glgauthier/MQP/report/figures/oScope/i2c_0x07/externalTrigger/readme.txt

Note that CH1 is the trigger and CH2 is FV
PCLK IS ALWAYS ACTIVE regardless of whether or not the camera is putting out data. this means we can use it for a fifo clock!
