glgauthier/MQP/report/MQP_Paper.tex

\documentclass[12pt]{article}
\usepackage[utf8]{inputenc}
\usepackage[paper=letterpaper,margin=1.25in]{geometry}
\usepackage{graphicx} 
\graphicspath{ {figures/} } % all figures are in the 'figures' folder
\usepackage{float}
\usepackage{subcaption}
\usepackage{indentfirst}
\usepackage{setspace}
\usepackage{amsmath}
\usepackage{url}
\usepackage{array}
\usepackage{listings}

\lstloadaspects{keywordcomments}

\newcolumntype{L}[1]{>{\raggedright\let\newline\\\arraybackslash\hspace{0pt}}m{#1}}
% Fix backwards double quotes
\usepackage [autostyle, english = american]{csquotes}
\MakeOuterQuote{"}
% set up clickable links in ToC
\usepackage[hidelinks]{hyperref} % to turn off hilights
\hypersetup{linktocpage, colorlinks=false, linktoc=all}

% add in dots for sections in ToC
\usepackage[titles]{tocloft}
\renewcommand\cftsecleader{\cftdotfill{\cftdotsep}}

% include subsections, etc.. in table of contents
\setcounter{tocdepth}{4}
\setcounter{secnumdepth}{4}
\usepackage[usenames,dvipsnames,svgnames,table]{xcolor}

%% CODE SNIPPET CONFIGURATION %%
\usepackage{listings}

% verilog code snippet configuration
\lstdefinestyle{Verilog}{
	language=Verilog,
	frame=single,
	breaklines=true,
	basicstyle=\ttfamily\scriptsize, %font and size
	numbers=left,
	numberstyle=\tiny\color{black},
	keywordstyle=\color{Blue}\ttfamily,
    commentstyle=\color{Green}\ttfamily,
    emph = [1]{`timescale},
    emphstyle = [1]{\color{Magenta}},
    emph = [2]{BUFG,ODDR2},
    emphstyle = [2]{\color{Maroon}},
	} 

% vhdl config	
\lstdefinestyle{VHDL}{
	language=VHDL,
	frame=single,
	breaklines=true,
	basicstyle=\ttfamily\scriptsize, %font and size
	numbers=left,
	numberstyle=\tiny\color{black},
	keywordstyle=\color{Blue}\ttfamily,
    	commentstyle=\color{Green}\ttfamily,
	} 
		
% Matlab code snippet configuration
\definecolor{mygreen}{rgb}{0.11,0.67,0} % color values Red, Green, Blue
\definecolor{mylilas}{rgb}{0.67,0.22,0.95}
\lstdefinestyle{Matlab}{
   language=Matlab,
   frame=single,
   breaklines=true,
   keywords={break,case,catch,continue,else,elseif,end,for,function,
      global,if,otherwise,persistent,return,switch,try,while},
   basicstyle=\ttfamily\scriptsize, %font and size
   keywordstyle=\color{blue},
   commentstyle=\color{mygreen},
   stringstyle=\color{mylilas},
   emph = [1]{all},
   emphstyle = [1]{\color{mylilas}},
   numbers=left,
   numberstyle=\tiny\color{black},
   stepnumber=1,
   numbersep=10pt,
   backgroundcolor=\color{white},
   tabsize=4,
   showspaces=false,
   showstringspaces=false
}  
% C code 
\definecolor{Cpurp}{rgb}{0.5,0,0.38}
\definecolor{Cgreen}{rgb}{0.47,0.70,0.53}
\lstdefinestyle{C}{
   language=C,
   frame=single,
   breaklines=true,
   basicstyle=\ttfamily\scriptsize, %font and size
   keywordstyle=\color{Cpurp},
   emph = [1]{u8, u16, u32, XIOModule},
   emphstyle = [1]{\color{Cgreen}},
   commentstyle=\color{Green},
   stringstyle=\color{blue},
   numbers=left,
   numberstyle=\tiny\color{black},
   stepnumber=1,
   numbersep=10pt,
   backgroundcolor=\color{white},
   tabsize=4,
   showspaces=false,
   showstringspaces=false
} 

% COE code
\lstdefinestyle{coe}{
	language=C,
	frame=single,
	breaklines=true,
	basicstyle=\ttfamily\footnotesize, %font and size
	numbers=left,
	numberstyle=\tiny\color{black}\ttfamily,
	comment=[s]{;}{.},
	commentstyle=\color{Green}\ttfamily,
	emph = [1]{memory_initialization_radix, memory_initialization_vector},
	emphstyle = [1]{\color{Maroon}}
	} 

\begin{document}

\pagenumbering{gobble} % turn off page numbering for the first few pages

\input{titlepage.tex} %%%% Title page %%%%
\newpage

\newgeometry{top=1in,bottom=1in,right=1in,left=1in} % change margins, set to double space
\doublespacing

\tableofcontents % create a table of contents
\newpage

\begin{small} % make the font smaller to accommodate for long figure names
\listoffigures % create a list of figures
\end{small}
\newpage 

\pagenumbering{roman} % change page numbering to i,ii, ...

%\input{ack.tex} %%%% Acknowledgements %%%%
%\newpage

\input{abstract.tex} %%%% Abstract %%%%
\newpage
\input{execSummary.tex} %%%% Executive summary %%%%
\newpage
\pagenumbering{arabic} % change page numbering to 1,2, ...

\input{introduction.tex} %%%% Introduction %%%%

\newpage
\input{background.tex} %%%% Background %%%%

\newpage
\section{System Design}
\input{systemDesign.tex}

\newpage
\section{System Implementation}
After deciding that the proof of concept sensor suite required a scanning laser rangefinder, IMU, and stereo camera interface, research was then performed in order to determine what specific sensors to use, as well as the operating modes of each chosen sensor. This chapter describes the specific research performed for each sensor, as well as the theoretical implementation of the overall system.

\input{rangefinder_operation.tex}
\input{rangefinder_implementation.tex}
\input{rangefinder_data_processing.tex}

\input{pspl_communication.tex}

\input{imu_operation.tex}
\input{imu_implementation.tex}
\input{imu_data_processing.tex}

\input{camera_operation.tex}
\input{disparity_implementation.tex}
\input{combined_imp.tex}

\par
In this chapter, the behavior of each sensor was explored in depth, and an overall system designed was created. Once this design was completed, each sensor's behavior was thoroughly tested before integration.

\newpage 
\section{Testing and Results}
After learning how to interface with the chosen sensors, initial test implementations were then created for each individual sensor. Many of these implementations were designed for ease of integration into the finalized design, as detailed in the following sections.

\input{rangefinder_testing.tex}
\input{imu_testing.tex}
\input{camera_implementation.tex}
\input{disparity_testing.tex}
%rangefinder and IMU stuff 
% then combined imp after?
\input{final_results.tex}

\par
In this chapter, the functionality of each sensor was tested so that the design accurately reflected their behavior. Once each sensor's behavior was properly accounted for, their implementations were combined to create a functional SLAM sensor suite incorporating multiple operating modes.

\newpage 
\section{Conclusions}
\input{conclusion.tex}

\newpage
\singlespacing
\input{bib_ordered.tex} %%%% Bibliography %%%%
\doublespacing
\newpage

\section*{Appendix} %%%% Appendix %%%% 
\addcontentsline{toc}{section}{Appendix}
\setcounter{subsection}{0}
\renewcommand\thesubsection{\Alph{subsection}}
\renewcommand\thesubsubsection{\thesubsection.\roman{subsubsection}}
%\input{appendix/resources.tex} % useful resources
\input{appendix/componentSelection.tex} % component selection
%\input{appendix/camDecisionMatrix.tex} % camera module decision matrix
\input{appendix/camControlReg.tex}
\newpage
\input{appendix/stereoCameraSchematic.tex}
\newpage
% maybe redo this so we have a section called "code" and
% subsections for individual projects?
\input{appendix/code.tex}
%\input{appendix/matlabCode.tex}
%\newpage
%\input{appendix/verilogCode.tex}
%\newpage
%\input{appendix/cCode.tex}
%\newpage
%\input{appendix/coeCode.tex}

%\newpage
%\input{appendix/examples.tex} % example latex code for setting things up

\end{document}
