glgauthier/MQP/report/titlepage.tex

\begin{titlepage}
	\centering
	%{\huge\bfseries Real-Time Remote Mapping\par}
	{\huge\bfseries FPGA-Based Real-Time SLAM\par}
	\vfill
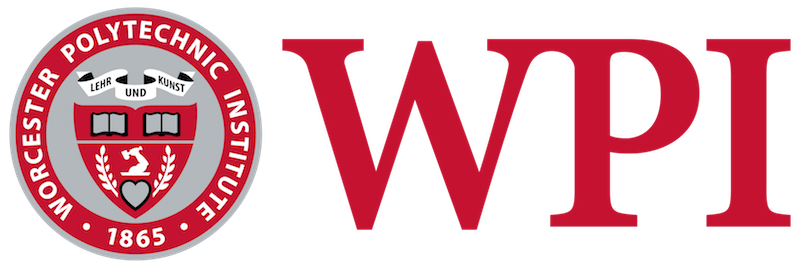
[picture p20: report/figures/WPI_Inst_Prim_FulClr.png]
	 % also works with logo.pdf
	\vfill
	{\par\large A Major Qualifying Project Report Submitted to the Faculty of \par}
	\vspace{0.25cm}
	{\large Worcester Polytechnic Institute\par}
	\vfill
	{\large In partial fulfillment of the requirements for the \par}
	\vspace{0.25cm}
	{\large Degree of Bachelor of Science in Electrical \& Computer Engineering\par}
	\vfill
	{\large By: \par}
	\vspace{0.25cm}
	{\Large Georges Gauthier \\ John DeCusati \par} 
	\vfill
	{\large \today \par}
	\vfill
	{\begin{flushright} 
	\large Advisor: \\ \Large Professor R. James Duckworth
	\end{flushright}}
\end{titlepage}
