glgauthier/MQP/report/appendix/matlabCode.tex

\subsection{\textsc{Matlab} Code}
\subsubsection{Camera Image Parsing} \label{camTestMatlab}
\singlespacing
\lstinputlisting[style=Matlab]{appendix/matlab/ParseData.m}
\doublespacing
\subsubsection{Disparity Algorithm Implementation} \label{disparityTestMatlab}
\singlespacing
\lstinputlisting[style=Matlab]{appendix/matlab/stereoDisparity.m}
\doublespacing
