glgauthier/MQP/report/appendix/stereoCameraSchematic.tex

\subsection{Stereo Camera Schematic}\label{stereoCameraSchematic}
\begin{figure}[H]
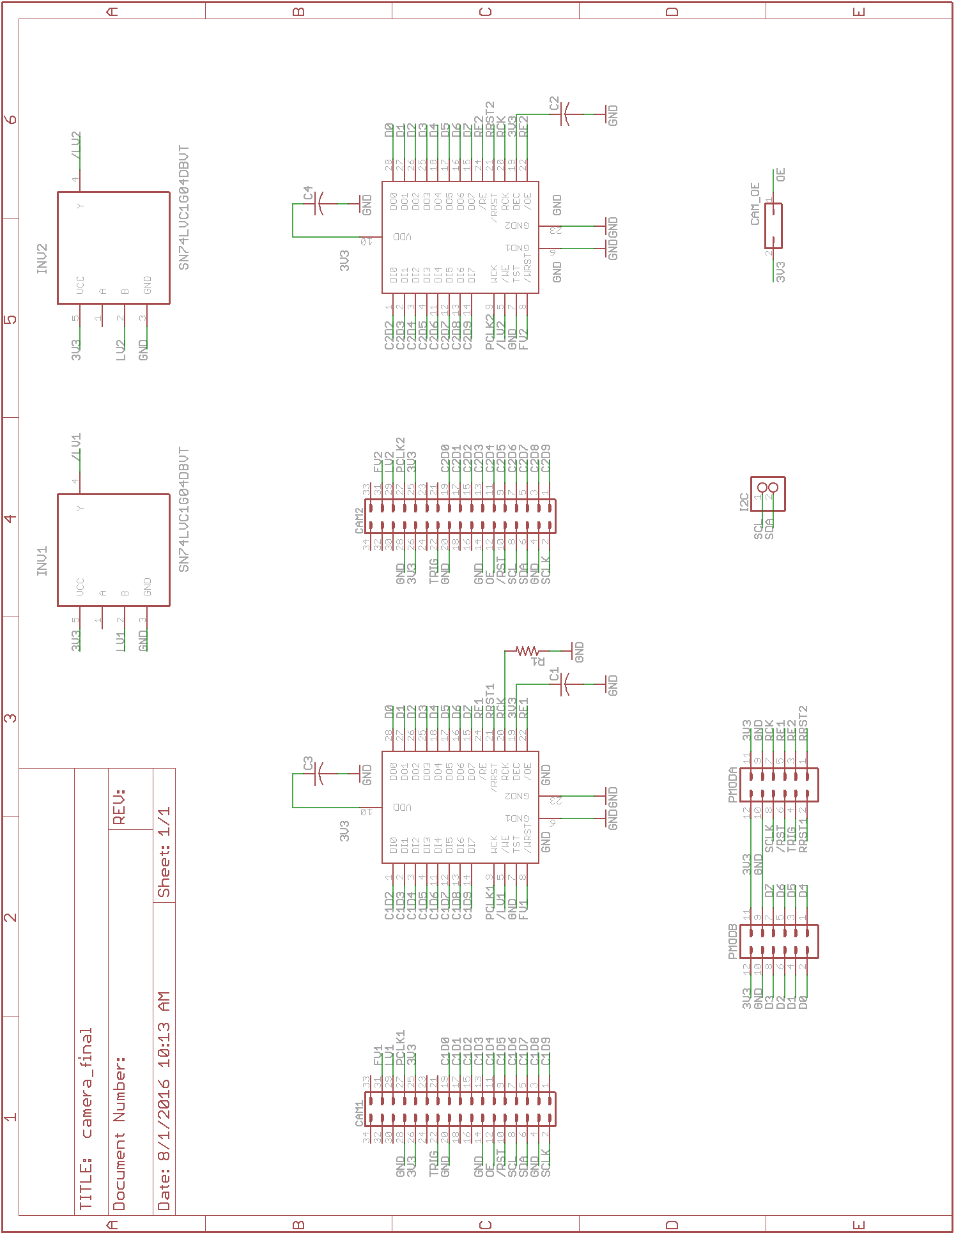
[picture p35: report/figures/stereo_schematic.png]
	\centerline{}
\end{figure}
