glgauthier/MQP/report/appendix/camControlReg.tex

\subsection{Camera Module Control Register} \label{camctlreg}
\begin{figure}[H]
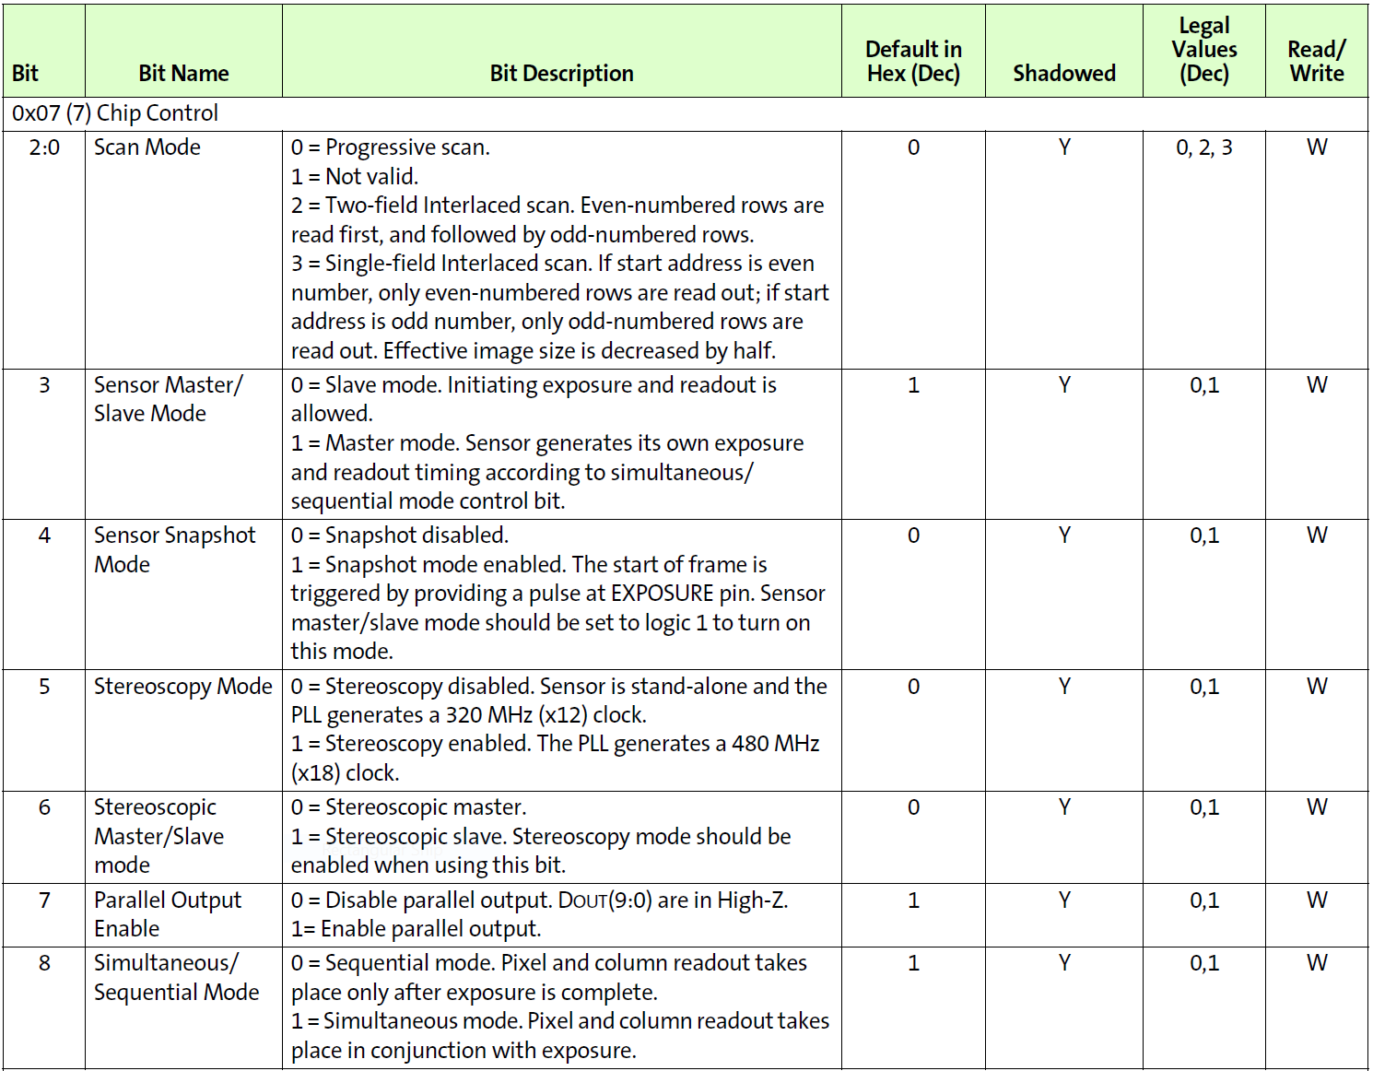
[picture p36: report/figures/CamControlReg.PNG]
	\centerline{}
	Table obtained from MT9V032 Datasheet \cite{mt9v032}
\end{figure}
