glgauthier/MQP/report/appendix/cCode.tex

\subsection{C Code}
\subsubsection{Camera Image Parsing} \label{camTestC}
\singlespacing
\lstinputlisting[style=C]{appendix/c/imageUART.c}
\doublespacing
