glgauthier/MQP/report/appendix/camDecisionMatrix.tex

\subsection{Camera Module Decision Matrix}
\singlespacing
\begin{small}
\centerline{
\begin{tabular}{ |L{2cm}|L{1.5cm}|L{2.5cm}|L{1cm}|L{1.7cm}|L{2cm}|L{1.7cm}|L{1.2cm}|L{1cm}| } 
 \hline
 \textbf{Camera Module} & \textbf{Max Frame Rate (FPS)}  & \textbf{Resolution at Max Frame Rate (px.)} & \textbf{Cost} & \textbf{Requires External Adapter} & \textbf{Data Transfer Interface} & \textbf{Shutter} & \textbf{Field of View (deg.)} & \textbf{Rank 0-10}  \\ \hline
 OV7670 & \cellcolor{red!25} 30 & \cellcolor{green!25} 640x480 & \cellcolor{green!50} \$10 & \cellcolor{green!25} No & \cellcolor{green!25} Parallel & \cellcolor{red!25} Rolling & \cellcolor{red!25}  25 & 5  \\ \hline
 Raspberry Pi Camera &\cellcolor{green!25}  90 & \cellcolor{green!25} 640x480 & \cellcolor{green!25}  \$30 & \cellcolor{red!25} Yes, \$53 & \cellcolor{red!25} MIPI (CSI2) & \cellcolor{red!25}  Rolling & \cellcolor{green!25} 49 & 6  \\  \hline
 PC1089K & \cellcolor{green!25} 60 & \cellcolor{green!25} 720x480 & \cellcolor{green!25} \$32 & \cellcolor{green!25} No & \cellcolor{red!50} NSTC/ PAL & \cellcolor{red!25} Rolling & Not Given & 5 \\ \hline 
 OV4682 & \cellcolor{green!50} 330 & \cellcolor{green!25} 640x480 & \cellcolor{red!25} \$89 & \cellcolor{red!25} Yes, \$50 & \cellcolor{red!25} MIPI & \cellcolor{red!25} Rolling & Not Given & 6 \\ \hline
 \textbf{MT9V034} & \cellcolor{green!25} \textbf{60} & \cellcolor{green!25} \textbf{750x480} & \cellcolor{red!25} \textbf{\$73} & \cellcolor{green!25} \textbf{No} & \cellcolor{green!25} \textbf{Parallel} & \cellcolor{green!50} \textbf{Global} & \cellcolor{green!25} \textbf{55} & \textbf{9} \\ \hline   
\end{tabular} }
\par
For purposes of comparison, the thermal camera module we were evaluating is also shown below.
\centerline{
\begin{tabular}{ |L{2cm}|L{1.5cm}|L{2.5cm}|L{1cm}|L{1.7cm}|L{2cm}|L{1.7cm}|L{1.2cm}|L{1cm}| } 
\hline
Flir Lepton &  \cellcolor{red!50} 9 & \cellcolor{red!50} 80x60 & \cellcolor{red!25} \$175 & \cellcolor{red!25} Yes, \$40 & \cellcolor{green!25} SPI/ MIPI & N/A & \cellcolor{green!25} 50 & 3 \\ \hline 
\end{tabular} 
}
\end{small}
\par
Shown above is our decision matrix for choosing a camera module. Fields marked in green indicate a positive ranking, while red indicates a negative ranking. Based on the individual rankings of each item's field, we gave our camera modules an overall ranking of 0-10 in the right hand column, with 10 being an extremely high ranking and 0 being an extremely low ranking.
\doublespacing
\par
Based on our decision matrix, we believe that it would be worth both our time and money to use the MT9V034 camera modules for our stereo camera interface. These camera modules are the only low-cost global shutter option we've come across, and would be ideal for taking images in a sensor suite that is susceptible to motion. The MT9V034 also uses a parallel data interface and relies on an external clock and shutter trigger, making the module ideal for interfacing with an FPGA-based stereo imaging setup.
