glgauthier/MQP/final_implemention/final_implemention.runs/design_1_synth_1/.vivado.begin.rst

<?xml version="1.0"?>
<ProcessHandle Version="1" Minor="0">
    <Process Command="vivado.bat" Owner="georges" Host="GEORGES-T460P" Pid="3864">
    </Process>
</ProcessHandle>
