glgauthier/MQP/final_implemention/final_implemention.runs/impl_1/.init_design.begin.rst

<?xml version="1.0"?>
<ProcessHandle Version="1" Minor="0">
    <Process Command=".planAhead." Owner="georges" Host="GEORGES-T460P" Pid="1500">
    </Process>
</ProcessHandle>
