glgauthier/MQP/IMU_PS/IMU_PS.runs/impl_1/.init_design.begin.rst

<?xml version="1.0"?>
<ProcessHandle Version="1" Minor="0">
    <Process Command=".planAhead." Owner="John" Host="JOHN-HP" Pid="3108">
    </Process>
</ProcessHandle>
