glgauthier/MQP/rangefinder_blocks/rangefinder_blocks.runs/design_1_synth_1/.vivado.begin.rst

<?xml version="1.0"?>
<ProcessHandle Version="1" Minor="0">
    <Process Command="vivado.bat" Owner="John" Host="JOHN-HP" Pid="4356">
    </Process>
</ProcessHandle>
