glgauthier/MQP/IMU_PS/IMU_PS.ip_user_files/sim_scripts/IMU_bd/activehdl/file_info.txt

IMU_bd.v,verilog,xil_defaultlib,../../../bd/IMU_bd/hdl/IMU_bd.v,incdir="../../../bd/IMU_bd/ipshared/xilinx.com/inout_v1_0/src"incdir="../../../ipstatic/processing_system7_bfm_v2_0/hdl"incdir="../../../../IMU_PS.srcs/sources_1/bd/IMU_bd/ipshared/xilinx.com/inout_v1_0/src"incdir="../../../ipstatic/processing_system7_bfm_v2_0/hdl"
processing_system7_bfm_v2_0_arb_wr.v,verilog,processing_system7_bfm_v2_0_5,../../../ipstatic/processing_system7_bfm_v2_0/hdl/processing_system7_bfm_v2_0_arb_wr.v,incdir="../../../bd/IMU_bd/ipshared/xilinx.com/inout_v1_0/src"incdir="../../../ipstatic/processing_system7_bfm_v2_0/hdl"incdir="../../../../IMU_PS.srcs/sources_1/bd/IMU_bd/ipshared/xilinx.com/inout_v1_0/src"incdir="../../../ipstatic/processing_system7_bfm_v2_0/hdl"
processing_system7_bfm_v2_0_arb_rd.v,verilog,processing_system7_bfm_v2_0_5,../../../ipstatic/processing_system7_bfm_v2_0/hdl/processing_system7_bfm_v2_0_arb_rd.v,incdir="../../../bd/IMU_bd/ipshared/xilinx.com/inout_v1_0/src"incdir="../../../ipstatic/processing_system7_bfm_v2_0/hdl"incdir="../../../../IMU_PS.srcs/sources_1/bd/IMU_bd/ipshared/xilinx.com/inout_v1_0/src"incdir="../../../ipstatic/processing_system7_bfm_v2_0/hdl"
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
glbl.v,Verilog,xil_defaultlib,glbl.v
