glgauthier/MQP/IMU_PS/IMU_PS.ip_user_files/sim_scripts/IMU_bd/ies/file_info.txt

IMU_bd.v,verilog,xil_defaultlib,../../../bd/IMU_bd/hdl/IMU_bd.v,incdir="$ref_dir/../../../bd/IMU_bd/ipshared/xilinx.com/inout_v1_0/src"incdir="$ref_dir/../../../ipstatic/processing_system7_bfm_v2_0/hdl"incdir="../../../../IMU_PS.srcs/sources_1/bd/IMU_bd/ipshared/xilinx.com/inout_v1_0/src"incdir="../../../ipstatic/processing_system7_bfm_v2_0/hdl"
processing_system7_bfm_v2_0_arb_wr.v,verilog,processing_system7_bfm_v2_0_5,../../../ipstatic/processing_system7_bfm_v2_0/hdl/processing_system7_bfm_v2_0_arb_wr.v,incdir="$ref_dir/../../../bd/IMU_bd/ipshared/xilinx.com/inout_v1_0/src"incdir="$ref_dir/../../../ipstatic/processing_system7_bfm_v2_0/hdl"incdir="../../../../IMU_PS.srcs/sources_1/bd/IMU_bd/ipshared/xilinx.com/inout_v1_0/src"incdir="../../../ipstatic/processing_system7_bfm_v2_0/hdl"
processing_system7_bfm_v2_0_arb_rd.v,verilog,processing_system7_bfm_v2_0_5,../../../ipstatic/processing_system7_bfm_v2_0/hdl/processing_system7_bfm_v2_0_arb_rd.v,incdir="$ref_dir/../../../bd/IMU_bd/ipshared/xilinx.com/inout_v1_0/src"incdir="$ref_dir/../../../ipstatic/processing_system7_bfm_v2_0/hdl"incdir="../../../../IMU_PS.srcs/sources_1/bd/IMU_bd/ipshared/xilinx.com/inout_v1_0/src"incdir="../../../ipstatic/processing_system7_bfm_v2_0/hdl"
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
IMU_bd_processing_system7_0_0.v,verilog,xil_defaultlib,../../../bd/IMU_bd/ip/IMU_bd_processing_system7_0_0/sim/IMU_bd_processing_system7_0_0.v,incdir="$ref_dir/../../../bd/IMU_bd/ipshared/xilinx.com/inout_v1_0/src"incdir="$ref_dir/../../../ipstatic/processing_system7_bfm_v2_0/hdl"incdir="../../../../IMU_PS.srcs/sources_1/bd/IMU_bd/ipshared/xilinx.com/inout_v1_0/src"incdir="../../../ipstatic/processing_system7_bfm_v2_0/hdl"
IMU_bd_InOut_0_0.v,verilog,xil_defaultlib,../../../bd/IMU_bd/ip/IMU_bd_InOut_0_0/sim/IMU_bd_InOut_0_0.v,incdir="$ref_dir/../../../bd/IMU_bd/ipshared/xilinx.com/inout_v1_0/src"incdir="$ref_dir/../../../ipstatic/processing_system7_bfm_v2_0/hdl"incdir="../../../../IMU_PS.srcs/sources_1/bd/IMU_bd/ipshared/xilinx.com/inout_v1_0/src"incdir="../../../ipstatic/processing_system7_bfm_v2_0/hdl"
glbl.v,Verilog,xil_defaultlib,glbl.v
