glgauthier/MQP/MATLAB/shift/shift.png

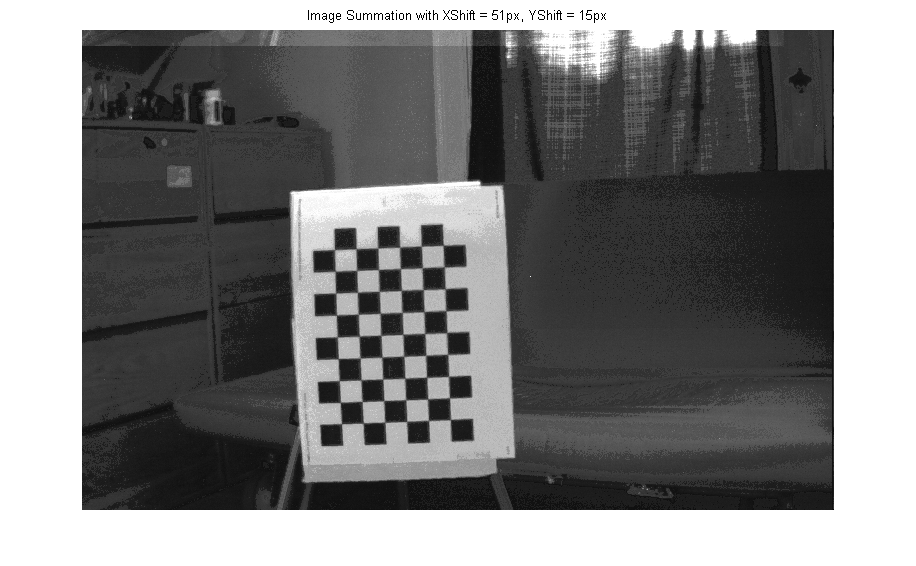
MATLAB/shift/shift.png
