glgauthier/MQP/report/figures/block_diagram.png

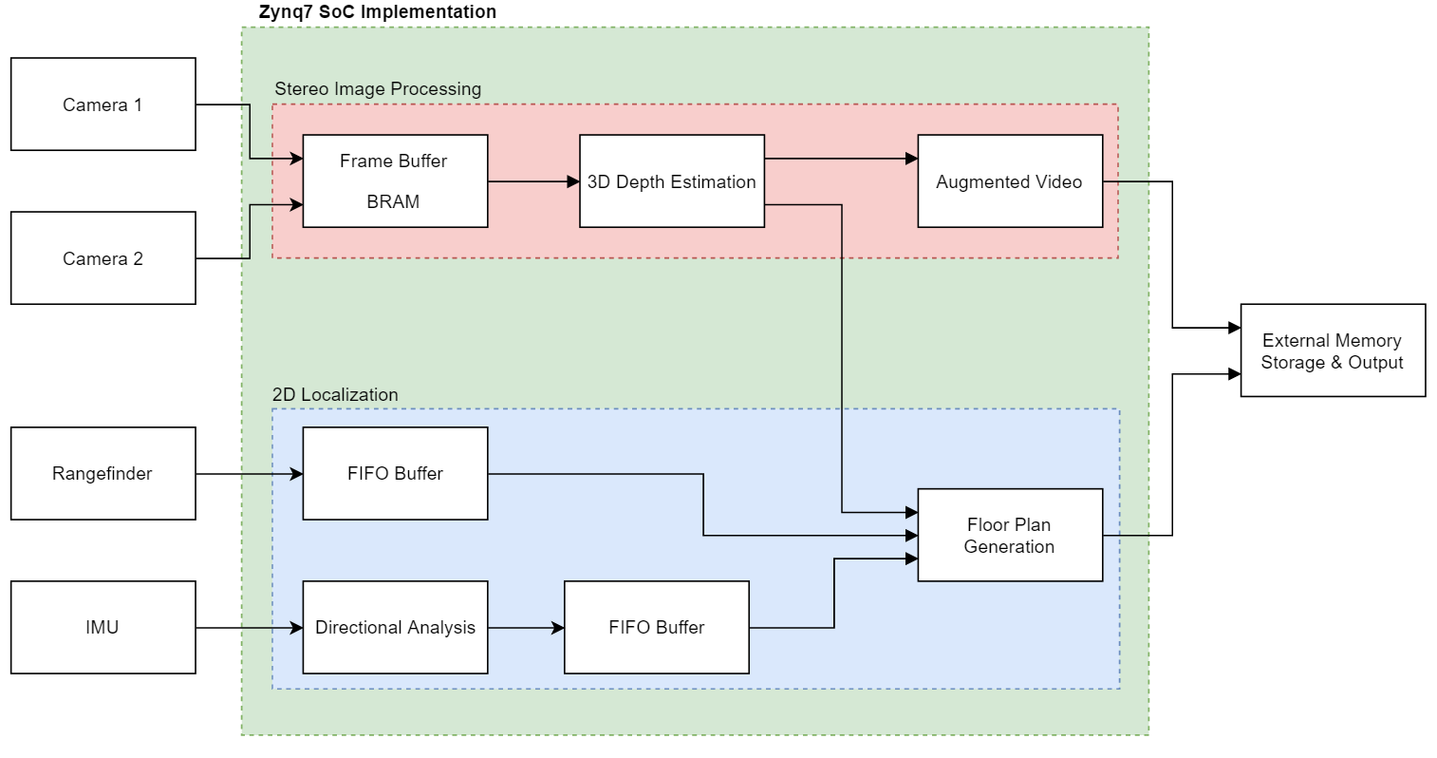
report/figures/block_diagram.png
