glgauthier/MQP/report/figures/brokenFifo/fifo1_din1.png

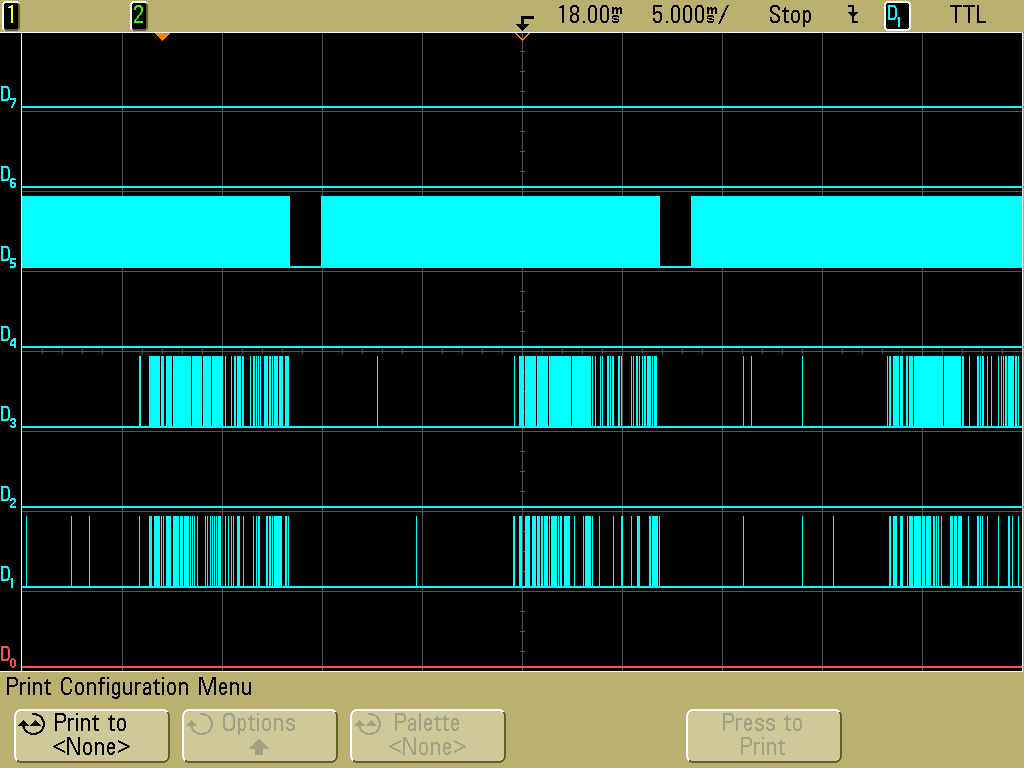
report/figures/brokenFifo/fifo1_din1.png
