glgauthier/MQP/report/figures/brokenFifo/fifo1_din.png

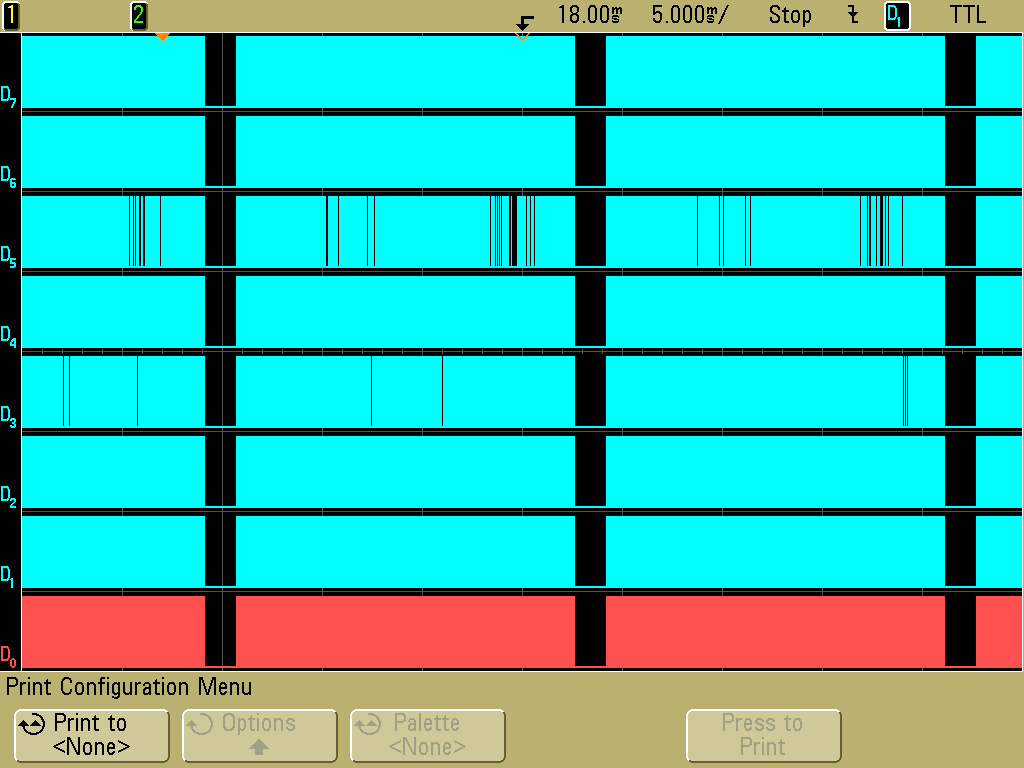
report/figures/brokenFifo/fifo1_din.png
