glgauthier/MQP/report/figures/brokenFifo/FIFO1_Dout.png

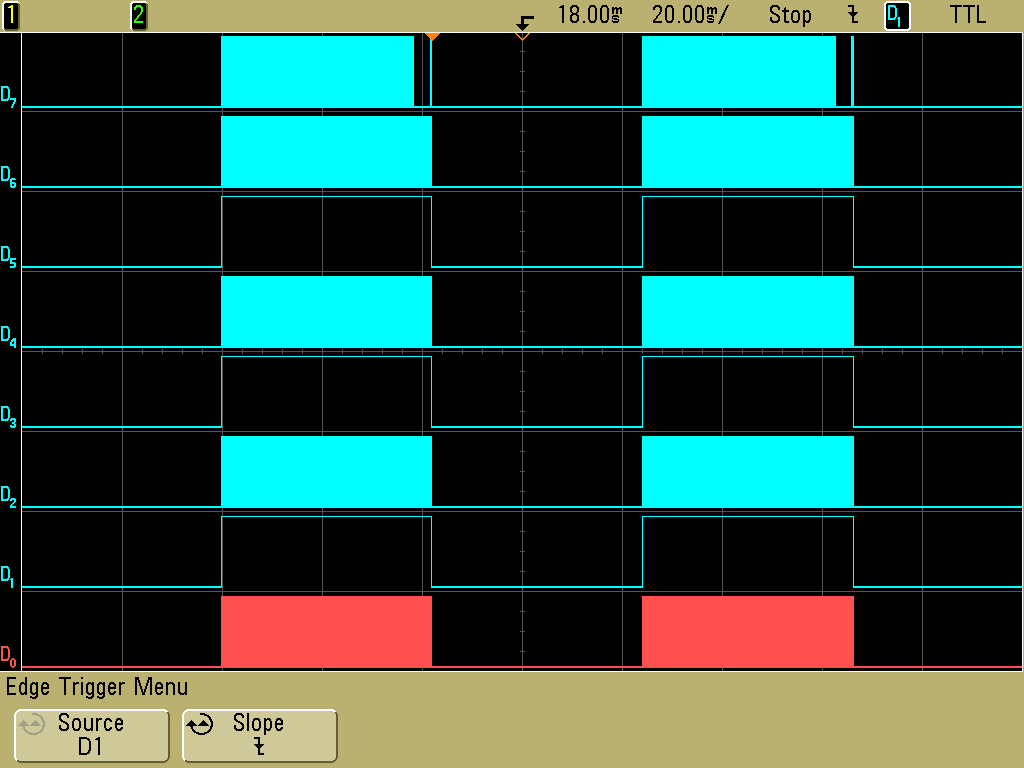
report/figures/brokenFifo/FIFO1_Dout.png
