glgauthier/MQP/report/figures/brokenFifo/FIFO2_Dout.png

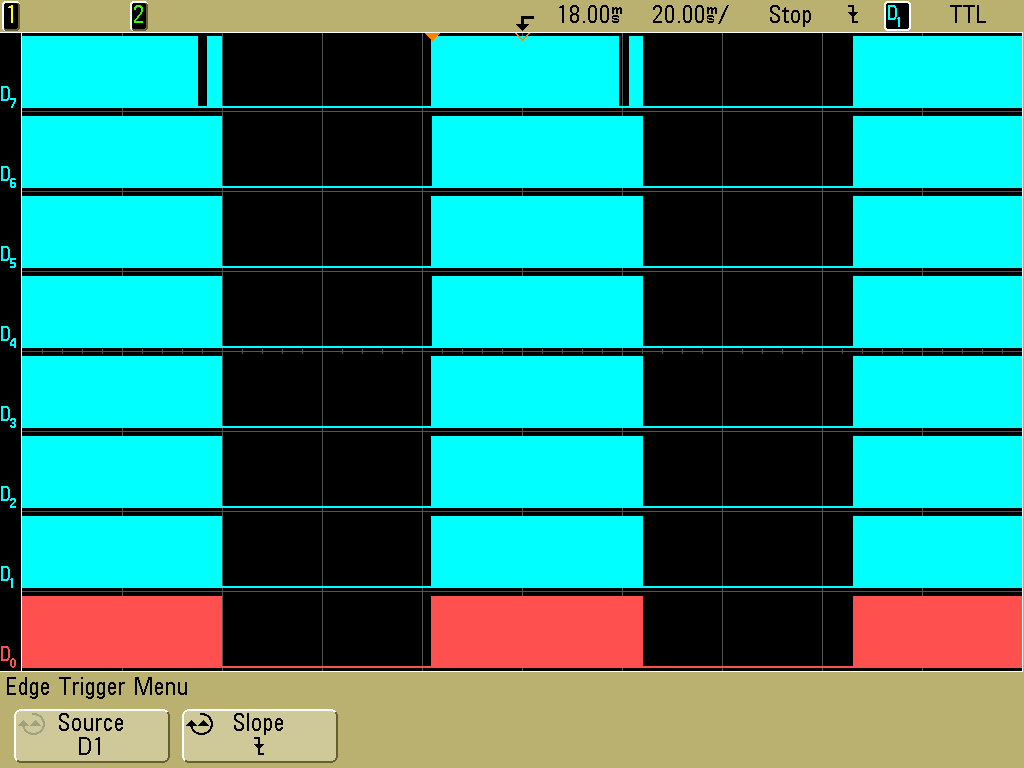
report/figures/brokenFifo/FIFO2_Dout.png
