glgauthier/MQP/report/figures/camera_data1.JPG

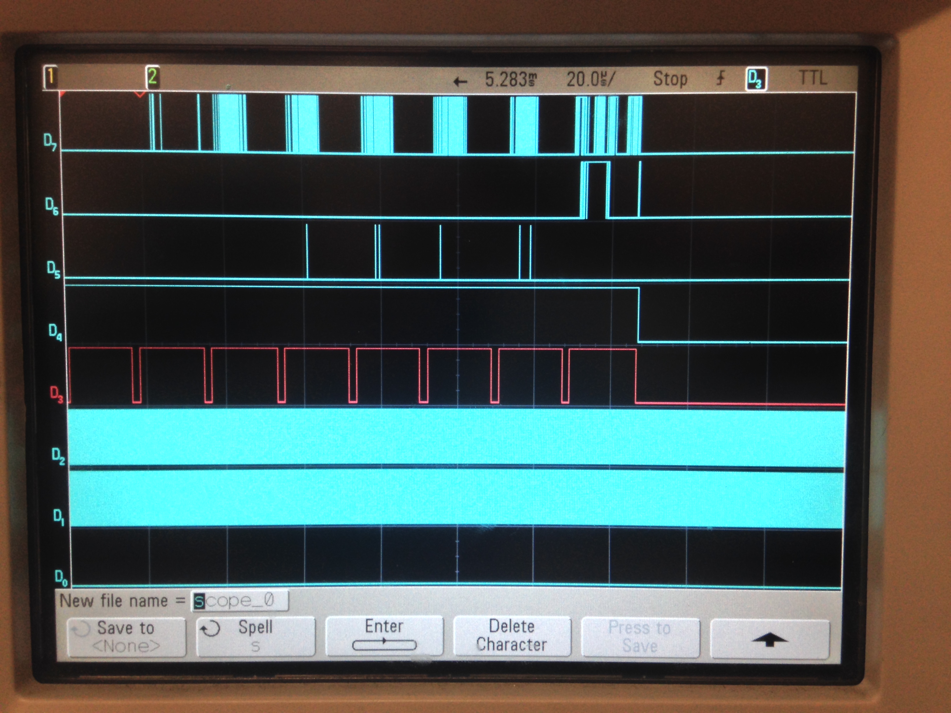
report/figures/camera_data1.JPG
