glgauthier/MQP/report/figures/camera_data.JPG

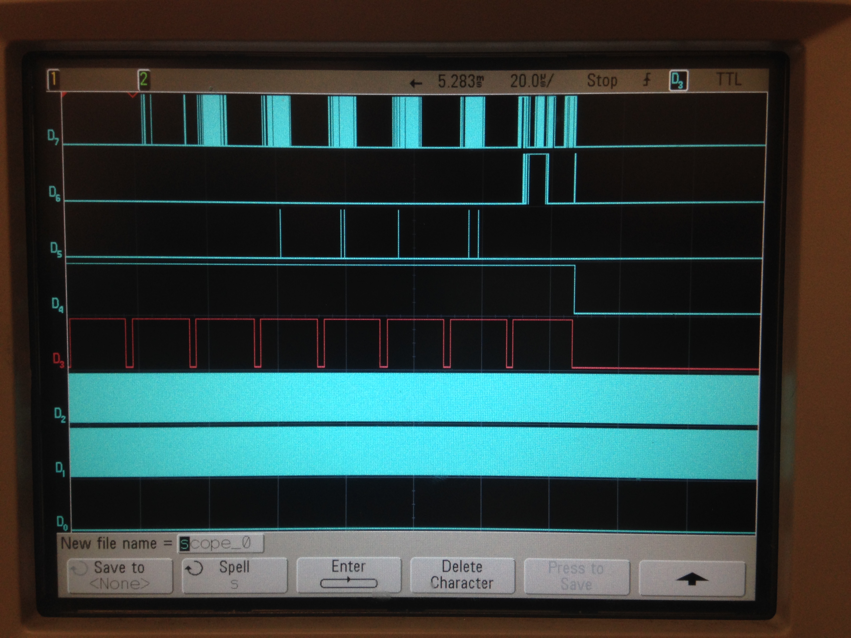
report/figures/camera_data.JPG
