glgauthier/MQP/report/figures/combined_mode.JPG

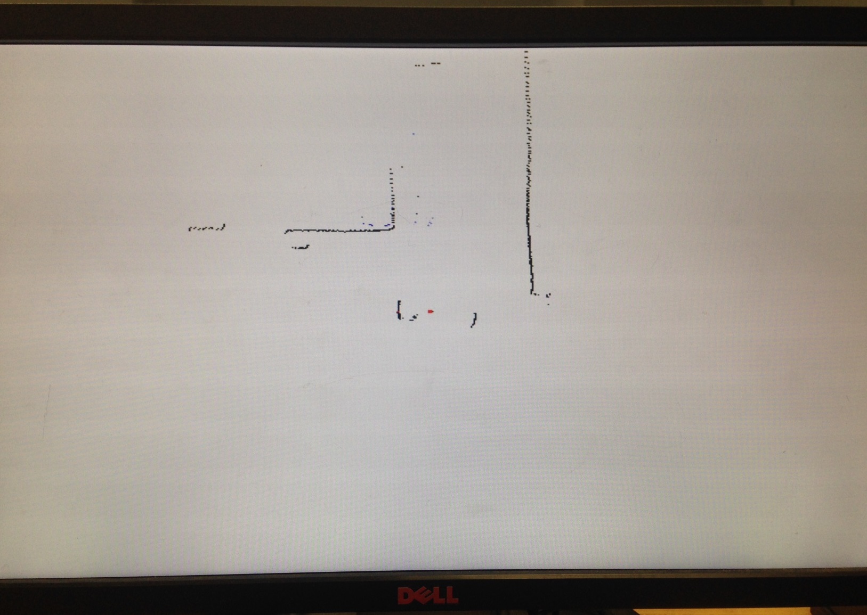
report/figures/combined_mode.JPG
