glgauthier/MQP/report/figures/disp_loading.png

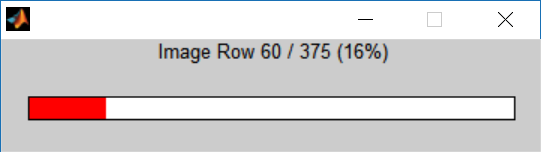
report/figures/disp_loading.png
