glgauthier/MQP/report/figures/disp_tb/croppedCones.png

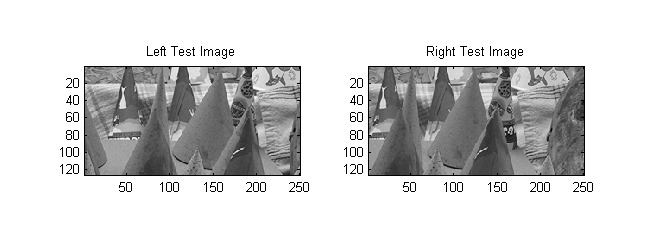
report/figures/disp_tb/croppedCones.png
