glgauthier/MQP/report/figures/disp_tb/CroppedOut.png

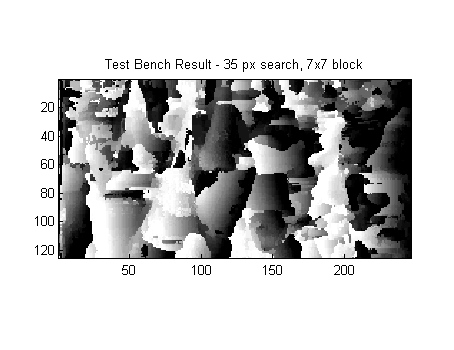
report/figures/disp_tb/CroppedOut.png
