glgauthier/MQP/report/figures/disp_tb/indexing.png

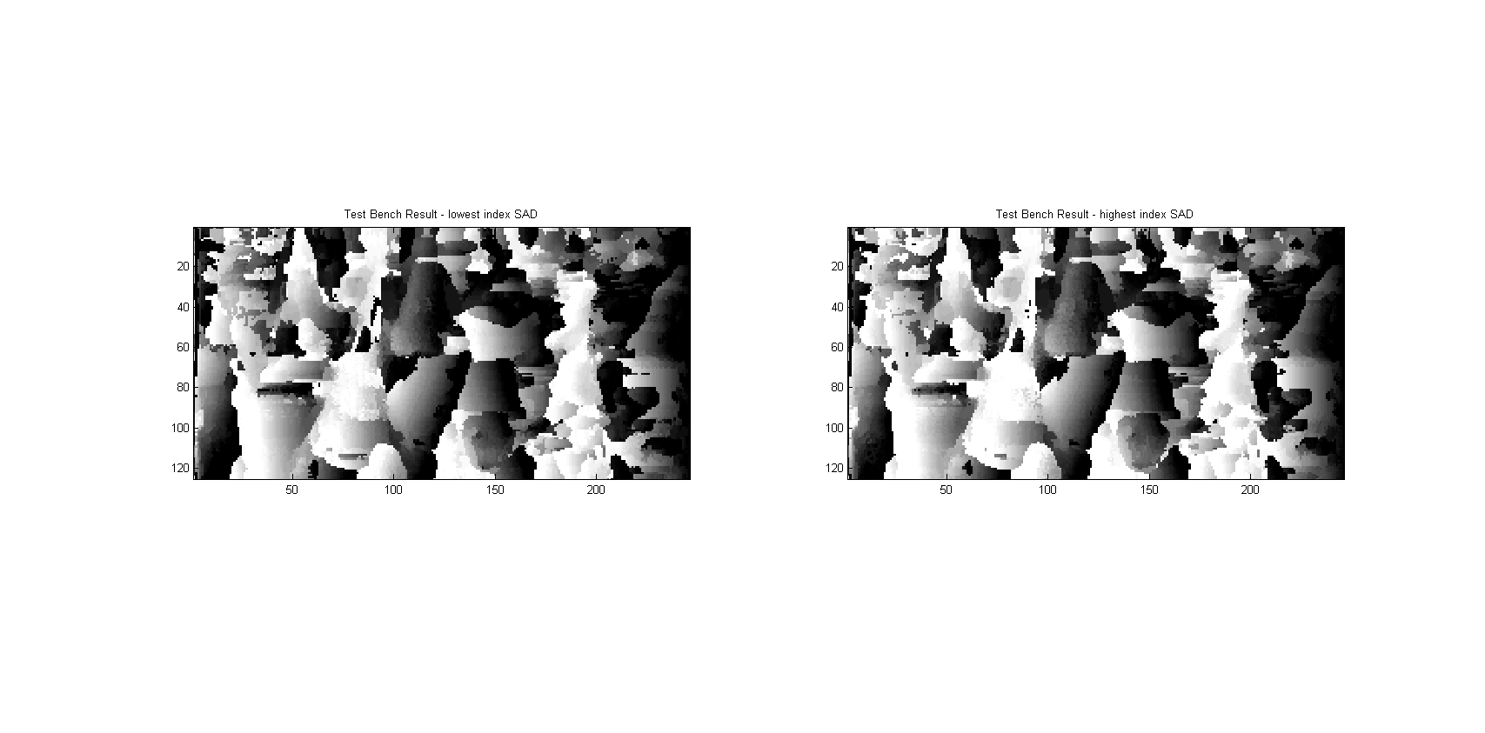
report/figures/disp_tb/indexing.png
