glgauthier/MQP/report/figures/disp_tb/MATLAB_cones2.png

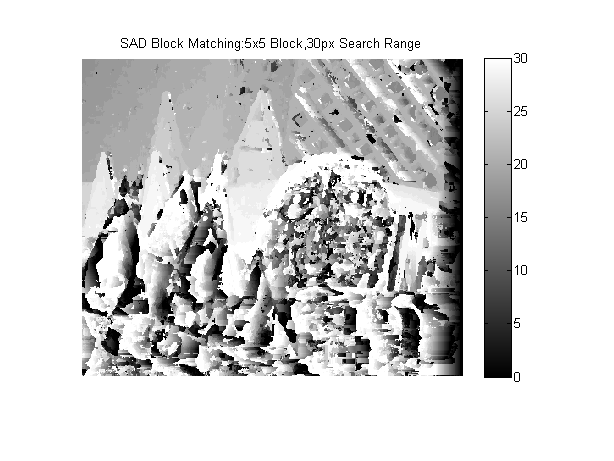
report/figures/disp_tb/MATLAB_cones2.png
