glgauthier/MQP/report/figures/disp_tb/MATLAB_cones3.png

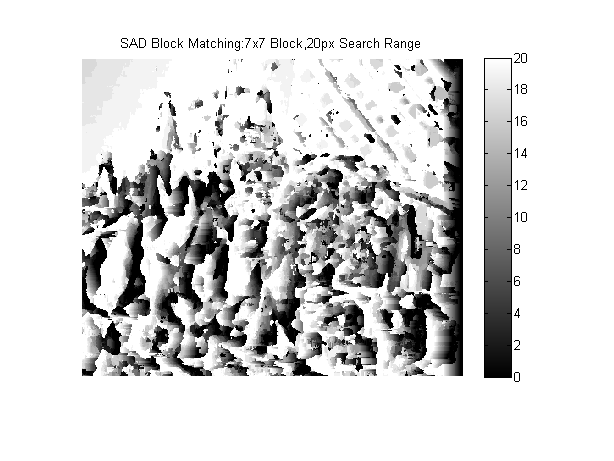
report/figures/disp_tb/MATLAB_cones3.png
