glgauthier/MQP/report/figures/disp_tb/MATLAB_cones.png

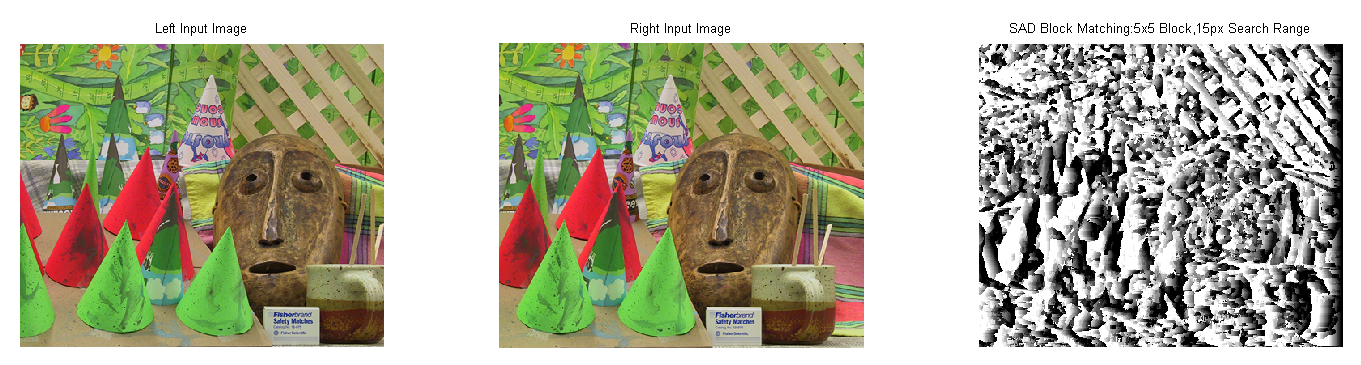
report/figures/disp_tb/MATLAB_cones.png
