glgauthier/MQP/report/figures/disp_tb/read_oneImage.PNG

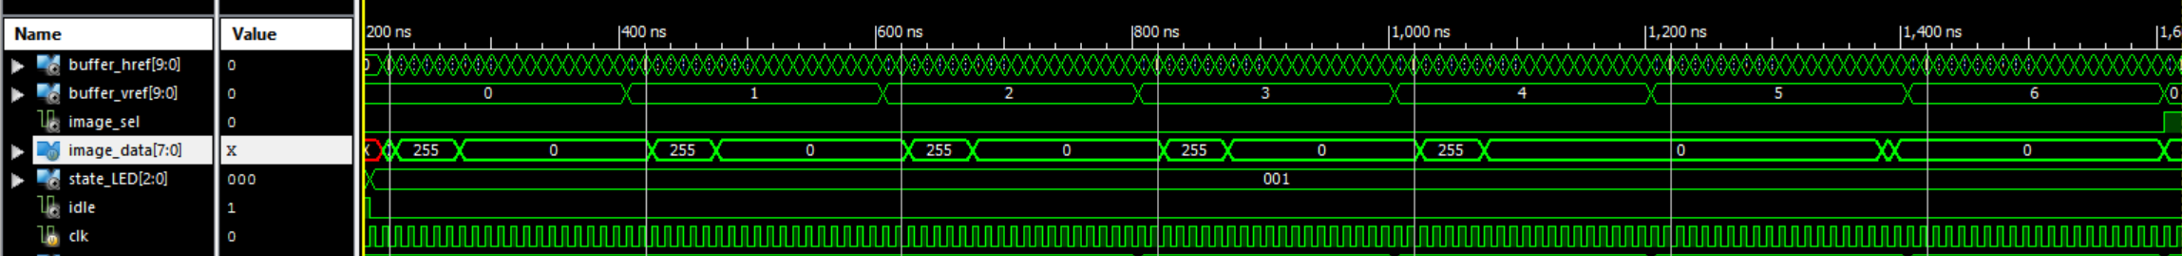
report/figures/disp_tb/read_oneImage.PNG
