glgauthier/MQP/report/figures/disp_tb/TB_cones2.png

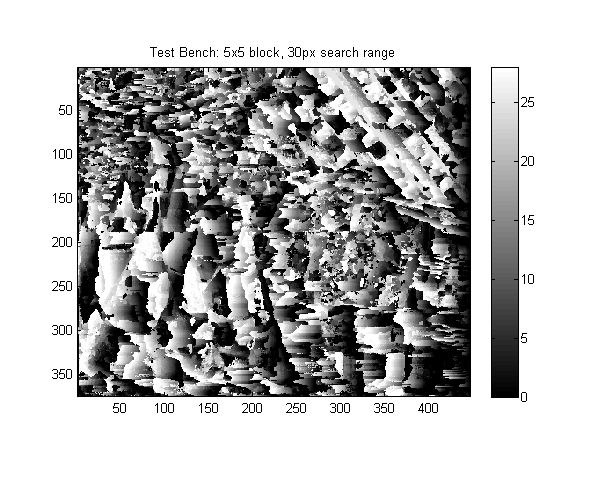
report/figures/disp_tb/TB_cones2.png
