glgauthier/MQP/report/figures/disparity_mode.JPG

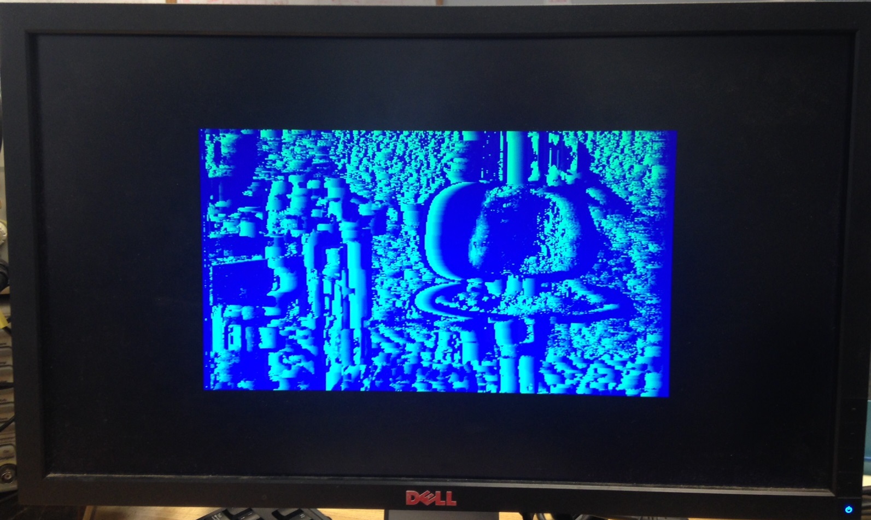
report/figures/disparity_mode.JPG
