glgauthier/MQP/report/figures/final_bd.png

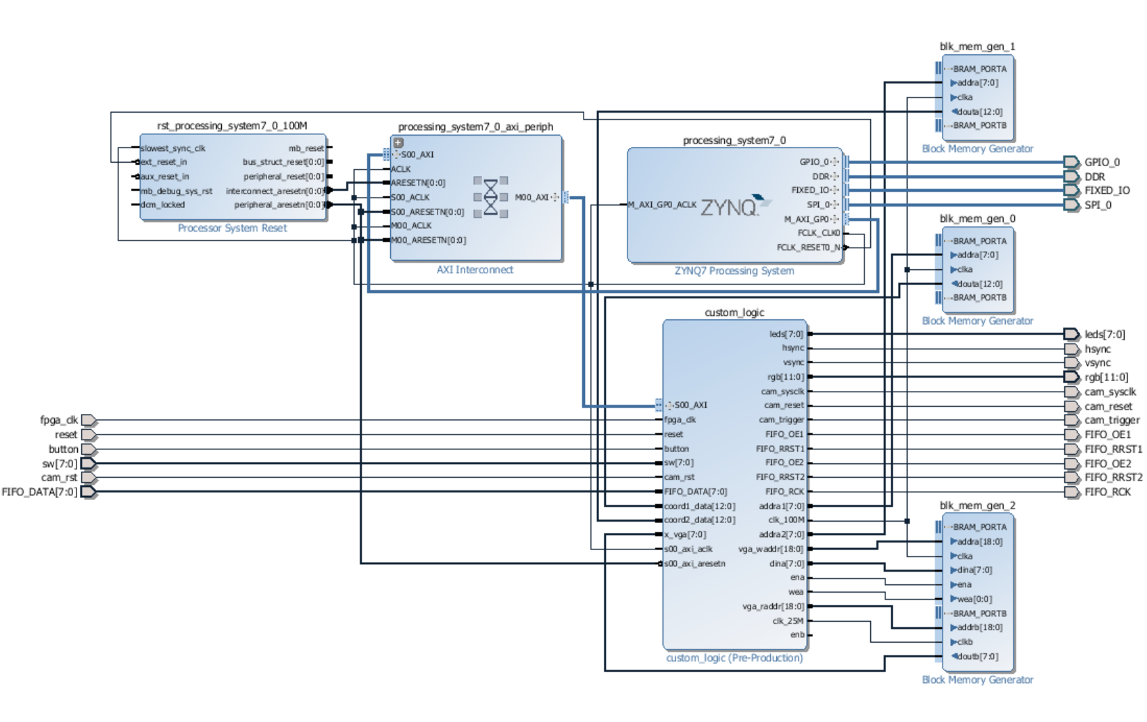
report/figures/final_bd.png
