glgauthier/MQP/report/figures/human_tracking.png

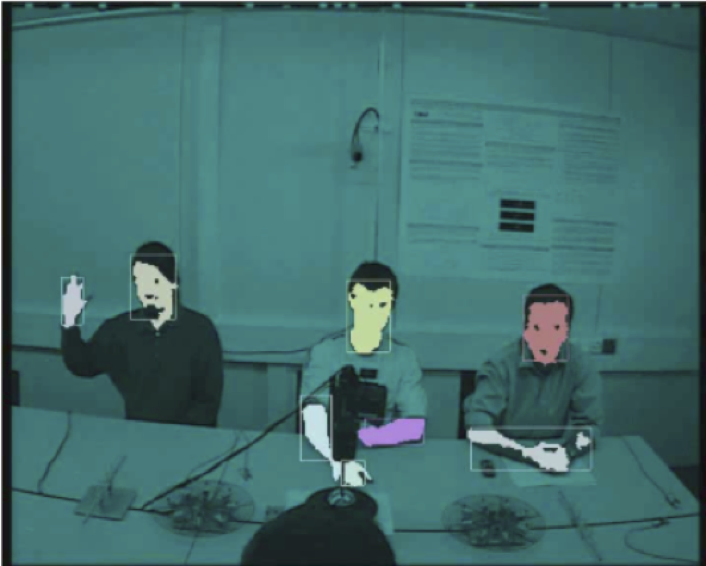
report/figures/human_tracking.png
