glgauthier/MQP/report/figures/IMU_read.png

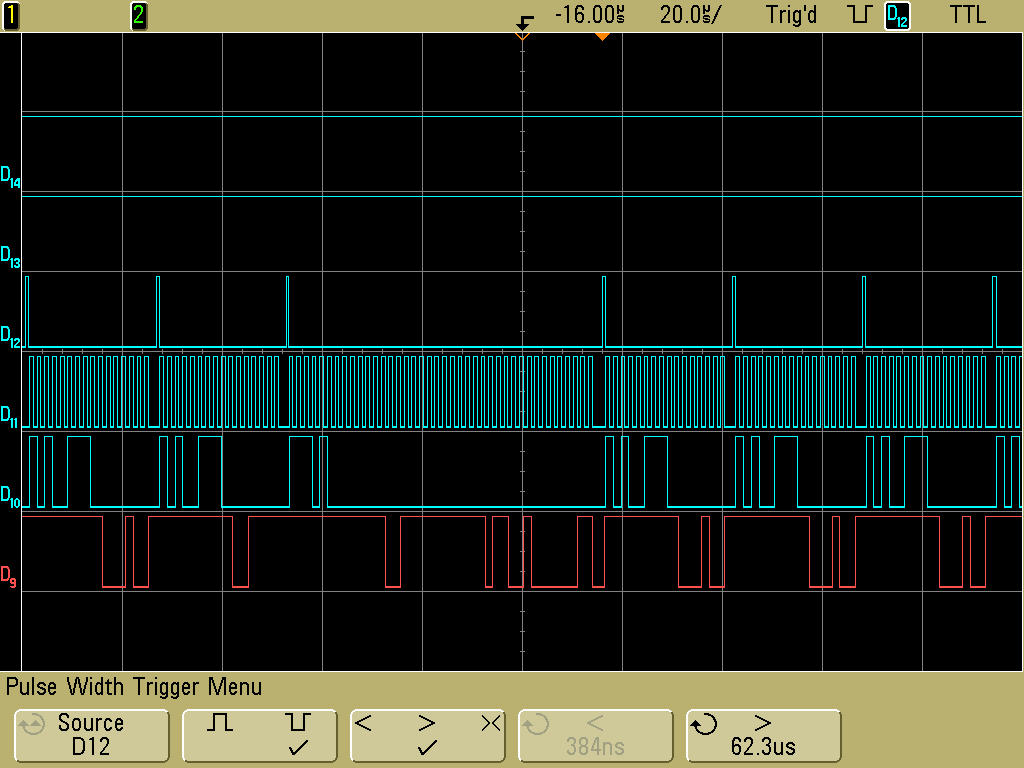
report/figures/IMU_read.png
