glgauthier/MQP/report/figures/lab_front.JPG

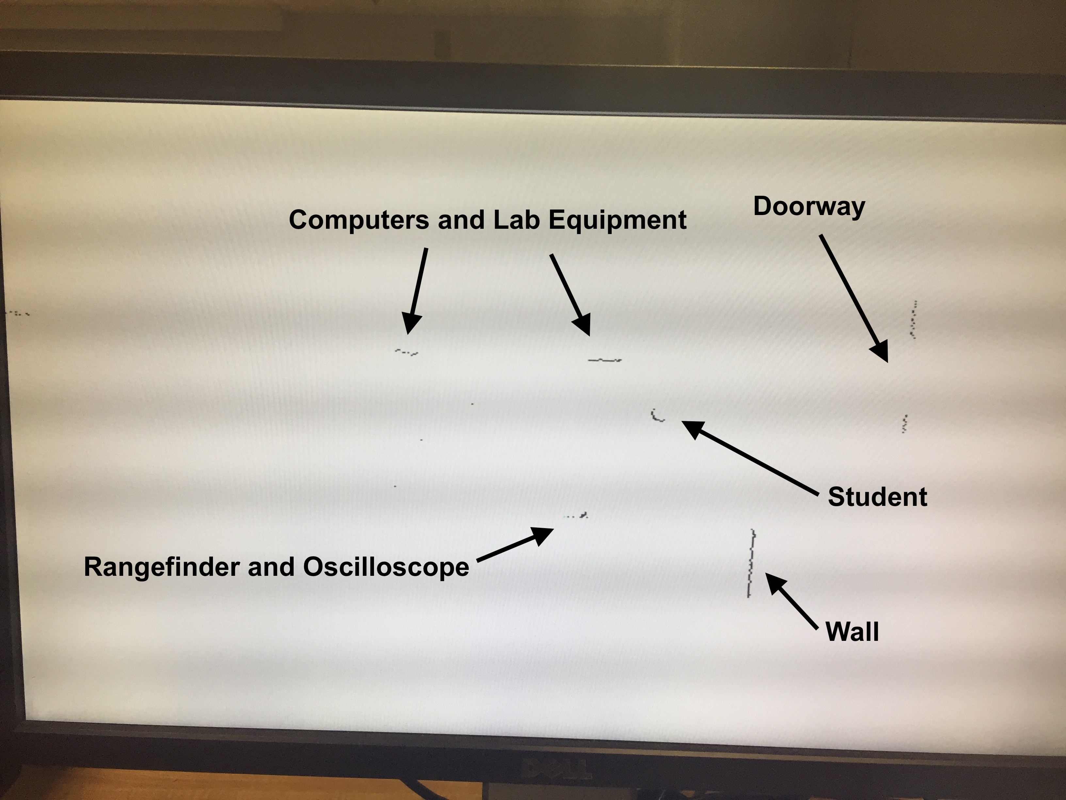
report/figures/lab_front.JPG
