glgauthier/MQP/report/figures/labtest1_2.png

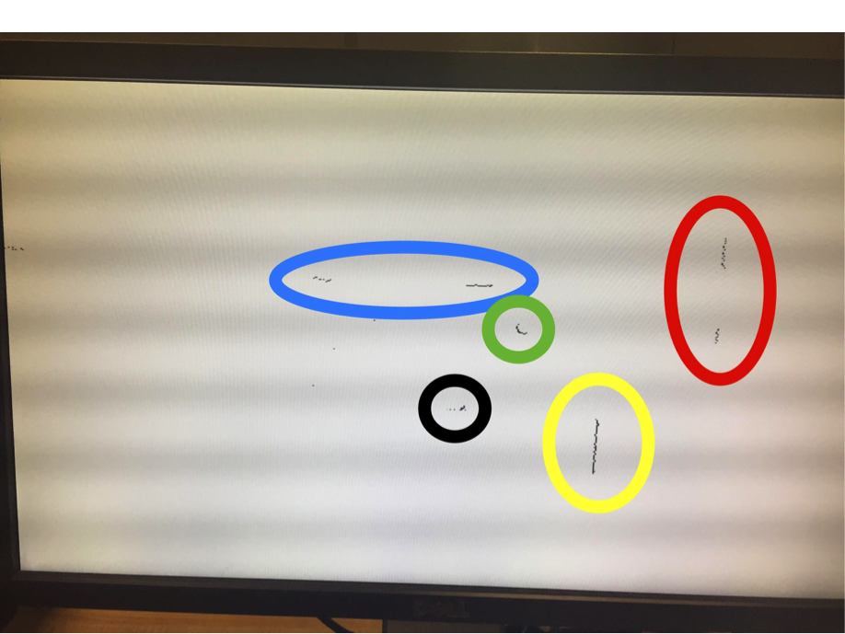
report/figures/labtest1_2.png
