glgauthier/MQP/report/figures/labtest2_2.png

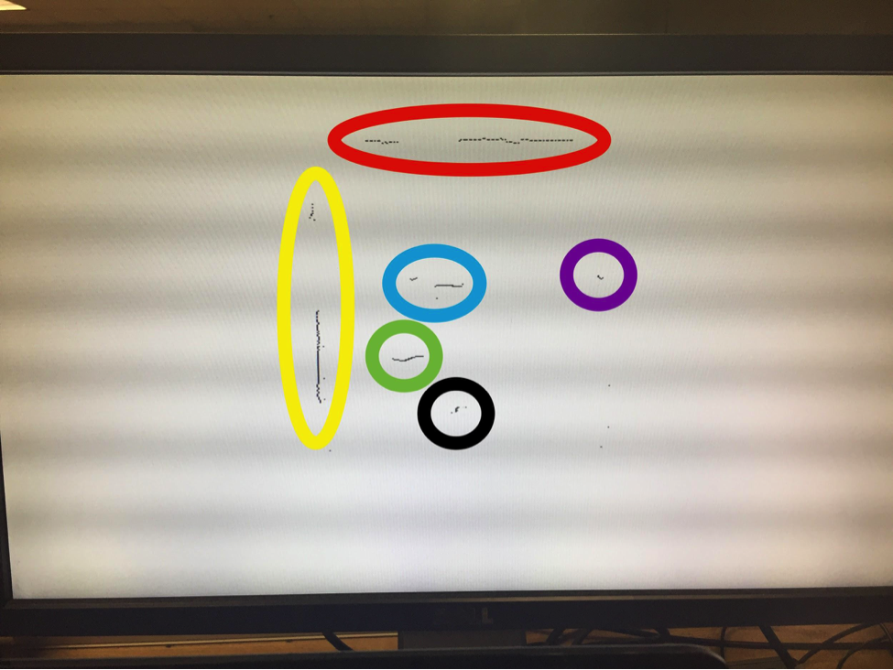
report/figures/labtest2_2.png
