glgauthier/MQP/report/figures/leftright.png

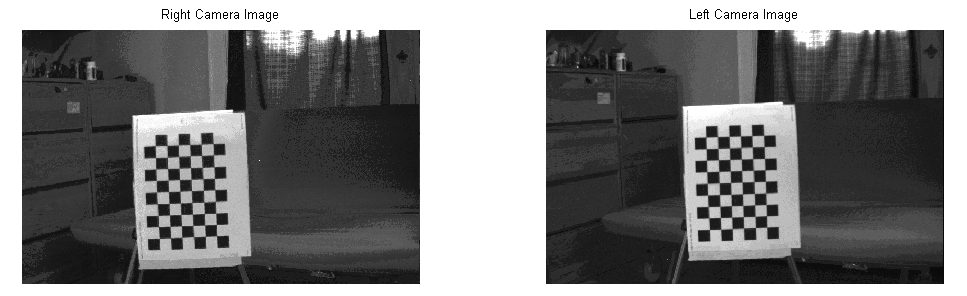
report/figures/leftright.png
