glgauthier/MQP/report/figures/magMultRead.png

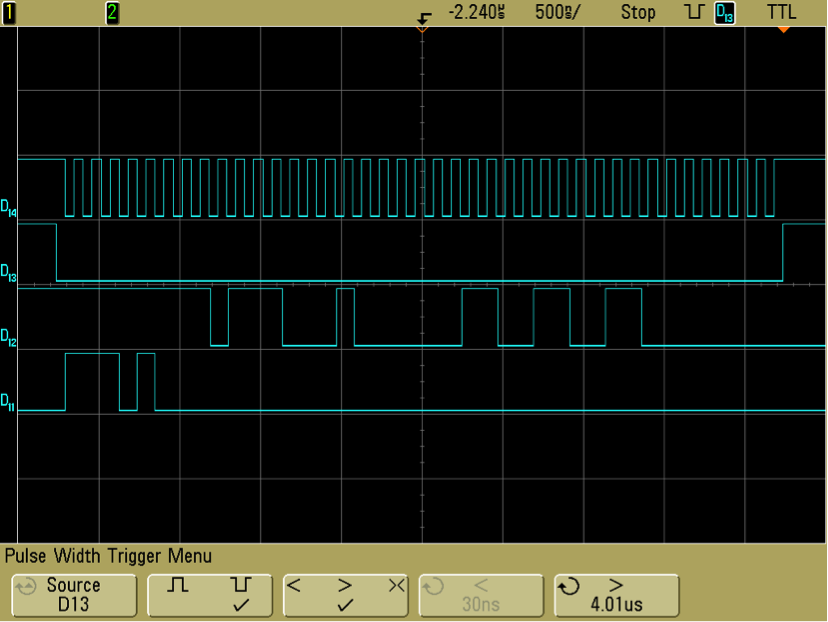
report/figures/magMultRead.png
