glgauthier/MQP/report/figures/magSingleRead.png

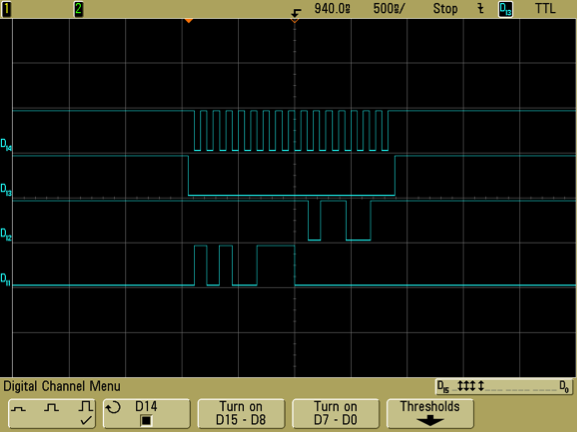
report/figures/magSingleRead.png
