glgauthier/MQP/report/figures/oScope/camera_fifo/dan.png

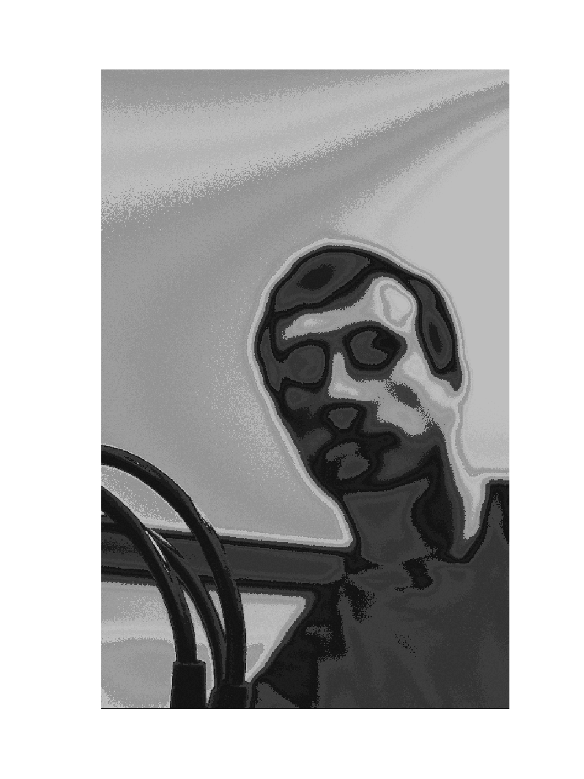
report/figures/oScope/camera_fifo/dan.png
