glgauthier/MQP/report/figures/oScope/camera_fifo/fifoDataOut.png

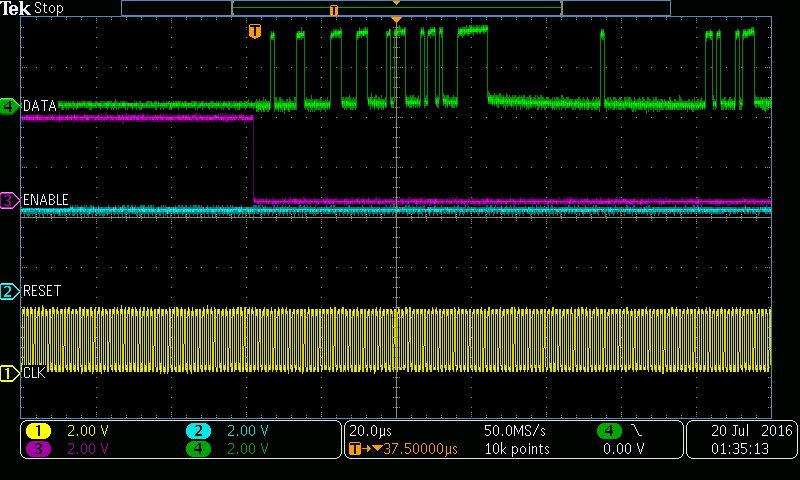
report/figures/oScope/camera_fifo/fifoDataOut.png
