glgauthier/MQP/report/figures/oScope/camera_fifo/ReadToFPGA.png

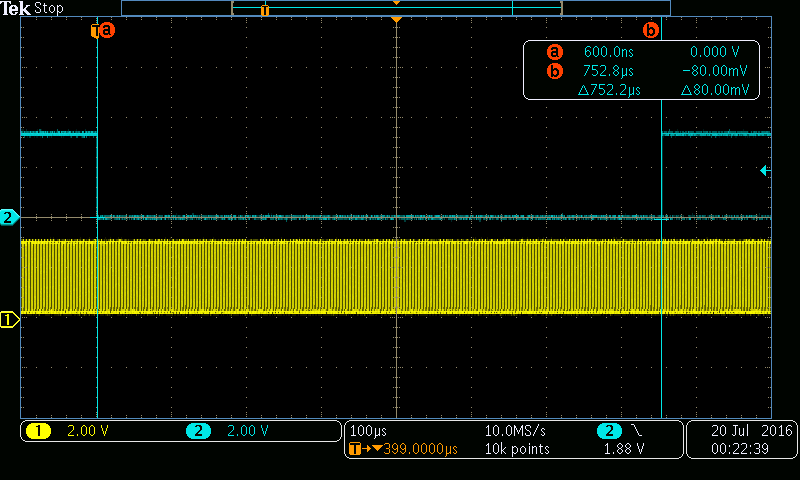
report/figures/oScope/camera_fifo/ReadToFPGA.png
