glgauthier/MQP/report/figures/oScope/camera_fifo/StartReadSequence.png

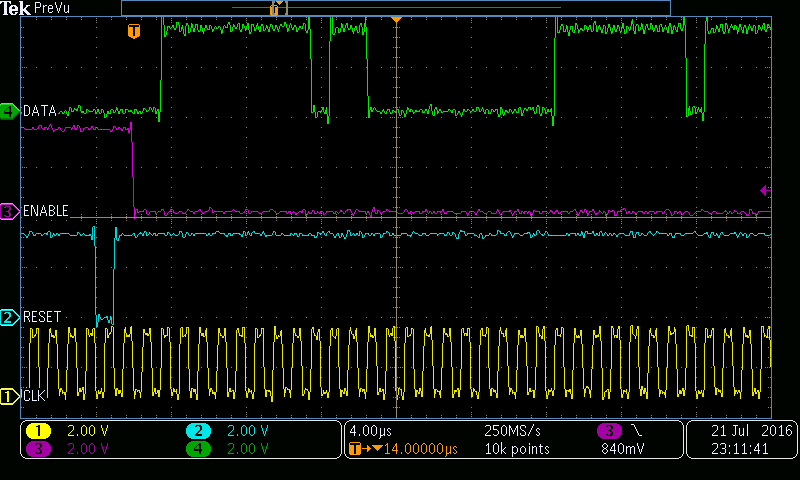
report/figures/oScope/camera_fifo/StartReadSequence.png
