glgauthier/MQP/report/figures/oScope/continuous_output.png

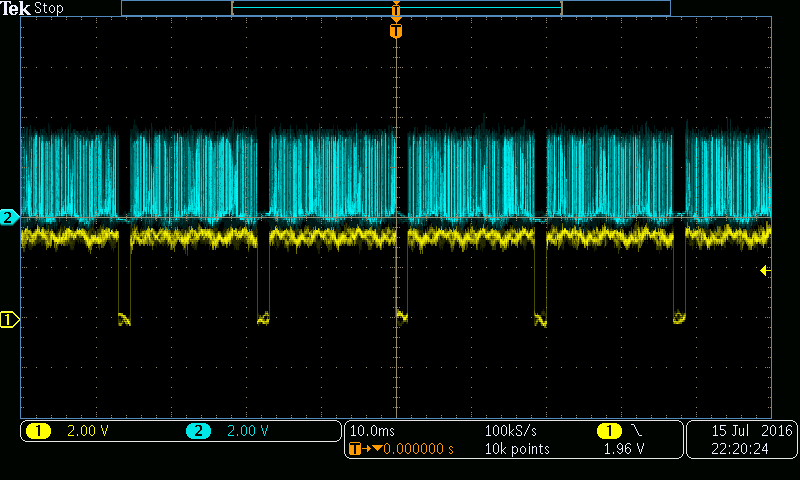
report/figures/oScope/continuous_output.png
