glgauthier/MQP/report/figures/oScope/continuous_timed.png

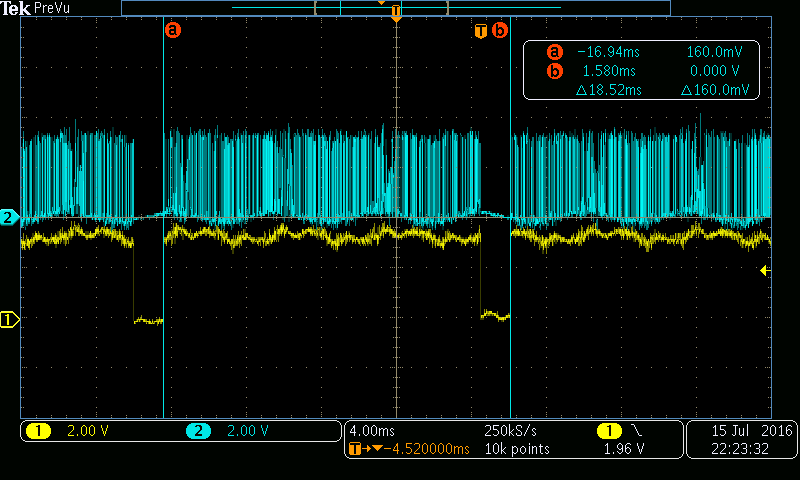
report/figures/oScope/continuous_timed.png
