glgauthier/MQP/report/figures/oScope/i2c_0x00/arduinoSerialOut.PNG

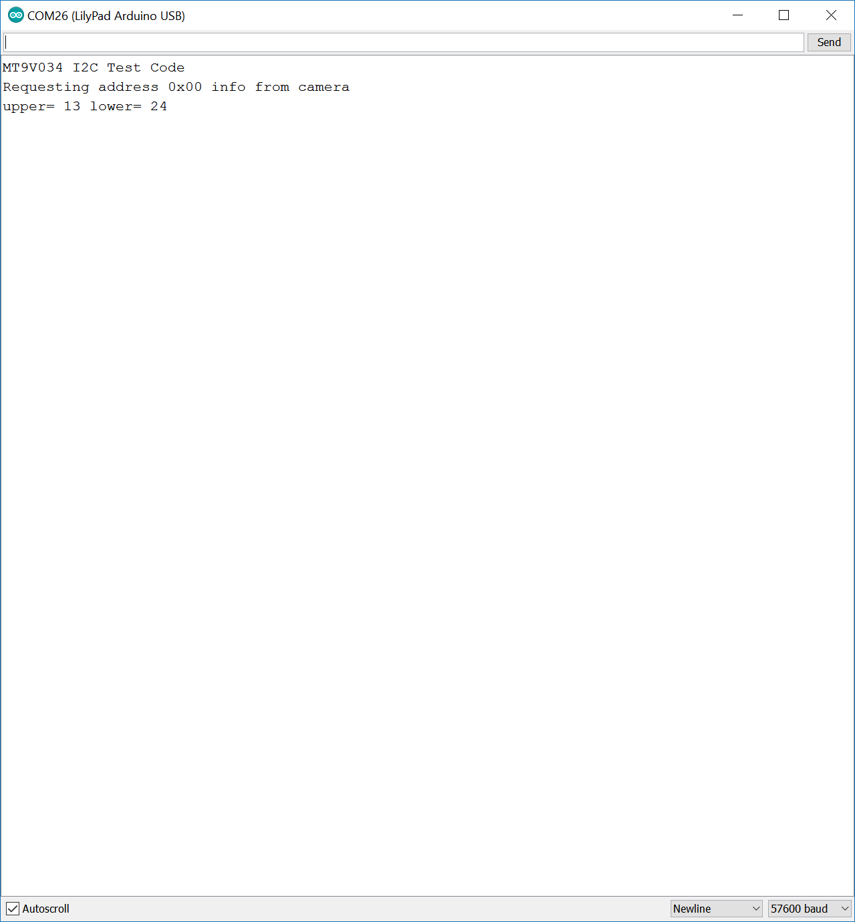
report/figures/oScope/i2c_0x00/arduinoSerialOut.PNG
