glgauthier/MQP/report/figures/oScope/i2c_0x07/cam_ctl_pointerBack_read.png

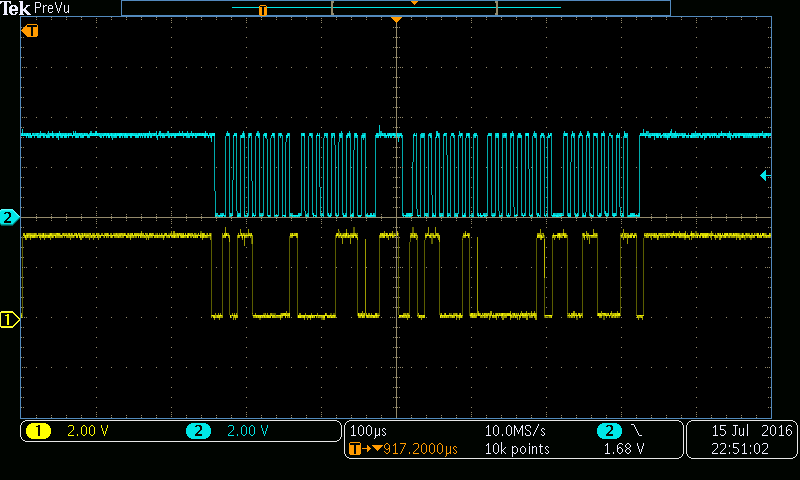
report/figures/oScope/i2c_0x07/cam_ctl_pointerBack_read.png
