glgauthier/MQP/report/figures/oScope/i2c_0x07/cam_ctl_write.png

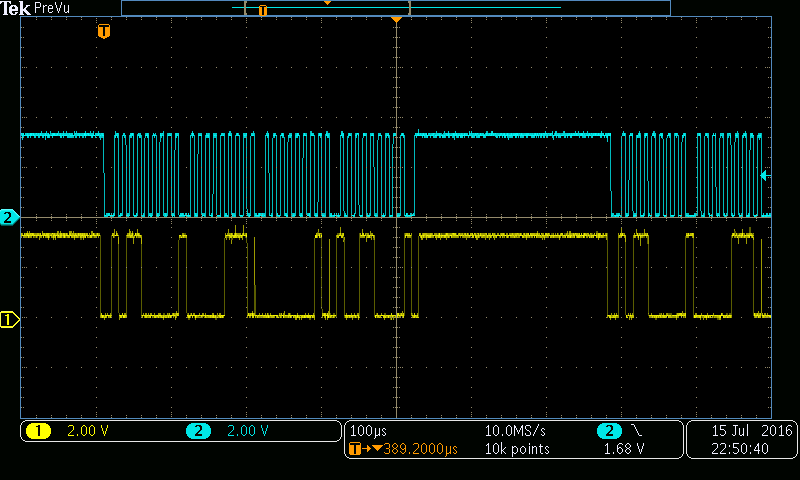
report/figures/oScope/i2c_0x07/cam_ctl_write.png
