glgauthier/MQP/report/figures/oScope/i2c_0x07/cam_ctl_write_full.png

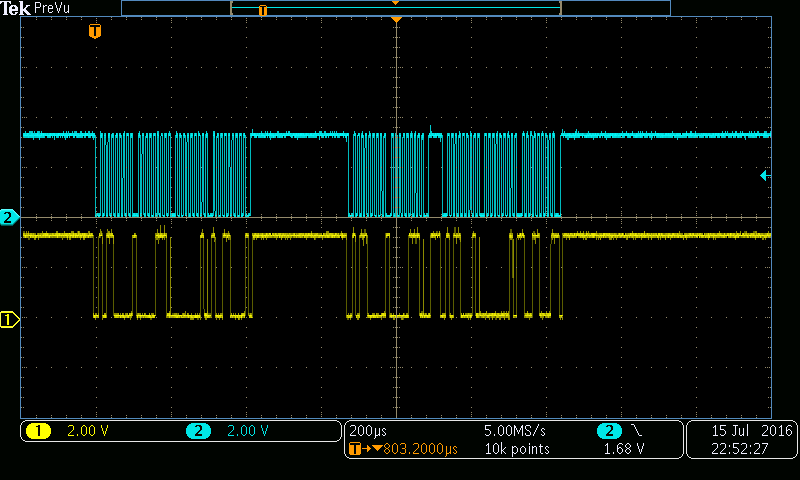
report/figures/oScope/i2c_0x07/cam_ctl_write_full.png
