glgauthier/MQP/report/figures/oScope/pclk_fv_lv/tek00003.png

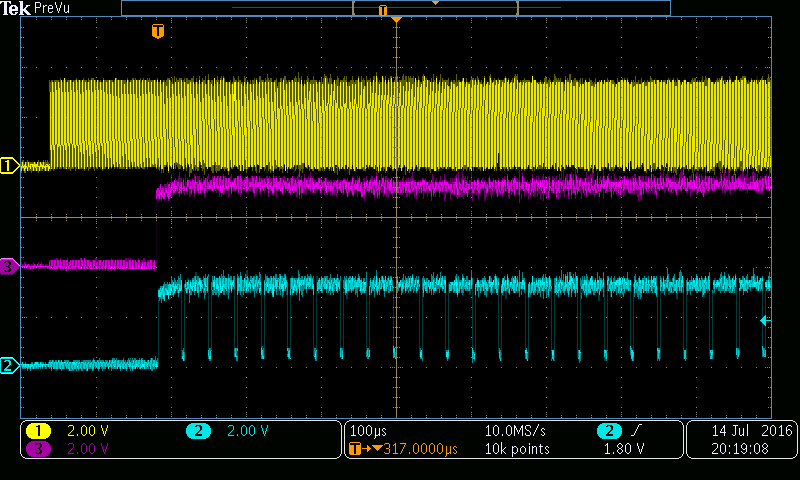
report/figures/oScope/pclk_fv_lv/tek00003.png
