glgauthier/MQP/report/figures/oScope/sw_bounce.png

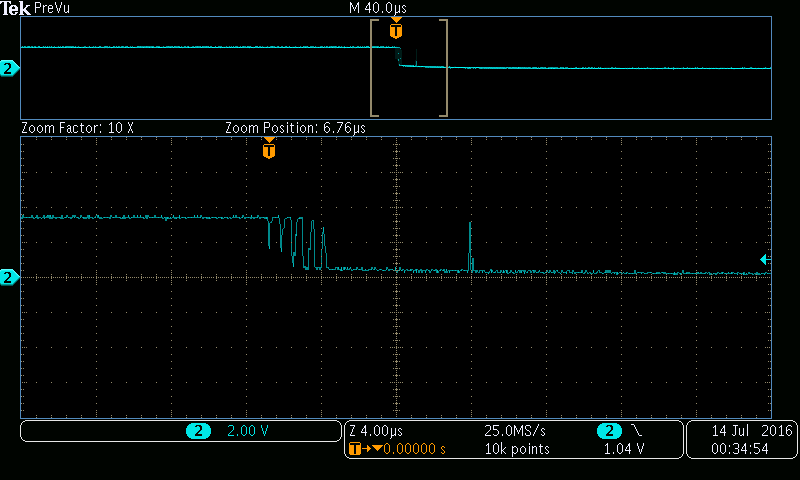
report/figures/oScope/sw_bounce.png
