glgauthier/MQP/report/figures/pc_noOutliers.png

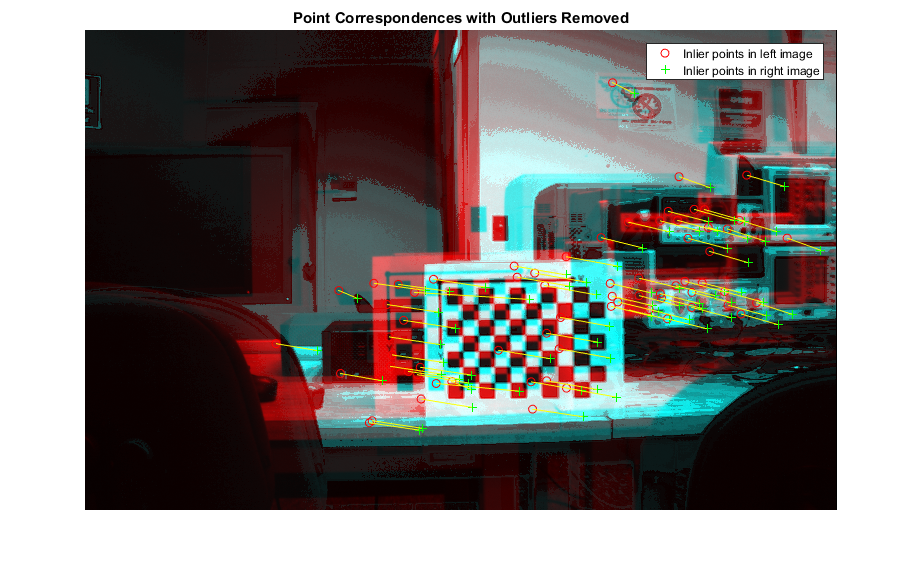
report/figures/pc_noOutliers.png
