glgauthier/MQP/report/figures/rangefinder_mode.JPG

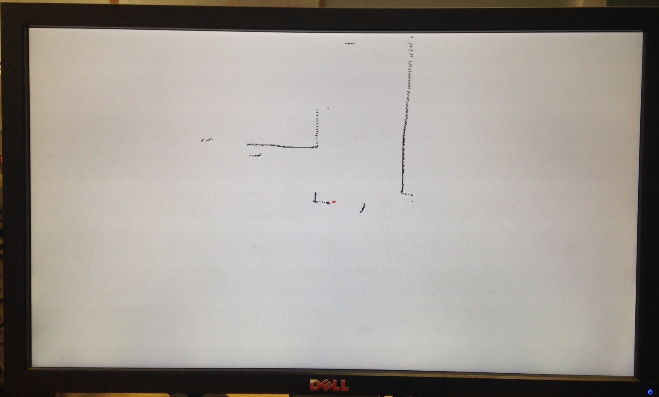
report/figures/rangefinder_mode.JPG
