glgauthier/MQP/report/figures/rangefinder_mode_rotated.JPG

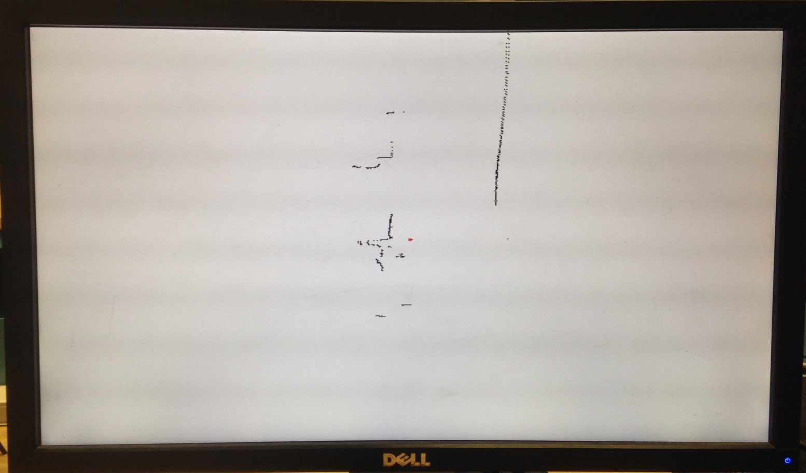
report/figures/rangefinder_mode_rotated.JPG
