glgauthier/MQP/report/figures/rangefinder_rs232.png

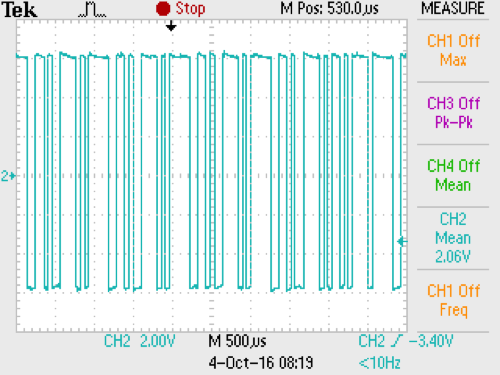
report/figures/rangefinder_rs232.png
