glgauthier/MQP/report/figures/shift.png

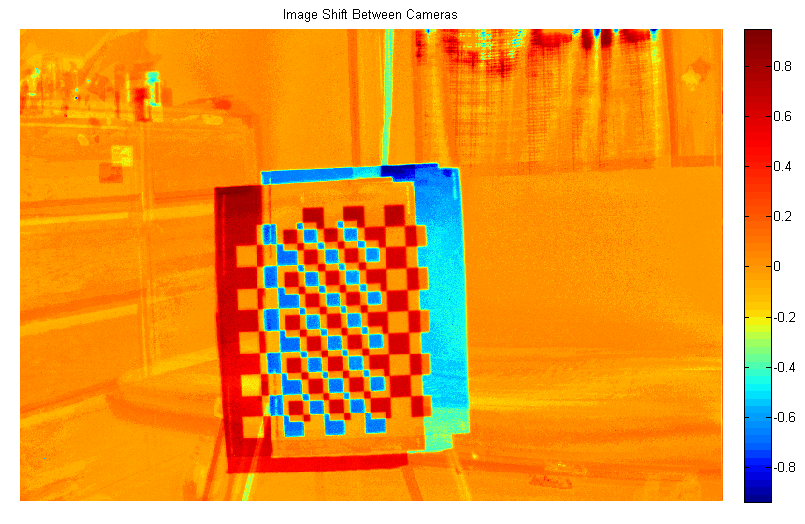
report/figures/shift.png
