glgauthier/MQP/report/figures/stereo_board.png

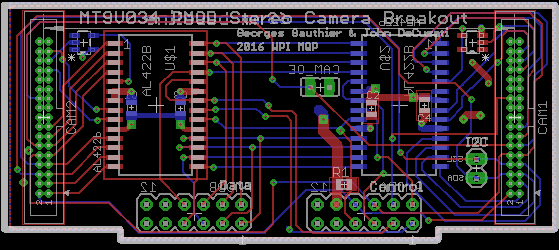
report/figures/stereo_board.png
