glgauthier/MQP/report/figures/stereo_bottom.png

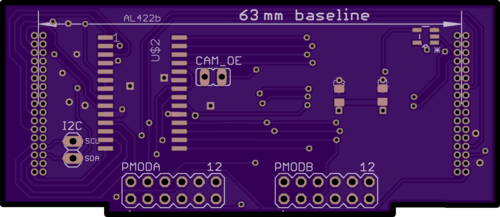
report/figures/stereo_bottom.png
