glgauthier/MQP/report/figures/strongest_correlation.png

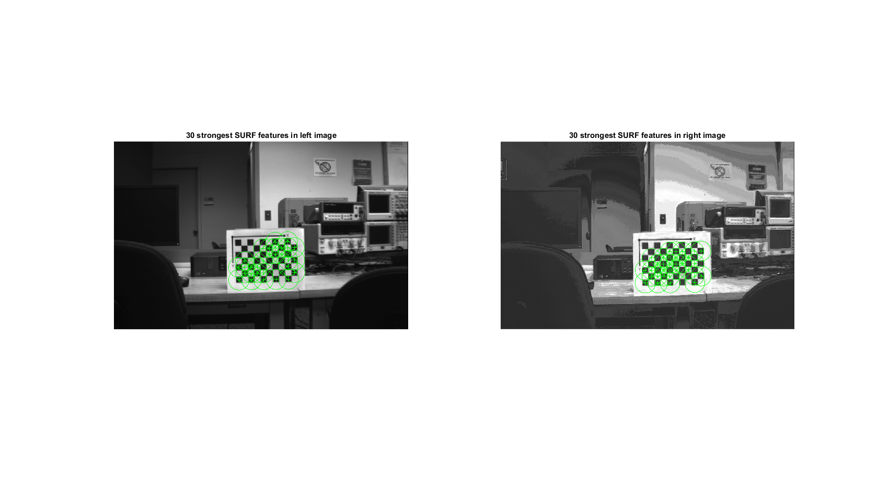
report/figures/strongest_correlation.png
