glgauthier/MQP/report/appendix/componentSelection.tex

\subsection{Component Selection} \label{componentSelection}

\begin{center}
\begin{tabular}{ |c|c|c|c| } 
 \hline
 \textbf{Component} & \textbf{Part Number}  & \textbf{Supplier} & \textbf{Cost}  \\ \hline
 FPGA & ZedBoard & Borrowed & N/A  \\ \hline
 IMU & PmodNAV & Digilent & \$45  \\ \hline
 Rangefinder & URG-04LX & Borrowed & N/A  \\ \hline
 RS232 to TTL Converter & MAX232CSE & uxcell & \$7  \\ \hline
 RS232 Breakout Board & Swellder DB9 & VIKINS Tech & \$7  \\ \hline
 Stereo Cameras$^\dagger$ & MT9V034 & Mouser & \$146  \\ 
 \hline
\end{tabular}
\end{center}
$^\dagger$ Note that we originally planned to purchase a Flir Lepton thermal camera module and accompanying breakout board to support two stereo OV7670 camera modules. After experimenting with the OV7670 camera module on our FPGA board, we realized that these camera modules are highly limited due to their low frame rate and poor documentation, and decided to search for a different camera module. In addition, at a price of \$223 for a thermal camera with an 80x60 degree resolution, 25 degree field of view, and 7-9Hz image sample rate, we believed that we were much better off spending our money on better camera modules that were more usable for our task. For more information see Section \ref{camdecision}.
