glgauthier/MQP/(list of files, cad)

Other CAD files:
Nexys3_Disparity/isim/disparity_isim_beh.exe.sim/work/disparity_isim_beh.exe_main.nt64.obj
Nexys3_Disparity/isim/disparity_tb_isim_beh.exe.sim/work/disparity_tb_isim_beh.exe_main.nt64.obj
Nexys3_Disparity/isim/disparity_isim_beh.exe.sim/work/m_00000000001872066865_4106398011.nt64.obj
Nexys3_Disparity/isim/disparity_tb_isim_beh.exe.sim/work/m_00000000001838647606_0893193378.nt64.obj
Nexys3_Disparity/isim/disparity_isim_beh.exe.sim/work/m_00000000004134447467_2073120511.nt64.obj
Nexys3_Disparity/isim/disparity_tb_isim_beh.exe.sim/work/m_00000000001872066865_3900012700.nt64.obj
Nexys3_Disparity/isim/disparity_tb_isim_beh.exe.sim/work/m_00000000004134447467_2073120511.nt64.obj
