glgauthier/MQP/final_implemention/final_implemention.runs/impl_1/usage_statistics_webtalk.html

### Device Usage Page (usage_statistics_webtalk.html)

This HTML page displays the device usage statistics that will be sent to Xilinx.
To see the actual file transmitted to Xilinx, please click here.

software_version_and_target_device
beta | FALSE | build_version | 1577090
date_generated | Sun Jan 15 13:01:09 2017 | os_platform | WIN64
product_version | Vivado v2016.2 (64-bit) | project_id | d79a3c7025ea42f3ae64233aa2773838
project_iteration | 37 | random_id | 42a33766ecc3594d8d300fc75934d3ae
registration_id | 211146563_0_0_943 | route_design | TRUE
target_device | xc7z020 | target_family | zynq
target_package | clg484 | target_speed | -1
tool_flow | Vivado

user_environment
cpu_name | Intel(R) Core(TM) i7-6820HQ CPU @ 2.70GHz | cpu_speed | 2712 MHz
os_name | Microsoft Windows 8 or later , 64-bit | os_release | major release (build 9200)
system_ram | 34.000 GB | total_processors | 1

vivado_usage

other_data

guimode=76

project_data
board=ZedBoard Zynq Evaluation and Development Kit | constraintsetcount=1 | core_container=false | currentimplrun=impl_1
currentsynthesisrun=synth_1 | default_library=xil_defaultlib | designmode=RTL | export_simulation_activehdl=111
export_simulation_ies=111 | export_simulation_modelsim=111 | export_simulation_questa=111 | export_simulation_riviera=111
export_simulation_vcs=111 | export_simulation_xsim=111 | implstrategy=Vivado Implementation Defaults | launch_simulation_activehdl=0
launch_simulation_ies=0 | launch_simulation_modelsim=0 | launch_simulation_questa=0 | launch_simulation_riviera=0
launch_simulation_vcs=0 | launch_simulation_xsim=0 | simulator_language=Mixed | srcsetcount=4
synthesisstrategy=Vivado Synthesis Defaults | target_language=Verilog | target_simulator=XSim | totalimplruns=2

totalsynthesisruns=2

unisim_transformation

post_unisim_transformation
bibuf=130 | bufg=6 | carry4=230 | dsp48e1=9
fdre=1868 | fdse=55 | gnd=244 | ibuf=26
ldce=48 | ldpe=3 | lut1=97 | lut2=579
lut3=563 | lut4=518 | lut5=382 | lut6=1153
mmcme2_adv=1 | muxf7=165 | muxf8=38 | obuf=32
obuft=6 | ps7=1 | ramb18e1=3 | ramb36e1=129
ramd32=84 | rams32=140 | srl16e=27 | srlc32e=47

vcc=183

pre_unisim_transformation
bibuf=130 | bufg=6 | carry4=230 | dsp48e1=9
fdre=1868 | fdse=55 | gnd=244 | ibuf=20
iobuf=6 | ldce=48 | ldpe=3 | lut1=97
lut2=579 | lut3=563 | lut4=518 | lut5=382
lut6=1153 | mmcme2_adv=1 | muxf7=165 | muxf8=38
obuf=32 | ps7=1 | ram32m=14 | ram32x1s=112
ramb18e1=3 | ramb36e1=129 | srl16e=27 | srlc32e=47

vcc=183

power_opt_design

command_line_options_spo
-cell_types=default::all | -clocks=default::[not_specified] | -exclude_cells=default::[not_specified] | -include_cells=default::[not_specified]

usage
bram_ports_augmented=0 | bram_ports_newly_gated=133 | bram_ports_total=264 | flow_state=default
slice_registers_augmented=0 | slice_registers_newly_gated=0 | slice_registers_total=1690 | srls_augmented=0
srls_newly_gated=0 | srls_total=70

ip_statistics

IP_Integrator/1
bdsource=USER | core_container=NA | da_axi4_cnt=1 | da_ps7_cnt=1
iptotal=1 | maxhierdepth=0 | numblks=9 | numhdlrefblks=0
numhierblks=2 | numhlsblks=0 | numnonxlnxblks=0 | numpkgbdblks=0
numreposblks=7 | numsysgenblks=0 | synth_mode=OOC_per_BD | x_iplanguage=VERILOG
x_iplibrary=BlockDiagram | x_ipname=design_1 | x_ipvendor=xilinx.com | x_ipversion=1.00.a

axi_protocol_converter_v2_1_9_axi_protocol_converter/1
c_axi_addr_width=32 | c_axi_aruser_width=1 | c_axi_awuser_width=1 | c_axi_buser_width=1
c_axi_data_width=32 | c_axi_id_width=12 | c_axi_ruser_width=1 | c_axi_supports_read=1
c_axi_supports_user_signals=0 | c_axi_supports_write=1 | c_axi_wuser_width=1 | c_family=zynq
c_ignore_id=0 | c_m_axi_protocol=2 | c_s_axi_protocol=1 | c_translation_mode=2
core_container=NA | iptotal=1 | x_ipcorerevision=9 | x_iplanguage=VERILOG
x_iplibrary=ip | x_ipname=axi_protocol_converter | x_ipproduct=Vivado 2016.2 | x_ipsimlanguage=MIXED
x_ipvendor=xilinx.com | x_ipversion=2.1

blk_mem_gen_v8_3_3/1
c_addra_width=17 | c_addrb_width=17 | c_algorithm=1 | c_axi_id_width=4
c_axi_slave_type=0 | c_axi_type=1 | c_byte_size=9 | c_common_clk=0
c_count_18k_bram=0 | c_count_36k_bram=27 | c_ctrl_ecc_algo=NONE | c_default_data=0
c_disable_warn_bhv_coll=1 | c_disable_warn_bhv_range=1 | c_elaboration_dir=./ | c_en_deepsleep_pin=0
c_en_ecc_pipe=0 | c_en_rdaddra_chg=0 | c_en_rdaddrb_chg=0 | c_en_safety_ckt=0
c_en_shutdown_pin=0 | c_en_sleep_pin=0 | c_enable_32bit_address=0 | c_est_power_summary=Estimated Power for IP _ 4.5347499999999998 mW
c_family=zynq | c_has_axi_id=0 | c_has_ena=0 | c_has_enb=1
c_has_injecterr=0 | c_has_mem_output_regs_a=0 | c_has_mem_output_regs_b=1 | c_has_mux_output_regs_a=0
c_has_mux_output_regs_b=0 | c_has_regcea=0 | c_has_regceb=0 | c_has_rsta=0
c_has_rstb=0 | c_has_softecc_input_regs_a=0 | c_has_softecc_output_regs_b=0 | c_init_file=blk_mem_384_288.mem
c_init_file_name=no_coe_file_loaded | c_inita_val=0 | c_initb_val=0 | c_interface_type=0
c_load_init_file=0 | c_mem_type=1 | c_mux_pipeline_stages=0 | c_prim_type=1
c_read_depth_a=110592 | c_read_depth_b=110592 | c_read_width_a=8 | c_read_width_b=8
c_rst_priority_a=CE | c_rst_priority_b=CE | c_rstram_a=0 | c_rstram_b=0
c_sim_collision_check=ALL | c_use_bram_block=0 | c_use_byte_wea=0 | c_use_byte_web=0
c_use_default_data=0 | c_use_ecc=0 | c_use_softecc=0 | c_use_uram=0
c_wea_width=1 | c_web_width=1 | c_write_depth_a=110592 | c_write_depth_b=110592
c_write_mode_a=NO_CHANGE | c_write_mode_b=WRITE_FIRST | c_write_width_a=8 | c_write_width_b=8
c_xdevicefamily=zynq | core_container=false | iptotal=2 | x_ipcorerevision=3
x_iplanguage=VERILOG | x_iplibrary=ip | x_ipname=blk_mem_gen | x_ipproduct=Vivado 2016.2
x_ipsimlanguage=MIXED | x_ipvendor=xilinx.com | x_ipversion=8.3

blk_mem_gen_v8_3_3/2
c_addra_width=8 | c_addrb_width=8 | c_algorithm=1 | c_axi_id_width=4
c_axi_slave_type=0 | c_axi_type=1 | c_byte_size=9 | c_common_clk=0
c_count_18k_bram=1 | c_count_36k_bram=0 | c_ctrl_ecc_algo=NONE | c_default_data=0
c_disable_warn_bhv_coll=0 | c_disable_warn_bhv_range=0 | c_elaboration_dir=./ | c_en_deepsleep_pin=0
c_en_ecc_pipe=0 | c_en_rdaddra_chg=0 | c_en_rdaddrb_chg=0 | c_en_safety_ckt=0
c_en_shutdown_pin=0 | c_en_sleep_pin=0 | c_enable_32bit_address=0 | c_est_power_summary=Estimated Power for IP _ 2.5848 mW
c_family=zynq | c_has_axi_id=0 | c_has_ena=0 | c_has_enb=0
c_has_injecterr=0 | c_has_mem_output_regs_a=1 | c_has_mem_output_regs_b=0 | c_has_mux_output_regs_a=0
c_has_mux_output_regs_b=0 | c_has_regcea=0 | c_has_regceb=0 | c_has_rsta=0
c_has_rstb=0 | c_has_softecc_input_regs_a=0 | c_has_softecc_output_regs_b=0 | c_init_file=NONE
c_init_file_name=[user-defined] | c_inita_val=0 | c_initb_val=0 | c_interface_type=0
c_load_init_file=1 | c_mem_type=3 | c_mux_pipeline_stages=0 | c_prim_type=1
c_read_depth_a=129 | c_read_depth_b=129 | c_read_width_a=13 | c_read_width_b=13
c_rst_priority_a=CE | c_rst_priority_b=CE | c_rstram_a=0 | c_rstram_b=0
c_sim_collision_check=ALL | c_use_bram_block=0 | c_use_byte_wea=0 | c_use_byte_web=0
c_use_default_data=0 | c_use_ecc=0 | c_use_softecc=0 | c_use_uram=0
c_wea_width=1 | c_web_width=1 | c_write_depth_a=129 | c_write_depth_b=129
c_write_mode_a=WRITE_FIRST | c_write_mode_b=WRITE_FIRST | c_write_width_a=13 | c_write_width_b=13
c_xdevicefamily=zynq | core_container=false | iptotal=1 | x_ipcorerevision=3
x_iplanguage=VERILOG | x_iplibrary=ip | x_ipname=blk_mem_gen | x_ipproduct=Vivado 2016.2
x_ipsimlanguage=MIXED | x_ipvendor=xilinx.com | x_ipversion=8.3

blk_mem_gen_v8_3_3/3
c_addra_width=8 | c_addrb_width=8 | c_algorithm=1 | c_axi_id_width=4
c_axi_slave_type=0 | c_axi_type=1 | c_byte_size=9 | c_common_clk=0
c_count_18k_bram=1 | c_count_36k_bram=0 | c_ctrl_ecc_algo=NONE | c_default_data=0
c_disable_warn_bhv_coll=0 | c_disable_warn_bhv_range=0 | c_elaboration_dir=./ | c_en_deepsleep_pin=0
c_en_ecc_pipe=0 | c_en_rdaddra_chg=0 | c_en_rdaddrb_chg=0 | c_en_safety_ckt=0
c_en_shutdown_pin=0 | c_en_sleep_pin=0 | c_enable_32bit_address=0 | c_est_power_summary=Estimated Power for IP _ 2.5848 mW
c_family=zynq | c_has_axi_id=0 | c_has_ena=0 | c_has_enb=0
c_has_injecterr=0 | c_has_mem_output_regs_a=1 | c_has_mem_output_regs_b=0 | c_has_mux_output_regs_a=0
c_has_mux_output_regs_b=0 | c_has_regcea=0 | c_has_regceb=0 | c_has_rsta=0
c_has_rstb=0 | c_has_softecc_input_regs_a=0 | c_has_softecc_output_regs_b=0 | c_init_file=NONE
c_init_file_name=[user-defined] | c_inita_val=0 | c_initb_val=0 | c_interface_type=0
c_load_init_file=1 | c_mem_type=3 | c_mux_pipeline_stages=0 | c_prim_type=1
c_read_depth_a=129 | c_read_depth_b=129 | c_read_width_a=13 | c_read_width_b=13
c_rst_priority_a=CE | c_rst_priority_b=CE | c_rstram_a=0 | c_rstram_b=0
c_sim_collision_check=ALL | c_use_bram_block=0 | c_use_byte_wea=0 | c_use_byte_web=0
c_use_default_data=0 | c_use_ecc=0 | c_use_softecc=0 | c_use_uram=0
c_wea_width=1 | c_web_width=1 | c_write_depth_a=129 | c_write_depth_b=129
c_write_mode_a=WRITE_FIRST | c_write_mode_b=WRITE_FIRST | c_write_width_a=13 | c_write_width_b=13
c_xdevicefamily=zynq | core_container=false | iptotal=1 | x_ipcorerevision=3
x_iplanguage=VERILOG | x_iplibrary=ip | x_ipname=blk_mem_gen | x_ipproduct=Vivado 2016.2
x_ipsimlanguage=MIXED | x_ipvendor=xilinx.com | x_ipversion=8.3

blk_mem_gen_v8_3_3/4
c_addra_width=19 | c_addrb_width=19 | c_algorithm=1 | c_axi_id_width=4
c_axi_slave_type=0 | c_axi_type=1 | c_byte_size=9 | c_common_clk=0
c_count_18k_bram=0 | c_count_36k_bram=75 | c_ctrl_ecc_algo=NONE | c_default_data=0
c_disable_warn_bhv_coll=1 | c_disable_warn_bhv_range=1 | c_elaboration_dir=./ | c_en_deepsleep_pin=0
c_en_ecc_pipe=0 | c_en_rdaddra_chg=0 | c_en_rdaddrb_chg=0 | c_en_safety_ckt=0
c_en_shutdown_pin=0 | c_en_sleep_pin=0 | c_enable_32bit_address=0 | c_est_power_summary=Estimated Power for IP _ 4.862098 mW
c_family=zynq | c_has_axi_id=0 | c_has_ena=1 | c_has_enb=0
c_has_injecterr=0 | c_has_mem_output_regs_a=0 | c_has_mem_output_regs_b=1 | c_has_mux_output_regs_a=0
c_has_mux_output_regs_b=0 | c_has_regcea=0 | c_has_regceb=0 | c_has_rsta=0
c_has_rstb=0 | c_has_softecc_input_regs_a=0 | c_has_softecc_output_regs_b=0 | c_init_file=NONE
c_init_file_name=no_coe_file_loaded | c_inita_val=0 | c_initb_val=0 | c_interface_type=0
c_load_init_file=0 | c_mem_type=1 | c_mux_pipeline_stages=0 | c_prim_type=1
c_read_depth_a=307200 | c_read_depth_b=307200 | c_read_width_a=8 | c_read_width_b=8
c_rst_priority_a=CE | c_rst_priority_b=CE | c_rstram_a=0 | c_rstram_b=0
c_sim_collision_check=NONE | c_use_bram_block=0 | c_use_byte_wea=0 | c_use_byte_web=0
c_use_default_data=1 | c_use_ecc=0 | c_use_softecc=0 | c_use_uram=0
c_wea_width=1 | c_web_width=1 | c_write_depth_a=307200 | c_write_depth_b=307200
c_write_mode_a=WRITE_FIRST | c_write_mode_b=WRITE_FIRST | c_write_width_a=8 | c_write_width_b=8
c_xdevicefamily=zynq | core_container=false | iptotal=1 | x_ipcorerevision=3
x_iplanguage=VERILOG | x_iplibrary=ip | x_ipname=blk_mem_gen | x_ipproduct=Vivado 2016.2
x_ipsimlanguage=MIXED | x_ipvendor=xilinx.com | x_ipversion=8.3

blk_mem_gen_v8_3_3/5
c_addra_width=7 | c_addrb_width=7 | c_algorithm=1 | c_axi_id_width=4
c_axi_slave_type=0 | c_axi_type=1 | c_byte_size=9 | c_common_clk=1
c_count_18k_bram=1 | c_count_36k_bram=0 | c_ctrl_ecc_algo=NONE | c_default_data=0
c_disable_warn_bhv_coll=0 | c_disable_warn_bhv_range=0 | c_elaboration_dir=./ | c_en_deepsleep_pin=0
c_en_ecc_pipe=0 | c_en_rdaddra_chg=0 | c_en_rdaddrb_chg=0 | c_en_safety_ckt=0
c_en_shutdown_pin=0 | c_en_sleep_pin=0 | c_enable_32bit_address=0 | c_est_power_summary=Estimated Power for IP _ 2.6845500000000002 mW
c_family=zynq | c_has_axi_id=0 | c_has_ena=0 | c_has_enb=0
c_has_injecterr=0 | c_has_mem_output_regs_a=0 | c_has_mem_output_regs_b=1 | c_has_mux_output_regs_a=0
c_has_mux_output_regs_b=0 | c_has_regcea=0 | c_has_regceb=0 | c_has_rsta=0
c_has_rstb=0 | c_has_softecc_input_regs_a=0 | c_has_softecc_output_regs_b=0 | c_init_file=line_bram.mem
c_init_file_name=no_coe_file_loaded | c_inita_val=0 | c_initb_val=0 | c_interface_type=0
c_load_init_file=0 | c_mem_type=1 | c_mux_pipeline_stages=0 | c_prim_type=1
c_read_depth_a=96 | c_read_depth_b=96 | c_read_width_a=8 | c_read_width_b=8
c_rst_priority_a=CE | c_rst_priority_b=CE | c_rstram_a=0 | c_rstram_b=0
c_sim_collision_check=ALL | c_use_bram_block=0 | c_use_byte_wea=0 | c_use_byte_web=0
c_use_default_data=0 | c_use_ecc=0 | c_use_softecc=0 | c_use_uram=0
c_wea_width=1 | c_web_width=1 | c_write_depth_a=96 | c_write_depth_b=96
c_write_mode_a=WRITE_FIRST | c_write_mode_b=READ_FIRST | c_write_width_a=8 | c_write_width_b=8
c_xdevicefamily=zynq | core_container=false | iptotal=1 | x_ipcorerevision=3
x_iplanguage=VERILOG | x_iplibrary=ip | x_ipname=blk_mem_gen | x_ipproduct=Vivado 2016.2
x_ipsimlanguage=MIXED | x_ipvendor=xilinx.com | x_ipversion=8.3

clk_wiz_v5_3_1/1
clkin1_period=10.0 | clkin2_period=10.0 | clock_mgr_type=NA | component_name=clk_wiz_0
core_container=false | enable_axi=0 | feedback_source=FDBK_AUTO | feedback_type=SINGLE
iptotal=1 | manual_override=false | num_out_clk=4 | primitive=MMCM
use_dyn_phase_shift=false | use_dyn_reconfig=false | use_inclk_stopped=false | use_inclk_switchover=false
use_locked=false | use_max_i_jitter=false | use_min_o_jitter=false | use_phase_alignment=true
use_power_down=false | use_reset=true

custom_logic_v1_0/1
c_s00_axi_addr_width=4 | c_s00_axi_data_width=32 | core_container=NA | iptotal=1
x_ipcorerevision=41 | x_iplanguage=VERILOG | x_iplibrary=user | x_ipname=custom_logic
x_ipproduct=Vivado 2016.2 | x_ipsimlanguage=MIXED | x_ipvendor=xilinx.com | x_ipversion=1.0

mult_gen_v12_0_11/1
c_a_type=1 | c_a_width=12 | c_b_type=1 | c_b_value=10000001
c_b_width=13 | c_ccm_imp=0 | c_ce_overrides_sclr=0 | c_has_ce=0
c_has_sclr=0 | c_has_zero_detect=0 | c_latency=4 | c_model_type=0
c_mult_type=0 | c_optimize_goal=1 | c_out_high=24 | c_out_low=0
c_round_output=0 | c_round_pt=0 | c_verbosity=0 | c_xdevicefamily=zynq
core_container=false | iptotal=2 | x_ipcorerevision=11 | x_iplanguage=VERILOG
x_iplibrary=ip | x_ipname=mult_gen | x_ipproduct=Vivado 2016.2 | x_ipsimlanguage=MIXED
x_ipvendor=xilinx.com | x_ipversion=12.0

mult_gen_v12_0_11/2
c_a_type=1 | c_a_width=9 | c_b_type=1 | c_b_value=1010000000
c_b_width=10 | c_ccm_imp=2 | c_ce_overrides_sclr=0 | c_has_ce=0
c_has_sclr=0 | c_has_zero_detect=0 | c_latency=3 | c_model_type=0
c_mult_type=2 | c_optimize_goal=1 | c_out_high=18 | c_out_low=0
c_round_output=0 | c_round_pt=0 | c_verbosity=0 | c_xdevicefamily=zynq
core_container=false | iptotal=1 | x_ipcorerevision=11 | x_iplanguage=VERILOG
x_iplibrary=ip | x_ipname=mult_gen | x_ipproduct=Vivado 2016.2 | x_ipsimlanguage=MIXED
x_ipvendor=xilinx.com | x_ipversion=12.0

proc_sys_reset/1
c_aux_reset_high=0 | c_aux_rst_width=4 | c_ext_reset_high=0 | c_ext_rst_width=4
c_family=zynq | c_num_bus_rst=1 | c_num_interconnect_aresetn=1 | c_num_perp_aresetn=1
c_num_perp_rst=1 | core_container=NA | iptotal=1 | x_ipcorerevision=9
x_iplanguage=VERILOG | x_iplibrary=ip | x_ipname=proc_sys_reset | x_ipproduct=Vivado 2016.2
x_ipsimlanguage=MIXED | x_ipvendor=xilinx.com | x_ipversion=5.0

processing_system7_v5.5_user_configuration/1
core_container=NA | iptotal=1 | pcw_apu_clk_ratio_enable=6:2:1 | pcw_apu_peripheral_freqmhz=666.666667
pcw_armpll_ctrl_fbdiv=40 | pcw_can0_grp_clk_enable=0 | pcw_can0_peripheral_clksrc=External | pcw_can0_peripheral_enable=0
pcw_can0_peripheral_freqmhz=-1 | pcw_can1_grp_clk_enable=0 | pcw_can1_peripheral_clksrc=External | pcw_can1_peripheral_enable=0
pcw_can1_peripheral_freqmhz=-1 | pcw_can_peripheral_clksrc=IO PLL | pcw_can_peripheral_freqmhz=100 | pcw_cpu_cpu_pll_freqmhz=1333.333
pcw_cpu_peripheral_clksrc=ARM PLL | pcw_crystal_peripheral_freqmhz=33.333333 | pcw_dci_peripheral_clksrc=DDR PLL | pcw_dci_peripheral_freqmhz=10.159
pcw_ddr_ddr_pll_freqmhz=1066.667 | pcw_ddr_hpr_to_critical_priority_level=15 | pcw_ddr_hprlpr_queue_partition=HPR(0)/LPR(32) | pcw_ddr_lpr_to_critical_priority_level=2
pcw_ddr_peripheral_clksrc=DDR PLL | pcw_ddr_port0_hpr_enable=0 | pcw_ddr_port1_hpr_enable=0 | pcw_ddr_port2_hpr_enable=0
pcw_ddr_port3_hpr_enable=0 | pcw_ddr_write_to_critical_priority_level=2 | pcw_ddrpll_ctrl_fbdiv=32 | pcw_enet0_grp_mdio_enable=0
pcw_enet0_peripheral_clksrc=IO PLL | pcw_enet0_peripheral_enable=0 | pcw_enet0_peripheral_freqmhz=1000 Mbps | pcw_enet0_reset_enable=0
pcw_enet1_grp_mdio_enable=0 | pcw_enet1_peripheral_clksrc=IO PLL | pcw_enet1_peripheral_enable=0 | pcw_enet1_peripheral_freqmhz=1000 Mbps
pcw_enet1_reset_enable=0 | pcw_enet_reset_polarity=Active Low | pcw_fclk0_peripheral_clksrc=IO PLL | pcw_fclk1_peripheral_clksrc=IO PLL
pcw_fclk2_peripheral_clksrc=IO PLL | pcw_fclk3_peripheral_clksrc=IO PLL | pcw_fpga0_peripheral_freqmhz=100.000000 | pcw_fpga1_peripheral_freqmhz=150.000000
pcw_fpga2_peripheral_freqmhz=50 | pcw_fpga3_peripheral_freqmhz=50 | pcw_fpga_fclk0_enable=1 | pcw_fpga_fclk1_enable=0
pcw_fpga_fclk2_enable=0 | pcw_fpga_fclk3_enable=0 | pcw_ftm_cti_in0=DISABLED | pcw_ftm_cti_in1=DISABLED
pcw_ftm_cti_in2=DISABLED | pcw_ftm_cti_in3=DISABLED | pcw_ftm_cti_out0=DISABLED | pcw_ftm_cti_out1=DISABLED
pcw_ftm_cti_out2=DISABLED | pcw_ftm_cti_out3=DISABLED | pcw_gpio_emio_gpio_enable=1 | pcw_gpio_emio_gpio_io=2
pcw_gpio_mio_gpio_enable=1 | pcw_gpio_mio_gpio_io=MIO | pcw_gpio_peripheral_enable=0 | pcw_i2c0_grp_int_enable=0
pcw_i2c0_i2c0_io=MIO 14 .. 15 | pcw_i2c0_peripheral_enable=1 | pcw_i2c0_reset_enable=0 | pcw_i2c1_grp_int_enable=0
pcw_i2c1_peripheral_enable=0 | pcw_i2c1_reset_enable=0 | pcw_i2c_reset_polarity=Active Low | pcw_io_io_pll_freqmhz=1000.000
pcw_iopll_ctrl_fbdiv=30 | pcw_irq_f2p_mode=DIRECT | pcw_m_axi_gp0_freqmhz=100 | pcw_m_axi_gp1_freqmhz=10
pcw_nand_cycles_t_ar=1 | pcw_nand_cycles_t_clr=1 | pcw_nand_cycles_t_rc=11 | pcw_nand_cycles_t_rea=1
pcw_nand_cycles_t_rr=1 | pcw_nand_cycles_t_wc=11 | pcw_nand_cycles_t_wp=1 | pcw_nand_grp_d8_enable=0
pcw_nand_peripheral_enable=0 | pcw_nor_cs0_t_ceoe=1 | pcw_nor_cs0_t_pc=1 | pcw_nor_cs0_t_rc=11
pcw_nor_cs0_t_tr=1 | pcw_nor_cs0_t_wc=11 | pcw_nor_cs0_t_wp=1 | pcw_nor_cs0_we_time=0
pcw_nor_cs1_t_ceoe=1 | pcw_nor_cs1_t_pc=1 | pcw_nor_cs1_t_rc=11 | pcw_nor_cs1_t_tr=1
pcw_nor_cs1_t_wc=11 | pcw_nor_cs1_t_wp=1 | pcw_nor_cs1_we_time=0 | pcw_nor_grp_a25_enable=0
pcw_nor_grp_cs0_enable=0 | pcw_nor_grp_cs1_enable=0 | pcw_nor_grp_sram_cs0_enable=0 | pcw_nor_grp_sram_cs1_enable=0
pcw_nor_grp_sram_int_enable=0 | pcw_nor_peripheral_enable=0 | pcw_nor_sram_cs0_t_ceoe=1 | pcw_nor_sram_cs0_t_pc=1
pcw_nor_sram_cs0_t_rc=11 | pcw_nor_sram_cs0_t_tr=1 | pcw_nor_sram_cs0_t_wc=11 | pcw_nor_sram_cs0_t_wp=1
pcw_nor_sram_cs0_we_time=0 | pcw_nor_sram_cs1_t_ceoe=1 | pcw_nor_sram_cs1_t_pc=1 | pcw_nor_sram_cs1_t_rc=11
pcw_nor_sram_cs1_t_tr=1 | pcw_nor_sram_cs1_t_wc=11 | pcw_nor_sram_cs1_t_wp=1 | pcw_nor_sram_cs1_we_time=0
pcw_override_basic_clock=0 | pcw_pcap_peripheral_clksrc=IO PLL | pcw_pcap_peripheral_freqmhz=200 | pcw_pjtag_peripheral_enable=0
pcw_preset_bank0_voltage=LVCMOS 3.3V | pcw_preset_bank1_voltage=LVCMOS 1.8V | pcw_qspi_grp_fbclk_enable=0 | pcw_qspi_grp_io1_enable=0
pcw_qspi_grp_single_ss_enable=1 | pcw_qspi_grp_single_ss_io=MIO 1 .. 6 | pcw_qspi_grp_ss1_enable=0 | pcw_qspi_internal_highaddress=0xFCFFFFFF
pcw_qspi_peripheral_clksrc=IO PLL | pcw_qspi_peripheral_enable=1 | pcw_qspi_peripheral_freqmhz=200 | pcw_qspi_qspi_io=MIO 1 .. 6
pcw_s_axi_acp_freqmhz=10 | pcw_s_axi_gp0_freqmhz=10 | pcw_s_axi_gp1_freqmhz=10 | pcw_s_axi_hp0_data_width=64
pcw_s_axi_hp0_freqmhz=10 | pcw_s_axi_hp1_data_width=64 | pcw_s_axi_hp1_freqmhz=10 | pcw_s_axi_hp2_data_width=64
pcw_s_axi_hp2_freqmhz=10 | pcw_s_axi_hp3_data_width=64 | pcw_s_axi_hp3_freqmhz=10 | pcw_sd0_grp_cd_enable=0
pcw_sd0_grp_pow_enable=0 | pcw_sd0_grp_wp_enable=0 | pcw_sd0_peripheral_enable=0 | pcw_sd1_grp_cd_enable=0
pcw_sd1_grp_pow_enable=0 | pcw_sd1_grp_wp_enable=0 | pcw_sd1_peripheral_enable=0 | pcw_sdio_peripheral_clksrc=IO PLL
pcw_sdio_peripheral_freqmhz=50 | pcw_smc_peripheral_clksrc=IO PLL | pcw_smc_peripheral_freqmhz=100 | pcw_spi0_grp_ss0_enable=1
pcw_spi0_grp_ss0_io=EMIO | pcw_spi0_grp_ss1_enable=1 | pcw_spi0_grp_ss1_io=EMIO | pcw_spi0_grp_ss2_enable=1
pcw_spi0_grp_ss2_io=EMIO | pcw_spi0_peripheral_enable=1 | pcw_spi0_spi0_io=EMIO | pcw_spi1_grp_ss0_enable=0
pcw_spi1_grp_ss1_enable=0 | pcw_spi1_grp_ss2_enable=0 | pcw_spi1_peripheral_enable=0 | pcw_spi_peripheral_clksrc=IO PLL
pcw_spi_peripheral_freqmhz=166.666666 | pcw_tpiu_peripheral_clksrc=External | pcw_tpiu_peripheral_freqmhz=200 | pcw_trace_grp_16bit_enable=0
pcw_trace_grp_2bit_enable=0 | pcw_trace_grp_32bit_enable=0 | pcw_trace_grp_4bit_enable=0 | pcw_trace_grp_8bit_enable=0
pcw_trace_peripheral_enable=0 | pcw_ttc0_clk0_peripheral_clksrc=CPU_1X | pcw_ttc0_clk0_peripheral_freqmhz=133.333333 | pcw_ttc0_clk1_peripheral_clksrc=CPU_1X
pcw_ttc0_clk1_peripheral_freqmhz=133.333333 | pcw_ttc0_clk2_peripheral_clksrc=CPU_1X | pcw_ttc0_clk2_peripheral_freqmhz=133.333333 | pcw_ttc0_peripheral_enable=0
pcw_ttc1_clk0_peripheral_clksrc=CPU_1X | pcw_ttc1_clk0_peripheral_freqmhz=133.333333 | pcw_ttc1_clk1_peripheral_clksrc=CPU_1X | pcw_ttc1_clk1_peripheral_freqmhz=133.333333
pcw_ttc1_clk2_peripheral_clksrc=CPU_1X | pcw_ttc1_clk2_peripheral_freqmhz=133.333333 | pcw_ttc1_peripheral_enable=0 | pcw_ttc_peripheral_freqmhz=50
pcw_uart0_baud_rate=19200 | pcw_uart0_grp_full_enable=0 | pcw_uart0_peripheral_enable=1 | pcw_uart0_uart0_io=MIO 10 .. 11
pcw_uart1_baud_rate=19200 | pcw_uart1_grp_full_enable=0 | pcw_uart1_peripheral_enable=0 | pcw_uart_peripheral_clksrc=IO PLL
pcw_uart_peripheral_freqmhz=50 | pcw_uiparam_ddr_adv_enable=0 | pcw_uiparam_ddr_al=0 | pcw_uiparam_ddr_bank_addr_count=3
pcw_uiparam_ddr_bl=8 | pcw_uiparam_ddr_board_delay0=0.41 | pcw_uiparam_ddr_board_delay1=0.411 | pcw_uiparam_ddr_board_delay2=0.341
pcw_uiparam_ddr_board_delay3=0.358 | pcw_uiparam_ddr_bus_width=32 Bit | pcw_uiparam_ddr_cl=7 | pcw_uiparam_ddr_clock_0_length_mm=0
pcw_uiparam_ddr_clock_0_package_length=61.0905 | pcw_uiparam_ddr_clock_0_propogation_delay=160 | pcw_uiparam_ddr_clock_1_length_mm=0 | pcw_uiparam_ddr_clock_1_package_length=61.0905
pcw_uiparam_ddr_clock_1_propogation_delay=160 | pcw_uiparam_ddr_clock_2_length_mm=0 | pcw_uiparam_ddr_clock_2_package_length=61.0905 | pcw_uiparam_ddr_clock_2_propogation_delay=160
pcw_uiparam_ddr_clock_3_length_mm=0 | pcw_uiparam_ddr_clock_3_package_length=61.0905 | pcw_uiparam_ddr_clock_3_propogation_delay=160 | pcw_uiparam_ddr_clock_stop_en=0
pcw_uiparam_ddr_col_addr_count=10 | pcw_uiparam_ddr_cwl=6 | pcw_uiparam_ddr_device_capacity=2048 MBits | pcw_uiparam_ddr_dq_0_length_mm=0
pcw_uiparam_ddr_dq_0_package_length=64.1705 | pcw_uiparam_ddr_dq_0_propogation_delay=160 | pcw_uiparam_ddr_dq_1_length_mm=0 | pcw_uiparam_ddr_dq_1_package_length=63.686
pcw_uiparam_ddr_dq_1_propogation_delay=160 | pcw_uiparam_ddr_dq_2_length_mm=0 | pcw_uiparam_ddr_dq_2_package_length=68.46 | pcw_uiparam_ddr_dq_2_propogation_delay=160
pcw_uiparam_ddr_dq_3_length_mm=0 | pcw_uiparam_ddr_dq_3_package_length=105.4895 | pcw_uiparam_ddr_dq_3_propogation_delay=160 | pcw_uiparam_ddr_dqs_0_length_mm=0
pcw_uiparam_ddr_dqs_0_package_length=68.4725 | pcw_uiparam_ddr_dqs_0_propogation_delay=160 | pcw_uiparam_ddr_dqs_1_length_mm=0 | pcw_uiparam_ddr_dqs_1_package_length=71.086
pcw_uiparam_ddr_dqs_1_propogation_delay=160 | pcw_uiparam_ddr_dqs_2_length_mm=0 | pcw_uiparam_ddr_dqs_2_package_length=66.794 | pcw_uiparam_ddr_dqs_2_propogation_delay=160
pcw_uiparam_ddr_dqs_3_length_mm=0 | pcw_uiparam_ddr_dqs_3_package_length=108.7385 | pcw_uiparam_ddr_dqs_3_propogation_delay=160 | pcw_uiparam_ddr_dqs_to_clk_delay_0=0.025
pcw_uiparam_ddr_dqs_to_clk_delay_1=0.028 | pcw_uiparam_ddr_dqs_to_clk_delay_2=-0.009 | pcw_uiparam_ddr_dqs_to_clk_delay_3=-0.061 | pcw_uiparam_ddr_dram_width=16 Bits
pcw_uiparam_ddr_ecc=Disabled | pcw_uiparam_ddr_enable=1 | pcw_uiparam_ddr_freq_mhz=533.333313 | pcw_uiparam_ddr_high_temp=Normal (0-85)
pcw_uiparam_ddr_memory_type=DDR 3 | pcw_uiparam_ddr_partno=MT41J128M16 HA-15E | pcw_uiparam_ddr_row_addr_count=14 | pcw_uiparam_ddr_speed_bin=DDR3_1066F
pcw_uiparam_ddr_t_faw=45.0 | pcw_uiparam_ddr_t_ras_min=36.0 | pcw_uiparam_ddr_t_rc=49.5 | pcw_uiparam_ddr_t_rcd=7
pcw_uiparam_ddr_t_rp=7 | pcw_uiparam_ddr_train_data_eye=1 | pcw_uiparam_ddr_train_read_gate=1 | pcw_uiparam_ddr_train_write_level=1
pcw_uiparam_ddr_use_internal_vref=1 | pcw_usb0_peripheral_enable=0 | pcw_usb0_peripheral_freqmhz=60 | pcw_usb0_reset_enable=0
pcw_usb1_peripheral_enable=0 | pcw_usb1_peripheral_freqmhz=60 | pcw_usb1_reset_enable=0 | pcw_usb_reset_polarity=Active Low
pcw_use_cross_trigger=0 | pcw_use_m_axi_gp0=1 | pcw_use_m_axi_gp1=0 | pcw_use_s_axi_acp=0
pcw_use_s_axi_gp0=0 | pcw_use_s_axi_gp1=0 | pcw_use_s_axi_hp0=0 | pcw_use_s_axi_hp1=0
pcw_use_s_axi_hp2=0 | pcw_use_s_axi_hp3=0 | pcw_wdt_peripheral_clksrc=CPU_1X | pcw_wdt_peripheral_enable=0

pcw_wdt_peripheral_freqmhz=133.333333

processing_system7_v5_5_processing_system7/1
c_dm_width=4 | c_dq_width=32 | c_dqs_width=4 | c_emio_gpio_width=2
c_en_emio_enet0=0 | c_en_emio_enet1=0 | c_en_emio_pjtag=0 | c_en_emio_trace=0
c_fclk_clk0_buf=true | c_fclk_clk1_buf=false | c_fclk_clk2_buf=false | c_fclk_clk3_buf=false
c_include_acp_trans_check=0 | c_include_trace_buffer=0 | c_irq_f2p_mode=DIRECT | c_m_axi_gp0_enable_static_remap=0
c_m_axi_gp0_id_width=12 | c_m_axi_gp0_thread_id_width=12 | c_m_axi_gp1_enable_static_remap=0 | c_m_axi_gp1_id_width=12
c_m_axi_gp1_thread_id_width=12 | c_mio_primitive=54 | c_num_f2p_intr_inputs=1 | c_package_name=clg484
c_ps7_si_rev=PRODUCTION | c_s_axi_acp_aruser_val=31 | c_s_axi_acp_awuser_val=31 | c_s_axi_acp_id_width=3
c_s_axi_gp0_id_width=6 | c_s_axi_gp1_id_width=6 | c_s_axi_hp0_data_width=64 | c_s_axi_hp0_id_width=6
c_s_axi_hp1_data_width=64 | c_s_axi_hp1_id_width=6 | c_s_axi_hp2_data_width=64 | c_s_axi_hp2_id_width=6
c_s_axi_hp3_data_width=64 | c_s_axi_hp3_id_width=6 | c_trace_buffer_clock_delay=12 | c_trace_buffer_fifo_size=128
c_trace_internal_width=2 | c_trace_pipeline_width=8 | c_use_axi_nonsecure=0 | c_use_default_acp_user_val=0
c_use_m_axi_gp0=1 | c_use_m_axi_gp1=0 | c_use_s_axi_acp=0 | c_use_s_axi_gp0=0
c_use_s_axi_hp0=0 | c_use_s_axi_hp1=0 | c_use_s_axi_hp2=0 | c_use_s_axi_hp3=0
core_container=NA | iptotal=1 | use_trace_data_edge_detector=0 | x_ipcorerevision=3
x_iplanguage=VERILOG | x_iplibrary=ip | x_ipname=processing_system7 | x_ipproduct=Vivado 2016.2
x_ipsimlanguage=MIXED | x_ipvendor=xilinx.com | x_ipversion=5.5

report_drc

command_line_options
-append=default::[not_specified] | -checks=default::[not_specified] | -fail_on=default::[not_specified] | -force=default::[not_specified]
-format=default::[not_specified] | -messages=default::[not_specified] | -name=default::[not_specified] | -return_string=default::[not_specified]

-ruledecks=default::[not_specified]

results
dpip-1=5 | dpop-1=5 | dpop-2=2 | pdrc-153=4

plio-7=1

report_power

command_line_options
-advisory=default::[not_specified] | -append=default::[not_specified] | -file=[specified] | -format=default::text
-hier=default::power | -l=default::[not_specified] | -name=default::[not_specified] | -no_propagation=default::[not_specified]
-return_string=default::[not_specified] | -rpx=[specified] | -verbose=default::[not_specified] | -vid=default::[not_specified]

-xpe=default::[not_specified]

usage
airflow=250 (LFM) | ambient_temp=25.0 (C) | bi-dir_toggle=12.500000 | bidir_output_enable=1.000000
board_layers=8to11 (8 to 11 Layers) | board_selection=medium (10"x10") | bram=0.006577 | clocks=0.025822
confidence_level_clock_activity=High | confidence_level_design_state=High | confidence_level_device_models=High | confidence_level_internal_activity=Medium
confidence_level_io_activity=Low | confidence_level_overall=Low | customer=TBD | customer_class=TBD
devstatic=0.174640 | die=xc7z020clg484-1 | dsp=0.001818 | dsp_output_toggle=12.500000
dynamic=1.681975 | effective_thetaja=11.5 | enable_probability=0.990000 | family=zynq
ff_toggle=12.500000 | flow_state=routed | heatsink=none | i/o=0.016043
input_toggle=12.500000 | junction_temp=46.4 (C) | logic=0.010853 | mgtavcc_dynamic_current=0.000000
mgtavcc_static_current=0.000000 | mgtavcc_total_current=0.000000 | mgtavcc_voltage=1.000000 | mgtavtt_dynamic_current=0.000000
mgtavtt_static_current=0.000000 | mgtavtt_total_current=0.000000 | mgtavtt_voltage=1.200000 | mgtvccaux_dynamic_current=0.000000
mgtvccaux_static_current=0.000000 | mgtvccaux_total_current=0.000000 | mgtvccaux_voltage=1.800000 | mmcm=0.084995
netlist_net_matched=NA | off-chip_power=0.000000 | on-chip_power=1.856615 | output_enable=1.000000
output_load=5.000000 | output_toggle=12.500000 | package=clg484 | pct_clock_constrained=3.000000
pct_inputs_defined=3 | platform=nt64 | process=typical | ps7=1.523685
ram_enable=50.000000 | ram_write=50.000000 | read_saif=False | set/reset_probability=0.000000
signal_rate=False | signals=0.023186 | simulation_file=None | speedgrade=-1
static_prob=False | temp_grade=commercial | thetajb=7.4 (C/W) | thetasa=0.0 (C/W)
toggle_rate=False | user_board_temp=25.0 (C) | user_effective_thetaja=11.5 | user_junc_temp=46.4 (C)
user_thetajb=7.4 (C/W) | user_thetasa=0.0 (C/W) | vccadc_dynamic_current=0.000000 | vccadc_static_current=0.020000
vccadc_total_current=0.020000 | vccadc_voltage=1.800000 | vccaux_dynamic_current=0.047508 | vccaux_io_dynamic_current=0.000000
vccaux_io_static_current=0.000000 | vccaux_io_total_current=0.000000 | vccaux_io_voltage=1.800000 | vccaux_static_current=0.020821
vccaux_total_current=0.068329 | vccaux_voltage=1.800000 | vccbram_dynamic_current=0.000483 | vccbram_static_current=0.009793
vccbram_total_current=0.010276 | vccbram_voltage=1.000000 | vccint_dynamic_current=0.057425 | vccint_static_current=0.020676
vccint_total_current=0.078101 | vccint_voltage=1.000000 | vcco12_dynamic_current=0.000000 | vcco12_static_current=0.000000
vcco12_total_current=0.000000 | vcco12_voltage=1.200000 | vcco135_dynamic_current=0.000000 | vcco135_static_current=0.000000
vcco135_total_current=0.000000 | vcco135_voltage=1.350000 | vcco15_dynamic_current=0.000000 | vcco15_static_current=0.001000
vcco15_total_current=0.001000 | vcco15_voltage=1.500000 | vcco18_dynamic_current=0.000000 | vcco18_static_current=0.001000
vcco18_total_current=0.001000 | vcco18_voltage=1.800000 | vcco25_dynamic_current=0.000000 | vcco25_static_current=0.000000
vcco25_total_current=0.000000 | vcco25_voltage=2.500000 | vcco33_dynamic_current=0.004505 | vcco33_static_current=0.001000
vcco33_total_current=0.005505 | vcco33_voltage=3.300000 | vcco_ddr_dynamic_current=0.456904 | vcco_ddr_static_current=0.002000
vcco_ddr_total_current=0.458904 | vcco_ddr_voltage=1.500000 | vcco_mio0_dynamic_current=0.001500 | vcco_mio0_static_current=0.001000
vcco_mio0_total_current=0.002500 | vcco_mio0_voltage=3.300000 | vcco_mio1_dynamic_current=0.000047 | vcco_mio1_static_current=0.001000
vcco_mio1_total_current=0.001048 | vcco_mio1_voltage=1.800000 | vccpaux_dynamic_current=0.050455 | vccpaux_static_current=0.010330
vccpaux_total_current=0.060785 | vccpaux_voltage=1.800000 | vccpint_dynamic_current=0.717496 | vccpint_static_current=0.031999
vccpint_total_current=0.749495 | vccpint_voltage=1.000000 | vccpll_dynamic_current=0.013878 | vccpll_static_current=0.003000
vccpll_total_current=0.016878 | vccpll_voltage=1.800000 | version=2016.2

report_utilization

clocking
bufgctrl_available=32 | bufgctrl_fixed=0 | bufgctrl_used=6 | bufgctrl_util_percentage=18.75
bufhce_available=72 | bufhce_fixed=0 | bufhce_used=0 | bufhce_util_percentage=0.00
bufio_available=16 | bufio_fixed=0 | bufio_used=0 | bufio_util_percentage=0.00
bufmrce_available=8 | bufmrce_fixed=0 | bufmrce_used=0 | bufmrce_util_percentage=0.00
bufr_available=16 | bufr_fixed=0 | bufr_used=0 | bufr_util_percentage=0.00
mmcme2_adv_available=4 | mmcme2_adv_fixed=0 | mmcme2_adv_used=1 | mmcme2_adv_util_percentage=25.00
plle2_adv_available=4 | plle2_adv_fixed=0 | plle2_adv_used=0 | plle2_adv_util_percentage=0.00

dsp
dsp48e1_only_used=9 | dsps_available=220 | dsps_fixed=0 | dsps_used=9

dsps_util_percentage=4.09

io_standard
blvds_25=0 | diff_hstl_i=0 | diff_hstl_i_18=0 | diff_hstl_ii=0
diff_hstl_ii_18=0 | diff_hsul_12=0 | diff_mobile_ddr=0 | diff_sstl135=0
diff_sstl135_r=0 | diff_sstl15=1 | diff_sstl15_r=0 | diff_sstl18_i=0
diff_sstl18_ii=0 | hstl_i=0 | hstl_i_18=0 | hstl_ii=0
hstl_ii_18=0 | hsul_12=0 | lvcmos12=0 | lvcmos15=0
lvcmos18=1 | lvcmos25=0 | lvcmos33=1 | lvds_25=0
lvttl=0 | mini_lvds_25=0 | mobile_ddr=0 | pci33_3=0
ppds_25=0 | rsds_25=0 | sstl135=0 | sstl135_r=0
sstl15=1 | sstl15_r=0 | sstl18_i=0 | sstl18_ii=0

tmds_33=0

memory
block_ram_tile_available=140 | block_ram_tile_fixed=0 | block_ram_tile_used=130.5 | block_ram_tile_util_percentage=93.21
ramb18_available=280 | ramb18_fixed=0 | ramb18_used=3 | ramb18_util_percentage=1.07
ramb18e1_only_used=3 | ramb36_fifo_available=140 | ramb36_fifo_fixed=0 | ramb36_fifo_used=129
ramb36_fifo_util_percentage=92.14 | ramb36e1_only_used=129

primitives
bibuf_functional_category=IO | bibuf_used=130 | bufg_functional_category=Clock | bufg_used=6
carry4_functional_category=CarryLogic | carry4_used=216 | dsp48e1_functional_category=Block Arithmetic | dsp48e1_used=9
fdce_functional_category=Flop & Latch | fdce_used=1 | fdre_functional_category=Flop & Latch | fdre_used=1636
fdse_functional_category=Flop & Latch | fdse_used=54 | ibuf_functional_category=IO | ibuf_used=26
ldce_functional_category=Flop & Latch | ldce_used=48 | ldpe_functional_category=Flop & Latch | ldpe_used=3
lut1_functional_category=LUT | lut1_used=48 | lut2_functional_category=LUT | lut2_used=579
lut3_functional_category=LUT | lut3_used=491 | lut4_functional_category=LUT | lut4_used=560
lut5_functional_category=LUT | lut5_used=410 | lut6_functional_category=LUT | lut6_used=1076
mmcme2_adv_functional_category=Clock | mmcme2_adv_used=1 | muxf7_functional_category=MuxFx | muxf7_used=165
muxf8_functional_category=MuxFx | muxf8_used=38 | obuf_functional_category=IO | obuf_used=32
obuft_functional_category=IO | obuft_used=6 | ps7_functional_category=Specialized Resource | ps7_used=1
ramb18e1_functional_category=Block Memory | ramb18e1_used=3 | ramb36e1_functional_category=Block Memory | ramb36e1_used=129
ramd32_functional_category=Distributed Memory | ramd32_used=84 | rams32_functional_category=Distributed Memory | rams32_used=140
srl16e_functional_category=Distributed Memory | srl16e_used=23 | srlc32e_functional_category=Distributed Memory | srlc32e_used=47

slice_logic
f7_muxes_available=26600 | f7_muxes_fixed=0 | f7_muxes_used=165 | f7_muxes_util_percentage=0.62
f8_muxes_available=13300 | f8_muxes_fixed=0 | f8_muxes_used=38 | f8_muxes_util_percentage=0.29
lut_as_distributed_ram_fixed=0 | lut_as_distributed_ram_used=168 | lut_as_logic_available=53200 | lut_as_logic_fixed=0
lut_as_logic_used=2568 | lut_as_logic_util_percentage=4.83 | lut_as_memory_available=17400 | lut_as_memory_fixed=0
lut_as_memory_used=236 | lut_as_memory_util_percentage=1.36 | lut_as_shift_register_fixed=0 | lut_as_shift_register_used=68
register_as_flip_flop_available=106400 | register_as_flip_flop_fixed=0 | register_as_flip_flop_used=1691 | register_as_flip_flop_util_percentage=1.59
register_as_latch_available=106400 | register_as_latch_fixed=0 | register_as_latch_used=51 | register_as_latch_util_percentage=0.05
slice_luts_available=53200 | slice_luts_fixed=0 | slice_luts_used=2804 | slice_luts_util_percentage=5.27
slice_registers_available=106400 | slice_registers_fixed=0 | slice_registers_used=1742 | slice_registers_util_percentage=1.64
fully_used_lut_ff_pairs_fixed=1.64 | fully_used_lut_ff_pairs_used=99 | lut_as_distributed_ram_fixed=0 | lut_as_distributed_ram_used=168
lut_as_logic_available=53200 | lut_as_logic_fixed=0 | lut_as_logic_used=2568 | lut_as_logic_util_percentage=4.83
lut_as_memory_available=17400 | lut_as_memory_fixed=0 | lut_as_memory_used=236 | lut_as_memory_util_percentage=1.36
lut_as_shift_register_fixed=0 | lut_as_shift_register_used=68 | lut_ff_pairs_with_one_unused_flip_flop_fixed=68 | lut_ff_pairs_with_one_unused_flip_flop_used=608
lut_ff_pairs_with_one_unused_lut_fixed=608 | lut_ff_pairs_with_one_unused_lut_used=446 | lut_flip_flop_pairs_available=53200 | lut_flip_flop_pairs_fixed=0
lut_flip_flop_pairs_used=747 | lut_flip_flop_pairs_util_percentage=1.40 | slice_available=13300 | slice_fixed=0
slice_used=1214 | slice_util_percentage=9.13 | slicel_fixed=0 | slicel_used=704
slicem_fixed=0 | slicem_used=510 | unique_control_sets_used=106 | using_o5_and_o6_fixed=106
using_o5_and_o6_used=2 | using_o5_output_only_fixed=2 | using_o5_output_only_used=0 | using_o6_output_only_fixed=0

using_o6_output_only_used=66

specific_feature
bscane2_available=4 | bscane2_fixed=0 | bscane2_used=0 | bscane2_util_percentage=0.00
capturee2_available=1 | capturee2_fixed=0 | capturee2_used=0 | capturee2_util_percentage=0.00
dna_port_available=1 | dna_port_fixed=0 | dna_port_used=0 | dna_port_util_percentage=0.00
efuse_usr_available=1 | efuse_usr_fixed=0 | efuse_usr_used=0 | efuse_usr_util_percentage=0.00
frame_ecce2_available=1 | frame_ecce2_fixed=0 | frame_ecce2_used=0 | frame_ecce2_util_percentage=0.00
icape2_available=2 | icape2_fixed=0 | icape2_used=0 | icape2_util_percentage=0.00
startupe2_available=1 | startupe2_fixed=0 | startupe2_used=0 | startupe2_util_percentage=0.00
xadc_available=1 | xadc_fixed=0 | xadc_used=0 | xadc_util_percentage=0.00

router

usage
actual_expansions=8589816 | bogomips=0 | bram18=3 | bram36=129
bufg=0 | bufr=0 | congestion_level=0 | ctrls=106
dsp=9 | effort=2 | estimated_expansions=9554544 | ff=1742
global_clocks=6 | high_fanout_nets=5 | iob=58 | lut=2923
movable_instances=6362 | nets=9753 | pins=70137 | pll=0
router_runtime=58.256000 | router_timing_driven=1 | threads=2 | timing_constraints_exist=1

synthesis

command_line_options
-assert=default::[not_specified] | -bufg=default::12 | -cascade_dsp=default::auto | -constrset=default::[not_specified]
-control_set_opt_threshold=default::auto | -directive=default::default | -fanout_limit=default::10000 | -flatten_hierarchy=default::rebuilt
-fsm_extraction=default::auto | -gated_clock_conversion=default::off | -generic=default::[not_specified] | -include_dirs=default::[not_specified]
-keep_equivalent_registers=default::[not_specified] | -max_bram=default::-1 | -max_bram_cascade_height=default::-1 | -max_dsp=default::-1
-max_uram=default::-1 | -max_uram_cascade_height=default::-1 | -mode=default::default | -name=default::[not_specified]
-no_lc=default::[not_specified] | -no_srlextract=default::[not_specified] | -no_timing_driven=default::[not_specified] | -part=xc7z020clg484-1
-resource_sharing=default::auto | -retiming=default::[not_specified] | -rtl=default::[not_specified] | -rtl_skip_constraints=default::[not_specified]
-rtl_skip_ip=default::[not_specified] | -seu_protect=default::none | -shreg_min_size=default::3 | -top=design_1_wrapper

-verilog_define=default::[not_specified]

usage
elapsed=00:00:27s | hls_ip=0 | memory_gain=382.375MB | memory_peak=588.730MB
