glgauthier/MQP/IMU/IMU.runs/impl_1/usage_statistics_webtalk.html

### Device Usage Page (usage_statistics_webtalk.html)

This HTML page displays the device usage statistics that will be sent to Xilinx.
To see the actual file transmitted to Xilinx, please click here.

software_version_and_target_device
beta | FALSE | build_version | 1577090
date_generated | Thu Dec 15 01:50:38 2016 | os_platform | WIN64
product_version | Vivado v2016.2 (64-bit) | project_id | c0de2ecc72104cb88476ff55b44edbe8
project_iteration | 42 | random_id | 42a33766ecc3594d8d300fc75934d3ae
registration_id | 211146563_0_0_943 | route_design | TRUE
target_device | xc7z020 | target_family | zynq
target_package | clg484 | target_speed | -1
tool_flow | Vivado

user_environment
cpu_name | Intel(R) Core(TM) i7-6820HQ CPU @ 2.70GHz | cpu_speed | 2712 MHz
os_name | Microsoft Windows 8 or later , 64-bit | os_release | major release (build 9200)
system_ram | 34.000 GB | total_processors | 1

vivado_usage

other_data

guimode=35

project_data
board=ZedBoard Zynq Evaluation and Development Kit | constraintsetcount=1 | core_container=false | currentimplrun=impl_1
currentsynthesisrun=synth_1 | default_library=xil_defaultlib | designmode=RTL | export_simulation_activehdl=49
export_simulation_ies=49 | export_simulation_modelsim=49 | export_simulation_questa=49 | export_simulation_riviera=49
export_simulation_vcs=49 | export_simulation_xsim=49 | implstrategy=Vivado Implementation Defaults | launch_simulation_activehdl=0
launch_simulation_ies=0 | launch_simulation_modelsim=0 | launch_simulation_questa=0 | launch_simulation_riviera=0
launch_simulation_vcs=0 | launch_simulation_xsim=0 | simulator_language=Mixed | srcsetcount=1
synthesisstrategy=Vivado Synthesis Defaults | target_language=Verilog | target_simulator=XSim | totalimplruns=7

totalsynthesisruns=7

unisim_transformation

post_unisim_transformation
bufg=3 | carry4=524 | dsp48e1=3 | fdce=10
fdre=4681 | fdse=4 | gnd=1026 | ibuf=4
ldce=1 | lut1=200 | lut2=293 | lut3=1649
lut4=70 | lut5=22 | lut6=38 | mmcme2_adv=1
obuf=13 | srl16e=10 | srlc32e=6 | vcc=472

pre_unisim_transformation
bufg=3 | carry4=524 | dsp48e1=3 | fdce=10
fdre=4681 | fdse=4 | gnd=1026 | ibuf=4
ldce=1 | lut1=200 | lut2=293 | lut3=1649
lut4=70 | lut5=22 | lut6=38 | mmcme2_adv=1
obuf=13 | srl16e=10 | srlc32e=6 | vcc=472

ip_statistics

c_addsub_v12_0_9/1
c_a_type=0 | c_a_width=16 | c_add_mode=1 | c_ainit_val=0
c_b_constant=0 | c_b_type=0 | c_b_value=0000000000000000 | c_b_width=16
c_borrow_low=1 | c_bypass_low=0 | c_ce_overrides_bypass=1 | c_ce_overrides_sclr=0
c_has_bypass=0 | c_has_c_in=0 | c_has_c_out=0 | c_has_ce=0
c_has_sclr=0 | c_has_sinit=0 | c_has_sset=0 | c_implementation=1
c_latency=2 | c_out_width=16 | c_sclr_overrides_sset=1 | c_sinit_val=0
c_verbosity=0 | c_xdevicefamily=zynq | core_container=false | iptotal=2
x_ipcorerevision=9 | x_iplanguage=VERILOG | x_iplibrary=ip | x_ipname=c_addsub
x_ipproduct=Vivado 2016.2 | x_ipsimlanguage=MIXED | x_ipvendor=xilinx.com | x_ipversion=12.0

clk_wiz_v5_3_1/1
clkin1_period=10.0 | clkin2_period=10.0 | clock_mgr_type=NA | component_name=clk_wiz_0
core_container=false | enable_axi=0 | feedback_source=FDBK_AUTO | feedback_type=SINGLE
iptotal=1 | manual_override=false | num_out_clk=2 | primitive=MMCM
use_dyn_phase_shift=false | use_dyn_reconfig=false | use_inclk_stopped=false | use_inclk_switchover=false
use_locked=true | use_max_i_jitter=false | use_min_o_jitter=false | use_phase_alignment=true
use_power_down=false | use_reset=true

cordic_v6_0_10/1
c_architecture=2 | c_coarse_rotate=1 | c_cordic_function=3 | c_data_format=0
c_has_aclk=1 | c_has_aclken=0 | c_has_aresetn=0 | c_has_s_axis_cartesian=1
c_has_s_axis_cartesian_tlast=0 | c_has_s_axis_cartesian_tuser=0 | c_has_s_axis_phase=0 | c_has_s_axis_phase_tlast=0
c_has_s_axis_phase_tuser=0 | c_input_width=18 | c_iterations=0 | c_m_axis_dout_tdata_width=16
c_m_axis_dout_tuser_width=1 | c_output_width=11 | c_phase_format=1 | c_pipeline_mode=-2
c_precision=0 | c_round_mode=2 | c_s_axis_cartesian_tdata_width=48 | c_s_axis_cartesian_tuser_width=1
c_s_axis_phase_tdata_width=24 | c_s_axis_phase_tuser_width=1 | c_scale_comp=0 | c_throttle_scheme=3
c_tlast_resolution=0 | c_xdevicefamily=zynq | core_container=false | iptotal=1
x_ipcorerevision=10 | x_iplanguage=VERILOG | x_iplibrary=ip | x_ipname=cordic
x_ipproduct=Vivado 2016.2 | x_ipsimlanguage=MIXED | x_ipvendor=xilinx.com | x_ipversion=6.0

div_gen_v5_1_10/1
algorithm_type=1 | c_has_aclken=0 | c_has_aresetn=0 | c_has_div_by_zero=0
c_has_s_axis_dividend_tlast=0 | c_has_s_axis_dividend_tuser=0 | c_has_s_axis_divisor_tlast=0 | c_has_s_axis_divisor_tuser=0
c_latency=36 | c_m_axis_dout_tdata_width=32 | c_m_axis_dout_tuser_width=1 | c_s_axis_dividend_tdata_width=16
c_s_axis_dividend_tuser_width=1 | c_s_axis_divisor_tdata_width=24 | c_s_axis_divisor_tuser_width=1 | c_throttle_scheme=3
c_tlast_resolution=0 | c_xdevicefamily=zynq | core_container=false | divclk_sel=1
dividend_width=16 | divisor_width=17 | fractional_b=1 | fractional_width=16
iptotal=2 | signed_b=1 | x_ipcorerevision=10 | x_iplanguage=VERILOG
x_iplibrary=ip | x_ipname=div_gen | x_ipproduct=Vivado 2016.2 | x_ipsimlanguage=MIXED
x_ipvendor=xilinx.com | x_ipversion=5.1

mult_gen_v12_0_11/1
c_a_type=1 | c_a_width=9 | c_b_type=1 | c_b_value=10110100
c_b_width=8 | c_ccm_imp=2 | c_ce_overrides_sclr=0 | c_has_ce=0
c_has_sclr=0 | c_has_zero_detect=0 | c_latency=3 | c_model_type=0
c_mult_type=2 | c_optimize_goal=1 | c_out_high=16 | c_out_low=0
c_round_output=0 | c_round_pt=0 | c_verbosity=0 | c_xdevicefamily=zynq
core_container=false | iptotal=1 | x_ipcorerevision=11 | x_iplanguage=VERILOG
x_iplibrary=ip | x_ipname=mult_gen | x_ipproduct=Vivado 2016.2 | x_ipsimlanguage=MIXED
x_ipvendor=xilinx.com | x_ipversion=12.0

report_drc

command_line_options
-append=default::[not_specified] | -checks=default::[not_specified] | -fail_on=default::[not_specified] | -force=default::[not_specified]
-format=default::[not_specified] | -messages=default::[not_specified] | -name=default::[not_specified] | -return_string=default::[not_specified]

-ruledecks=default::[not_specified]

results
aval-4=2 | aval-5=2 | pdrc-153=1 | zps7-1=1

report_power

command_line_options
-advisory=default::[not_specified] | -append=default::[not_specified] | -file=[specified] | -format=default::text
-hier=default::power | -l=default::[not_specified] | -name=default::[not_specified] | -no_propagation=default::[not_specified]
-return_string=default::[not_specified] | -rpx=[specified] | -verbose=default::[not_specified] | -vid=default::[not_specified]

-xpe=default::[not_specified]

usage
airflow=250 (LFM) | ambient_temp=25.0 (C) | bi-dir_toggle=12.500000 | bidir_output_enable=1.000000
board_layers=8to11 (8 to 11 Layers) | board_selection=medium (10"x10") | clocks=0.026801 | confidence_level_clock_activity=High
confidence_level_design_state=High | confidence_level_device_models=High | confidence_level_internal_activity=Medium | confidence_level_io_activity=Medium
confidence_level_overall=Medium | customer=TBD | customer_class=TBD | devstatic=0.123273
die=xc7z020clg484-1 | dsp=0.000842 | dsp_output_toggle=12.500000 | dynamic=0.161185
effective_thetaja=11.5 | enable_probability=0.990000 | family=zynq | ff_toggle=12.500000
flow_state=routed | heatsink=none | i/o=0.005492 | input_toggle=12.500000
junction_temp=28.3 (C) | logic=0.021234 | mgtavcc_dynamic_current=0.000000 | mgtavcc_static_current=0.000000
mgtavcc_total_current=0.000000 | mgtavcc_voltage=1.000000 | mgtavtt_dynamic_current=0.000000 | mgtavtt_static_current=0.000000
mgtavtt_total_current=0.000000 | mgtavtt_voltage=1.200000 | mgtvccaux_dynamic_current=0.000000 | mgtvccaux_static_current=0.000000
mgtvccaux_total_current=0.000000 | mgtvccaux_voltage=1.800000 | mmcm=0.100629 | netlist_net_matched=NA
off-chip_power=0.000000 | on-chip_power=0.284458 | output_enable=1.000000 | output_load=5.000000
output_toggle=12.500000 | package=clg484 | pct_clock_constrained=2.000000 | pct_inputs_defined=25
platform=nt64 | process=typical | ram_enable=50.000000 | ram_write=50.000000
read_saif=False | set/reset_probability=0.000000 | signal_rate=False | signals=0.019588
simulation_file=None | speedgrade=-1 | static_prob=False | temp_grade=commercial
thetajb=7.4 (C/W) | thetasa=0.0 (C/W) | toggle_rate=False | user_board_temp=25.0 (C)
user_effective_thetaja=11.5 | user_junc_temp=28.3 (C) | user_thetajb=7.4 (C/W) | user_thetasa=0.0 (C/W)
vccadc_dynamic_current=0.000000 | vccadc_static_current=0.020000 | vccadc_total_current=0.020000 | vccadc_voltage=1.800000
vccaux_dynamic_current=0.055861 | vccaux_io_dynamic_current=0.000000 | vccaux_io_static_current=0.000000 | vccaux_io_total_current=0.000000
vccaux_io_voltage=1.800000 | vccaux_static_current=0.018912 | vccaux_total_current=0.074773 | vccaux_voltage=1.800000
vccbram_dynamic_current=0.000000 | vccbram_static_current=0.000475 | vccbram_total_current=0.000475 | vccbram_voltage=1.000000
vccint_dynamic_current=0.055570 | vccint_static_current=0.007999 | vccint_total_current=0.063569 | vccint_voltage=1.000000
vcco12_dynamic_current=0.000000 | vcco12_static_current=0.000000 | vcco12_total_current=0.000000 | vcco12_voltage=1.200000
vcco135_dynamic_current=0.000000 | vcco135_static_current=0.000000 | vcco135_total_current=0.000000 | vcco135_voltage=1.350000
vcco15_dynamic_current=0.000000 | vcco15_static_current=0.000000 | vcco15_total_current=0.000000 | vcco15_voltage=1.500000
vcco18_dynamic_current=0.000000 | vcco18_static_current=0.000000 | vcco18_total_current=0.000000 | vcco18_voltage=1.800000
vcco25_dynamic_current=0.000000 | vcco25_static_current=0.000000 | vcco25_total_current=0.000000 | vcco25_voltage=2.500000
vcco33_dynamic_current=0.001535 | vcco33_static_current=0.001000 | vcco33_total_current=0.002535 | vcco33_voltage=3.300000
vcco_ddr_dynamic_current=0.000000 | vcco_ddr_static_current=0.000000 | vcco_ddr_total_current=0.000000 | vcco_ddr_voltage=1.500000
vcco_mio0_dynamic_current=0.000000 | vcco_mio0_static_current=0.000000 | vcco_mio0_total_current=0.000000 | vcco_mio0_voltage=1.800000
vcco_mio1_dynamic_current=0.000000 | vcco_mio1_static_current=0.000000 | vcco_mio1_total_current=0.000000 | vcco_mio1_voltage=1.800000
vccpaux_dynamic_current=0.000000 | vccpaux_static_current=0.010330 | vccpaux_total_current=0.010330 | vccpaux_voltage=1.800000
vccpint_dynamic_current=0.000000 | vccpint_static_current=0.017463 | vccpint_total_current=0.017463 | vccpint_voltage=1.000000
vccpll_dynamic_current=0.000000 | vccpll_static_current=0.003000 | vccpll_total_current=0.003000 | vccpll_voltage=1.800000

version=2016.2

report_utilization

clocking
bufgctrl_available=32 | bufgctrl_fixed=0 | bufgctrl_used=3 | bufgctrl_util_percentage=9.38
bufhce_available=72 | bufhce_fixed=0 | bufhce_used=0 | bufhce_util_percentage=0.00
bufio_available=16 | bufio_fixed=0 | bufio_used=0 | bufio_util_percentage=0.00
bufmrce_available=8 | bufmrce_fixed=0 | bufmrce_used=0 | bufmrce_util_percentage=0.00
bufr_available=16 | bufr_fixed=0 | bufr_used=0 | bufr_util_percentage=0.00
mmcme2_adv_available=4 | mmcme2_adv_fixed=0 | mmcme2_adv_used=1 | mmcme2_adv_util_percentage=25.00
plle2_adv_available=4 | plle2_adv_fixed=0 | plle2_adv_used=0 | plle2_adv_util_percentage=0.00

dsp
dsp48e1_only_used=3 | dsps_available=220 | dsps_fixed=0 | dsps_used=3

dsps_util_percentage=1.36

io_standard
blvds_25=0 | diff_hstl_i=0 | diff_hstl_i_18=0 | diff_hstl_ii=0
diff_hstl_ii_18=0 | diff_hsul_12=0 | diff_mobile_ddr=0 | diff_sstl135=0
diff_sstl135_r=0 | diff_sstl15=0 | diff_sstl15_r=0 | diff_sstl18_i=0
diff_sstl18_ii=0 | hstl_i=0 | hstl_i_18=0 | hstl_ii=0
hstl_ii_18=0 | hsul_12=0 | lvcmos12=0 | lvcmos15=0
lvcmos18=0 | lvcmos25=0 | lvcmos33=1 | lvds_25=0
lvttl=0 | mini_lvds_25=0 | mobile_ddr=0 | pci33_3=0
ppds_25=0 | rsds_25=0 | sstl135=0 | sstl135_r=0
sstl15=0 | sstl15_r=0 | sstl18_i=0 | sstl18_ii=0

tmds_33=0

memory
block_ram_tile_available=140 | block_ram_tile_fixed=0 | block_ram_tile_used=0 | block_ram_tile_util_percentage=0.00
ramb18_available=280 | ramb18_fixed=0 | ramb18_used=0 | ramb18_util_percentage=0.00
ramb36_fifo_available=140 | ramb36_fifo_fixed=0 | ramb36_fifo_used=0 | ramb36_fifo_util_percentage=0.00

primitives
bufg_functional_category=Clock | bufg_used=3 | carry4_functional_category=CarryLogic | carry4_used=487
dsp48e1_functional_category=Block Arithmetic | dsp48e1_used=3 | fdce_functional_category=Flop & Latch | fdce_used=10
fdre_functional_category=Flop & Latch | fdre_used=3272 | fdse_functional_category=Flop & Latch | fdse_used=4
ibuf_functional_category=IO | ibuf_used=4 | ldce_functional_category=Flop & Latch | ldce_used=1
lut1_functional_category=LUT | lut1_used=147 | lut2_functional_category=LUT | lut2_used=1255
lut3_functional_category=LUT | lut3_used=460 | lut4_functional_category=LUT | lut4_used=70
lut5_functional_category=LUT | lut5_used=22 | lut6_functional_category=LUT | lut6_used=38
mmcme2_adv_functional_category=Clock | mmcme2_adv_used=1 | obuf_functional_category=IO | obuf_used=13
srl16e_functional_category=Distributed Memory | srl16e_used=7 | srlc32e_functional_category=Distributed Memory | srlc32e_used=4

slice_logic
f7_muxes_available=26600 | f7_muxes_fixed=0 | f7_muxes_used=0 | f7_muxes_util_percentage=0.00
f8_muxes_available=13300 | f8_muxes_fixed=0 | f8_muxes_used=0 | f8_muxes_util_percentage=0.00
lut_as_distributed_ram_fixed=0 | lut_as_distributed_ram_used=0 | lut_as_logic_available=53200 | lut_as_logic_fixed=0
lut_as_logic_used=1937 | lut_as_logic_util_percentage=3.64 | lut_as_memory_available=17400 | lut_as_memory_fixed=0
lut_as_memory_used=11 | lut_as_memory_util_percentage=0.06 | lut_as_shift_register_fixed=0 | lut_as_shift_register_used=11
register_as_flip_flop_available=106400 | register_as_flip_flop_fixed=0 | register_as_flip_flop_used=3286 | register_as_flip_flop_util_percentage=3.09
register_as_latch_available=106400 | register_as_latch_fixed=0 | register_as_latch_used=1 | register_as_latch_util_percentage=<0.01
slice_luts_available=53200 | slice_luts_fixed=0 | slice_luts_used=1948 | slice_luts_util_percentage=3.66
slice_registers_available=106400 | slice_registers_fixed=0 | slice_registers_used=3287 | slice_registers_util_percentage=3.09
fully_used_lut_ff_pairs_fixed=3.09 | fully_used_lut_ff_pairs_used=22 | lut_as_distributed_ram_fixed=0 | lut_as_distributed_ram_used=0
lut_as_logic_available=53200 | lut_as_logic_fixed=0 | lut_as_logic_used=1937 | lut_as_logic_util_percentage=3.64
lut_as_memory_available=17400 | lut_as_memory_fixed=0 | lut_as_memory_used=11 | lut_as_memory_util_percentage=0.06
lut_as_shift_register_fixed=0 | lut_as_shift_register_used=11 | lut_ff_pairs_with_one_unused_flip_flop_fixed=11 | lut_ff_pairs_with_one_unused_flip_flop_used=1035
lut_ff_pairs_with_one_unused_lut_fixed=1035 | lut_ff_pairs_with_one_unused_lut_used=1629 | lut_flip_flop_pairs_available=53200 | lut_flip_flop_pairs_fixed=0
lut_flip_flop_pairs_used=1655 | lut_flip_flop_pairs_util_percentage=3.11 | slice_available=13300 | slice_fixed=0
slice_used=757 | slice_util_percentage=5.69 | slicel_fixed=0 | slicel_used=414
slicem_fixed=0 | slicem_used=343 | unique_control_sets_used=21 | using_o5_and_o6_fixed=21
using_o5_and_o6_used=0 | using_o5_output_only_fixed=0 | using_o5_output_only_used=4 | using_o6_output_only_fixed=4

using_o6_output_only_used=7

specific_feature
bscane2_available=4 | bscane2_fixed=0 | bscane2_used=0 | bscane2_util_percentage=0.00
capturee2_available=1 | capturee2_fixed=0 | capturee2_used=0 | capturee2_util_percentage=0.00
dna_port_available=1 | dna_port_fixed=0 | dna_port_used=0 | dna_port_util_percentage=0.00
efuse_usr_available=1 | efuse_usr_fixed=0 | efuse_usr_used=0 | efuse_usr_util_percentage=0.00
frame_ecce2_available=1 | frame_ecce2_fixed=0 | frame_ecce2_used=0 | frame_ecce2_util_percentage=0.00
icape2_available=2 | icape2_fixed=0 | icape2_used=0 | icape2_util_percentage=0.00
startupe2_available=1 | startupe2_fixed=0 | startupe2_used=0 | startupe2_util_percentage=0.00
xadc_available=1 | xadc_fixed=0 | xadc_used=0 | xadc_util_percentage=0.00

router

usage
actual_expansions=2824132 | bogomips=0 | bram18=0 | bram36=0
bufg=0 | bufr=0 | congestion_level=0 | ctrls=21
dsp=3 | effort=2 | estimated_expansions=2081310 | ff=3287
global_clocks=3 | high_fanout_nets=1 | iob=17 | lut=1981
movable_instances=6869 | nets=15424 | pins=34372 | pll=0
router_runtime=95.040000 | router_timing_driven=1 | threads=2 | timing_constraints_exist=1

synthesis

command_line_options
-assert=default::[not_specified] | -bufg=default::12 | -cascade_dsp=default::auto | -constrset=default::[not_specified]
-control_set_opt_threshold=default::auto | -directive=default::default | -fanout_limit=default::10000 | -flatten_hierarchy=default::rebuilt
-fsm_extraction=default::auto | -gated_clock_conversion=default::off | -generic=default::[not_specified] | -include_dirs=default::[not_specified]
-keep_equivalent_registers=default::[not_specified] | -max_bram=default::-1 | -max_bram_cascade_height=default::-1 | -max_dsp=default::-1
-max_uram=default::-1 | -max_uram_cascade_height=default::-1 | -mode=default::default | -name=default::[not_specified]
-no_lc=default::[not_specified] | -no_srlextract=default::[not_specified] | -no_timing_driven=default::[not_specified] | -part=xc7z020clg484-1
-resource_sharing=default::auto | -retiming=default::[not_specified] | -rtl=default::[not_specified] | -rtl_skip_constraints=default::[not_specified]
-rtl_skip_ip=default::[not_specified] | -seu_protect=default::none | -shreg_min_size=default::3 | -top=IMU_top

-verilog_define=default::[not_specified]

usage
elapsed=00:00:23s | hls_ip=0 | memory_gain=426.266MB | memory_peak=633.031MB
