glgauthier/MQP/ZedFinalCams/ZedFinalCams.runs/impl_1/usage_statistics_webtalk.html

### Device Usage Page (usage_statistics_webtalk.html)

This HTML page displays the device usage statistics that will be sent to Xilinx.
To see the actual file transmitted to Xilinx, please click here.

software_version_and_target_device
beta | FALSE | build_version | 1577090
date_generated | Tue Dec 13 21:06:41 2016 | os_platform | WIN64
product_version | Vivado v2016.2 (64-bit) | project_id | eeca8e73bcf04b1bb62e4eff5f08fb6c
project_iteration | 149 | random_id | 42a33766ecc3594d8d300fc75934d3ae
registration_id | 211146563_0_0_943 | route_design | TRUE
target_device | xc7z020 | target_family | zynq
target_package | clg484 | target_speed | -1
tool_flow | Vivado

user_environment
cpu_name | Intel(R) Core(TM) i7-6820HQ CPU @ 2.70GHz | cpu_speed | 2712 MHz
os_name | Microsoft Windows 8 or later , 64-bit | os_release | major release (build 9200)
system_ram | 34.000 GB | total_processors | 1

vivado_usage

other_data

guimode=57

project_data
board=ZedBoard Zynq Evaluation and Development Kit | constraintsetcount=1 | core_container=false | currentimplrun=impl_1
currentsynthesisrun=synth_1 | default_library=xil_defaultlib | designmode=RTL | export_simulation_activehdl=39
export_simulation_ies=39 | export_simulation_modelsim=39 | export_simulation_questa=39 | export_simulation_riviera=39
export_simulation_vcs=39 | export_simulation_xsim=39 | implstrategy=Vivado Implementation Defaults | launch_simulation_activehdl=0
launch_simulation_ies=0 | launch_simulation_modelsim=0 | launch_simulation_questa=0 | launch_simulation_riviera=0
launch_simulation_vcs=0 | launch_simulation_xsim=0 | simulator_language=Mixed | srcsetcount=7
synthesisstrategy=Vivado Synthesis Defaults | target_language=Verilog | target_simulator=XSim | totalimplruns=5

totalsynthesisruns=5

unisim_transformation

post_unisim_transformation
bufg=5 | carry4=114 | dsp48e1=5 | fdre=603
gnd=149 | ibuf=12 | ldce=2 | ldpe=3
lut1=31 | lut2=211 | lut3=258 | lut4=254
lut5=241 | lut6=939 | mmcme2_adv=1 | muxf7=168
muxf8=38 | obuf=22 | ramb18e1=1 | ramb36e1=129
ramd32=84 | rams32=140 | vcc=139

pre_unisim_transformation
bufg=5 | carry4=114 | dsp48e1=5 | fdre=603
gnd=149 | ibuf=12 | ldce=2 | ldpe=3
lut1=31 | lut2=211 | lut3=258 | lut4=254
lut5=241 | lut6=939 | mmcme2_adv=1 | muxf7=168
muxf8=38 | obuf=22 | ram32m=14 | ram32x1s=112
ramb18e1=1 | ramb36e1=129 | vcc=139

power_opt_design

command_line_options_spo
-cell_types=default::all | -clocks=default::[not_specified] | -exclude_cells=default::[not_specified] | -include_cells=default::[not_specified]

usage
bram_ports_augmented=0 | bram_ports_newly_gated=129 | bram_ports_total=260 | flow_state=default
slice_registers_augmented=0 | slice_registers_newly_gated=0 | slice_registers_total=603 | srls_augmented=0
srls_newly_gated=0 | srls_total=0

ip_statistics

blk_mem_gen_v8_3_3/1
c_addra_width=17 | c_addrb_width=17 | c_algorithm=1 | c_axi_id_width=4
c_axi_slave_type=0 | c_axi_type=1 | c_byte_size=9 | c_common_clk=0
c_count_18k_bram=0 | c_count_36k_bram=27 | c_ctrl_ecc_algo=NONE | c_default_data=0
c_disable_warn_bhv_coll=1 | c_disable_warn_bhv_range=1 | c_elaboration_dir=./ | c_en_deepsleep_pin=0
c_en_ecc_pipe=0 | c_en_rdaddra_chg=0 | c_en_rdaddrb_chg=0 | c_en_safety_ckt=0
c_en_shutdown_pin=0 | c_en_sleep_pin=0 | c_enable_32bit_address=0 | c_est_power_summary=Estimated Power for IP _ 4.53475 mW
c_family=zynq | c_has_axi_id=0 | c_has_ena=0 | c_has_enb=1
c_has_injecterr=0 | c_has_mem_output_regs_a=0 | c_has_mem_output_regs_b=1 | c_has_mux_output_regs_a=0
c_has_mux_output_regs_b=0 | c_has_regcea=0 | c_has_regceb=0 | c_has_rsta=0
c_has_rstb=0 | c_has_softecc_input_regs_a=0 | c_has_softecc_output_regs_b=0 | c_init_file=blk_mem_640_480.mem
c_init_file_name=no_coe_file_loaded | c_inita_val=0 | c_initb_val=0 | c_interface_type=0
c_load_init_file=0 | c_mem_type=1 | c_mux_pipeline_stages=0 | c_prim_type=1
c_read_depth_a=110592 | c_read_depth_b=110592 | c_read_width_a=8 | c_read_width_b=8
c_rst_priority_a=CE | c_rst_priority_b=CE | c_rstram_a=0 | c_rstram_b=0
c_sim_collision_check=ALL | c_use_bram_block=0 | c_use_byte_wea=0 | c_use_byte_web=0
c_use_default_data=0 | c_use_ecc=0 | c_use_softecc=0 | c_use_uram=0
c_wea_width=1 | c_web_width=1 | c_write_depth_a=110592 | c_write_depth_b=110592
c_write_mode_a=NO_CHANGE | c_write_mode_b=WRITE_FIRST | c_write_width_a=8 | c_write_width_b=8
c_xdevicefamily=zynq | core_container=false | iptotal=2 | x_ipcorerevision=3
x_iplanguage=VERILOG | x_iplibrary=ip | x_ipname=blk_mem_gen | x_ipproduct=Vivado 2016.2
x_ipsimlanguage=MIXED | x_ipvendor=xilinx.com | x_ipversion=8.3

blk_mem_gen_v8_3_3/2
c_addra_width=19 | c_addrb_width=19 | c_algorithm=1 | c_axi_id_width=4
c_axi_slave_type=0 | c_axi_type=1 | c_byte_size=9 | c_common_clk=0
c_count_18k_bram=0 | c_count_36k_bram=75 | c_ctrl_ecc_algo=NONE | c_default_data=0
c_disable_warn_bhv_coll=0 | c_disable_warn_bhv_range=0 | c_elaboration_dir=./ | c_en_deepsleep_pin=0
c_en_ecc_pipe=0 | c_en_rdaddra_chg=0 | c_en_rdaddrb_chg=0 | c_en_safety_ckt=0
c_en_shutdown_pin=0 | c_en_sleep_pin=0 | c_enable_32bit_address=0 | c_est_power_summary=Estimated Power for IP _ 4.862098 mW
c_family=zynq | c_has_axi_id=0 | c_has_ena=1 | c_has_enb=0
c_has_injecterr=0 | c_has_mem_output_regs_a=0 | c_has_mem_output_regs_b=1 | c_has_mux_output_regs_a=0
c_has_mux_output_regs_b=0 | c_has_regcea=0 | c_has_regceb=0 | c_has_rsta=0
c_has_rstb=0 | c_has_softecc_input_regs_a=0 | c_has_softecc_output_regs_b=0 | c_init_file=blk_mem_resultant.mem
c_init_file_name=no_coe_file_loaded | c_inita_val=0 | c_initb_val=0 | c_interface_type=0
c_load_init_file=0 | c_mem_type=1 | c_mux_pipeline_stages=0 | c_prim_type=1
c_read_depth_a=307200 | c_read_depth_b=307200 | c_read_width_a=8 | c_read_width_b=8
c_rst_priority_a=CE | c_rst_priority_b=CE | c_rstram_a=0 | c_rstram_b=0
c_sim_collision_check=ALL | c_use_bram_block=0 | c_use_byte_wea=0 | c_use_byte_web=0
c_use_default_data=0 | c_use_ecc=0 | c_use_softecc=0 | c_use_uram=0
c_wea_width=1 | c_web_width=1 | c_write_depth_a=307200 | c_write_depth_b=307200
c_write_mode_a=WRITE_FIRST | c_write_mode_b=WRITE_FIRST | c_write_width_a=8 | c_write_width_b=8
c_xdevicefamily=zynq | core_container=false | iptotal=1 | x_ipcorerevision=3
x_iplanguage=VERILOG | x_iplibrary=ip | x_ipname=blk_mem_gen | x_ipproduct=Vivado 2016.2
x_ipsimlanguage=MIXED | x_ipvendor=xilinx.com | x_ipversion=8.3

blk_mem_gen_v8_3_3/3
c_addra_width=7 | c_addrb_width=7 | c_algorithm=1 | c_axi_id_width=4
c_axi_slave_type=0 | c_axi_type=1 | c_byte_size=9 | c_common_clk=1
c_count_18k_bram=1 | c_count_36k_bram=0 | c_ctrl_ecc_algo=NONE | c_default_data=0
c_disable_warn_bhv_coll=0 | c_disable_warn_bhv_range=0 | c_elaboration_dir=./ | c_en_deepsleep_pin=0
c_en_ecc_pipe=0 | c_en_rdaddra_chg=0 | c_en_rdaddrb_chg=0 | c_en_safety_ckt=0
c_en_shutdown_pin=0 | c_en_sleep_pin=0 | c_enable_32bit_address=0 | c_est_power_summary=Estimated Power for IP _ 2.68455 mW
c_family=zynq | c_has_axi_id=0 | c_has_ena=0 | c_has_enb=0
c_has_injecterr=0 | c_has_mem_output_regs_a=0 | c_has_mem_output_regs_b=1 | c_has_mux_output_regs_a=0
c_has_mux_output_regs_b=0 | c_has_regcea=0 | c_has_regceb=0 | c_has_rsta=0
c_has_rstb=0 | c_has_softecc_input_regs_a=0 | c_has_softecc_output_regs_b=0 | c_init_file=line_bram.mem
c_init_file_name=no_coe_file_loaded | c_inita_val=0 | c_initb_val=0 | c_interface_type=0
c_load_init_file=0 | c_mem_type=1 | c_mux_pipeline_stages=0 | c_prim_type=1
c_read_depth_a=96 | c_read_depth_b=96 | c_read_width_a=8 | c_read_width_b=8
c_rst_priority_a=CE | c_rst_priority_b=CE | c_rstram_a=0 | c_rstram_b=0
c_sim_collision_check=ALL | c_use_bram_block=0 | c_use_byte_wea=0 | c_use_byte_web=0
c_use_default_data=0 | c_use_ecc=0 | c_use_softecc=0 | c_use_uram=0
c_wea_width=1 | c_web_width=1 | c_write_depth_a=96 | c_write_depth_b=96
c_write_mode_a=WRITE_FIRST | c_write_mode_b=READ_FIRST | c_write_width_a=8 | c_write_width_b=8
c_xdevicefamily=zynq | core_container=false | iptotal=1 | x_ipcorerevision=3
x_iplanguage=VERILOG | x_iplibrary=ip | x_ipname=blk_mem_gen | x_ipproduct=Vivado 2016.2
x_ipsimlanguage=MIXED | x_ipvendor=xilinx.com | x_ipversion=8.3

clk_wiz_v5_3_1/1
clkin1_period=10.0 | clkin2_period=10.0 | clock_mgr_type=NA | component_name=clk_wiz_0
core_container=false | enable_axi=0 | feedback_source=FDBK_AUTO | feedback_type=SINGLE
iptotal=1 | manual_override=false | num_out_clk=4 | primitive=MMCM
use_dyn_phase_shift=false | use_dyn_reconfig=false | use_inclk_stopped=false | use_inclk_switchover=false
use_locked=false | use_max_i_jitter=false | use_min_o_jitter=false | use_phase_alignment=true
use_power_down=false | use_reset=true

report_drc

command_line_options
-append=default::[not_specified] | -checks=default::[not_specified] | -fail_on=default::[not_specified] | -force=default::[not_specified]
-format=default::[not_specified] | -messages=default::[not_specified] | -name=default::[not_specified] | -return_string=default::[not_specified]

-ruledecks=default::[not_specified]

results
dpip-1=2 | dpop-1=3 | dpop-2=1 | pdrc-153=1

zps7-1=1

report_power

command_line_options
-advisory=default::[not_specified] | -append=default::[not_specified] | -file=[specified] | -format=default::text
-hier=default::power | -l=default::[not_specified] | -name=default::[not_specified] | -no_propagation=default::[not_specified]
-return_string=default::[not_specified] | -rpx=[specified] | -verbose=default::[not_specified] | -vid=default::[not_specified]

-xpe=default::[not_specified]

usage
airflow=250 (LFM) | ambient_temp=25.0 (C) | bi-dir_toggle=12.500000 | bidir_output_enable=1.000000
board_layers=8to11 (8 to 11 Layers) | board_selection=medium (10"x10") | bram=0.004916 | clocks=0.016764
confidence_level_clock_activity=High | confidence_level_design_state=High | confidence_level_device_models=High | confidence_level_internal_activity=Medium
confidence_level_io_activity=Low | confidence_level_overall=Low | customer=TBD | customer_class=TBD
devstatic=0.129959 | die=xc7z020clg484-1 | dsp=0.000710 | dsp_output_toggle=12.500000
dynamic=0.124968 | effective_thetaja=11.5 | enable_probability=0.990000 | family=zynq
ff_toggle=12.500000 | flow_state=routed | heatsink=none | i/o=0.006529
input_toggle=12.500000 | junction_temp=27.9 (C) | logic=0.006377 | mgtavcc_dynamic_current=0.000000
mgtavcc_static_current=0.000000 | mgtavcc_total_current=0.000000 | mgtavcc_voltage=1.000000 | mgtavtt_dynamic_current=0.000000
mgtavtt_static_current=0.000000 | mgtavtt_total_current=0.000000 | mgtavtt_voltage=1.200000 | mgtvccaux_dynamic_current=0.000000
mgtvccaux_static_current=0.000000 | mgtvccaux_total_current=0.000000 | mgtvccaux_voltage=1.800000 | mmcm=0.084995
netlist_net_matched=NA | off-chip_power=0.000000 | on-chip_power=0.254926 | output_enable=1.000000
output_load=5.000000 | output_toggle=12.500000 | package=clg484 | pct_clock_constrained=2.000000
pct_inputs_defined=8 | platform=nt64 | process=typical | ram_enable=50.000000
ram_write=50.000000 | read_saif=False | set/reset_probability=0.000000 | signal_rate=False
signals=0.013058 | simulation_file=None | speedgrade=-1 | static_prob=False
temp_grade=commercial | thetajb=7.4 (C/W) | thetasa=0.0 (C/W) | toggle_rate=False
user_board_temp=25.0 (C) | user_effective_thetaja=11.5 | user_junc_temp=27.9 (C) | user_thetajb=7.4 (C/W)
user_thetasa=0.0 (C/W) | vccadc_dynamic_current=0.000000 | vccadc_static_current=0.020000 | vccadc_total_current=0.020000
vccadc_voltage=1.800000 | vccaux_dynamic_current=0.047161 | vccaux_io_dynamic_current=0.000000 | vccaux_io_static_current=0.000000
vccaux_io_total_current=0.000000 | vccaux_io_voltage=1.800000 | vccaux_static_current=0.018890 | vccaux_total_current=0.066051
vccaux_voltage=1.800000 | vccbram_dynamic_current=0.000334 | vccbram_static_current=0.005093 | vccbram_total_current=0.005427
vccbram_voltage=1.000000 | vccint_dynamic_current=0.033710 | vccint_static_current=0.010338 | vccint_total_current=0.044047
vccint_voltage=1.000000 | vcco12_dynamic_current=0.000000 | vcco12_static_current=0.000000 | vcco12_total_current=0.000000
vcco12_voltage=1.200000 | vcco135_dynamic_current=0.000000 | vcco135_static_current=0.000000 | vcco135_total_current=0.000000
vcco135_voltage=1.350000 | vcco15_dynamic_current=0.000000 | vcco15_static_current=0.000000 | vcco15_total_current=0.000000
vcco15_voltage=1.500000 | vcco18_dynamic_current=0.000000 | vcco18_static_current=0.000000 | vcco18_total_current=0.000000
vcco18_voltage=1.800000 | vcco25_dynamic_current=0.000000 | vcco25_static_current=0.000000 | vcco25_total_current=0.000000
vcco25_voltage=2.500000 | vcco33_dynamic_current=0.001828 | vcco33_static_current=0.001000 | vcco33_total_current=0.002828
vcco33_voltage=3.300000 | vcco_ddr_dynamic_current=0.000000 | vcco_ddr_static_current=0.000000 | vcco_ddr_total_current=0.000000
vcco_ddr_voltage=1.500000 | vcco_mio0_dynamic_current=0.000000 | vcco_mio0_static_current=0.000000 | vcco_mio0_total_current=0.000000
vcco_mio0_voltage=1.800000 | vcco_mio1_dynamic_current=0.000000 | vcco_mio1_static_current=0.000000 | vcco_mio1_total_current=0.000000
vcco_mio1_voltage=1.800000 | vccpaux_dynamic_current=0.000000 | vccpaux_static_current=0.010330 | vccpaux_total_current=0.010330
vccpaux_voltage=1.800000 | vccpint_dynamic_current=0.000000 | vccpint_static_current=0.017232 | vccpint_total_current=0.017232
vccpint_voltage=1.000000 | vccpll_dynamic_current=0.000000 | vccpll_static_current=0.003000 | vccpll_total_current=0.003000
vccpll_voltage=1.800000 | version=2016.2

report_utilization

clocking
bufgctrl_available=32 | bufgctrl_fixed=0 | bufgctrl_used=5 | bufgctrl_util_percentage=15.63
bufhce_available=72 | bufhce_fixed=0 | bufhce_used=0 | bufhce_util_percentage=0.00
bufio_available=16 | bufio_fixed=0 | bufio_used=0 | bufio_util_percentage=0.00
bufmrce_available=8 | bufmrce_fixed=0 | bufmrce_used=0 | bufmrce_util_percentage=0.00
bufr_available=16 | bufr_fixed=0 | bufr_used=0 | bufr_util_percentage=0.00
mmcme2_adv_available=4 | mmcme2_adv_fixed=0 | mmcme2_adv_used=1 | mmcme2_adv_util_percentage=25.00
plle2_adv_available=4 | plle2_adv_fixed=0 | plle2_adv_used=0 | plle2_adv_util_percentage=0.00

dsp
dsp48e1_only_used=5 | dsps_available=220 | dsps_fixed=0 | dsps_used=5

dsps_util_percentage=2.27

io_standard
blvds_25=0 | diff_hstl_i=0 | diff_hstl_i_18=0 | diff_hstl_ii=0
diff_hstl_ii_18=0 | diff_hsul_12=0 | diff_mobile_ddr=0 | diff_sstl135=0
diff_sstl135_r=0 | diff_sstl15=0 | diff_sstl15_r=0 | diff_sstl18_i=0
diff_sstl18_ii=0 | hstl_i=0 | hstl_i_18=0 | hstl_ii=0
hstl_ii_18=0 | hsul_12=0 | lvcmos12=0 | lvcmos15=0
lvcmos18=0 | lvcmos25=0 | lvcmos33=1 | lvds_25=0
lvttl=0 | mini_lvds_25=0 | mobile_ddr=0 | pci33_3=0
ppds_25=0 | rsds_25=0 | sstl135=0 | sstl135_r=0
sstl15=0 | sstl15_r=0 | sstl18_i=0 | sstl18_ii=0

tmds_33=0

memory
block_ram_tile_available=140 | block_ram_tile_fixed=0 | block_ram_tile_used=129.5 | block_ram_tile_util_percentage=92.50
ramb18_available=280 | ramb18_fixed=0 | ramb18_used=1 | ramb18_util_percentage=0.36
ramb18e1_only_used=1 | ramb36_fifo_available=140 | ramb36_fifo_fixed=0 | ramb36_fifo_used=129
ramb36_fifo_util_percentage=92.14 | ramb36e1_only_used=129

primitives
bufg_functional_category=Clock | bufg_used=5 | carry4_functional_category=CarryLogic | carry4_used=114
dsp48e1_functional_category=Block Arithmetic | dsp48e1_used=5 | fdre_functional_category=Flop & Latch | fdre_used=603
ibuf_functional_category=IO | ibuf_used=12 | ldce_functional_category=Flop & Latch | ldce_used=2
ldpe_functional_category=Flop & Latch | ldpe_used=3 | lut1_functional_category=LUT | lut1_used=28
lut2_functional_category=LUT | lut2_used=211 | lut3_functional_category=LUT | lut3_used=258
lut4_functional_category=LUT | lut4_used=290 | lut5_functional_category=LUT | lut5_used=295
lut6_functional_category=LUT | lut6_used=885 | mmcme2_adv_functional_category=Clock | mmcme2_adv_used=1
muxf7_functional_category=MuxFx | muxf7_used=168 | muxf8_functional_category=MuxFx | muxf8_used=38
obuf_functional_category=IO | obuf_used=22 | ramb18e1_functional_category=Block Memory | ramb18e1_used=1
ramb36e1_functional_category=Block Memory | ramb36e1_used=129 | ramd32_functional_category=Distributed Memory | ramd32_used=84
rams32_functional_category=Distributed Memory | rams32_used=140

slice_logic
f7_muxes_available=26600 | f7_muxes_fixed=0 | f7_muxes_used=168 | f7_muxes_util_percentage=0.63
f8_muxes_available=13300 | f8_muxes_fixed=0 | f8_muxes_used=38 | f8_muxes_util_percentage=0.29
lut_as_distributed_ram_fixed=0 | lut_as_distributed_ram_used=168 | lut_as_logic_available=53200 | lut_as_logic_fixed=0
lut_as_logic_used=1661 | lut_as_logic_util_percentage=3.12 | lut_as_memory_available=17400 | lut_as_memory_fixed=0
lut_as_memory_used=168 | lut_as_memory_util_percentage=0.97 | lut_as_shift_register_fixed=0 | lut_as_shift_register_used=0
register_as_flip_flop_available=106400 | register_as_flip_flop_fixed=0 | register_as_flip_flop_used=603 | register_as_flip_flop_util_percentage=0.57
register_as_latch_available=106400 | register_as_latch_fixed=0 | register_as_latch_used=5 | register_as_latch_util_percentage=<0.01
slice_luts_available=53200 | slice_luts_fixed=0 | slice_luts_used=1829 | slice_luts_util_percentage=3.44
slice_registers_available=106400 | slice_registers_fixed=0 | slice_registers_used=608 | slice_registers_util_percentage=0.57
fully_used_lut_ff_pairs_fixed=0.57 | fully_used_lut_ff_pairs_used=14 | lut_as_distributed_ram_fixed=0 | lut_as_distributed_ram_used=168
lut_as_logic_available=53200 | lut_as_logic_fixed=0 | lut_as_logic_used=1661 | lut_as_logic_util_percentage=3.12
lut_as_memory_available=17400 | lut_as_memory_fixed=0 | lut_as_memory_used=168 | lut_as_memory_util_percentage=0.97
lut_as_shift_register_fixed=0 | lut_as_shift_register_used=0 | lut_ff_pairs_with_one_unused_flip_flop_fixed=0 | lut_ff_pairs_with_one_unused_flip_flop_used=159
lut_ff_pairs_with_one_unused_lut_fixed=159 | lut_ff_pairs_with_one_unused_lut_used=140 | lut_flip_flop_pairs_available=53200 | lut_flip_flop_pairs_fixed=0
lut_flip_flop_pairs_used=180 | lut_flip_flop_pairs_util_percentage=0.34 | slice_available=13300 | slice_fixed=0
slice_used=724 | slice_util_percentage=5.44 | slicel_fixed=0 | slicel_used=415
slicem_fixed=0 | slicem_used=309 | unique_control_sets_used=58 | using_o5_and_o6_fixed=58
using_o5_and_o6_used=56 | using_o5_output_only_fixed=56 | using_o5_output_only_used=0 | using_o6_output_only_fixed=0

using_o6_output_only_used=112

specific_feature
bscane2_available=4 | bscane2_fixed=0 | bscane2_used=0 | bscane2_util_percentage=0.00
capturee2_available=1 | capturee2_fixed=0 | capturee2_used=0 | capturee2_util_percentage=0.00
dna_port_available=1 | dna_port_fixed=0 | dna_port_used=0 | dna_port_util_percentage=0.00
efuse_usr_available=1 | efuse_usr_fixed=0 | efuse_usr_used=0 | efuse_usr_util_percentage=0.00
frame_ecce2_available=1 | frame_ecce2_fixed=0 | frame_ecce2_used=0 | frame_ecce2_util_percentage=0.00
icape2_available=2 | icape2_fixed=0 | icape2_used=0 | icape2_util_percentage=0.00
startupe2_available=1 | startupe2_fixed=0 | startupe2_used=0 | startupe2_util_percentage=0.00
xadc_available=1 | xadc_fixed=0 | xadc_used=0 | xadc_util_percentage=0.00

router

usage
actual_expansions=7629703 | bogomips=0 | bram18=1 | bram36=129
bufg=0 | bufr=0 | congestion_level=0 | ctrls=58
dsp=5 | effort=2 | estimated_expansions=8094924 | ff=608
global_clocks=5 | high_fanout_nets=2 | iob=34 | lut=1918
movable_instances=3574 | nets=4927 | pins=50883 | pll=0
router_runtime=42.620000 | router_timing_driven=1 | threads=2 | timing_constraints_exist=1

synthesis

command_line_options
-assert=default::[not_specified] | -bufg=default::12 | -cascade_dsp=default::auto | -constrset=default::[not_specified]
-control_set_opt_threshold=default::auto | -directive=default::default | -fanout_limit=default::10000 | -flatten_hierarchy=default::rebuilt
-fsm_extraction=default::auto | -gated_clock_conversion=default::off | -generic=default::[not_specified] | -include_dirs=default::[not_specified]
-keep_equivalent_registers=default::[not_specified] | -max_bram=default::-1 | -max_bram_cascade_height=default::-1 | -max_dsp=default::-1
-max_uram=default::-1 | -max_uram_cascade_height=default::-1 | -mode=default::default | -name=default::[not_specified]
-no_lc=default::[not_specified] | -no_srlextract=default::[not_specified] | -no_timing_driven=default::[not_specified] | -part=xc7z020clg484-1
-resource_sharing=default::auto | -retiming=default::[not_specified] | -rtl=default::[not_specified] | -rtl_skip_constraints=default::[not_specified]
-rtl_skip_ip=default::[not_specified] | -seu_protect=default::none | -shreg_min_size=default::3 | -top=noip_top

-verilog_define=default::[not_specified]

usage
elapsed=00:00:52s | hls_ip=0 | memory_gain=590.613MB | memory_peak=797.234MB
