glgauthier/MQP/report/figures/setup.JPG

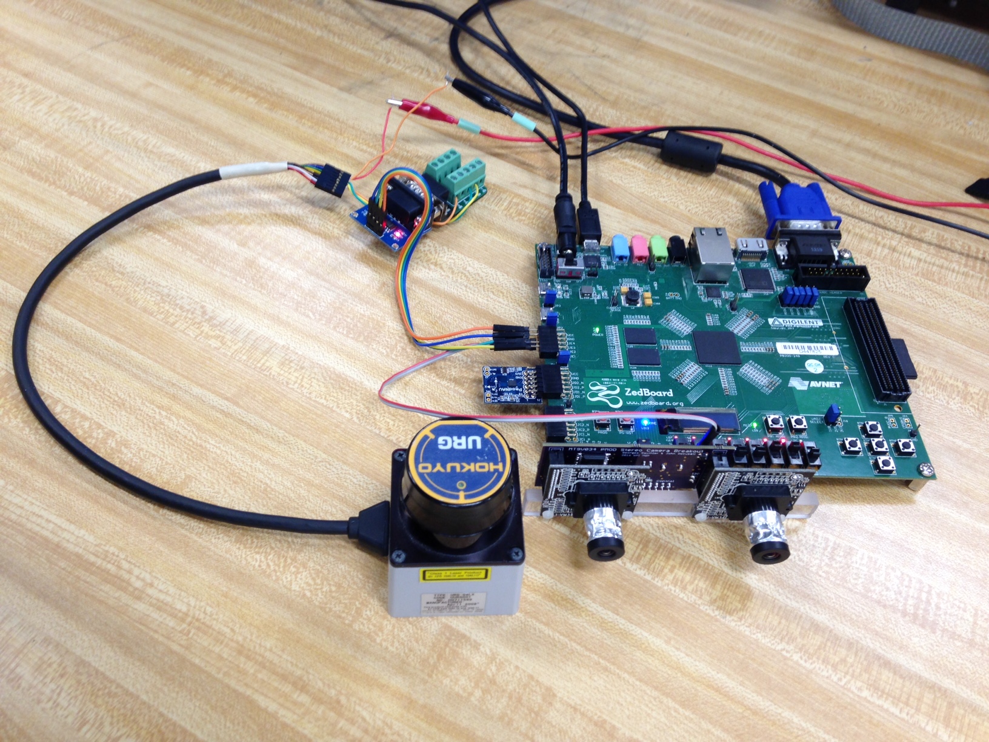
report/figures/setup.JPG
