glgauthier/MQP/MT9V034_test/ipcore_dir/microblaze_mcs_flist.txt

# Output products list for <microblaze_mcs>
mb_bootloop_le.elf
microblaze_mcs.asy
microblaze_mcs.bmm
microblaze_mcs.gise
microblaze_mcs.ngc
microblaze_mcs.sym
microblaze_mcs.v
microblaze_mcs.veo
microblaze_mcs.xco
microblaze_mcs.xise
microblaze_mcs\mb_bootloop_le.elf
microblaze_mcs\microblaze_mcs_setup.tcl
microblaze_mcs\system_template.tcl
microblaze_mcs_flist.txt
microblaze_mcs_readme.txt
microblaze_mcs_sdk.xml
microblaze_mcs_setup.tcl
