glgauthier/MQP/MT9V034_test/ipcore_dir/dcm_flist.txt

# Output products list for <dcm>
_xmsgs\pn_parser.xmsgs
dcm.asy
dcm.gise
dcm.sym
dcm.ucf
dcm.v
dcm.veo
dcm.xco
dcm.xdc
dcm.xise
dcm\clk_wiz_v3_5_readme.txt
dcm\doc\clk_wiz_gsg521.pdf
dcm\doc\clk_wiz_v3_5_readme.txt
dcm\doc\clk_wiz_v3_5_vinfo.html
dcm\example_design\dcm_exdes.ucf
dcm\example_design\dcm_exdes.v
dcm\example_design\dcm_exdes.xdc
dcm\implement\implement.bat
dcm\implement\implement.sh
dcm\implement\planAhead_ise.bat
dcm\implement\planAhead_ise.sh
dcm\implement\planAhead_ise.tcl
dcm\implement\planAhead_rdn.bat
dcm\implement\planAhead_rdn.sh
dcm\implement\planAhead_rdn.tcl
dcm\implement\xst.prj
dcm\implement\xst.scr
dcm\simulation\dcm_tb.v
dcm\simulation\functional\simcmds.tcl
dcm\simulation\functional\simulate_isim.bat
dcm\simulation\functional\simulate_isim.sh
dcm\simulation\functional\simulate_mti.bat
dcm\simulation\functional\simulate_mti.do
dcm\simulation\functional\simulate_mti.sh
dcm\simulation\functional\simulate_ncsim.sh
dcm\simulation\functional\simulate_vcs.sh
dcm\simulation\functional\ucli_commands.key
dcm\simulation\functional\vcs_session.tcl
dcm\simulation\functional\wave.do
dcm\simulation\functional\wave.sv
dcm\simulation\timing\dcm_tb.v
dcm\simulation\timing\sdf_cmd_file
dcm\simulation\timing\simcmds.tcl
dcm\simulation\timing\simulate_isim.sh
dcm\simulation\timing\simulate_mti.bat
dcm\simulation\timing\simulate_mti.do
dcm\simulation\timing\simulate_mti.sh
dcm\simulation\timing\simulate_ncsim.sh
dcm\simulation\timing\simulate_vcs.sh
dcm\simulation\timing\ucli_commands.key
dcm\simulation\timing\vcs_session.tcl
dcm\simulation\timing\wave.do
dcm_flist.txt
dcm_xmdf.tcl
