glgauthier/MQP/ZedFinalCams/ZedFinalCams.ip_user_files/sim_scripts/blk_mem_resultant/activehdl/file_info.txt

xpm_cdc.sv,systemverilog,xil_defaultlib,../../../../../../../../../../Xilinx/Vivado/2016.2/data/ip/xpm/xpm_cdc/hdl/xpm_cdc.sv,
xpm_memory_base.sv,systemverilog,xil_defaultlib,../../../../../../../../../../Xilinx/Vivado/2016.2/data/ip/xpm/xpm_memory/hdl/xpm_memory_base.sv,
xpm_memory_dpdistram.sv,systemverilog,xil_defaultlib,../../../../../../../../../../Xilinx/Vivado/2016.2/data/ip/xpm/xpm_memory/hdl/xpm_memory_dpdistram.sv,
xpm_memory_dprom.sv,systemverilog,xil_defaultlib,../../../../../../../../../../Xilinx/Vivado/2016.2/data/ip/xpm/xpm_memory/hdl/xpm_memory_dprom.sv,
xpm_memory_sdpram.sv,systemverilog,xil_defaultlib,../../../../../../../../../../Xilinx/Vivado/2016.2/data/ip/xpm/xpm_memory/hdl/xpm_memory_sdpram.sv,
xpm_memory_spram.sv,systemverilog,xil_defaultlib,../../../../../../../../../../Xilinx/Vivado/2016.2/data/ip/xpm/xpm_memory/hdl/xpm_memory_spram.sv,
xpm_memory_sprom.sv,systemverilog,xil_defaultlib,../../../../../../../../../../Xilinx/Vivado/2016.2/data/ip/xpm/xpm_memory/hdl/xpm_memory_sprom.sv,
xpm_memory_tdpram.sv,systemverilog,xil_defaultlib,../../../../../../../../../../Xilinx/Vivado/2016.2/data/ip/xpm/xpm_memory/hdl/xpm_memory_tdpram.sv,
xpm_VCOMP.vhd,vhdl,xpm,../../../../../../../../../../Xilinx/Vivado/2016.2/data/ip/xpm/xpm_VCOMP.vhd,
blk_mem_gen_v8_3.v,verilog,blk_mem_gen_v8_3_3,../../../ipstatic/blk_mem_gen_v8_3_3/simulation/blk_mem_gen_v8_3.v,
blk_mem_resultant.v,verilog,xil_defaultlib,../../../../ZedFinalCams.srcs/sources_1/ip/blk_mem_resultant/sim/blk_mem_resultant.v,
glbl.v,Verilog,xil_defaultlib,glbl.v
