glgauthier/MQP/ZedCamTest/ZedCamTest.ip_user_files/sim_scripts/bd/activehdl/file_info.txt

xpm_cdc.sv,systemverilog,xil_defaultlib,../../../../../../../Xilinx/Vivado/2016.2/data/ip/xpm/xpm_cdc/hdl/xpm_cdc.sv,incdir="../../../../ZedCamTest.srcs/sources_1/bd/bd/ip/bd_ZedCamAXI_0_0/src/clk_wiz_0/clk_wiz_v5_3_1"incdir="../../../ipstatic/axi_infrastructure_v1_1/hdl/verilog"incdir="../../../ipstatic/processing_system7_bfm_v2_0/hdl"incdir="../../../../ZedCamTest.srcs/sources_1/bd/bd/ip/bd_ZedCamAXI_0_0/src/clk_wiz_0/clk_wiz_v5_3_1"incdir="../../../ipstatic/axi_infrastructure_v1_1/hdl/verilog"incdir="../../../ipstatic/processing_system7_bfm_v2_0/hdl"
xpm_memory_base.sv,systemverilog,xil_defaultlib,../../../../../../../Xilinx/Vivado/2016.2/data/ip/xpm/xpm_memory/hdl/xpm_memory_base.sv,incdir="../../../../ZedCamTest.srcs/sources_1/bd/bd/ip/bd_ZedCamAXI_0_0/src/clk_wiz_0/clk_wiz_v5_3_1"incdir="../../../ipstatic/axi_infrastructure_v1_1/hdl/verilog"incdir="../../../ipstatic/processing_system7_bfm_v2_0/hdl"incdir="../../../../ZedCamTest.srcs/sources_1/bd/bd/ip/bd_ZedCamAXI_0_0/src/clk_wiz_0/clk_wiz_v5_3_1"incdir="../../../ipstatic/axi_infrastructure_v1_1/hdl/verilog"incdir="../../../ipstatic/processing_system7_bfm_v2_0/hdl"
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
processing_system7_bfm_v2_0_afi_slave.v,verilog,processing_system7_bfm_v2_0_5,../../../ipstatic/processing_system7_bfm_v2_0/hdl/processing_system7_bfm_v2_0_afi_slave.v,incdir="../../../../ZedCamTest.srcs/sources_1/bd/bd/ip/bd_ZedCamAXI_0_0/src/clk_wiz_0/clk_wiz_v5_3_1"incdir="../../../ipstatic/axi_infrastructure_v1_1/hdl/verilog"incdir="../../../ipstatic/processing_system7_bfm_v2_0/hdl"incdir="../../../../ZedCamTest.srcs/sources_1/bd/bd/ip/bd_ZedCamAXI_0_0/src/clk_wiz_0/clk_wiz_v5_3_1"incdir="../../../ipstatic/axi_infrastructure_v1_1/hdl/verilog"incdir="../../../ipstatic/processing_system7_bfm_v2_0/hdl"
processing_system7_bfm_v2_0_processing_system7_bfm.v,verilog,processing_system7_bfm_v2_0_5,../../../ipstatic/processing_system7_bfm_v2_0/hdl/processing_system7_bfm_v2_0_processing_system7_bfm.v,incdir="../../../../ZedCamTest.srcs/sources_1/bd/bd/ip/bd_ZedCamAXI_0_0/src/clk_wiz_0/clk_wiz_v5_3_1"incdir="../../../ipstatic/axi_infrastructure_v1_1/hdl/verilog"incdir="../../../ipstatic/processing_system7_bfm_v2_0/hdl"incdir="../../../../ZedCamTest.srcs/sources_1/bd/bd/ip/bd_ZedCamAXI_0_0/src/clk_wiz_0/clk_wiz_v5_3_1"incdir="../../../ipstatic/axi_infrastructure_v1_1/hdl/verilog"incdir="../../../ipstatic/processing_system7_bfm_v2_0/hdl"
bd_processing_system7_0_0.v,verilog,xil_defaultlib,../../../../ZedCamTest.srcs/sources_1/bd/bd/ip/bd_processing_system7_0_0_1/sim/bd_processing_system7_0_0.v,incdir="../../../../ZedCamTest.srcs/sources_1/bd/bd/ip/bd_ZedCamAXI_0_0/src/clk_wiz_0/clk_wiz_v5_3_1"incdir="../../../ipstatic/axi_infrastructure_v1_1/hdl/verilog"incdir="../../../ipstatic/processing_system7_bfm_v2_0/hdl"incdir="../../../../ZedCamTest.srcs/sources_1/bd/bd/ip/bd_ZedCamAXI_0_0/src/clk_wiz_0/clk_wiz_v5_3_1"incdir="../../../ipstatic/axi_infrastructure_v1_1/hdl/verilog"incdir="../../../ipstatic/processing_system7_bfm_v2_0/hdl"
cdc_sync.vhd,vhdl,lib_cdc_v1_0_2,../../../ipstatic/lib_cdc_v1_0/hdl/src/vhdl/cdc_sync.vhd,incdir="../../../../ZedCamTest.srcs/sources_1/bd/bd/ip/bd_ZedCamAXI_0_0/src/clk_wiz_0/clk_wiz_v5_3_1"incdir="../../../ipstatic/axi_infrastructure_v1_1/hdl/verilog"incdir="../../../ipstatic/processing_system7_bfm_v2_0/hdl"incdir="../../../../ZedCamTest.srcs/sources_1/bd/bd/ip/bd_ZedCamAXI_0_0/src/clk_wiz_0/clk_wiz_v5_3_1"incdir="../../../ipstatic/axi_infrastructure_v1_1/hdl/verilog"incdir="../../../ipstatic/processing_system7_bfm_v2_0/hdl"
upcnt_n.vhd,vhdl,proc_sys_reset_v5_0_9,../../../ipstatic/proc_sys_reset_v5_0/hdl/src/vhdl/upcnt_n.vhd,incdir="../../../../ZedCamTest.srcs/sources_1/bd/bd/ip/bd_ZedCamAXI_0_0/src/clk_wiz_0/clk_wiz_v5_3_1"incdir="../../../ipstatic/axi_infrastructure_v1_1/hdl/verilog"incdir="../../../ipstatic/processing_system7_bfm_v2_0/hdl"incdir="../../../../ZedCamTest.srcs/sources_1/bd/bd/ip/bd_ZedCamAXI_0_0/src/clk_wiz_0/clk_wiz_v5_3_1"incdir="../../../ipstatic/axi_infrastructure_v1_1/hdl/verilog"incdir="../../../ipstatic/processing_system7_bfm_v2_0/hdl"
sequence_psr.vhd,vhdl,proc_sys_reset_v5_0_9,../../../ipstatic/proc_sys_reset_v5_0/hdl/src/vhdl/sequence_psr.vhd,incdir="../../../../ZedCamTest.srcs/sources_1/bd/bd/ip/bd_ZedCamAXI_0_0/src/clk_wiz_0/clk_wiz_v5_3_1"incdir="../../../ipstatic/axi_infrastructure_v1_1/hdl/verilog"incdir="../../../ipstatic/processing_system7_bfm_v2_0/hdl"incdir="../../../../ZedCamTest.srcs/sources_1/bd/bd/ip/bd_ZedCamAXI_0_0/src/clk_wiz_0/clk_wiz_v5_3_1"incdir="../../../ipstatic/axi_infrastructure_v1_1/hdl/verilog"incdir="../../../ipstatic/processing_system7_bfm_v2_0/hdl"
lpf.vhd,vhdl,proc_sys_reset_v5_0_9,../../../ipstatic/proc_sys_reset_v5_0/hdl/src/vhdl/lpf.vhd,incdir="../../../../ZedCamTest.srcs/sources_1/bd/bd/ip/bd_ZedCamAXI_0_0/src/clk_wiz_0/clk_wiz_v5_3_1"incdir="../../../ipstatic/axi_infrastructure_v1_1/hdl/verilog"incdir="../../../ipstatic/processing_system7_bfm_v2_0/hdl"incdir="../../../../ZedCamTest.srcs/sources_1/bd/bd/ip/bd_ZedCamAXI_0_0/src/clk_wiz_0/clk_wiz_v5_3_1"incdir="../../../ipstatic/axi_infrastructure_v1_1/hdl/verilog"incdir="../../../ipstatic/processing_system7_bfm_v2_0/hdl"
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
generic_baseblocks_v2_1_mux.v,verilog,generic_baseblocks_v2_1_0,../../../ipstatic/generic_baseblocks_v2_1/hdl/verilog/generic_baseblocks_v2_1_mux.v,incdir="../../../../ZedCamTest.srcs/sources_1/bd/bd/ip/bd_ZedCamAXI_0_0/src/clk_wiz_0/clk_wiz_v5_3_1"incdir="../../../ipstatic/axi_infrastructure_v1_1/hdl/verilog"incdir="../../../ipstatic/processing_system7_bfm_v2_0/hdl"incdir="../../../../ZedCamTest.srcs/sources_1/bd/bd/ip/bd_ZedCamAXI_0_0/src/clk_wiz_0/clk_wiz_v5_3_1"incdir="../../../ipstatic/axi_infrastructure_v1_1/hdl/verilog"incdir="../../../ipstatic/processing_system7_bfm_v2_0/hdl"
generic_baseblocks_v2_1_nto1_mux.v,verilog,generic_baseblocks_v2_1_0,../../../ipstatic/generic_baseblocks_v2_1/hdl/verilog/generic_baseblocks_v2_1_nto1_mux.v,incdir="../../../../ZedCamTest.srcs/sources_1/bd/bd/ip/bd_ZedCamAXI_0_0/src/clk_wiz_0/clk_wiz_v5_3_1"incdir="../../../ipstatic/axi_infrastructure_v1_1/hdl/verilog"incdir="../../../ipstatic/processing_system7_bfm_v2_0/hdl"incdir="../../../../ZedCamTest.srcs/sources_1/bd/bd/ip/bd_ZedCamAXI_0_0/src/clk_wiz_0/clk_wiz_v5_3_1"incdir="../../../ipstatic/axi_infrastructure_v1_1/hdl/verilog"incdir="../../../ipstatic/processing_system7_bfm_v2_0/hdl"
axi_infrastructure_v1_1_axi2vector.v,verilog,axi_infrastructure_v1_1_0,../../../ipstatic/axi_infrastructure_v1_1/hdl/verilog/axi_infrastructure_v1_1_axi2vector.v,incdir="../../../../ZedCamTest.srcs/sources_1/bd/bd/ip/bd_ZedCamAXI_0_0/src/clk_wiz_0/clk_wiz_v5_3_1"incdir="../../../ipstatic/axi_infrastructure_v1_1/hdl/verilog"incdir="../../../ipstatic/processing_system7_bfm_v2_0/hdl"incdir="../../../../ZedCamTest.srcs/sources_1/bd/bd/ip/bd_ZedCamAXI_0_0/src/clk_wiz_0/clk_wiz_v5_3_1"incdir="../../../ipstatic/axi_infrastructure_v1_1/hdl/verilog"incdir="../../../ipstatic/processing_system7_bfm_v2_0/hdl"
axi_infrastructure_v1_1_axic_srl_fifo.v,verilog,axi_infrastructure_v1_1_0,../../../ipstatic/axi_infrastructure_v1_1/hdl/verilog/axi_infrastructure_v1_1_axic_srl_fifo.v,incdir="../../../../ZedCamTest.srcs/sources_1/bd/bd/ip/bd_ZedCamAXI_0_0/src/clk_wiz_0/clk_wiz_v5_3_1"incdir="../../../ipstatic/axi_infrastructure_v1_1/hdl/verilog"incdir="../../../ipstatic/processing_system7_bfm_v2_0/hdl"incdir="../../../../ZedCamTest.srcs/sources_1/bd/bd/ip/bd_ZedCamAXI_0_0/src/clk_wiz_0/clk_wiz_v5_3_1"incdir="../../../ipstatic/axi_infrastructure_v1_1/hdl/verilog"incdir="../../../ipstatic/processing_system7_bfm_v2_0/hdl"
axi_infrastructure_v1_1_vector2axi.v,verilog,axi_infrastructure_v1_1_0,../../../ipstatic/axi_infrastructure_v1_1/hdl/verilog/axi_infrastructure_v1_1_vector2axi.v,incdir="../../../../ZedCamTest.srcs/sources_1/bd/bd/ip/bd_ZedCamAXI_0_0/src/clk_wiz_0/clk_wiz_v5_3_1"incdir="../../../ipstatic/axi_infrastructure_v1_1/hdl/verilog"incdir="../../../ipstatic/processing_system7_bfm_v2_0/hdl"incdir="../../../../ZedCamTest.srcs/sources_1/bd/bd/ip/bd_ZedCamAXI_0_0/src/clk_wiz_0/clk_wiz_v5_3_1"incdir="../../../ipstatic/axi_infrastructure_v1_1/hdl/verilog"incdir="../../../ipstatic/processing_system7_bfm_v2_0/hdl"
axi_register_slice_v2_1_axic_register_slice.v,verilog,axi_register_slice_v2_1_9,../../../ipstatic/axi_register_slice_v2_1/hdl/verilog/axi_register_slice_v2_1_axic_register_slice.v,incdir="../../../../ZedCamTest.srcs/sources_1/bd/bd/ip/bd_ZedCamAXI_0_0/src/clk_wiz_0/clk_wiz_v5_3_1"incdir="../../../ipstatic/axi_infrastructure_v1_1/hdl/verilog"incdir="../../../ipstatic/processing_system7_bfm_v2_0/hdl"incdir="../../../../ZedCamTest.srcs/sources_1/bd/bd/ip/bd_ZedCamAXI_0_0/src/clk_wiz_0/clk_wiz_v5_3_1"incdir="../../../ipstatic/axi_infrastructure_v1_1/hdl/verilog"incdir="../../../ipstatic/processing_system7_bfm_v2_0/hdl"
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
axi_protocol_converter_v2_1_b2s_ar_channel.v,verilog,axi_protocol_converter_v2_1_9,../../../ipstatic/axi_protocol_converter_v2_1/hdl/verilog/axi_protocol_converter_v2_1_b2s_ar_channel.v,incdir="../../../../ZedCamTest.srcs/sources_1/bd/bd/ip/bd_ZedCamAXI_0_0/src/clk_wiz_0/clk_wiz_v5_3_1"incdir="../../../ipstatic/axi_infrastructure_v1_1/hdl/verilog"incdir="../../../ipstatic/processing_system7_bfm_v2_0/hdl"incdir="../../../../ZedCamTest.srcs/sources_1/bd/bd/ip/bd_ZedCamAXI_0_0/src/clk_wiz_0/clk_wiz_v5_3_1"incdir="../../../ipstatic/axi_infrastructure_v1_1/hdl/verilog"incdir="../../../ipstatic/processing_system7_bfm_v2_0/hdl"
axi_protocol_converter_v2_1_b2s.v,verilog,axi_protocol_converter_v2_1_9,../../../ipstatic/axi_protocol_converter_v2_1/hdl/verilog/axi_protocol_converter_v2_1_b2s.v,incdir="../../../../ZedCamTest.srcs/sources_1/bd/bd/ip/bd_ZedCamAXI_0_0/src/clk_wiz_0/clk_wiz_v5_3_1"incdir="../../../ipstatic/axi_infrastructure_v1_1/hdl/verilog"incdir="../../../ipstatic/processing_system7_bfm_v2_0/hdl"incdir="../../../../ZedCamTest.srcs/sources_1/bd/bd/ip/bd_ZedCamAXI_0_0/src/clk_wiz_0/clk_wiz_v5_3_1"incdir="../../../ipstatic/axi_infrastructure_v1_1/hdl/verilog"incdir="../../../ipstatic/processing_system7_bfm_v2_0/hdl"
axi_protocol_converter_v2_1_axi_protocol_converter.v,verilog,axi_protocol_converter_v2_1_9,../../../ipstatic/axi_protocol_converter_v2_1/hdl/verilog/axi_protocol_converter_v2_1_axi_protocol_converter.v,incdir="../../../../ZedCamTest.srcs/sources_1/bd/bd/ip/bd_ZedCamAXI_0_0/src/clk_wiz_0/clk_wiz_v5_3_1"incdir="../../../ipstatic/axi_infrastructure_v1_1/hdl/verilog"incdir="../../../ipstatic/processing_system7_bfm_v2_0/hdl"incdir="../../../../ZedCamTest.srcs/sources_1/bd/bd/ip/bd_ZedCamAXI_0_0/src/clk_wiz_0/clk_wiz_v5_3_1"incdir="../../../ipstatic/axi_infrastructure_v1_1/hdl/verilog"incdir="../../../ipstatic/processing_system7_bfm_v2_0/hdl"
bd_auto_pc_0.v,verilog,xil_defaultlib,../../../../ZedCamTest.srcs/sources_1/bd/bd/ip/bd_auto_pc_0/sim/bd_auto_pc_0.v,incdir="../../../../ZedCamTest.srcs/sources_1/bd/bd/ip/bd_ZedCamAXI_0_0/src/clk_wiz_0/clk_wiz_v5_3_1"incdir="../../../ipstatic/axi_infrastructure_v1_1/hdl/verilog"incdir="../../../ipstatic/processing_system7_bfm_v2_0/hdl"incdir="../../../../ZedCamTest.srcs/sources_1/bd/bd/ip/bd_ZedCamAXI_0_0/src/clk_wiz_0/clk_wiz_v5_3_1"incdir="../../../ipstatic/axi_infrastructure_v1_1/hdl/verilog"incdir="../../../ipstatic/processing_system7_bfm_v2_0/hdl"
bd_auto_pc_1.v,verilog,xil_defaultlib,../../../../ZedCamTest.srcs/sources_1/bd/bd/ip/bd_auto_pc_1/sim/bd_auto_pc_1.v,incdir="../../../../ZedCamTest.srcs/sources_1/bd/bd/ip/bd_ZedCamAXI_0_0/src/clk_wiz_0/clk_wiz_v5_3_1"incdir="../../../ipstatic/axi_infrastructure_v1_1/hdl/verilog"incdir="../../../ipstatic/processing_system7_bfm_v2_0/hdl"incdir="../../../../ZedCamTest.srcs/sources_1/bd/bd/ip/bd_ZedCamAXI_0_0/src/clk_wiz_0/clk_wiz_v5_3_1"incdir="../../../ipstatic/axi_infrastructure_v1_1/hdl/verilog"incdir="../../../ipstatic/processing_system7_bfm_v2_0/hdl"
glbl.v,Verilog,xil_defaultlib,glbl.v
