glgauthier/MQP/ZedCamTest/ZedCamTest.ip_user_files/sim_scripts/bd/ies/file_info.txt

xpm_cdc.sv,systemverilog,xil_defaultlib,../../../../../../../Xilinx/Vivado/2016.2/data/ip/xpm/xpm_cdc/hdl/xpm_cdc.sv,incdir="$ref_dir/../../../../ZedCamTest.srcs/sources_1/bd/bd/ip/bd_ZedCamAXI_0_0/src/clk_wiz_0/clk_wiz_v5_3_1"incdir="$ref_dir/../../../ipstatic/axi_infrastructure_v1_1/hdl/verilog"incdir="$ref_dir/../../../ipstatic/processing_system7_bfm_v2_0/hdl"incdir="../../../../ZedCamTest.srcs/sources_1/bd/bd/ip/bd_ZedCamAXI_0_0/src/clk_wiz_0/clk_wiz_v5_3_1"incdir="../../../ipstatic/axi_infrastructure_v1_1/hdl/verilog"incdir="../../../ipstatic/processing_system7_bfm_v2_0/hdl"
xpm_memory_base.sv,systemverilog,xil_defaultlib,../../../../../../../Xilinx/Vivado/2016.2/data/ip/xpm/xpm_memory/hdl/xpm_memory_base.sv,incdir="$ref_dir/../../../../ZedCamTest.srcs/sources_1/bd/bd/ip/bd_ZedCamAXI_0_0/src/clk_wiz_0/clk_wiz_v5_3_1"incdir="$ref_dir/../../../ipstatic/axi_infrastructure_v1_1/hdl/verilog"incdir="$ref_dir/../../../ipstatic/processing_system7_bfm_v2_0/hdl"incdir="../../../../ZedCamTest.srcs/sources_1/bd/bd/ip/bd_ZedCamAXI_0_0/src/clk_wiz_0/clk_wiz_v5_3_1"incdir="../../../ipstatic/axi_infrastructure_v1_1/hdl/verilog"incdir="../../../ipstatic/processing_system7_bfm_v2_0/hdl"
xpm_memory_dpdistram.sv,systemverilog,xil_defaultlib,../../../../../../../Xilinx/Vivado/2016.2/data/ip/xpm/xpm_memory/hdl/xpm_memory_dpdistram.sv,incdir="$ref_dir/../../../../ZedCamTest.srcs/sources_1/bd/bd/ip/bd_ZedCamAXI_0_0/src/clk_wiz_0/clk_wiz_v5_3_1"incdir="$ref_dir/../../../ipstatic/axi_infrastructure_v1_1/hdl/verilog"incdir="$ref_dir/../../../ipstatic/processing_system7_bfm_v2_0/hdl"incdir="../../../../ZedCamTest.srcs/sources_1/bd/bd/ip/bd_ZedCamAXI_0_0/src/clk_wiz_0/clk_wiz_v5_3_1"incdir="../../../ipstatic/axi_infrastructure_v1_1/hdl/verilog"incdir="../../../ipstatic/processing_system7_bfm_v2_0/hdl"
xpm_memory_dprom.sv,systemverilog,xil_defaultlib,../../../../../../../Xilinx/Vivado/2016.2/data/ip/xpm/xpm_memory/hdl/xpm_memory_dprom.sv,incdir="$ref_dir/../../../../ZedCamTest.srcs/sources_1/bd/bd/ip/bd_ZedCamAXI_0_0/src/clk_wiz_0/clk_wiz_v5_3_1"incdir="$ref_dir/../../../ipstatic/axi_infrastructure_v1_1/hdl/verilog"incdir="$ref_dir/../../../ipstatic/processing_system7_bfm_v2_0/hdl"incdir="../../../../ZedCamTest.srcs/sources_1/bd/bd/ip/bd_ZedCamAXI_0_0/src/clk_wiz_0/clk_wiz_v5_3_1"incdir="../../../ipstatic/axi_infrastructure_v1_1/hdl/verilog"incdir="../../../ipstatic/processing_system7_bfm_v2_0/hdl"
xpm_memory_sdpram.sv,systemverilog,xil_defaultlib,../../../../../../../Xilinx/Vivado/2016.2/data/ip/xpm/xpm_memory/hdl/xpm_memory_sdpram.sv,incdir="$ref_dir/../../../../ZedCamTest.srcs/sources_1/bd/bd/ip/bd_ZedCamAXI_0_0/src/clk_wiz_0/clk_wiz_v5_3_1"incdir="$ref_dir/../../../ipstatic/axi_infrastructure_v1_1/hdl/verilog"incdir="$ref_dir/../../../ipstatic/processing_system7_bfm_v2_0/hdl"incdir="../../../../ZedCamTest.srcs/sources_1/bd/bd/ip/bd_ZedCamAXI_0_0/src/clk_wiz_0/clk_wiz_v5_3_1"incdir="../../../ipstatic/axi_infrastructure_v1_1/hdl/verilog"incdir="../../../ipstatic/processing_system7_bfm_v2_0/hdl"
xpm_memory_spram.sv,systemverilog,xil_defaultlib,../../../../../../../Xilinx/Vivado/2016.2/data/ip/xpm/xpm_memory/hdl/xpm_memory_spram.sv,incdir="$ref_dir/../../../../ZedCamTest.srcs/sources_1/bd/bd/ip/bd_ZedCamAXI_0_0/src/clk_wiz_0/clk_wiz_v5_3_1"incdir="$ref_dir/../../../ipstatic/axi_infrastructure_v1_1/hdl/verilog"incdir="$ref_dir/../../../ipstatic/processing_system7_bfm_v2_0/hdl"incdir="../../../../ZedCamTest.srcs/sources_1/bd/bd/ip/bd_ZedCamAXI_0_0/src/clk_wiz_0/clk_wiz_v5_3_1"incdir="../../../ipstatic/axi_infrastructure_v1_1/hdl/verilog"incdir="../../../ipstatic/processing_system7_bfm_v2_0/hdl"
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
bd_rst_processing_system7_0_100M_0.vhd,vhdl,xil_defaultlib,../../../../ZedCamTest.srcs/sources_1/bd/bd/ip/bd_rst_processing_system7_0_100M_0_1/sim/bd_rst_processing_system7_0_100M_0.vhd,incdir="$ref_dir/../../../../ZedCamTest.srcs/sources_1/bd/bd/ip/bd_ZedCamAXI_0_0/src/clk_wiz_0/clk_wiz_v5_3_1"incdir="$ref_dir/../../../ipstatic/axi_infrastructure_v1_1/hdl/verilog"incdir="$ref_dir/../../../ipstatic/processing_system7_bfm_v2_0/hdl"incdir="../../../../ZedCamTest.srcs/sources_1/bd/bd/ip/bd_ZedCamAXI_0_0/src/clk_wiz_0/clk_wiz_v5_3_1"incdir="../../../ipstatic/axi_infrastructure_v1_1/hdl/verilog"incdir="../../../ipstatic/processing_system7_bfm_v2_0/hdl"
bd.v,verilog,xil_defaultlib,../../../../ZedCamTest.srcs/sources_1/bd/bd/hdl/bd.v,incdir="$ref_dir/../../../../ZedCamTest.srcs/sources_1/bd/bd/ip/bd_ZedCamAXI_0_0/src/clk_wiz_0/clk_wiz_v5_3_1"incdir="$ref_dir/../../../ipstatic/axi_infrastructure_v1_1/hdl/verilog"incdir="$ref_dir/../../../ipstatic/processing_system7_bfm_v2_0/hdl"incdir="../../../../ZedCamTest.srcs/sources_1/bd/bd/ip/bd_ZedCamAXI_0_0/src/clk_wiz_0/clk_wiz_v5_3_1"incdir="../../../ipstatic/axi_infrastructure_v1_1/hdl/verilog"incdir="../../../ipstatic/processing_system7_bfm_v2_0/hdl"
blk_mem_gen_v8_3.v,verilog,blk_mem_gen_v8_3_3,../../../../ZedCamTest.srcs/sources_1/bd/bd/ip/bd_ZedCamAXI_0_0/src/blk_mem_gen_0/blk_mem_gen_v8_3_3/simulation/blk_mem_gen_v8_3.v,incdir="$ref_dir/../../../../ZedCamTest.srcs/sources_1/bd/bd/ip/bd_ZedCamAXI_0_0/src/clk_wiz_0/clk_wiz_v5_3_1"incdir="$ref_dir/../../../ipstatic/axi_infrastructure_v1_1/hdl/verilog"incdir="$ref_dir/../../../ipstatic/processing_system7_bfm_v2_0/hdl"incdir="../../../../ZedCamTest.srcs/sources_1/bd/bd/ip/bd_ZedCamAXI_0_0/src/clk_wiz_0/clk_wiz_v5_3_1"incdir="../../../ipstatic/axi_infrastructure_v1_1/hdl/verilog"incdir="../../../ipstatic/processing_system7_bfm_v2_0/hdl"
blk_mem_gen_0.v,verilog,blk_mem_gen_v8_3_3,../../../../ZedCamTest.srcs/sources_1/bd/bd/ip/bd_ZedCamAXI_0_0/src/blk_mem_gen_0/sim/blk_mem_gen_0.v,incdir="$ref_dir/../../../../ZedCamTest.srcs/sources_1/bd/bd/ip/bd_ZedCamAXI_0_0/src/clk_wiz_0/clk_wiz_v5_3_1"incdir="$ref_dir/../../../ipstatic/axi_infrastructure_v1_1/hdl/verilog"incdir="$ref_dir/../../../ipstatic/processing_system7_bfm_v2_0/hdl"incdir="../../../../ZedCamTest.srcs/sources_1/bd/bd/ip/bd_ZedCamAXI_0_0/src/clk_wiz_0/clk_wiz_v5_3_1"incdir="../../../ipstatic/axi_infrastructure_v1_1/hdl/verilog"incdir="../../../ipstatic/processing_system7_bfm_v2_0/hdl"
clk_wiz_0_clk_wiz.v,verilog,xil_defaultlib,../../../../ZedCamTest.srcs/sources_1/bd/bd/ip/bd_ZedCamAXI_0_0/src/clk_wiz_0/clk_wiz_0_clk_wiz.v,incdir="$ref_dir/../../../../ZedCamTest.srcs/sources_1/bd/bd/ip/bd_ZedCamAXI_0_0/src/clk_wiz_0/clk_wiz_v5_3_1"incdir="$ref_dir/../../../ipstatic/axi_infrastructure_v1_1/hdl/verilog"incdir="$ref_dir/../../../ipstatic/processing_system7_bfm_v2_0/hdl"incdir="../../../../ZedCamTest.srcs/sources_1/bd/bd/ip/bd_ZedCamAXI_0_0/src/clk_wiz_0/clk_wiz_v5_3_1"incdir="../../../ipstatic/axi_infrastructure_v1_1/hdl/verilog"incdir="../../../ipstatic/processing_system7_bfm_v2_0/hdl"
clk_wiz_0.v,verilog,xil_defaultlib,../../../../ZedCamTest.srcs/sources_1/bd/bd/ip/bd_ZedCamAXI_0_0/src/clk_wiz_0/clk_wiz_0.v,incdir="$ref_dir/../../../../ZedCamTest.srcs/sources_1/bd/bd/ip/bd_ZedCamAXI_0_0/src/clk_wiz_0/clk_wiz_v5_3_1"incdir="$ref_dir/../../../ipstatic/axi_infrastructure_v1_1/hdl/verilog"incdir="$ref_dir/../../../ipstatic/processing_system7_bfm_v2_0/hdl"incdir="../../../../ZedCamTest.srcs/sources_1/bd/bd/ip/bd_ZedCamAXI_0_0/src/clk_wiz_0/clk_wiz_v5_3_1"incdir="../../../ipstatic/axi_infrastructure_v1_1/hdl/verilog"incdir="../../../ipstatic/processing_system7_bfm_v2_0/hdl"
vga_controller_640_60.vhd,vhdl,xil_defaultlib,../../../../ZedCamTest.srcs/sources_1/bd/bd/ipshared/xilinx.com/zedcamaxi_v0_1/src/vga_controller_640_60.vhd,incdir="$ref_dir/../../../../ZedCamTest.srcs/sources_1/bd/bd/ip/bd_ZedCamAXI_0_0/src/clk_wiz_0/clk_wiz_v5_3_1"incdir="$ref_dir/../../../ipstatic/axi_infrastructure_v1_1/hdl/verilog"incdir="$ref_dir/../../../ipstatic/processing_system7_bfm_v2_0/hdl"incdir="../../../../ZedCamTest.srcs/sources_1/bd/bd/ip/bd_ZedCamAXI_0_0/src/clk_wiz_0/clk_wiz_v5_3_1"incdir="../../../ipstatic/axi_infrastructure_v1_1/hdl/verilog"incdir="../../../ipstatic/processing_system7_bfm_v2_0/hdl"
imgbuf.v,verilog,xil_defaultlib,../../../../ZedCamTest.srcs/sources_1/bd/bd/ipshared/xilinx.com/zedcamaxi_v0_1/src/imgbuf.v,incdir="$ref_dir/../../../../ZedCamTest.srcs/sources_1/bd/bd/ip/bd_ZedCamAXI_0_0/src/clk_wiz_0/clk_wiz_v5_3_1"incdir="$ref_dir/../../../ipstatic/axi_infrastructure_v1_1/hdl/verilog"incdir="$ref_dir/../../../ipstatic/processing_system7_bfm_v2_0/hdl"incdir="../../../../ZedCamTest.srcs/sources_1/bd/bd/ip/bd_ZedCamAXI_0_0/src/clk_wiz_0/clk_wiz_v5_3_1"incdir="../../../ipstatic/axi_infrastructure_v1_1/hdl/verilog"incdir="../../../ipstatic/processing_system7_bfm_v2_0/hdl"
debounce.v,verilog,xil_defaultlib,../../../../ZedCamTest.srcs/sources_1/bd/bd/ipshared/xilinx.com/zedcamaxi_v0_1/src/debounce.v,incdir="$ref_dir/../../../../ZedCamTest.srcs/sources_1/bd/bd/ip/bd_ZedCamAXI_0_0/src/clk_wiz_0/clk_wiz_v5_3_1"incdir="$ref_dir/../../../ipstatic/axi_infrastructure_v1_1/hdl/verilog"incdir="$ref_dir/../../../ipstatic/processing_system7_bfm_v2_0/hdl"incdir="../../../../ZedCamTest.srcs/sources_1/bd/bd/ip/bd_ZedCamAXI_0_0/src/clk_wiz_0/clk_wiz_v5_3_1"incdir="../../../ipstatic/axi_infrastructure_v1_1/hdl/verilog"incdir="../../../ipstatic/processing_system7_bfm_v2_0/hdl"
clk_divs.v,verilog,xil_defaultlib,../../../../ZedCamTest.srcs/sources_1/bd/bd/ipshared/xilinx.com/zedcamaxi_v0_1/src/clk_divs.v,incdir="$ref_dir/../../../../ZedCamTest.srcs/sources_1/bd/bd/ip/bd_ZedCamAXI_0_0/src/clk_wiz_0/clk_wiz_v5_3_1"incdir="$ref_dir/../../../ipstatic/axi_infrastructure_v1_1/hdl/verilog"incdir="$ref_dir/../../../ipstatic/processing_system7_bfm_v2_0/hdl"incdir="../../../../ZedCamTest.srcs/sources_1/bd/bd/ip/bd_ZedCamAXI_0_0/src/clk_wiz_0/clk_wiz_v5_3_1"incdir="../../../ipstatic/axi_infrastructure_v1_1/hdl/verilog"incdir="../../../ipstatic/processing_system7_bfm_v2_0/hdl"
ZedCamTest_top.v,verilog,xil_defaultlib,../../../../ZedCamTest.srcs/sources_1/bd/bd/ipshared/xilinx.com/zedcamaxi_v0_1/src/ZedCamTest_top.v,incdir="$ref_dir/../../../../ZedCamTest.srcs/sources_1/bd/bd/ip/bd_ZedCamAXI_0_0/src/clk_wiz_0/clk_wiz_v5_3_1"incdir="$ref_dir/../../../ipstatic/axi_infrastructure_v1_1/hdl/verilog"incdir="$ref_dir/../../../ipstatic/processing_system7_bfm_v2_0/hdl"incdir="../../../../ZedCamTest.srcs/sources_1/bd/bd/ip/bd_ZedCamAXI_0_0/src/clk_wiz_0/clk_wiz_v5_3_1"incdir="../../../ipstatic/axi_infrastructure_v1_1/hdl/verilog"incdir="../../../ipstatic/processing_system7_bfm_v2_0/hdl"
ZedCamAXI_v0_1_S_AXI.v,verilog,xil_defaultlib,../../../../ZedCamTest.srcs/sources_1/bd/bd/ipshared/xilinx.com/zedcamaxi_v0_1/hdl/ZedCamAXI_v0_1_S_AXI.v,incdir="$ref_dir/../../../../ZedCamTest.srcs/sources_1/bd/bd/ip/bd_ZedCamAXI_0_0/src/clk_wiz_0/clk_wiz_v5_3_1"incdir="$ref_dir/../../../ipstatic/axi_infrastructure_v1_1/hdl/verilog"incdir="$ref_dir/../../../ipstatic/processing_system7_bfm_v2_0/hdl"incdir="../../../../ZedCamTest.srcs/sources_1/bd/bd/ip/bd_ZedCamAXI_0_0/src/clk_wiz_0/clk_wiz_v5_3_1"incdir="../../../ipstatic/axi_infrastructure_v1_1/hdl/verilog"incdir="../../../ipstatic/processing_system7_bfm_v2_0/hdl"
ZedCamAXI_v0_1.v,verilog,xil_defaultlib,../../../../ZedCamTest.srcs/sources_1/bd/bd/ipshared/xilinx.com/zedcamaxi_v0_1/hdl/ZedCamAXI_v0_1.v,incdir="$ref_dir/../../../../ZedCamTest.srcs/sources_1/bd/bd/ip/bd_ZedCamAXI_0_0/src/clk_wiz_0/clk_wiz_v5_3_1"incdir="$ref_dir/../../../ipstatic/axi_infrastructure_v1_1/hdl/verilog"incdir="$ref_dir/../../../ipstatic/processing_system7_bfm_v2_0/hdl"incdir="../../../../ZedCamTest.srcs/sources_1/bd/bd/ip/bd_ZedCamAXI_0_0/src/clk_wiz_0/clk_wiz_v5_3_1"incdir="../../../ipstatic/axi_infrastructure_v1_1/hdl/verilog"incdir="../../../ipstatic/processing_system7_bfm_v2_0/hdl"
bd_ZedCamAXI_0_0.v,verilog,xil_defaultlib,../../../../ZedCamTest.srcs/sources_1/bd/bd/ip/bd_ZedCamAXI_0_0/sim/bd_ZedCamAXI_0_0.v,incdir="$ref_dir/../../../../ZedCamTest.srcs/sources_1/bd/bd/ip/bd_ZedCamAXI_0_0/src/clk_wiz_0/clk_wiz_v5_3_1"incdir="$ref_dir/../../../ipstatic/axi_infrastructure_v1_1/hdl/verilog"incdir="$ref_dir/../../../ipstatic/processing_system7_bfm_v2_0/hdl"incdir="../../../../ZedCamTest.srcs/sources_1/bd/bd/ip/bd_ZedCamAXI_0_0/src/clk_wiz_0/clk_wiz_v5_3_1"incdir="../../../ipstatic/axi_infrastructure_v1_1/hdl/verilog"incdir="../../../ipstatic/processing_system7_bfm_v2_0/hdl"
generic_baseblocks_v2_1_carry_and.v,verilog,generic_baseblocks_v2_1_0,../../../ipstatic/generic_baseblocks_v2_1/hdl/verilog/generic_baseblocks_v2_1_carry_and.v,incdir="$ref_dir/../../../../ZedCamTest.srcs/sources_1/bd/bd/ip/bd_ZedCamAXI_0_0/src/clk_wiz_0/clk_wiz_v5_3_1"incdir="$ref_dir/../../../ipstatic/axi_infrastructure_v1_1/hdl/verilog"incdir="$ref_dir/../../../ipstatic/processing_system7_bfm_v2_0/hdl"incdir="../../../../ZedCamTest.srcs/sources_1/bd/bd/ip/bd_ZedCamAXI_0_0/src/clk_wiz_0/clk_wiz_v5_3_1"incdir="../../../ipstatic/axi_infrastructure_v1_1/hdl/verilog"incdir="../../../ipstatic/processing_system7_bfm_v2_0/hdl"
generic_baseblocks_v2_1_carry_latch_and.v,verilog,generic_baseblocks_v2_1_0,../../../ipstatic/generic_baseblocks_v2_1/hdl/verilog/generic_baseblocks_v2_1_carry_latch_and.v,incdir="$ref_dir/../../../../ZedCamTest.srcs/sources_1/bd/bd/ip/bd_ZedCamAXI_0_0/src/clk_wiz_0/clk_wiz_v5_3_1"incdir="$ref_dir/../../../ipstatic/axi_infrastructure_v1_1/hdl/verilog"incdir="$ref_dir/../../../ipstatic/processing_system7_bfm_v2_0/hdl"incdir="../../../../ZedCamTest.srcs/sources_1/bd/bd/ip/bd_ZedCamAXI_0_0/src/clk_wiz_0/clk_wiz_v5_3_1"incdir="../../../ipstatic/axi_infrastructure_v1_1/hdl/verilog"incdir="../../../ipstatic/processing_system7_bfm_v2_0/hdl"
generic_baseblocks_v2_1_carry_latch_or.v,verilog,generic_baseblocks_v2_1_0,../../../ipstatic/generic_baseblocks_v2_1/hdl/verilog/generic_baseblocks_v2_1_carry_latch_or.v,incdir="$ref_dir/../../../../ZedCamTest.srcs/sources_1/bd/bd/ip/bd_ZedCamAXI_0_0/src/clk_wiz_0/clk_wiz_v5_3_1"incdir="$ref_dir/../../../ipstatic/axi_infrastructure_v1_1/hdl/verilog"incdir="$ref_dir/../../../ipstatic/processing_system7_bfm_v2_0/hdl"incdir="../../../../ZedCamTest.srcs/sources_1/bd/bd/ip/bd_ZedCamAXI_0_0/src/clk_wiz_0/clk_wiz_v5_3_1"incdir="../../../ipstatic/axi_infrastructure_v1_1/hdl/verilog"incdir="../../../ipstatic/processing_system7_bfm_v2_0/hdl"
generic_baseblocks_v2_1_carry_or.v,verilog,generic_baseblocks_v2_1_0,../../../ipstatic/generic_baseblocks_v2_1/hdl/verilog/generic_baseblocks_v2_1_carry_or.v,incdir="$ref_dir/../../../../ZedCamTest.srcs/sources_1/bd/bd/ip/bd_ZedCamAXI_0_0/src/clk_wiz_0/clk_wiz_v5_3_1"incdir="$ref_dir/../../../ipstatic/axi_infrastructure_v1_1/hdl/verilog"incdir="$ref_dir/../../../ipstatic/processing_system7_bfm_v2_0/hdl"incdir="../../../../ZedCamTest.srcs/sources_1/bd/bd/ip/bd_ZedCamAXI_0_0/src/clk_wiz_0/clk_wiz_v5_3_1"incdir="../../../ipstatic/axi_infrastructure_v1_1/hdl/verilog"incdir="../../../ipstatic/processing_system7_bfm_v2_0/hdl"
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
fifo_generator_vlog_beh.v,verilog,fifo_generator_v13_1_1,../../../ipstatic/fifo_generator_v13_1/simulation/fifo_generator_vlog_beh.v,incdir="$ref_dir/../../../../ZedCamTest.srcs/sources_1/bd/bd/ip/bd_ZedCamAXI_0_0/src/clk_wiz_0/clk_wiz_v5_3_1"incdir="$ref_dir/../../../ipstatic/axi_infrastructure_v1_1/hdl/verilog"incdir="$ref_dir/../../../ipstatic/processing_system7_bfm_v2_0/hdl"incdir="../../../../ZedCamTest.srcs/sources_1/bd/bd/ip/bd_ZedCamAXI_0_0/src/clk_wiz_0/clk_wiz_v5_3_1"incdir="../../../ipstatic/axi_infrastructure_v1_1/hdl/verilog"incdir="../../../ipstatic/processing_system7_bfm_v2_0/hdl"
fifo_generator_v13_1_rfs.vhd,vhdl,fifo_generator_v13_1_1,../../../ipstatic/fifo_generator_v13_1/hdl/fifo_generator_v13_1_rfs.vhd,incdir="$ref_dir/../../../../ZedCamTest.srcs/sources_1/bd/bd/ip/bd_ZedCamAXI_0_0/src/clk_wiz_0/clk_wiz_v5_3_1"incdir="$ref_dir/../../../ipstatic/axi_infrastructure_v1_1/hdl/verilog"incdir="$ref_dir/../../../ipstatic/processing_system7_bfm_v2_0/hdl"incdir="../../../../ZedCamTest.srcs/sources_1/bd/bd/ip/bd_ZedCamAXI_0_0/src/clk_wiz_0/clk_wiz_v5_3_1"incdir="../../../ipstatic/axi_infrastructure_v1_1/hdl/verilog"incdir="../../../ipstatic/processing_system7_bfm_v2_0/hdl"
fifo_generator_v13_1_rfs.v,verilog,fifo_generator_v13_1_1,../../../ipstatic/fifo_generator_v13_1/hdl/fifo_generator_v13_1_rfs.v,incdir="$ref_dir/../../../../ZedCamTest.srcs/sources_1/bd/bd/ip/bd_ZedCamAXI_0_0/src/clk_wiz_0/clk_wiz_v5_3_1"incdir="$ref_dir/../../../ipstatic/axi_infrastructure_v1_1/hdl/verilog"incdir="$ref_dir/../../../ipstatic/processing_system7_bfm_v2_0/hdl"incdir="../../../../ZedCamTest.srcs/sources_1/bd/bd/ip/bd_ZedCamAXI_0_0/src/clk_wiz_0/clk_wiz_v5_3_1"incdir="../../../ipstatic/axi_infrastructure_v1_1/hdl/verilog"incdir="../../../ipstatic/processing_system7_bfm_v2_0/hdl"
axi_data_fifo_v2_1_axic_fifo.v,verilog,axi_data_fifo_v2_1_8,../../../ipstatic/axi_data_fifo_v2_1/hdl/verilog/axi_data_fifo_v2_1_axic_fifo.v,incdir="$ref_dir/../../../../ZedCamTest.srcs/sources_1/bd/bd/ip/bd_ZedCamAXI_0_0/src/clk_wiz_0/clk_wiz_v5_3_1"incdir="$ref_dir/../../../ipstatic/axi_infrastructure_v1_1/hdl/verilog"incdir="$ref_dir/../../../ipstatic/processing_system7_bfm_v2_0/hdl"incdir="../../../../ZedCamTest.srcs/sources_1/bd/bd/ip/bd_ZedCamAXI_0_0/src/clk_wiz_0/clk_wiz_v5_3_1"incdir="../../../ipstatic/axi_infrastructure_v1_1/hdl/verilog"incdir="../../../ipstatic/processing_system7_bfm_v2_0/hdl"
axi_data_fifo_v2_1_fifo_gen.v,verilog,axi_data_fifo_v2_1_8,../../../ipstatic/axi_data_fifo_v2_1/hdl/verilog/axi_data_fifo_v2_1_fifo_gen.v,incdir="$ref_dir/../../../../ZedCamTest.srcs/sources_1/bd/bd/ip/bd_ZedCamAXI_0_0/src/clk_wiz_0/clk_wiz_v5_3_1"incdir="$ref_dir/../../../ipstatic/axi_infrastructure_v1_1/hdl/verilog"incdir="$ref_dir/../../../ipstatic/processing_system7_bfm_v2_0/hdl"incdir="../../../../ZedCamTest.srcs/sources_1/bd/bd/ip/bd_ZedCamAXI_0_0/src/clk_wiz_0/clk_wiz_v5_3_1"incdir="../../../ipstatic/axi_infrastructure_v1_1/hdl/verilog"incdir="../../../ipstatic/processing_system7_bfm_v2_0/hdl"
axi_data_fifo_v2_1_axic_srl_fifo.v,verilog,axi_data_fifo_v2_1_8,../../../ipstatic/axi_data_fifo_v2_1/hdl/verilog/axi_data_fifo_v2_1_axic_srl_fifo.v,incdir="$ref_dir/../../../../ZedCamTest.srcs/sources_1/bd/bd/ip/bd_ZedCamAXI_0_0/src/clk_wiz_0/clk_wiz_v5_3_1"incdir="$ref_dir/../../../ipstatic/axi_infrastructure_v1_1/hdl/verilog"incdir="$ref_dir/../../../ipstatic/processing_system7_bfm_v2_0/hdl"incdir="../../../../ZedCamTest.srcs/sources_1/bd/bd/ip/bd_ZedCamAXI_0_0/src/clk_wiz_0/clk_wiz_v5_3_1"incdir="../../../ipstatic/axi_infrastructure_v1_1/hdl/verilog"incdir="../../../ipstatic/processing_system7_bfm_v2_0/hdl"
axi_data_fifo_v2_1_axic_reg_srl_fifo.v,verilog,axi_data_fifo_v2_1_8,../../../ipstatic/axi_data_fifo_v2_1/hdl/verilog/axi_data_fifo_v2_1_axic_reg_srl_fifo.v,incdir="$ref_dir/../../../../ZedCamTest.srcs/sources_1/bd/bd/ip/bd_ZedCamAXI_0_0/src/clk_wiz_0/clk_wiz_v5_3_1"incdir="$ref_dir/../../../ipstatic/axi_infrastructure_v1_1/hdl/verilog"incdir="$ref_dir/../../../ipstatic/processing_system7_bfm_v2_0/hdl"incdir="../../../../ZedCamTest.srcs/sources_1/bd/bd/ip/bd_ZedCamAXI_0_0/src/clk_wiz_0/clk_wiz_v5_3_1"incdir="../../../ipstatic/axi_infrastructure_v1_1/hdl/verilog"incdir="../../../ipstatic/processing_system7_bfm_v2_0/hdl"
axi_data_fifo_v2_1_ndeep_srl.v,verilog,axi_data_fifo_v2_1_8,../../../ipstatic/axi_data_fifo_v2_1/hdl/verilog/axi_data_fifo_v2_1_ndeep_srl.v,incdir="$ref_dir/../../../../ZedCamTest.srcs/sources_1/bd/bd/ip/bd_ZedCamAXI_0_0/src/clk_wiz_0/clk_wiz_v5_3_1"incdir="$ref_dir/../../../ipstatic/axi_infrastructure_v1_1/hdl/verilog"incdir="$ref_dir/../../../ipstatic/processing_system7_bfm_v2_0/hdl"incdir="../../../../ZedCamTest.srcs/sources_1/bd/bd/ip/bd_ZedCamAXI_0_0/src/clk_wiz_0/clk_wiz_v5_3_1"incdir="../../../ipstatic/axi_infrastructure_v1_1/hdl/verilog"incdir="../../../ipstatic/processing_system7_bfm_v2_0/hdl"
axi_data_fifo_v2_1_axi_data_fifo.v,verilog,axi_data_fifo_v2_1_8,../../../ipstatic/axi_data_fifo_v2_1/hdl/verilog/axi_data_fifo_v2_1_axi_data_fifo.v,incdir="$ref_dir/../../../../ZedCamTest.srcs/sources_1/bd/bd/ip/bd_ZedCamAXI_0_0/src/clk_wiz_0/clk_wiz_v5_3_1"incdir="$ref_dir/../../../ipstatic/axi_infrastructure_v1_1/hdl/verilog"incdir="$ref_dir/../../../ipstatic/processing_system7_bfm_v2_0/hdl"incdir="../../../../ZedCamTest.srcs/sources_1/bd/bd/ip/bd_ZedCamAXI_0_0/src/clk_wiz_0/clk_wiz_v5_3_1"incdir="../../../ipstatic/axi_infrastructure_v1_1/hdl/verilog"incdir="../../../ipstatic/processing_system7_bfm_v2_0/hdl"
axi_crossbar_v2_1_addr_arbiter_sasd.v,verilog,axi_crossbar_v2_1_10,../../../ipstatic/axi_crossbar_v2_1/hdl/verilog/axi_crossbar_v2_1_addr_arbiter_sasd.v,incdir="$ref_dir/../../../../ZedCamTest.srcs/sources_1/bd/bd/ip/bd_ZedCamAXI_0_0/src/clk_wiz_0/clk_wiz_v5_3_1"incdir="$ref_dir/../../../ipstatic/axi_infrastructure_v1_1/hdl/verilog"incdir="$ref_dir/../../../ipstatic/processing_system7_bfm_v2_0/hdl"incdir="../../../../ZedCamTest.srcs/sources_1/bd/bd/ip/bd_ZedCamAXI_0_0/src/clk_wiz_0/clk_wiz_v5_3_1"incdir="../../../ipstatic/axi_infrastructure_v1_1/hdl/verilog"incdir="../../../ipstatic/processing_system7_bfm_v2_0/hdl"
axi_crossbar_v2_1_addr_arbiter.v,verilog,axi_crossbar_v2_1_10,../../../ipstatic/axi_crossbar_v2_1/hdl/verilog/axi_crossbar_v2_1_addr_arbiter.v,incdir="$ref_dir/../../../../ZedCamTest.srcs/sources_1/bd/bd/ip/bd_ZedCamAXI_0_0/src/clk_wiz_0/clk_wiz_v5_3_1"incdir="$ref_dir/../../../ipstatic/axi_infrastructure_v1_1/hdl/verilog"incdir="$ref_dir/../../../ipstatic/processing_system7_bfm_v2_0/hdl"incdir="../../../../ZedCamTest.srcs/sources_1/bd/bd/ip/bd_ZedCamAXI_0_0/src/clk_wiz_0/clk_wiz_v5_3_1"incdir="../../../ipstatic/axi_infrastructure_v1_1/hdl/verilog"incdir="../../../ipstatic/processing_system7_bfm_v2_0/hdl"
axi_crossbar_v2_1_addr_decoder.v,verilog,axi_crossbar_v2_1_10,../../../ipstatic/axi_crossbar_v2_1/hdl/verilog/axi_crossbar_v2_1_addr_decoder.v,incdir="$ref_dir/../../../../ZedCamTest.srcs/sources_1/bd/bd/ip/bd_ZedCamAXI_0_0/src/clk_wiz_0/clk_wiz_v5_3_1"incdir="$ref_dir/../../../ipstatic/axi_infrastructure_v1_1/hdl/verilog"incdir="$ref_dir/../../../ipstatic/processing_system7_bfm_v2_0/hdl"incdir="../../../../ZedCamTest.srcs/sources_1/bd/bd/ip/bd_ZedCamAXI_0_0/src/clk_wiz_0/clk_wiz_v5_3_1"incdir="../../../ipstatic/axi_infrastructure_v1_1/hdl/verilog"incdir="../../../ipstatic/processing_system7_bfm_v2_0/hdl"
axi_crossbar_v2_1_arbiter_resp.v,verilog,axi_crossbar_v2_1_10,../../../ipstatic/axi_crossbar_v2_1/hdl/verilog/axi_crossbar_v2_1_arbiter_resp.v,incdir="$ref_dir/../../../../ZedCamTest.srcs/sources_1/bd/bd/ip/bd_ZedCamAXI_0_0/src/clk_wiz_0/clk_wiz_v5_3_1"incdir="$ref_dir/../../../ipstatic/axi_infrastructure_v1_1/hdl/verilog"incdir="$ref_dir/../../../ipstatic/processing_system7_bfm_v2_0/hdl"incdir="../../../../ZedCamTest.srcs/sources_1/bd/bd/ip/bd_ZedCamAXI_0_0/src/clk_wiz_0/clk_wiz_v5_3_1"incdir="../../../ipstatic/axi_infrastructure_v1_1/hdl/verilog"incdir="../../../ipstatic/processing_system7_bfm_v2_0/hdl"
axi_crossbar_v2_1_crossbar_sasd.v,verilog,axi_crossbar_v2_1_10,../../../ipstatic/axi_crossbar_v2_1/hdl/verilog/axi_crossbar_v2_1_crossbar_sasd.v,incdir="$ref_dir/../../../../ZedCamTest.srcs/sources_1/bd/bd/ip/bd_ZedCamAXI_0_0/src/clk_wiz_0/clk_wiz_v5_3_1"incdir="$ref_dir/../../../ipstatic/axi_infrastructure_v1_1/hdl/verilog"incdir="$ref_dir/../../../ipstatic/processing_system7_bfm_v2_0/hdl"incdir="../../../../ZedCamTest.srcs/sources_1/bd/bd/ip/bd_ZedCamAXI_0_0/src/clk_wiz_0/clk_wiz_v5_3_1"incdir="../../../ipstatic/axi_infrastructure_v1_1/hdl/verilog"incdir="../../../ipstatic/processing_system7_bfm_v2_0/hdl"
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
axi_crossbar_v2_1_axi_crossbar.v,verilog,axi_crossbar_v2_1_10,../../../ipstatic/axi_crossbar_v2_1/hdl/verilog/axi_crossbar_v2_1_axi_crossbar.v,incdir="$ref_dir/../../../../ZedCamTest.srcs/sources_1/bd/bd/ip/bd_ZedCamAXI_0_0/src/clk_wiz_0/clk_wiz_v5_3_1"incdir="$ref_dir/../../../ipstatic/axi_infrastructure_v1_1/hdl/verilog"incdir="$ref_dir/../../../ipstatic/processing_system7_bfm_v2_0/hdl"incdir="../../../../ZedCamTest.srcs/sources_1/bd/bd/ip/bd_ZedCamAXI_0_0/src/clk_wiz_0/clk_wiz_v5_3_1"incdir="../../../ipstatic/axi_infrastructure_v1_1/hdl/verilog"incdir="../../../ipstatic/processing_system7_bfm_v2_0/hdl"
bd_xbar_1.v,verilog,xil_defaultlib,../../../../ZedCamTest.srcs/sources_1/bd/bd/ip/bd_xbar_1/sim/bd_xbar_1.v,incdir="$ref_dir/../../../../ZedCamTest.srcs/sources_1/bd/bd/ip/bd_ZedCamAXI_0_0/src/clk_wiz_0/clk_wiz_v5_3_1"incdir="$ref_dir/../../../ipstatic/axi_infrastructure_v1_1/hdl/verilog"incdir="$ref_dir/../../../ipstatic/processing_system7_bfm_v2_0/hdl"incdir="../../../../ZedCamTest.srcs/sources_1/bd/bd/ip/bd_ZedCamAXI_0_0/src/clk_wiz_0/clk_wiz_v5_3_1"incdir="../../../ipstatic/axi_infrastructure_v1_1/hdl/verilog"incdir="../../../ipstatic/processing_system7_bfm_v2_0/hdl"
axi_protocol_converter_v2_1_a_axi3_conv.v,verilog,axi_protocol_converter_v2_1_9,../../../ipstatic/axi_protocol_converter_v2_1/hdl/verilog/axi_protocol_converter_v2_1_a_axi3_conv.v,incdir="$ref_dir/../../../../ZedCamTest.srcs/sources_1/bd/bd/ip/bd_ZedCamAXI_0_0/src/clk_wiz_0/clk_wiz_v5_3_1"incdir="$ref_dir/../../../ipstatic/axi_infrastructure_v1_1/hdl/verilog"incdir="$ref_dir/../../../ipstatic/processing_system7_bfm_v2_0/hdl"incdir="../../../../ZedCamTest.srcs/sources_1/bd/bd/ip/bd_ZedCamAXI_0_0/src/clk_wiz_0/clk_wiz_v5_3_1"incdir="../../../ipstatic/axi_infrastructure_v1_1/hdl/verilog"incdir="../../../ipstatic/processing_system7_bfm_v2_0/hdl"
axi_protocol_converter_v2_1_axi3_conv.v,verilog,axi_protocol_converter_v2_1_9,../../../ipstatic/axi_protocol_converter_v2_1/hdl/verilog/axi_protocol_converter_v2_1_axi3_conv.v,incdir="$ref_dir/../../../../ZedCamTest.srcs/sources_1/bd/bd/ip/bd_ZedCamAXI_0_0/src/clk_wiz_0/clk_wiz_v5_3_1"incdir="$ref_dir/../../../ipstatic/axi_infrastructure_v1_1/hdl/verilog"incdir="$ref_dir/../../../ipstatic/processing_system7_bfm_v2_0/hdl"incdir="../../../../ZedCamTest.srcs/sources_1/bd/bd/ip/bd_ZedCamAXI_0_0/src/clk_wiz_0/clk_wiz_v5_3_1"incdir="../../../ipstatic/axi_infrastructure_v1_1/hdl/verilog"incdir="../../../ipstatic/processing_system7_bfm_v2_0/hdl"
axi_protocol_converter_v2_1_axilite_conv.v,verilog,axi_protocol_converter_v2_1_9,../../../ipstatic/axi_protocol_converter_v2_1/hdl/verilog/axi_protocol_converter_v2_1_axilite_conv.v,incdir="$ref_dir/../../../../ZedCamTest.srcs/sources_1/bd/bd/ip/bd_ZedCamAXI_0_0/src/clk_wiz_0/clk_wiz_v5_3_1"incdir="$ref_dir/../../../ipstatic/axi_infrastructure_v1_1/hdl/verilog"incdir="$ref_dir/../../../ipstatic/processing_system7_bfm_v2_0/hdl"incdir="../../../../ZedCamTest.srcs/sources_1/bd/bd/ip/bd_ZedCamAXI_0_0/src/clk_wiz_0/clk_wiz_v5_3_1"incdir="../../../ipstatic/axi_infrastructure_v1_1/hdl/verilog"incdir="../../../ipstatic/processing_system7_bfm_v2_0/hdl"
axi_protocol_converter_v2_1_r_axi3_conv.v,verilog,axi_protocol_converter_v2_1_9,../../../ipstatic/axi_protocol_converter_v2_1/hdl/verilog/axi_protocol_converter_v2_1_r_axi3_conv.v,incdir="$ref_dir/../../../../ZedCamTest.srcs/sources_1/bd/bd/ip/bd_ZedCamAXI_0_0/src/clk_wiz_0/clk_wiz_v5_3_1"incdir="$ref_dir/../../../ipstatic/axi_infrastructure_v1_1/hdl/verilog"incdir="$ref_dir/../../../ipstatic/processing_system7_bfm_v2_0/hdl"incdir="../../../../ZedCamTest.srcs/sources_1/bd/bd/ip/bd_ZedCamAXI_0_0/src/clk_wiz_0/clk_wiz_v5_3_1"incdir="../../../ipstatic/axi_infrastructure_v1_1/hdl/verilog"incdir="../../../ipstatic/processing_system7_bfm_v2_0/hdl"
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
axi_protocol_converter_v2_1_axi_protocol_converter.v,verilog,axi_protocol_converter_v2_1_9,../../../ipstatic/axi_protocol_converter_v2_1/hdl/verilog/axi_protocol_converter_v2_1_axi_protocol_converter.v,incdir="$ref_dir/../../../../ZedCamTest.srcs/sources_1/bd/bd/ip/bd_ZedCamAXI_0_0/src/clk_wiz_0/clk_wiz_v5_3_1"incdir="$ref_dir/../../../ipstatic/axi_infrastructure_v1_1/hdl/verilog"incdir="$ref_dir/../../../ipstatic/processing_system7_bfm_v2_0/hdl"incdir="../../../../ZedCamTest.srcs/sources_1/bd/bd/ip/bd_ZedCamAXI_0_0/src/clk_wiz_0/clk_wiz_v5_3_1"incdir="../../../ipstatic/axi_infrastructure_v1_1/hdl/verilog"incdir="../../../ipstatic/processing_system7_bfm_v2_0/hdl"
bd_auto_pc_0.v,verilog,xil_defaultlib,../../../../ZedCamTest.srcs/sources_1/bd/bd/ip/bd_auto_pc_0/sim/bd_auto_pc_0.v,incdir="$ref_dir/../../../../ZedCamTest.srcs/sources_1/bd/bd/ip/bd_ZedCamAXI_0_0/src/clk_wiz_0/clk_wiz_v5_3_1"incdir="$ref_dir/../../../ipstatic/axi_infrastructure_v1_1/hdl/verilog"incdir="$ref_dir/../../../ipstatic/processing_system7_bfm_v2_0/hdl"incdir="../../../../ZedCamTest.srcs/sources_1/bd/bd/ip/bd_ZedCamAXI_0_0/src/clk_wiz_0/clk_wiz_v5_3_1"incdir="../../../ipstatic/axi_infrastructure_v1_1/hdl/verilog"incdir="../../../ipstatic/processing_system7_bfm_v2_0/hdl"
bd_auto_pc_1.v,verilog,xil_defaultlib,../../../../ZedCamTest.srcs/sources_1/bd/bd/ip/bd_auto_pc_1/sim/bd_auto_pc_1.v,incdir="$ref_dir/../../../../ZedCamTest.srcs/sources_1/bd/bd/ip/bd_ZedCamAXI_0_0/src/clk_wiz_0/clk_wiz_v5_3_1"incdir="$ref_dir/../../../ipstatic/axi_infrastructure_v1_1/hdl/verilog"incdir="$ref_dir/../../../ipstatic/processing_system7_bfm_v2_0/hdl"incdir="../../../../ZedCamTest.srcs/sources_1/bd/bd/ip/bd_ZedCamAXI_0_0/src/clk_wiz_0/clk_wiz_v5_3_1"incdir="../../../ipstatic/axi_infrastructure_v1_1/hdl/verilog"incdir="../../../ipstatic/processing_system7_bfm_v2_0/hdl"
glbl.v,Verilog,xil_defaultlib,glbl.v
