glgauthier/MQP/report/figures/calibrated.png

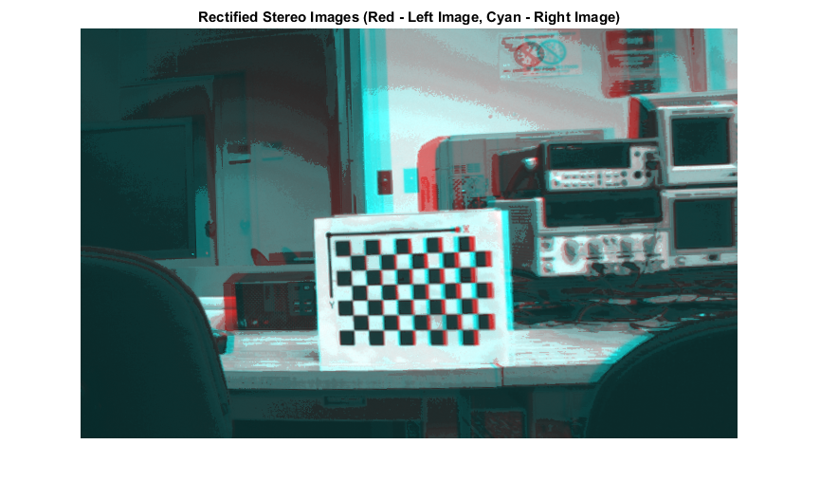
report/figures/calibrated.png
