glgauthier/MQP/report/figures/camera_test_zedboard.PNG

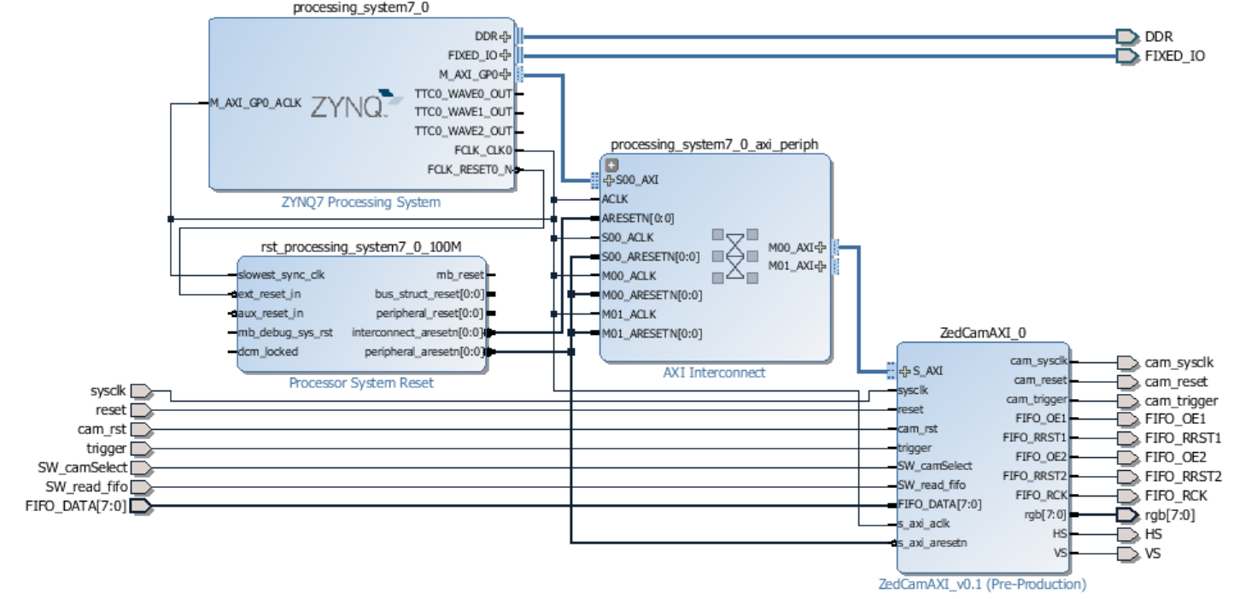
report/figures/camera_test_zedboard.PNG
