glgauthier/MQP/report/figures/disp_tb/result_comparison.png

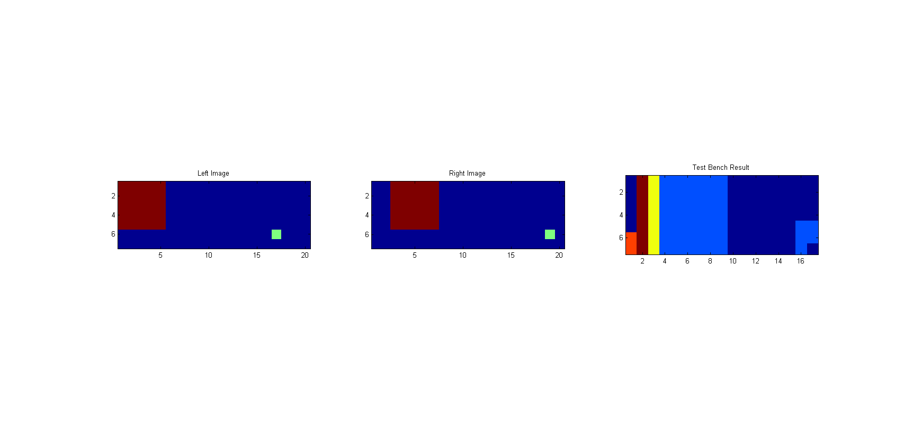
report/figures/disp_tb/result_comparison.png
