glgauthier/MQP/report/figures/resultant.png

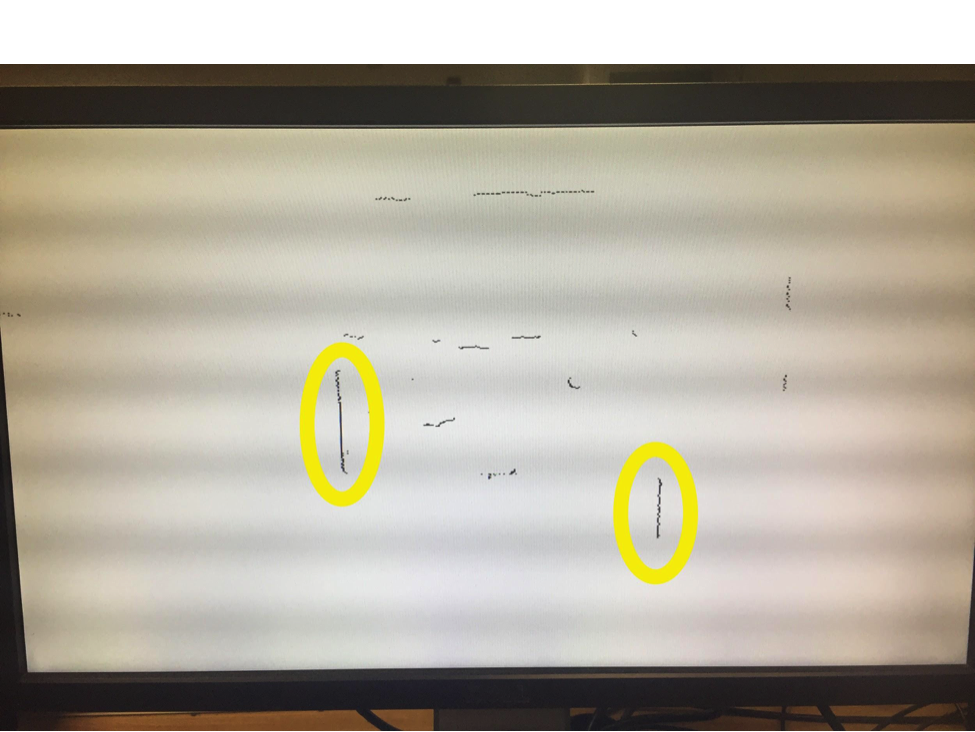
report/figures/resultant.png
