glgauthier/MQP/report/figures/uncalibrated.png

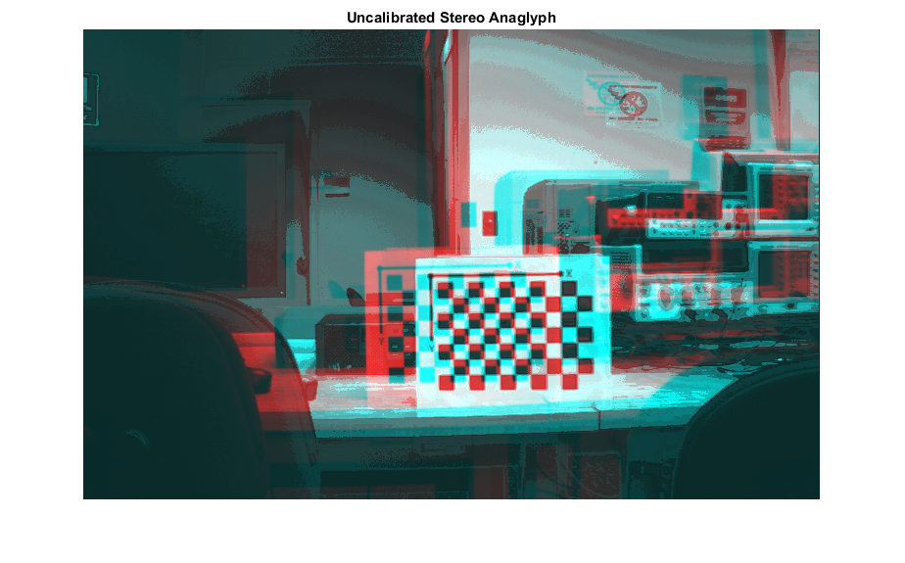
report/figures/uncalibrated.png
