glgauthier/MQP/PCB/camera_final/camera_final.brd

## EAGLE design PCB/camera_final/camera_final.brd (2016-07-29)

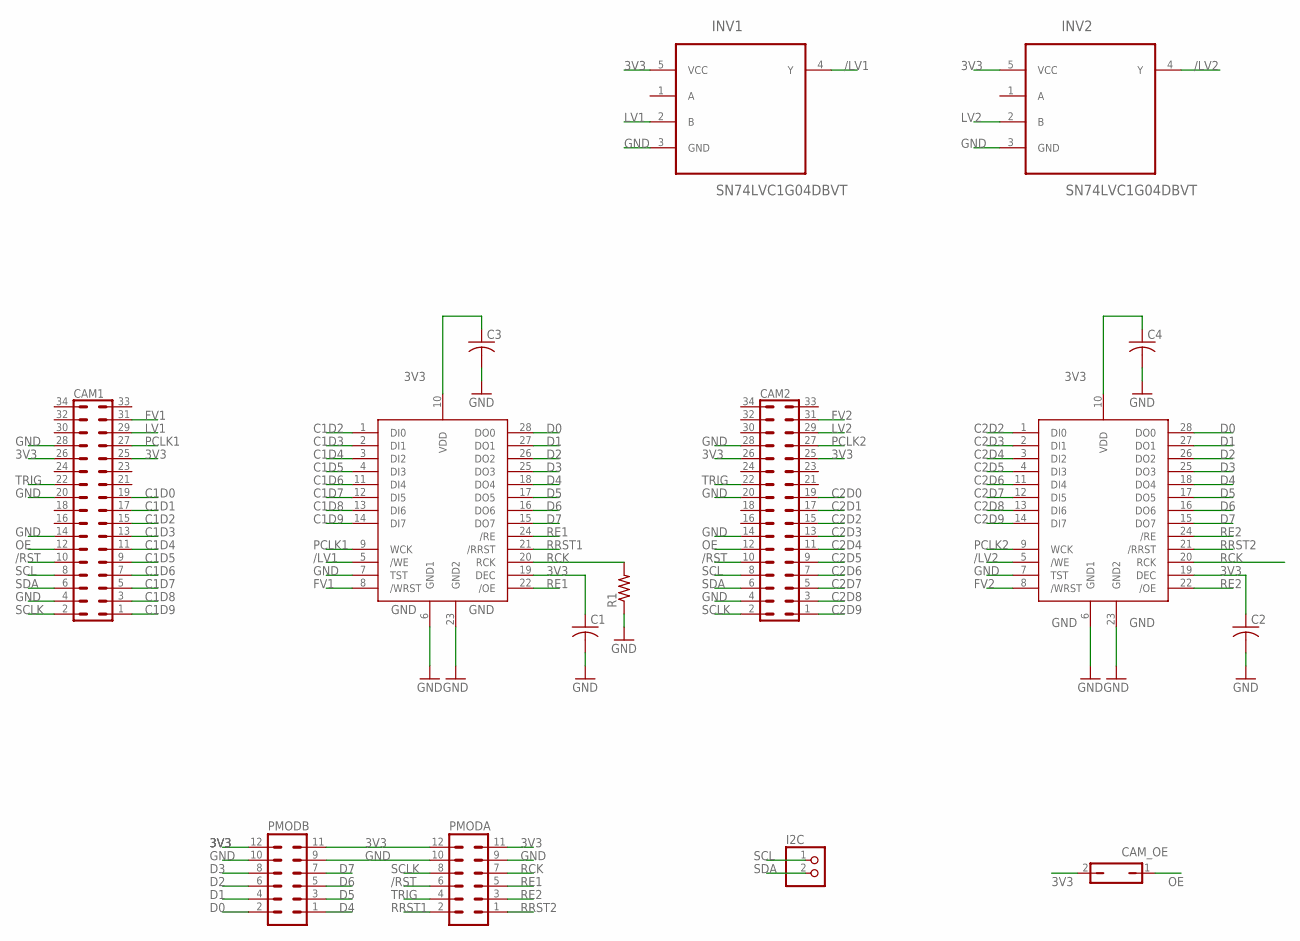
[picture p133: schematic camera_final.sch]

Parts:
C1, C2, C3, C4: C-USC0805K; C0805K
CAM1, CAM2: PHB_1MM27_2X17_SNT
CAM_OE: JP1Q; JP1
I2C: PINHD-1X2; 1X02
INV1, INV2: SN74LVC1G04DBVT; SOT95P280X145-5N
PMODA: MA06-2
PMODB: MA06-2
R1: R-US_R0805; R0805
U$1, U$2: AL422B; SOP28

Connections:
3V3: C1.1, C2.1, C3.1, C4.1, CAM1.25, CAM1.26, CAM2.25, CAM2.26, CAM_OE.2, INV1.5 (VCC), INV2.5 (VCC), PMODA.11, PMODA.12, PMODB.11, PMODB.12, U$1.10 (VDD), U$1.19 (DEC), U$2.10 (VDD), U$2.19 (DEC)
/LV1: INV1.4 (Y), U$2.5 (/WE)
/LV2: INV2.4 (Y), U$1.5 (/WE)
/RST: CAM1.10, CAM2.10, PMODA.6
C1D0: CAM1.19
C1D1: CAM1.17
C1D2: CAM1.15, U$2.1 (DI0)
C1D3: CAM1.13, U$2.2 (DI1)
C1D4: CAM1.11, U$2.3 (DI2)
C1D5: CAM1.9, U$2.4 (DI3)
C1D6: CAM1.7, U$2.11 (DI4)
C1D7: CAM1.5, U$2.12 (DI5)
C1D8: CAM1.3, U$2.13 (DI6)
C1D9: CAM1.1, U$2.14 (DI7)
C2D0: CAM2.19
C2D1: CAM2.17
C2D2: CAM2.15, U$1.1 (DI0)
C2D3: CAM2.13, U$1.2 (DI1)
C2D4: CAM2.11, U$1.3 (DI2)
C2D5: CAM2.9, U$1.4 (DI3)
C2D6: CAM2.7, U$1.11 (DI4)
C2D7: CAM2.5, U$1.12 (DI5)
C2D8: CAM2.3, U$1.13 (DI6)
C2D9: CAM2.1, U$1.14 (DI7)
D0: PMODB.2, U$1.28 (DO0), U$2.28 (DO0)
D1: PMODB.4, U$1.27 (DO1), U$2.27 (DO1)
D2: PMODB.6, U$1.26 (DO2), U$2.26 (DO2)
D3: PMODB.8, U$1.25 (DO3), U$2.25 (DO3)
D4: PMODB.1, U$1.18 (DO4), U$2.18 (DO4)
D5: PMODB.3, U$1.17 (DO5), U$2.17 (DO5)
D6: PMODB.5, U$1.16 (DO6), U$2.16 (DO6)
D7: PMODB.7, U$1.15 (DO7), U$2.15 (DO7)
FV1: CAM1.31, U$2.8 (/WRST)
FV2: CAM2.31, U$1.8 (/WRST)
GND: C1.2, C2.2, C3.2, C4.2, CAM1.4, CAM1.14, CAM1.20, CAM1.28, CAM2.4, CAM2.14, CAM2.20, CAM2.28, INV1.3 (GND), INV2.3 (GND), PMODA.9, PMODA.10, PMODB.9, PMODB.10, R1.1, U$1.6 (GND1), U$1.7 (TST), U$1.23 (GND2), U$2.6 (GND1), U$2.7 (TST), U$2.23 (GND2)
LV1: CAM1.29, INV1.2 (B)
LV2: CAM2.29, INV2.2 (B)
OE: CAM1.12, CAM2.12, CAM_OE.1
PCLK1: CAM1.27, U$2.9 (WCK)
PCLK2: CAM2.27, U$1.9 (WCK)
RCK: PMODA.7, R1.2, U$1.20 (RCK), U$2.20 (RCK)
RE1: PMODA.5, U$2.22 (/OE), U$2.24 (/RE)
RE2: PMODA.3, U$1.22 (/OE), U$1.24 (/RE)
RRST1: PMODA.2, U$2.21 (/RRST)
RRST2: PMODA.1, U$1.21 (/RRST)
SCL: CAM1.8, CAM2.8, I2C.1
SCLK: CAM1.2, CAM2.2, PMODA.8
SDA: CAM1.6, CAM2.6, I2C.2
TRIG: CAM1.22, CAM2.22, PMODA.4

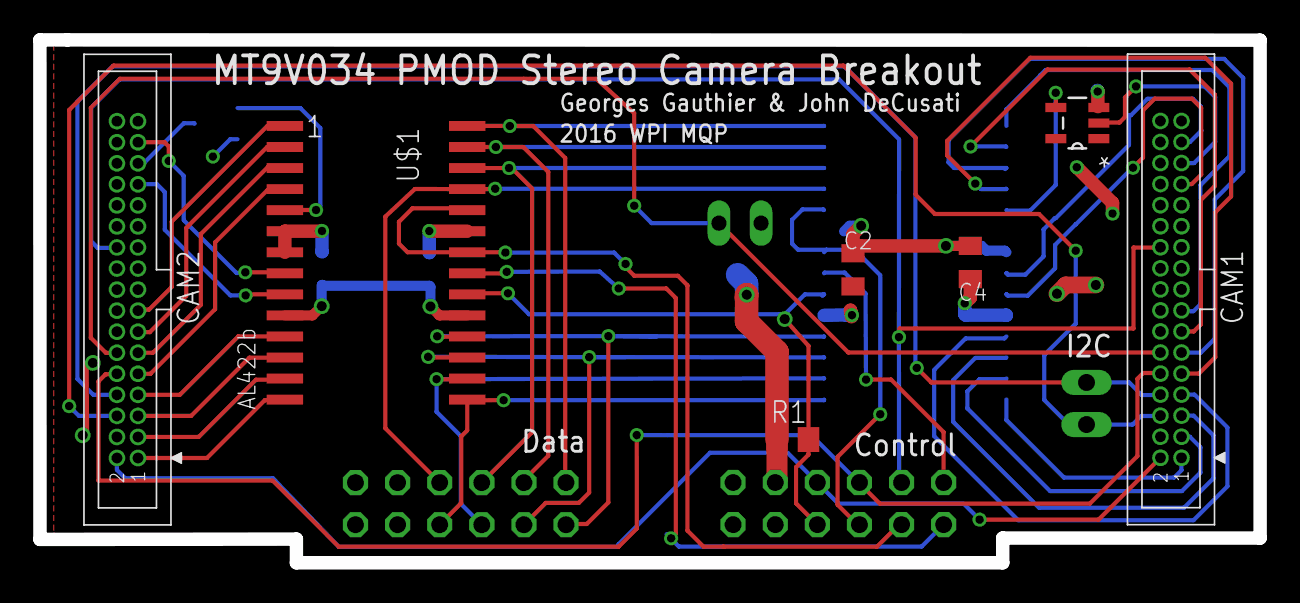
[picture p134: board camera_final.brd from above]

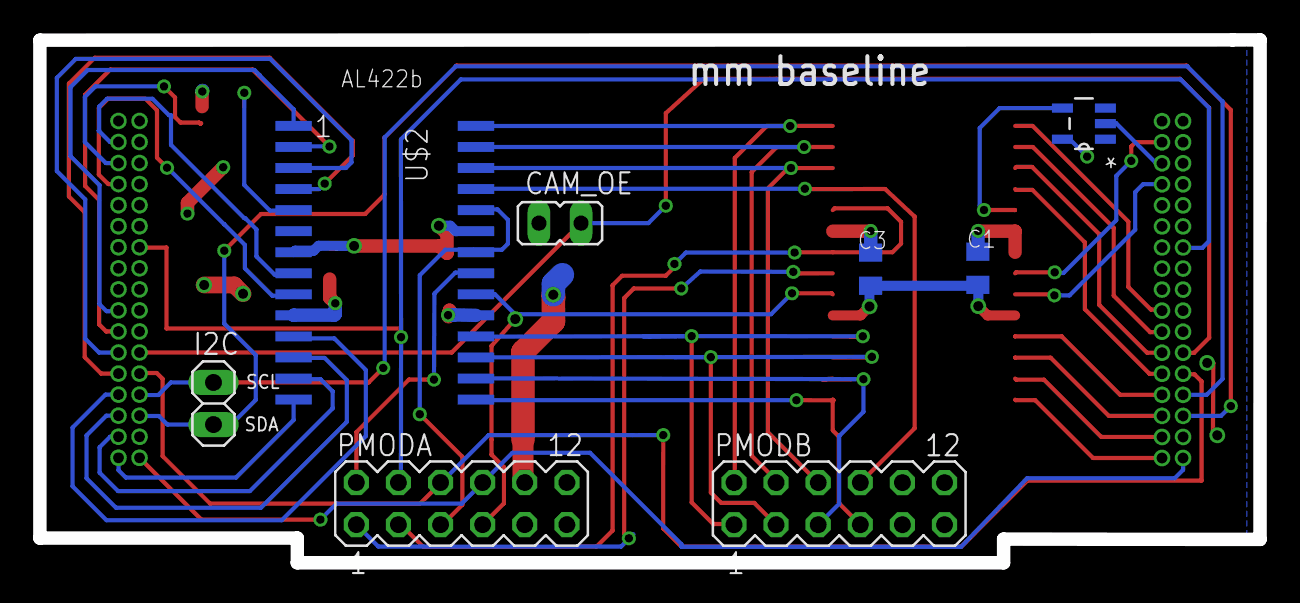
[picture p135: board camera_final.brd from below]

Board: 2 copper layers, 73.6 x 31.5 mm, 15 parts (8 on the bottom side), 45 nets.
