glgauthier/MQP/PCB/camera_breakout/schematic.brd

## EAGLE design PCB/camera_breakout/schematic.brd (2016-05-31)

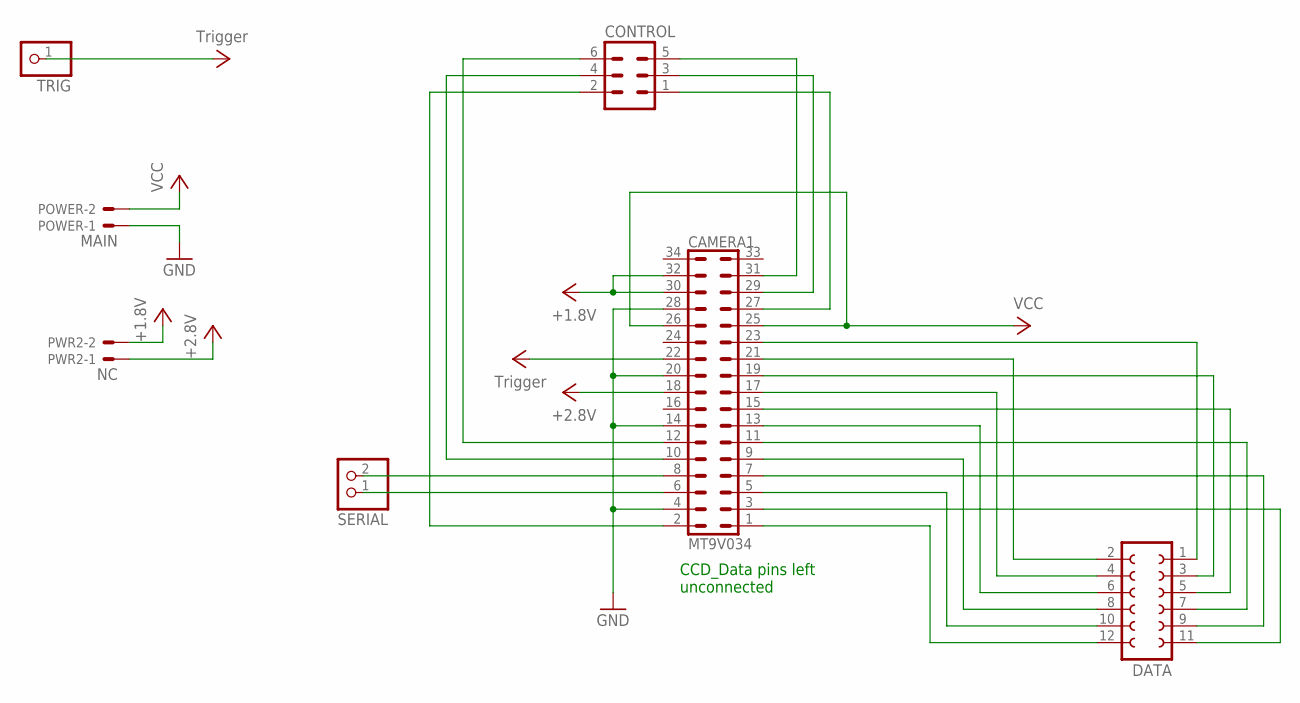
[picture p139: schematic schematic.sch]

Parts:
CAMERA1: MT9V034; PHB_1MM27_2X17_SNT
CONTROL: MA03-2
DATA: FE06-2
POWER: MAIN; 22-23-2021
PWR2: NC; 22-23-2021
SERIAL: PINHD-1X2; 1X02
TRIG: PINHD-1X1; 1X01

Connections:
1.8V: CAMERA1.30, CAMERA1.32, PWR2.2
2.8V: CAMERA1.18, PWR2.1
GND: CAMERA1.4, CAMERA1.14, CAMERA1.20, CAMERA1.28, POWER.1
unnamed: CAMERA1.23, DATA.1
unnamed: CAMERA1.21, DATA.2
unnamed: CAMERA1.19, DATA.3
unnamed: CAMERA1.17, DATA.4
unnamed: CAMERA1.15, DATA.5
unnamed: CAMERA1.13, DATA.6
unnamed: CAMERA1.11, DATA.7
unnamed: CAMERA1.9, DATA.8
unnamed: CAMERA1.7, DATA.9
unnamed: CAMERA1.5, DATA.10
unnamed: CAMERA1.3, DATA.11
unnamed: CAMERA1.1, DATA.12
unnamed: CAMERA1.12, CONTROL.6
unnamed: CAMERA1.10, CONTROL.4
unnamed: CAMERA1.2, CONTROL.2
unnamed: CAMERA1.31, CONTROL.5
unnamed: CAMERA1.29, CONTROL.3
unnamed: CAMERA1.27, CONTROL.1
unnamed: CAMERA1.8, SERIAL.2
unnamed: CAMERA1.6, SERIAL.1
TRIGGER: CAMERA1.22, TRIG.1
VCC: CAMERA1.25, CAMERA1.26, POWER.2

Notes on the sheet:
CCD_Data pins left unconnected

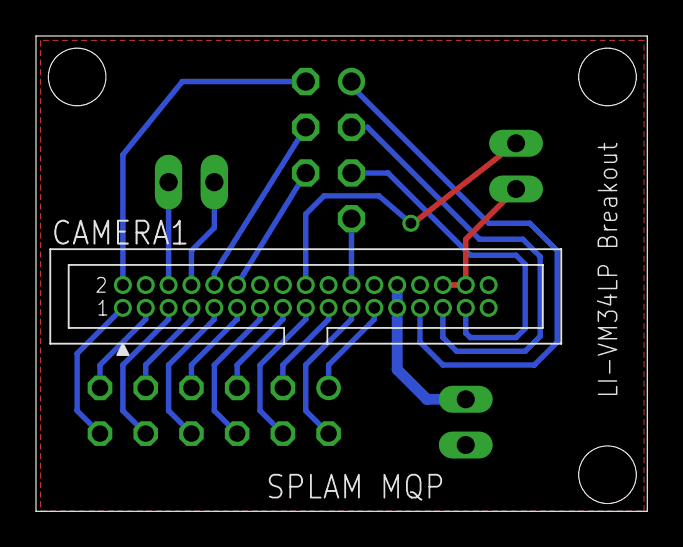
[picture p140: board schematic.brd from above]

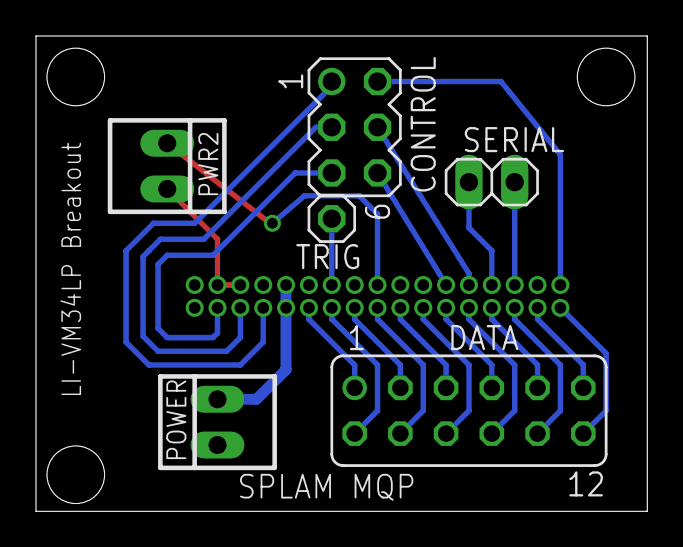
[picture p141: board schematic.brd from below]

Board: 2 copper layers, 34.0 x 26.4 mm, 7 parts (6 on the bottom side), 25 nets.
