glgauthier/MQP/final_implemention/final_implemention.srcs/constrs_1/new/mqp.xdc

create_clock -period 10.000 -name clock -add [get_ports fpga_clk]
set_property PACKAGE_PIN Y9 [get_ports fpga_clk]
set_property IOSTANDARD LVCMOS33 [get_ports fpga_clk]

set_property PACKAGE_PIN P16 [get_ports reset]
set_property PACKAGE_PIN R18 [get_ports button]
set_property PACKAGE_PIN T22 [get_ports {leds[0]}]
set_property PACKAGE_PIN T21 [get_ports {leds[1]}]
set_property PACKAGE_PIN U22 [get_ports {leds[2]}]
set_property PACKAGE_PIN U21 [get_ports {leds[3]}]
set_property PACKAGE_PIN V22 [get_ports {leds[4]}]
set_property PACKAGE_PIN W22 [get_ports {leds[5]}]
set_property PACKAGE_PIN U19 [get_ports {leds[6]}]
set_property PACKAGE_PIN U14 [get_ports {leds[7]}]

set_property PACKAGE_PIN V18 [get_ports {rgb[11]}]
set_property PACKAGE_PIN V19 [get_ports {rgb[10]}]
set_property PACKAGE_PIN U20 [get_ports {rgb[9]}]
set_property PACKAGE_PIN V20 [get_ports {rgb[8]}]
set_property PACKAGE_PIN AA21 [get_ports {rgb[7]}]
set_property PACKAGE_PIN AB21 [get_ports {rgb[6]}]
set_property PACKAGE_PIN AA22 [get_ports {rgb[5]}]
set_property PACKAGE_PIN AB22 [get_ports {rgb[4]}]
set_property PACKAGE_PIN AB19 [get_ports {rgb[3]}]
set_property PACKAGE_PIN AB20 [get_ports {rgb[2]}]
set_property PACKAGE_PIN Y20 [get_ports {rgb[1]}]
set_property PACKAGE_PIN Y21 [get_ports {rgb[0]}]
set_property PACKAGE_PIN AA19 [get_ports hsync]
set_property PACKAGE_PIN Y19 [get_ports vsync]

set_property IOSTANDARD LVCMOS33 [get_ports reset]
set_property IOSTANDARD LVCMOS33 [get_ports button]
set_property IOSTANDARD LVCMOS33 [get_ports {leds[0]}]
set_property IOSTANDARD LVCMOS33 [get_ports {leds[1]}]
set_property IOSTANDARD LVCMOS33 [get_ports {leds[2]}]
set_property IOSTANDARD LVCMOS33 [get_ports {leds[3]}]
set_property IOSTANDARD LVCMOS33 [get_ports {leds[4]}]
set_property IOSTANDARD LVCMOS33 [get_ports {leds[5]}]
set_property IOSTANDARD LVCMOS33 [get_ports {leds[6]}]
set_property IOSTANDARD LVCMOS33 [get_ports {leds[7]}]

set_property IOSTANDARD LVCMOS33 [get_ports {rgb[11]}]
set_property IOSTANDARD LVCMOS33 [get_ports {rgb[10]}]
set_property IOSTANDARD LVCMOS33 [get_ports {rgb[9]}]
set_property IOSTANDARD LVCMOS33 [get_ports {rgb[8]}]
set_property IOSTANDARD LVCMOS33 [get_ports {rgb[7]}]
set_property IOSTANDARD LVCMOS33 [get_ports {rgb[6]}]
set_property IOSTANDARD LVCMOS33 [get_ports {rgb[5]}]
set_property IOSTANDARD LVCMOS33 [get_ports {rgb[4]}]
set_property IOSTANDARD LVCMOS33 [get_ports {rgb[3]}]
set_property IOSTANDARD LVCMOS33 [get_ports {rgb[2]}]
set_property IOSTANDARD LVCMOS33 [get_ports {rgb[1]}]
set_property IOSTANDARD LVCMOS33 [get_ports {rgb[0]}]
set_property IOSTANDARD LVCMOS33 [get_ports hsync]
set_property IOSTANDARD LVCMOS33 [get_ports vsync]

#input cam_rst, // button for camera RESET_BAR
set_property PACKAGE_PIN N15 [get_ports cam_rst]
set_property IOSTANDARD LVCMOS33 [get_ports cam_rst]
#output cam_sysclk, // sysclk out to camera
set_property PACKAGE_PIN AA9 [get_ports cam_sysclk]
set_property IOSTANDARD LVCMOS33 [get_ports cam_sysclk]
#output cam_reset, // reset_bar out to camera
set_property PACKAGE_PIN Y10 [get_ports cam_reset]
set_property IOSTANDARD LVCMOS33 [get_ports cam_reset]
#output cam_trigger, // trigger out to camera
set_property PACKAGE_PIN AA11 [get_ports cam_trigger]
set_property IOSTANDARD LVCMOS33 [get_ports cam_trigger]
# FIFO_DATA [7:0]
set_property PACKAGE_PIN V8 [get_ports {FIFO_DATA[7]}]
set_property IOSTANDARD LVCMOS33 [get_ports {FIFO_DATA[7]}]
set_property PACKAGE_PIN V9 [get_ports {FIFO_DATA[6]}]
set_property IOSTANDARD LVCMOS33 [get_ports {FIFO_DATA[6]}]
set_property PACKAGE_PIN W10 [get_ports {FIFO_DATA[5]}]
set_property IOSTANDARD LVCMOS33 [get_ports {FIFO_DATA[5]}]
set_property PACKAGE_PIN V12 [get_ports {FIFO_DATA[4]}]
set_property IOSTANDARD LVCMOS33 [get_ports {FIFO_DATA[4]}]
set_property PACKAGE_PIN W8 [get_ports {FIFO_DATA[3]}]
set_property IOSTANDARD LVCMOS33 [get_ports {FIFO_DATA[3]}]
set_property PACKAGE_PIN V10 [get_ports {FIFO_DATA[2]}]
set_property IOSTANDARD LVCMOS33 [get_ports {FIFO_DATA[2]}]
set_property PACKAGE_PIN W11 [get_ports {FIFO_DATA[1]}]
set_property IOSTANDARD LVCMOS33 [get_ports {FIFO_DATA[1]}]
set_property PACKAGE_PIN W12 [get_ports {FIFO_DATA[0]}]
set_property IOSTANDARD LVCMOS33 [get_ports {FIFO_DATA[0]}]
#output FIFO_OE1, // read enable to fifo (active low)
set_property PACKAGE_PIN AB9 [get_ports FIFO_OE1]
set_property IOSTANDARD LVCMOS33 [get_ports FIFO_OE1]
#output FIFO_RRST1, // read reset to fifo (active low)
set_property PACKAGE_PIN Y11 [get_ports FIFO_RRST1]
set_property IOSTANDARD LVCMOS33 [get_ports FIFO_RRST1]
#output FIFO_OE2, // read enable to fifo (active low)
set_property PACKAGE_PIN AB10 [get_ports FIFO_OE2]
set_property IOSTANDARD LVCMOS33 [get_ports FIFO_OE2]
#output FIFO_RRST2, // read reset to fifo (active low)
set_property PACKAGE_PIN AB11 [get_ports FIFO_RRST2]
set_property IOSTANDARD LVCMOS33 [get_ports FIFO_RRST2]
#output FIFO_RCK, // rck to fifo (1MHz)
set_property PACKAGE_PIN AA8 [get_ports FIFO_RCK]
set_property IOSTANDARD LVCMOS33 [get_ports FIFO_RCK]


set_property PACKAGE_PIN F22 [get_ports {sw[0]}]
set_property IOSTANDARD LVCMOS33 [get_ports {sw[0]}]
set_property PACKAGE_PIN G22 [get_ports {sw[1]}]
set_property IOSTANDARD LVCMOS33 [get_ports {sw[1]}]
set_property PACKAGE_PIN H22 [get_ports {sw[2]}]
set_property IOSTANDARD LVCMOS33 [get_ports {sw[2]}]
set_property PACKAGE_PIN F21 [get_ports {sw[3]}]
set_property IOSTANDARD LVCMOS33 [get_ports {sw[3]}]
set_property PACKAGE_PIN H19 [get_ports {sw[4]}]
set_property IOSTANDARD LVCMOS33 [get_ports {sw[4]}]
set_property PACKAGE_PIN H18 [get_ports {sw[5]}]
set_property IOSTANDARD LVCMOS33 [get_ports {sw[5]}]
set_property PACKAGE_PIN H17 [get_ports {sw[6]}]
set_property IOSTANDARD LVCMOS33 [get_ports {sw[6]}]
set_property PACKAGE_PIN M15 [get_ports {sw[7]}]
set_property IOSTANDARD LVCMOS33 [get_ports {sw[7]}]

set_property PACKAGE_PIN U5 [get_ports {gpio_0_tri_io[1]}]
set_property PACKAGE_PIN V7 [get_ports {gpio_0_tri_io[0]}]
set_property IOSTANDARD LVCMOS33 [get_ports {gpio_0_tri_io[1]}]
set_property IOSTANDARD LVCMOS33 [get_ports {gpio_0_tri_io[0]}]
set_property PULLUP true [get_ports {gpio_0_tri_io[0]}]
set_property PULLUP true [get_ports {gpio_0_tri_io[1]}]
set_property PACKAGE_PIN W7 [get_ports spi_0_io0_io]
set_property PACKAGE_PIN V5 [get_ports spi_0_io1_io]
set_property PACKAGE_PIN V4 [get_ports spi_0_sck_io]
set_property PACKAGE_PIN U6 [get_ports spi_0_ss1_o]
set_property PACKAGE_PIN AB6 [get_ports spi_0_ss2_o]
set_property PACKAGE_PIN AB7 [get_ports spi_0_ss_io]
set_property IOSTANDARD LVCMOS33 [get_ports spi_0_io0_io]
set_property IOSTANDARD LVCMOS33 [get_ports spi_0_io1_io]
set_property IOSTANDARD LVCMOS33 [get_ports spi_0_sck_io]
set_property IOSTANDARD LVCMOS33 [get_ports spi_0_ss1_o]
set_property IOSTANDARD LVCMOS33 [get_ports spi_0_ss2_o]
set_property IOSTANDARD LVCMOS33 [get_ports spi_0_ss_io]
set_property PULLDOWN true [get_ports spi_0_sck_io]
