glgauthier/MQP/final_implemention/final_implemention.runs/design_1_synth_1/.Xil/design_1_propImpl.xdc

set_property SRC_FILE_INFO {cfile:c:/Users/georges/Documents/GitHub/MQP/final_implemention/final_implemention.srcs/sources_1/bd/design_1/ip/design_1_processing_system7_0_0/design_1_processing_system7_0_0.xdc rfile:../../../final_implemention.srcs/sources_1/bd/design_1/ip/design_1_processing_system7_0_0/design_1_processing_system7_0_0.xdc id:1 order:EARLY scoped_inst:processing_system7_0/inst} [current_design]
set_property SRC_FILE_INFO {cfile:c:/Users/georges/Documents/GitHub/MQP/final_implemention/final_implemention.srcs/sources_1/bd/design_1/ip/design_1_nu_nu_rangefinder_vga_0_0/src/clk_wiz_0_1/clk_wiz_0.xdc rfile:../../../final_implemention.srcs/sources_1/bd/design_1/ip/design_1_nu_nu_rangefinder_vga_0_0/src/clk_wiz_0_1/clk_wiz_0.xdc id:2 order:EARLY scoped_inst:custom_logic/inst/mqp_top/mmcm/inst} [current_design]
set_property src_info {type:SCOPED_XDC file:1 line:21 export:INPUT save:INPUT read:READ} [current_design]
set_input_jitter clk_fpga_0 0.3
set_property src_info {type:SCOPED_XDC file:1 line:31 export:INPUT save:INPUT read:READ} [current_design]
set_property PACKAGE_PIN "C12" [get_ports "MIO[53]"]
set_property src_info {type:SCOPED_XDC file:1 line:37 export:INPUT save:INPUT read:READ} [current_design]
set_property PACKAGE_PIN "D10" [get_ports "MIO[52]"]
set_property src_info {type:SCOPED_XDC file:1 line:43 export:INPUT save:INPUT read:READ} [current_design]
set_property PACKAGE_PIN "C10" [get_ports "MIO[51]"]
set_property src_info {type:SCOPED_XDC file:1 line:49 export:INPUT save:INPUT read:READ} [current_design]
set_property PACKAGE_PIN "D13" [get_ports "MIO[50]"]
set_property src_info {type:SCOPED_XDC file:1 line:55 export:INPUT save:INPUT read:READ} [current_design]
set_property PACKAGE_PIN "C14" [get_ports "MIO[49]"]
set_property src_info {type:SCOPED_XDC file:1 line:61 export:INPUT save:INPUT read:READ} [current_design]
set_property PACKAGE_PIN "D11" [get_ports "MIO[48]"]
set_property src_info {type:SCOPED_XDC file:1 line:67 export:INPUT save:INPUT read:READ} [current_design]
set_property PACKAGE_PIN "B10" [get_ports "MIO[47]"]
set_property src_info {type:SCOPED_XDC file:1 line:73 export:INPUT save:INPUT read:READ} [current_design]
set_property PACKAGE_PIN "D12" [get_ports "MIO[46]"]
set_property src_info {type:SCOPED_XDC file:1 line:79 export:INPUT save:INPUT read:READ} [current_design]
set_property PACKAGE_PIN "B9" [get_ports "MIO[45]"]
set_property src_info {type:SCOPED_XDC file:1 line:85 export:INPUT save:INPUT read:READ} [current_design]
set_property PACKAGE_PIN "E13" [get_ports "MIO[44]"]
set_property src_info {type:SCOPED_XDC file:1 line:91 export:INPUT save:INPUT read:READ} [current_design]
set_property PACKAGE_PIN "B11" [get_ports "MIO[43]"]
set_property src_info {type:SCOPED_XDC file:1 line:97 export:INPUT save:INPUT read:READ} [current_design]
set_property PACKAGE_PIN "D8" [get_ports "MIO[42]"]
set_property src_info {type:SCOPED_XDC file:1 line:103 export:INPUT save:INPUT read:READ} [current_design]
set_property PACKAGE_PIN "C8" [get_ports "MIO[41]"]
set_property src_info {type:SCOPED_XDC file:1 line:109 export:INPUT save:INPUT read:READ} [current_design]
set_property PACKAGE_PIN "E14" [get_ports "MIO[40]"]
set_property src_info {type:SCOPED_XDC file:1 line:115 export:INPUT save:INPUT read:READ} [current_design]
set_property PACKAGE_PIN "C13" [get_ports "MIO[39]"]
set_property src_info {type:SCOPED_XDC file:1 line:121 export:INPUT save:INPUT read:READ} [current_design]
set_property PACKAGE_PIN "F13" [get_ports "MIO[38]"]
set_property src_info {type:SCOPED_XDC file:1 line:127 export:INPUT save:INPUT read:READ} [current_design]
set_property PACKAGE_PIN "B14" [get_ports "MIO[37]"]
set_property src_info {type:SCOPED_XDC file:1 line:133 export:INPUT save:INPUT read:READ} [current_design]
set_property PACKAGE_PIN "A9" [get_ports "MIO[36]"]
set_property src_info {type:SCOPED_XDC file:1 line:139 export:INPUT save:INPUT read:READ} [current_design]
set_property PACKAGE_PIN "F14" [get_ports "MIO[35]"]
set_property src_info {type:SCOPED_XDC file:1 line:145 export:INPUT save:INPUT read:READ} [current_design]
set_property PACKAGE_PIN "B12" [get_ports "MIO[34]"]
set_property src_info {type:SCOPED_XDC file:1 line:151 export:INPUT save:INPUT read:READ} [current_design]
set_property PACKAGE_PIN "G13" [get_ports "MIO[33]"]
set_property src_info {type:SCOPED_XDC file:1 line:157 export:INPUT save:INPUT read:READ} [current_design]
set_property PACKAGE_PIN "C7" [get_ports "MIO[32]"]
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
set_property src_info {type:SCOPED_XDC file:1 line:321 export:INPUT save:INPUT read:READ} [current_design]
set_property PACKAGE_PIN "A3" [get_ports "MIO[5]"]
set_property src_info {type:SCOPED_XDC file:1 line:327 export:INPUT save:INPUT read:READ} [current_design]
set_property PACKAGE_PIN "E4" [get_ports "MIO[4]"]
set_property src_info {type:SCOPED_XDC file:1 line:333 export:INPUT save:INPUT read:READ} [current_design]
set_property PACKAGE_PIN "F6" [get_ports "MIO[3]"]
set_property src_info {type:SCOPED_XDC file:1 line:339 export:INPUT save:INPUT read:READ} [current_design]
set_property PACKAGE_PIN "A2" [get_ports "MIO[2]"]
set_property src_info {type:SCOPED_XDC file:1 line:345 export:INPUT save:INPUT read:READ} [current_design]
set_property PACKAGE_PIN "A1" [get_ports "MIO[1]"]
set_property src_info {type:SCOPED_XDC file:1 line:351 export:INPUT save:INPUT read:READ} [current_design]
set_property PACKAGE_PIN "G6" [get_ports "MIO[0]"]
set_property src_info {type:SCOPED_XDC file:1 line:356 export:INPUT save:INPUT read:READ} [current_design]
set_property PACKAGE_PIN "N7" [get_ports "DDR_VRP"]
set_property src_info {type:SCOPED_XDC file:1 line:360 export:INPUT save:INPUT read:READ} [current_design]
set_property PACKAGE_PIN "M7" [get_ports "DDR_VRN"]
set_property src_info {type:SCOPED_XDC file:1 line:364 export:INPUT save:INPUT read:READ} [current_design]
set_property PACKAGE_PIN "R4" [get_ports "DDR_WEB"]
set_property src_info {type:SCOPED_XDC file:1 line:368 export:INPUT save:INPUT read:READ} [current_design]
set_property PACKAGE_PIN "R5" [get_ports "DDR_RAS_n"]
set_property src_info {type:SCOPED_XDC file:1 line:372 export:INPUT save:INPUT read:READ} [current_design]
set_property PACKAGE_PIN "P5" [get_ports "DDR_ODT"]
set_property src_info {type:SCOPED_XDC file:1 line:376 export:INPUT save:INPUT read:READ} [current_design]
set_property PACKAGE_PIN "F3" [get_ports "DDR_DRSTB"]
set_property src_info {type:SCOPED_XDC file:1 line:380 export:INPUT save:INPUT read:READ} [current_design]
set_property PACKAGE_PIN "V2" [get_ports "DDR_DQS[3]"]
set_property src_info {type:SCOPED_XDC file:1 line:384 export:INPUT save:INPUT read:READ} [current_design]
set_property PACKAGE_PIN "N2" [get_ports "DDR_DQS[2]"]
set_property src_info {type:SCOPED_XDC file:1 line:388 export:INPUT save:INPUT read:READ} [current_design]
set_property PACKAGE_PIN "H2" [get_ports "DDR_DQS[1]"]
set_property src_info {type:SCOPED_XDC file:1 line:392 export:INPUT save:INPUT read:READ} [current_design]
set_property PACKAGE_PIN "C2" [get_ports "DDR_DQS[0]"]
set_property src_info {type:SCOPED_XDC file:1 line:396 export:INPUT save:INPUT read:READ} [current_design]
set_property PACKAGE_PIN "W2" [get_ports "DDR_DQS_n[3]"]
set_property src_info {type:SCOPED_XDC file:1 line:400 export:INPUT save:INPUT read:READ} [current_design]
set_property PACKAGE_PIN "P2" [get_ports "DDR_DQS_n[2]"]
set_property src_info {type:SCOPED_XDC file:1 line:404 export:INPUT save:INPUT read:READ} [current_design]
set_property PACKAGE_PIN "J2" [get_ports "DDR_DQS_n[1]"]
set_property src_info {type:SCOPED_XDC file:1 line:408 export:INPUT save:INPUT read:READ} [current_design]
set_property PACKAGE_PIN "D2" [get_ports "DDR_DQS_n[0]"]
set_property src_info {type:SCOPED_XDC file:1 line:412 export:INPUT save:INPUT read:READ} [current_design]
set_property PACKAGE_PIN "G1" [get_ports "DDR_DQ[9]"]
set_property src_info {type:SCOPED_XDC file:1 line:416 export:INPUT save:INPUT read:READ} [current_design]
set_property PACKAGE_PIN "G2" [get_ports "DDR_DQ[8]"]
set_property src_info {type:SCOPED_XDC file:1 line:420 export:INPUT save:INPUT read:READ} [current_design]
set_property PACKAGE_PIN "F1" [get_ports "DDR_DQ[7]"]
set_property src_info {type:SCOPED_XDC file:1 line:424 export:INPUT save:INPUT read:READ} [current_design]
set_property PACKAGE_PIN "F2" [get_ports "DDR_DQ[6]"]
set_property src_info {type:SCOPED_XDC file:1 line:428 export:INPUT save:INPUT read:READ} [current_design]
set_property PACKAGE_PIN "E1" [get_ports "DDR_DQ[5]"]
set_property src_info {type:SCOPED_XDC file:1 line:432 export:INPUT save:INPUT read:READ} [current_design]
set_property PACKAGE_PIN "E3" [get_ports "DDR_DQ[4]"]
set_property src_info {type:SCOPED_XDC file:1 line:436 export:INPUT save:INPUT read:READ} [current_design]
set_property PACKAGE_PIN "D3" [get_ports "DDR_DQ[3]"]
set_property src_info {type:SCOPED_XDC file:1 line:440 export:INPUT save:INPUT read:READ} [current_design]
set_property PACKAGE_PIN "Y1" [get_ports "DDR_DQ[31]"]
set_property src_info {type:SCOPED_XDC file:1 line:444 export:INPUT save:INPUT read:READ} [current_design]
set_property PACKAGE_PIN "W3" [get_ports "DDR_DQ[30]"]
set_property src_info {type:SCOPED_XDC file:1 line:448 export:INPUT save:INPUT read:READ} [current_design]
set_property PACKAGE_PIN "B2" [get_ports "DDR_DQ[2]"]
set_property src_info {type:SCOPED_XDC file:1 line:452 export:INPUT save:INPUT read:READ} [current_design]
set_property PACKAGE_PIN "Y3" [get_ports "DDR_DQ[29]"]
set_property src_info {type:SCOPED_XDC file:1 line:456 export:INPUT save:INPUT read:READ} [current_design]
set_property PACKAGE_PIN "W1" [get_ports "DDR_DQ[28]"]
set_property src_info {type:SCOPED_XDC file:1 line:460 export:INPUT save:INPUT read:READ} [current_design]
set_property PACKAGE_PIN "U2" [get_ports "DDR_DQ[27]"]
set_property src_info {type:SCOPED_XDC file:1 line:464 export:INPUT save:INPUT read:READ} [current_design]
set_property PACKAGE_PIN "AA1" [get_ports "DDR_DQ[26]"]
set_property src_info {type:SCOPED_XDC file:1 line:468 export:INPUT save:INPUT read:READ} [current_design]
set_property PACKAGE_PIN "U1" [get_ports "DDR_DQ[25]"]
set_property src_info {type:SCOPED_XDC file:1 line:472 export:INPUT save:INPUT read:READ} [current_design]
set_property PACKAGE_PIN "AA3" [get_ports "DDR_DQ[24]"]
set_property src_info {type:SCOPED_XDC file:1 line:476 export:INPUT save:INPUT read:READ} [current_design]
set_property PACKAGE_PIN "R1" [get_ports "DDR_DQ[23]"]
set_property src_info {type:SCOPED_XDC file:1 line:480 export:INPUT save:INPUT read:READ} [current_design]
set_property PACKAGE_PIN "M2" [get_ports "DDR_DQ[22]"]
set_property src_info {type:SCOPED_XDC file:1 line:484 export:INPUT save:INPUT read:READ} [current_design]
set_property PACKAGE_PIN "T2" [get_ports "DDR_DQ[21]"]
set_property src_info {type:SCOPED_XDC file:1 line:488 export:INPUT save:INPUT read:READ} [current_design]
set_property PACKAGE_PIN "R3" [get_ports "DDR_DQ[20]"]
set_property src_info {type:SCOPED_XDC file:1 line:492 export:INPUT save:INPUT read:READ} [current_design]
set_property PACKAGE_PIN "C3" [get_ports "DDR_DQ[1]"]
set_property src_info {type:SCOPED_XDC file:1 line:496 export:INPUT save:INPUT read:READ} [current_design]
set_property PACKAGE_PIN "T1" [get_ports "DDR_DQ[19]"]
set_property src_info {type:SCOPED_XDC file:1 line:500 export:INPUT save:INPUT read:READ} [current_design]
set_property PACKAGE_PIN "N3" [get_ports "DDR_DQ[18]"]
set_property src_info {type:SCOPED_XDC file:1 line:504 export:INPUT save:INPUT read:READ} [current_design]
set_property PACKAGE_PIN "T3" [get_ports "DDR_DQ[17]"]
set_property src_info {type:SCOPED_XDC file:1 line:508 export:INPUT save:INPUT read:READ} [current_design]
set_property PACKAGE_PIN "M1" [get_ports "DDR_DQ[16]"]
set_property src_info {type:SCOPED_XDC file:1 line:512 export:INPUT save:INPUT read:READ} [current_design]
set_property PACKAGE_PIN "K3" [get_ports "DDR_DQ[15]"]
set_property src_info {type:SCOPED_XDC file:1 line:516 export:INPUT save:INPUT read:READ} [current_design]
set_property PACKAGE_PIN "J1" [get_ports "DDR_DQ[14]"]
set_property src_info {type:SCOPED_XDC file:1 line:520 export:INPUT save:INPUT read:READ} [current_design]
set_property PACKAGE_PIN "K1" [get_ports "DDR_DQ[13]"]
set_property src_info {type:SCOPED_XDC file:1 line:524 export:INPUT save:INPUT read:READ} [current_design]
set_property PACKAGE_PIN "L3" [get_ports "DDR_DQ[12]"]
set_property src_info {type:SCOPED_XDC file:1 line:528 export:INPUT save:INPUT read:READ} [current_design]
set_property PACKAGE_PIN "L2" [get_ports "DDR_DQ[11]"]
set_property src_info {type:SCOPED_XDC file:1 line:532 export:INPUT save:INPUT read:READ} [current_design]
set_property PACKAGE_PIN "L1" [get_ports "DDR_DQ[10]"]
set_property src_info {type:SCOPED_XDC file:1 line:536 export:INPUT save:INPUT read:READ} [current_design]
set_property PACKAGE_PIN "D1" [get_ports "DDR_DQ[0]"]
set_property src_info {type:SCOPED_XDC file:1 line:540 export:INPUT save:INPUT read:READ} [current_design]
set_property PACKAGE_PIN "AA2" [get_ports "DDR_DM[3]"]
set_property src_info {type:SCOPED_XDC file:1 line:544 export:INPUT save:INPUT read:READ} [current_design]
set_property PACKAGE_PIN "P1" [get_ports "DDR_DM[2]"]
set_property src_info {type:SCOPED_XDC file:1 line:548 export:INPUT save:INPUT read:READ} [current_design]
set_property PACKAGE_PIN "H3" [get_ports "DDR_DM[1]"]
set_property src_info {type:SCOPED_XDC file:1 line:552 export:INPUT save:INPUT read:READ} [current_design]
set_property PACKAGE_PIN "B1" [get_ports "DDR_DM[0]"]
set_property src_info {type:SCOPED_XDC file:1 line:556 export:INPUT save:INPUT read:READ} [current_design]
set_property PACKAGE_PIN "P6" [get_ports "DDR_CS_n"]
set_property src_info {type:SCOPED_XDC file:1 line:560 export:INPUT save:INPUT read:READ} [current_design]
set_property PACKAGE_PIN "V3" [get_ports "DDR_CKE"]
set_property src_info {type:SCOPED_XDC file:1 line:564 export:INPUT save:INPUT read:READ} [current_design]
set_property PACKAGE_PIN "N4" [get_ports "DDR_Clk"]
set_property src_info {type:SCOPED_XDC file:1 line:568 export:INPUT save:INPUT read:READ} [current_design]
set_property PACKAGE_PIN "N5" [get_ports "DDR_Clk_n"]
set_property src_info {type:SCOPED_XDC file:1 line:572 export:INPUT save:INPUT read:READ} [current_design]
set_property PACKAGE_PIN "P3" [get_ports "DDR_CAS_n"]
set_property src_info {type:SCOPED_XDC file:1 line:576 export:INPUT save:INPUT read:READ} [current_design]
set_property PACKAGE_PIN "M6" [get_ports "DDR_BankAddr[2]"]
set_property src_info {type:SCOPED_XDC file:1 line:580 export:INPUT save:INPUT read:READ} [current_design]
set_property PACKAGE_PIN "L6" [get_ports "DDR_BankAddr[1]"]
set_property src_info {type:SCOPED_XDC file:1 line:584 export:INPUT save:INPUT read:READ} [current_design]
set_property PACKAGE_PIN "L7" [get_ports "DDR_BankAddr[0]"]
set_property src_info {type:SCOPED_XDC file:1 line:588 export:INPUT save:INPUT read:READ} [current_design]
set_property PACKAGE_PIN "H5" [get_ports "DDR_Addr[9]"]
set_property src_info {type:SCOPED_XDC file:1 line:592 export:INPUT save:INPUT read:READ} [current_design]
set_property PACKAGE_PIN "J5" [get_ports "DDR_Addr[8]"]
set_property src_info {type:SCOPED_XDC file:1 line:596 export:INPUT save:INPUT read:READ} [current_design]
set_property PACKAGE_PIN "J6" [get_ports "DDR_Addr[7]"]
set_property src_info {type:SCOPED_XDC file:1 line:600 export:INPUT save:INPUT read:READ} [current_design]
set_property PACKAGE_PIN "J7" [get_ports "DDR_Addr[6]"]
set_property src_info {type:SCOPED_XDC file:1 line:604 export:INPUT save:INPUT read:READ} [current_design]
set_property PACKAGE_PIN "K5" [get_ports "DDR_Addr[5]"]
set_property src_info {type:SCOPED_XDC file:1 line:608 export:INPUT save:INPUT read:READ} [current_design]
set_property PACKAGE_PIN "K6" [get_ports "DDR_Addr[4]"]
set_property src_info {type:SCOPED_XDC file:1 line:612 export:INPUT save:INPUT read:READ} [current_design]
set_property PACKAGE_PIN "L4" [get_ports "DDR_Addr[3]"]
set_property src_info {type:SCOPED_XDC file:1 line:616 export:INPUT save:INPUT read:READ} [current_design]
set_property PACKAGE_PIN "K4" [get_ports "DDR_Addr[2]"]
set_property src_info {type:SCOPED_XDC file:1 line:620 export:INPUT save:INPUT read:READ} [current_design]
set_property PACKAGE_PIN "M5" [get_ports "DDR_Addr[1]"]
set_property src_info {type:SCOPED_XDC file:1 line:624 export:INPUT save:INPUT read:READ} [current_design]
set_property PACKAGE_PIN "G4" [get_ports "DDR_Addr[14]"]
set_property src_info {type:SCOPED_XDC file:1 line:628 export:INPUT save:INPUT read:READ} [current_design]
set_property PACKAGE_PIN "F4" [get_ports "DDR_Addr[13]"]
set_property src_info {type:SCOPED_XDC file:1 line:632 export:INPUT save:INPUT read:READ} [current_design]
set_property PACKAGE_PIN "H4" [get_ports "DDR_Addr[12]"]
set_property src_info {type:SCOPED_XDC file:1 line:636 export:INPUT save:INPUT read:READ} [current_design]
set_property PACKAGE_PIN "G5" [get_ports "DDR_Addr[11]"]
set_property src_info {type:SCOPED_XDC file:1 line:640 export:INPUT save:INPUT read:READ} [current_design]
set_property PACKAGE_PIN "J3" [get_ports "DDR_Addr[10]"]
set_property src_info {type:SCOPED_XDC file:1 line:644 export:INPUT save:INPUT read:READ} [current_design]
set_property PACKAGE_PIN "M4" [get_ports "DDR_Addr[0]"]
set_property src_info {type:SCOPED_XDC file:1 line:648 export:INPUT save:INPUT read:READ} [current_design]
set_property PACKAGE_PIN "B5" [get_ports "PS_PORB"]
set_property src_info {type:SCOPED_XDC file:1 line:652 export:INPUT save:INPUT read:READ} [current_design]
set_property PACKAGE_PIN "C9" [get_ports "PS_SRSTB"]
set_property src_info {type:SCOPED_XDC file:1 line:656 export:INPUT save:INPUT read:READ} [current_design]
set_property PACKAGE_PIN "F7" [get_ports "PS_CLK"]
set_property src_info {type:SCOPED_XDC file:2 line:57 export:INPUT save:INPUT read:READ} [current_design]
set_input_jitter [get_clocks -of_objects [get_ports clk_in1]] 0.10000000000000001
