glgauthier/MQP/final_implemention/final_implemention.runs/synth_1/.Xil/design_1_wrapper_propImpl.xdc

set_property SRC_FILE_INFO {cfile:C:/Users/georges/Documents/GitHub/MQP/final_implemention/final_implemention.srcs/constrs_1/new/mqp.xdc rfile:../../../final_implemention.srcs/constrs_1/new/mqp.xdc id:1} [current_design]
set_property src_info {type:XDC file:1 line:2 export:INPUT save:INPUT read:READ} [current_design]
set_property PACKAGE_PIN Y9 [get_ports fpga_clk]
set_property src_info {type:XDC file:1 line:5 export:INPUT save:INPUT read:READ} [current_design]
set_property PACKAGE_PIN P16 [get_ports reset]
set_property src_info {type:XDC file:1 line:6 export:INPUT save:INPUT read:READ} [current_design]
set_property PACKAGE_PIN R18 [get_ports button]
set_property src_info {type:XDC file:1 line:7 export:INPUT save:INPUT read:READ} [current_design]
set_property PACKAGE_PIN T22 [get_ports {leds[0]}]
set_property src_info {type:XDC file:1 line:8 export:INPUT save:INPUT read:READ} [current_design]
set_property PACKAGE_PIN T21 [get_ports {leds[1]}]
set_property src_info {type:XDC file:1 line:9 export:INPUT save:INPUT read:READ} [current_design]
set_property PACKAGE_PIN U22 [get_ports {leds[2]}]
set_property src_info {type:XDC file:1 line:10 export:INPUT save:INPUT read:READ} [current_design]
set_property PACKAGE_PIN U21 [get_ports {leds[3]}]
set_property src_info {type:XDC file:1 line:11 export:INPUT save:INPUT read:READ} [current_design]
set_property PACKAGE_PIN V22 [get_ports {leds[4]}]
set_property src_info {type:XDC file:1 line:12 export:INPUT save:INPUT read:READ} [current_design]
set_property PACKAGE_PIN W22 [get_ports {leds[5]}]
set_property src_info {type:XDC file:1 line:13 export:INPUT save:INPUT read:READ} [current_design]
set_property PACKAGE_PIN U19 [get_ports {leds[6]}]
set_property src_info {type:XDC file:1 line:14 export:INPUT save:INPUT read:READ} [current_design]
set_property PACKAGE_PIN U14 [get_ports {leds[7]}]
set_property src_info {type:XDC file:1 line:16 export:INPUT save:INPUT read:READ} [current_design]
set_property PACKAGE_PIN V18 [get_ports {rgb[11]}]
set_property src_info {type:XDC file:1 line:17 export:INPUT save:INPUT read:READ} [current_design]
set_property PACKAGE_PIN V19 [get_ports {rgb[10]}]
set_property src_info {type:XDC file:1 line:18 export:INPUT save:INPUT read:READ} [current_design]
set_property PACKAGE_PIN U20 [get_ports {rgb[9]}]
set_property src_info {type:XDC file:1 line:19 export:INPUT save:INPUT read:READ} [current_design]
set_property PACKAGE_PIN V20 [get_ports {rgb[8]}]
set_property src_info {type:XDC file:1 line:20 export:INPUT save:INPUT read:READ} [current_design]
set_property PACKAGE_PIN AA21 [get_ports {rgb[7]}]
set_property src_info {type:XDC file:1 line:21 export:INPUT save:INPUT read:READ} [current_design]
set_property PACKAGE_PIN AB21 [get_ports {rgb[6]}]
set_property src_info {type:XDC file:1 line:22 export:INPUT save:INPUT read:READ} [current_design]
set_property PACKAGE_PIN AA22 [get_ports {rgb[5]}]
set_property src_info {type:XDC file:1 line:23 export:INPUT save:INPUT read:READ} [current_design]
set_property PACKAGE_PIN AB22 [get_ports {rgb[4]}]
set_property src_info {type:XDC file:1 line:24 export:INPUT save:INPUT read:READ} [current_design]
set_property PACKAGE_PIN AB19 [get_ports {rgb[3]}]
set_property src_info {type:XDC file:1 line:25 export:INPUT save:INPUT read:READ} [current_design]
set_property PACKAGE_PIN AB20 [get_ports {rgb[2]}]
set_property src_info {type:XDC file:1 line:26 export:INPUT save:INPUT read:READ} [current_design]
set_property PACKAGE_PIN Y20 [get_ports {rgb[1]}]
set_property src_info {type:XDC file:1 line:27 export:INPUT save:INPUT read:READ} [current_design]
set_property PACKAGE_PIN Y21 [get_ports {rgb[0]}]
set_property src_info {type:XDC file:1 line:28 export:INPUT save:INPUT read:READ} [current_design]
set_property PACKAGE_PIN AA19 [get_ports hsync]
set_property src_info {type:XDC file:1 line:29 export:INPUT save:INPUT read:READ} [current_design]
set_property PACKAGE_PIN Y19 [get_ports vsync]
set_property src_info {type:XDC file:1 line:58 export:INPUT save:INPUT read:READ} [current_design]
set_property PACKAGE_PIN N15 [get_ports cam_rst]
set_property src_info {type:XDC file:1 line:61 export:INPUT save:INPUT read:READ} [current_design]
set_property PACKAGE_PIN AA9 [get_ports cam_sysclk]
set_property src_info {type:XDC file:1 line:64 export:INPUT save:INPUT read:READ} [current_design]
set_property PACKAGE_PIN Y10 [get_ports cam_reset]
set_property src_info {type:XDC file:1 line:67 export:INPUT save:INPUT read:READ} [current_design]
set_property PACKAGE_PIN AA11 [get_ports cam_trigger]
set_property src_info {type:XDC file:1 line:70 export:INPUT save:INPUT read:READ} [current_design]
set_property PACKAGE_PIN V8 [get_ports {FIFO_DATA[7]}]
set_property src_info {type:XDC file:1 line:72 export:INPUT save:INPUT read:READ} [current_design]
set_property PACKAGE_PIN V9 [get_ports {FIFO_DATA[6]}]
set_property src_info {type:XDC file:1 line:74 export:INPUT save:INPUT read:READ} [current_design]
set_property PACKAGE_PIN W10 [get_ports {FIFO_DATA[5]}]
set_property src_info {type:XDC file:1 line:76 export:INPUT save:INPUT read:READ} [current_design]
set_property PACKAGE_PIN V12 [get_ports {FIFO_DATA[4]}]
set_property src_info {type:XDC file:1 line:78 export:INPUT save:INPUT read:READ} [current_design]
set_property PACKAGE_PIN W8 [get_ports {FIFO_DATA[3]}]
set_property src_info {type:XDC file:1 line:80 export:INPUT save:INPUT read:READ} [current_design]
set_property PACKAGE_PIN V10 [get_ports {FIFO_DATA[2]}]
set_property src_info {type:XDC file:1 line:82 export:INPUT save:INPUT read:READ} [current_design]
set_property PACKAGE_PIN W11 [get_ports {FIFO_DATA[1]}]
set_property src_info {type:XDC file:1 line:84 export:INPUT save:INPUT read:READ} [current_design]
set_property PACKAGE_PIN W12 [get_ports {FIFO_DATA[0]}]
set_property src_info {type:XDC file:1 line:87 export:INPUT save:INPUT read:READ} [current_design]
set_property PACKAGE_PIN AB9 [get_ports FIFO_OE1]
set_property src_info {type:XDC file:1 line:90 export:INPUT save:INPUT read:READ} [current_design]
set_property PACKAGE_PIN Y11 [get_ports FIFO_RRST1]
set_property src_info {type:XDC file:1 line:93 export:INPUT save:INPUT read:READ} [current_design]
set_property PACKAGE_PIN AB10 [get_ports FIFO_OE2]
set_property src_info {type:XDC file:1 line:96 export:INPUT save:INPUT read:READ} [current_design]
set_property PACKAGE_PIN AB11 [get_ports FIFO_RRST2]
set_property src_info {type:XDC file:1 line:99 export:INPUT save:INPUT read:READ} [current_design]
set_property PACKAGE_PIN AA8 [get_ports FIFO_RCK]
set_property src_info {type:XDC file:1 line:103 export:INPUT save:INPUT read:READ} [current_design]
set_property PACKAGE_PIN F22 [get_ports {sw[0]}]
set_property src_info {type:XDC file:1 line:105 export:INPUT save:INPUT read:READ} [current_design]
set_property PACKAGE_PIN G22 [get_ports {sw[1]}]
set_property src_info {type:XDC file:1 line:107 export:INPUT save:INPUT read:READ} [current_design]
set_property PACKAGE_PIN H22 [get_ports {sw[2]}]
set_property src_info {type:XDC file:1 line:109 export:INPUT save:INPUT read:READ} [current_design]
set_property PACKAGE_PIN F21 [get_ports {sw[3]}]
set_property src_info {type:XDC file:1 line:111 export:INPUT save:INPUT read:READ} [current_design]
set_property PACKAGE_PIN H19 [get_ports {sw[4]}]
set_property src_info {type:XDC file:1 line:113 export:INPUT save:INPUT read:READ} [current_design]
set_property PACKAGE_PIN H18 [get_ports {sw[5]}]
set_property src_info {type:XDC file:1 line:115 export:INPUT save:INPUT read:READ} [current_design]
set_property PACKAGE_PIN H17 [get_ports {sw[6]}]
set_property src_info {type:XDC file:1 line:117 export:INPUT save:INPUT read:READ} [current_design]
set_property PACKAGE_PIN M15 [get_ports {sw[7]}]
set_property src_info {type:XDC file:1 line:120 export:INPUT save:INPUT read:READ} [current_design]
set_property PACKAGE_PIN U5 [get_ports {gpio_0_tri_io[1]}]
set_property src_info {type:XDC file:1 line:121 export:INPUT save:INPUT read:READ} [current_design]
set_property PACKAGE_PIN V7 [get_ports {gpio_0_tri_io[0]}]
set_property src_info {type:XDC file:1 line:126 export:INPUT save:INPUT read:READ} [current_design]
set_property PACKAGE_PIN W7 [get_ports spi_0_io0_io]
set_property src_info {type:XDC file:1 line:127 export:INPUT save:INPUT read:READ} [current_design]
set_property PACKAGE_PIN V5 [get_ports spi_0_io1_io]
set_property src_info {type:XDC file:1 line:128 export:INPUT save:INPUT read:READ} [current_design]
set_property PACKAGE_PIN V4 [get_ports spi_0_sck_io]
set_property src_info {type:XDC file:1 line:129 export:INPUT save:INPUT read:READ} [current_design]
set_property PACKAGE_PIN U6 [get_ports spi_0_ss1_o]
set_property src_info {type:XDC file:1 line:130 export:INPUT save:INPUT read:READ} [current_design]
set_property PACKAGE_PIN AB6 [get_ports spi_0_ss2_o]
set_property src_info {type:XDC file:1 line:131 export:INPUT save:INPUT read:READ} [current_design]
set_property PACKAGE_PIN AB7 [get_ports spi_0_ss_io]
