glgauthier/MQP/MT9V034-vga/top_module.v

`timescale 1ns / 1ps
//////////////////////////////////////////////////////////////////////////////////
// Created by Georges Gauthier
// July 09 2016
// Test module for controlling the Leopardboard LI-VM34LP camera breakout
//////////////////////////////////////////////////////////////////////////////////
 module mt9v034_top(
		input sysclk, // 100MHz fpga clk
		input reset, // oddr2 reset 
		input cam_rst, // button for camera RESET_BAR
		input trigger, // button for camera trigger
		input fifo_rst,
		input SW_camSelect, // switch for camera output enable
		input SW_read_fifo,
//		input cam_LV, // line valid in from camera
		output LOCKED, // oddr2 LOCKED led
		output cam_sysclk, // sysclk out to camera
		output cam_reset, // reset_bar out to camera
		output cam_trigger, // trigger out to camera
//		output cam_oe, // output enable out to camera
		output i2c_ready, // LED indicator for i2c bus ready
		output [6:0] cathodes, // 7seg cathodes
		output [3:0] anodes, // 7seg anodes
		input [7:0] FIFO_DATA, // DO[7:0] from AL422b fifo
//		output FIFO_WE, // Write enable to fifo (LV inverted)
		output FIFO_OE1, // read enable to fifo (active low)
		output FIFO_RRST1, // read reset to fifo (active low)
      output FIFO_OE2, // read enable to fifo (active low)
		output FIFO_RRST2, // read reset to fifo (active low)
		output FIFO_RCK, // rck to fifo (1MHz)
		output [7:0] rgb, // values on vga color pins
		output HS, // horizontal sync (to VGA port)
		output VS, // vertical sync (to VGA port)
		output blank // blanking signal from VGA controller
		); 

wire clk_20Hz_unbuf, clk_20Hz;
wire clk_10kHz;
wire clk_1MHz, clk_1MHz_unbuf;
wire clk_5MHz;
wire clk_24MHz;
wire clk_25MHz;

// 24MHz clock for driving MT9V034's SYSCLK
// 100mhz out for FIFO
// note you can't connect sysclk to a dcm and other things
dcm CLK_24MHz
   (
    .CLK_IN1(sysclk),  
    .CLK_OUT1(clk_25MHz),
	 .CLK_OUT2(clk_24MHz),
	 .CLK_OUT3(clk_5MHz),
    .RESET(reset),
    .LOCKED(LOCKED)
	 ); 
	 
// further divide the dcm clock to other freqs	 
clk_divs clks(
	 .reset(reset), // synchronous reset
    .clk_24M(clk_24MHz), // 24MHz camera SCLK
	 .clk_fifo(clk_1MHz_unbuf), // 1MHz FIFO RCK
    .clk_debounce(clk_20Hz_unbuf), // 20Hz clock pulse for debouncing stuff
	 .anodes(clk_10kHz) // 10k 7Seg anode driver
    );

// clock buffer for 1MHz fifo rck
BUFG clk_1M (
      .O(clk_1MHz), 
      .I(clk_1MHz_unbuf)  
);
// clock buffer for 20Hz button debouncing
BUFG clk_20H (
      .O(clk_20Hz), 
      .I(clk_20Hz_unbuf)  
);
	 
// forward the camera sysclk out using a dedicated clocking route
ODDR2 #(
      .DDR_ALIGNMENT("NONE"), // Sets output alignment to "NONE", "C0" or "C1" 
      .INIT(1'b0),    // Sets initial state of the Q output to 1'b0 or 1'b1
      .SRTYPE("SYNC") // Specifies "SYNC" or "ASYNC" set/reset
   ) clkfwd0 (
      .Q(cam_sysclk),     // 1-bit DDR output data
      .C0(clk_24MHz),  // 1-bit clock input
      .C1(~clk_24MHz), // 1-bit clock input
      .CE(1'b1),      // 1-bit clock enable input
      .D0(1'b0), // 1-bit data input (associated with C0)
      .D1(1'b1), // 1-bit data input (associated with C1)
      .R(1'b0),   // 1-bit reset input
      .S(1'b0)   // 1-bit set input
   );
	
// forward the fifo read clk out using a dedicated clocking route
ODDR2 #(
      .DDR_ALIGNMENT("NONE"), // Sets output alignment to "NONE", "C0" or "C1" 
      .INIT(1'b0),    // Sets initial state of the Q output to 1'b0 or 1'b1
      .SRTYPE("SYNC") // Specifies "SYNC" or "ASYNC" set/reset
   ) clkfwd1 (
      .Q(FIFO_RCK),     // 1-bit DDR output data
      .C0(clk_5MHz),  // 1-bit clock input
      .C1(~clk_5MHz), // 1-bit clock input
      .CE(1'b1),      // 1-bit clock enable input
      .D0(1'b0), // 1-bit data input (associated with C0)
      .D1(1'b1), // 1-bit data input (associated with C1)
      .R(1'b0),   // 1-bit reset input
      .S(1'b0)   // 1-bit set input
   );

// camera initialization sequence
reg [11:0] init_count = 12'h000;
always @(posedge clk_24MHz) // cam sysclk before ODDR2
begin
	if (cam_rst) // if cam_rst is pressed, redo the initialization sequence
	begin
		init_count <= 12'h000;
	end
	else if(init_count < 2500) // keep cam_rst asserted for at least 20 cam_sysclk cycles - I use 30 since it's the minimum time for the i2c bus to be ready
		init_count <= init_count + 1'b1;
end
assign cam_reset = (init_count >= 20);
assign i2c_ready = (init_count >= 30);

// 7seg display controls
wire [15:0] displayVal;
seven_seg segs(
    .values(displayVal), // values to be written to the four seven segment LEDs
	 .CLK(clk_24MHz), // 24MHz clock
	 .en(clk_10kHz), // 10kHz counter enable used for setting the segment refresh rate
    .cathodes(cathodes), 
    .anodes(anodes)
    );
	 
// debounce output enable switch
//btnlatch sw_oe(
//    .clk(clk_20Hz),
//    .btn(SW_cam_oe),
//    .btn_val(cam_oe)
//    );
	 
// debounce the microblaze input sw
wire read_en;
btnlatch fifoRead_en(
    .clk(clk_20Hz),
    .btn(SW_read_fifo),
    .btn_val(read_en)
    );

wire cam_sel;
btnlatch camSelector(
    .clk(clk_20Hz),
    .btn(SW_camSelect),
    .btn_val(cam_sel)
    );
	 
assign FIFO_OE1 = cam_sel == 1'b0 ? fifo_rden : 1'b1;
assign FIFO_RRST1 = cam_sel == 1'b0 ? fifo_reset : 1'b1;
assign FIFO_OE2 = cam_sel == 1'b1 ? fifo_rden : 1'b1;
assign FIFO_RRST2 = cam_sel == 1'b1 ? fifo_reset : 1'b1;

wire fifo_rden; //also connected to fifo_buffer
//assign FIFO_OE1 = fifo_rden;
//assign FIFO_RRST1 = fifo_reset;
//assign FIFO_OE2 = 1'b1;
//assign FIFO_RRST2 = 1'b1;
// turn off camera 2 for now
// be careful - without modifying the board's i2c addr resistors
// both cameras will have the same i2c address


//assign FIFO_WE = ~cam_LV;

wire fifo_read_en, fifo_reset; // tell fpga to put new data in the FIFO
wire [7:0] pixelVal; // value of a camera pixel from fpga line buffer -> microblaze
wire [10:0] hcount; // pixel number on current line
wire [10:0] vcount; // number of current line

// instantiate the given VGA controller
vga_controller_640_60 vgaOut(
	.rst(reset), 
	.pixel_clk(clk_25MHz),
	.HS(HS),
	.VS(VS),
	.hcount(hcount),
	.vcount(vcount),
	.blank(blank) 
);

// Buffer for storing a scaled down set of pixels from FIFO for VGA display
fifo_buffer imgbuf(
	//.reset_pointer(fifo_rst),
	//.get_data(read_en), // was read_en
	.href(hcount),
	.vref(vcount),
	.blank(blank),
	.fifo_data(FIFO_DATA), // 8 bit data in from fifo
	.fifo_rck(clk_5MHz), // 1MHz clock signal generated by FPGA
	.fifo_rrst(fifo_reset), // fifo read reset (reset read addr pointer to 0)
	.fifo_oe(fifo_rden), // fifo output enable (allow for addr pointer to increment)
	.pixel_value(rgb), // 8-bit pixel value from internal buffer
	.current_line(displayVal),
	.trigger(cam_trigger)
   );
	

endmodule
