glgauthier/MQP/final_implemention/final_implemention.srcs/sources_1/bd/design_1/hdl/design_1_wrapper.v

//Copyright 1986-2016 Xilinx, Inc. All Rights Reserved.
//--------------------------------------------------------------------------------
//Tool Version: Vivado v.2016.2 (win64) Build 1577090 Thu Jun  2 16:32:40 MDT 2016
//Date        : Sun Jan 15 12:48:19 2017
//Host        : Georges-T460p running 64-bit major release  (build 9200)
//Command     : generate_target design_1_wrapper.bd
//Design      : design_1_wrapper
//Purpose     : IP block netlist
//--------------------------------------------------------------------------------
`timescale 1 ps / 1 ps

module design_1_wrapper
   (DDR_addr,
    DDR_ba,
    DDR_cas_n,
    DDR_ck_n,
    DDR_ck_p,
    DDR_cke,
    DDR_cs_n,
    DDR_dm,
    DDR_dq,
    DDR_dqs_n,
    DDR_dqs_p,
    DDR_odt,
    DDR_ras_n,
    DDR_reset_n,
    DDR_we_n,
    FIFO_DATA,
    FIFO_OE1,
    FIFO_OE2,
    FIFO_RCK,
    FIFO_RRST1,
    FIFO_RRST2,
    FIXED_IO_ddr_vrn,
    FIXED_IO_ddr_vrp,
    FIXED_IO_mio,
    FIXED_IO_ps_clk,
    FIXED_IO_ps_porb,
    FIXED_IO_ps_srstb,
    button,
    cam_reset,
    cam_rst,
    cam_sysclk,
    cam_trigger,
    fpga_clk,
    gpio_0_tri_io,
    hsync,
    leds,
    reset,
    rgb,
    spi_0_io0_io,
    spi_0_io1_io,
    spi_0_sck_io,
    spi_0_ss1_o,
    spi_0_ss2_o,
    spi_0_ss_io,
    sw,
    vsync);
  inout [14:0]DDR_addr;
  inout [2:0]DDR_ba;
  inout DDR_cas_n;
  inout DDR_ck_n;
  inout DDR_ck_p;
  inout DDR_cke;
  inout DDR_cs_n;
  inout [3:0]DDR_dm;
  inout [31:0]DDR_dq;
  inout [3:0]DDR_dqs_n;
  inout [3:0]DDR_dqs_p;
  inout DDR_odt;
  inout DDR_ras_n;
  inout DDR_reset_n;
  inout DDR_we_n;
  input [7:0]FIFO_DATA;
  output FIFO_OE1;
  output FIFO_OE2;
  output FIFO_RCK;
  output FIFO_RRST1;
  output FIFO_RRST2;
  inout FIXED_IO_ddr_vrn;
  inout FIXED_IO_ddr_vrp;
  inout [53:0]FIXED_IO_mio;
  inout FIXED_IO_ps_clk;
  inout FIXED_IO_ps_porb;
  inout FIXED_IO_ps_srstb;
  input button;
  output cam_reset;
  input cam_rst;
  output cam_sysclk;
  output cam_trigger;
  input fpga_clk;
  inout [1:0]gpio_0_tri_io;
  output hsync;
  output [7:0]leds;
  input reset;
  output [11:0]rgb;
  inout spi_0_io0_io;
  inout spi_0_io1_io;
  inout spi_0_sck_io;
  output spi_0_ss1_o;
  output spi_0_ss2_o;
  inout spi_0_ss_io;
  input [7:0]sw;
  output vsync;

  wire [14:0]DDR_addr;
  wire [2:0]DDR_ba;
  wire DDR_cas_n;
  wire DDR_ck_n;
  wire DDR_ck_p;
  wire DDR_cke;
  wire DDR_cs_n;
  wire [3:0]DDR_dm;
  wire [31:0]DDR_dq;
  wire [3:0]DDR_dqs_n;
  wire [3:0]DDR_dqs_p;
  wire DDR_odt;
  wire DDR_ras_n;
  wire DDR_reset_n;
  wire DDR_we_n;
  wire [7:0]FIFO_DATA;
  wire FIFO_OE1;
  wire FIFO_OE2;
  wire FIFO_RCK;
  wire FIFO_RRST1;
  wire FIFO_RRST2;
  wire FIXED_IO_ddr_vrn;
  wire FIXED_IO_ddr_vrp;
  wire [53:0]FIXED_IO_mio;
  wire FIXED_IO_ps_clk;
  wire FIXED_IO_ps_porb;
  wire FIXED_IO_ps_srstb;
  wire button;
  wire cam_reset;
  wire cam_rst;
  wire cam_sysclk;
  wire cam_trigger;
  wire fpga_clk;
  wire [0:0]gpio_0_tri_i_0;
  wire [1:1]gpio_0_tri_i_1;
  wire [0:0]gpio_0_tri_io_0;
  wire [1:1]gpio_0_tri_io_1;
  wire [0:0]gpio_0_tri_o_0;
  wire [1:1]gpio_0_tri_o_1;
  wire [0:0]gpio_0_tri_t_0;
  wire [1:1]gpio_0_tri_t_1;
  wire hsync;
  wire [7:0]leds;
  wire reset;
  wire [11:0]rgb;
  wire spi_0_io0_i;
  wire spi_0_io0_io;
  wire spi_0_io0_o;
  wire spi_0_io0_t;
  wire spi_0_io1_i;
  wire spi_0_io1_io;
  wire spi_0_io1_o;
  wire spi_0_io1_t;
  wire spi_0_sck_i;
  wire spi_0_sck_io;
  wire spi_0_sck_o;
  wire spi_0_sck_t;
  wire spi_0_ss1_o;
  wire spi_0_ss2_o;
  wire spi_0_ss_i;
  wire spi_0_ss_io;
  wire spi_0_ss_o;
  wire spi_0_ss_t;
  wire [7:0]sw;
  wire vsync;

  design_1 design_1_i
       (.DDR_addr(DDR_addr),
        .DDR_ba(DDR_ba),
        .DDR_cas_n(DDR_cas_n),
        .DDR_ck_n(DDR_ck_n),
        .DDR_ck_p(DDR_ck_p),
        .DDR_cke(DDR_cke),
        .DDR_cs_n(DDR_cs_n),
        .DDR_dm(DDR_dm),
        .DDR_dq(DDR_dq),
        .DDR_dqs_n(DDR_dqs_n),
        .DDR_dqs_p(DDR_dqs_p),
        .DDR_odt(DDR_odt),
        .DDR_ras_n(DDR_ras_n),
        .DDR_reset_n(DDR_reset_n),
        .DDR_we_n(DDR_we_n),
        .FIFO_DATA(FIFO_DATA),
        .FIFO_OE1(FIFO_OE1),
        .FIFO_OE2(FIFO_OE2),
        .FIFO_RCK(FIFO_RCK),
        .FIFO_RRST1(FIFO_RRST1),
        .FIFO_RRST2(FIFO_RRST2),
        .FIXED_IO_ddr_vrn(FIXED_IO_ddr_vrn),
        .FIXED_IO_ddr_vrp(FIXED_IO_ddr_vrp),
        .FIXED_IO_mio(FIXED_IO_mio),
        .FIXED_IO_ps_clk(FIXED_IO_ps_clk),
        .FIXED_IO_ps_porb(FIXED_IO_ps_porb),
        .FIXED_IO_ps_srstb(FIXED_IO_ps_srstb),
        .GPIO_0_tri_i({gpio_0_tri_i_1,gpio_0_tri_i_0}),
        .GPIO_0_tri_o({gpio_0_tri_o_1,gpio_0_tri_o_0}),
        .GPIO_0_tri_t({gpio_0_tri_t_1,gpio_0_tri_t_0}),
        .SPI_0_io0_i(spi_0_io0_i),
        .SPI_0_io0_o(spi_0_io0_o),
        .SPI_0_io0_t(spi_0_io0_t),
        .SPI_0_io1_i(spi_0_io1_i),
        .SPI_0_io1_o(spi_0_io1_o),
        .SPI_0_io1_t(spi_0_io1_t),
        .SPI_0_sck_i(spi_0_sck_i),
        .SPI_0_sck_o(spi_0_sck_o),
        .SPI_0_sck_t(spi_0_sck_t),
        .SPI_0_ss1_o(spi_0_ss1_o),
        .SPI_0_ss2_o(spi_0_ss2_o),
        .SPI_0_ss_i(spi_0_ss_i),
        .SPI_0_ss_o(spi_0_ss_o),
        .SPI_0_ss_t(spi_0_ss_t),
        .button(button),
        .cam_reset(cam_reset),
        .cam_rst(cam_rst),
        .cam_sysclk(cam_sysclk),
        .cam_trigger(cam_trigger),
        .fpga_clk(fpga_clk),
        .hsync(hsync),
        .leds(leds),
        .reset(reset),
        .rgb(rgb),
        .sw(sw),
        .vsync(vsync));
  IOBUF gpio_0_tri_iobuf_0
       (.I(gpio_0_tri_o_0),
        .IO(gpio_0_tri_io[0]),
        .O(gpio_0_tri_i_0),
        .T(gpio_0_tri_t_0));
  IOBUF gpio_0_tri_iobuf_1
       (.I(gpio_0_tri_o_1),
        .IO(gpio_0_tri_io[1]),
        .O(gpio_0_tri_i_1),
        .T(gpio_0_tri_t_1));
  IOBUF spi_0_io0_iobuf
       (.I(spi_0_io0_o),
        .IO(spi_0_io0_io),
        .O(spi_0_io0_i),
        .T(spi_0_io0_t));
  IOBUF spi_0_io1_iobuf
       (.I(spi_0_io1_o),
        .IO(spi_0_io1_io),
        .O(spi_0_io1_i),
        .T(spi_0_io1_t));
  IOBUF spi_0_sck_iobuf
       (.I(spi_0_sck_o),
        .IO(spi_0_sck_io),
        .O(spi_0_sck_i),
        .T(spi_0_sck_t));
  IOBUF spi_0_ss_iobuf
       (.I(spi_0_ss_o),
        .IO(spi_0_ss_io),
        .O(spi_0_ss_i),
        .T(spi_0_ss_t));
endmodule
