glgauthier/MQP/final_implemention/final_implemention.srcs/sources_1/bd/design_1/ip/design_1_nu_nu_rangefinder_vga_0_0/synth/design_1_nu_nu_rangefinder_vga_0_0.v

// (c) Copyright 1995-2017 Xilinx, Inc. All rights reserved.
// 
// This file contains confidential and proprietary information
// of Xilinx, Inc. and is protected under U.S. and
// international copyright and other intellectual property
// laws.
// 
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
// CRITICAL APPLICATIONS
// Xilinx products are not designed or intended to be fail-
// safe, or for use in any application requiring fail-safe
// performance, such as life-support or safety devices or
// systems, Class III medical devices, nuclear facilities,
// applications related to the deployment of airbags, or any
// other applications that could lead to death, personal
// injury, or severe property or environmental damage
// (individually and collectively, "Critical
// Applications"). Customer assumes the sole risk and
// liability of any use of Xilinx products in Critical
// Applications, subject only to applicable laws and
// regulations governing limitations on product liability.
// 
// THIS COPYRIGHT NOTICE AND DISCLAIMER MUST BE RETAINED AS
// PART OF THIS FILE AT ALL TIMES.
// 
// DO NOT MODIFY THIS FILE.


// IP VLNV: xilinx.com:user:custom_logic:1.0
// IP Revision: 41

(* X_CORE_INFO = "custom_logic_v1_0,Vivado 2016.2" *)
(* CHECK_LICENSE_TYPE = "design_1_nu_nu_rangefinder_vga_0_0,custom_logic_v1_0,{}" *)
(* CORE_GENERATION_INFO = "design_1_nu_nu_rangefinder_vga_0_0,custom_logic_v1_0,{x_ipProduct=Vivado 2016.2,x_ipVendor=xilinx.com,x_ipLibrary=user,x_ipName=custom_logic,x_ipVersion=1.0,x_ipCoreRevision=41,x_ipLanguage=VERILOG,x_ipSimLanguage=MIXED,C_S00_AXI_DATA_WIDTH=32,C_S00_AXI_ADDR_WIDTH=4}" *)
(* DowngradeIPIdentifiedWarnings = "yes" *)
module design_1_nu_nu_rangefinder_vga_0_0 (
  fpga_clk,
  reset,
  button,
  sw,
  leds,
  hsync,
  vsync,
  rgb,
  cam_rst,
  cam_sysclk,
  cam_reset,
  cam_trigger,
  FIFO_DATA,
  FIFO_OE1,
  FIFO_RRST1,
  FIFO_OE2,
  FIFO_RRST2,
  FIFO_RCK,
  addra1,
  coord1_data,
  clk_100M,
  addra2,
  coord2_data,
  vga_waddr,
  dina,
  ena,
  wea,
  vga_raddr,
  clk_25M,
  x_vga,
  enb,
  s00_axi_awaddr,
  s00_axi_awprot,
  s00_axi_awvalid,
  s00_axi_awready,
  s00_axi_wdata,
  s00_axi_wstrb,
  s00_axi_wvalid,
  s00_axi_wready,
  s00_axi_bresp,
  s00_axi_bvalid,
  s00_axi_bready,
  s00_axi_araddr,
  s00_axi_arprot,
  s00_axi_arvalid,
  s00_axi_arready,
  s00_axi_rdata,
  s00_axi_rresp,
  s00_axi_rvalid,
  s00_axi_rready,
  s00_axi_aclk,
  s00_axi_aresetn
);

input wire fpga_clk;
input wire reset;
input wire button;
input wire [7 : 0] sw;
output wire [7 : 0] leds;
output wire hsync;
output wire vsync;
output wire [11 : 0] rgb;
input wire cam_rst;
output wire cam_sysclk;
output wire cam_reset;
output wire cam_trigger;
input wire [7 : 0] FIFO_DATA;
output wire FIFO_OE1;
output wire FIFO_RRST1;
output wire FIFO_OE2;
output wire FIFO_RRST2;
output wire FIFO_RCK;
output wire [7 : 0] addra1;
input wire [12 : 0] coord1_data;
output wire clk_100M;
output wire [7 : 0] addra2;
input wire [12 : 0] coord2_data;
output wire [18 : 0] vga_waddr;
output wire [7 : 0] dina;
output wire ena;
output wire wea;
output wire [18 : 0] vga_raddr;
output wire clk_25M;
input wire [7 : 0] x_vga;
output wire enb;
(* X_INTERFACE_INFO = "xilinx.com:interface:aximm:1.0 S00_AXI AWADDR" *)
input wire [3 : 0] s00_axi_awaddr;
(* X_INTERFACE_INFO = "xilinx.com:interface:aximm:1.0 S00_AXI AWPROT" *)
input wire [2 : 0] s00_axi_awprot;
(* X_INTERFACE_INFO = "xilinx.com:interface:aximm:1.0 S00_AXI AWVALID" *)
input wire s00_axi_awvalid;
(* X_INTERFACE_INFO = "xilinx.com:interface:aximm:1.0 S00_AXI AWREADY" *)
output wire s00_axi_awready;
(* X_INTERFACE_INFO = "xilinx.com:interface:aximm:1.0 S00_AXI WDATA" *)
input wire [31 : 0] s00_axi_wdata;
(* X_INTERFACE_INFO = "xilinx.com:interface:aximm:1.0 S00_AXI WSTRB" *)
input wire [3 : 0] s00_axi_wstrb;
(* X_INTERFACE_INFO = "xilinx.com:interface:aximm:1.0 S00_AXI WVALID" *)
input wire s00_axi_wvalid;
(* X_INTERFACE_INFO = "xilinx.com:interface:aximm:1.0 S00_AXI WREADY" *)
output wire s00_axi_wready;
(* X_INTERFACE_INFO = "xilinx.com:interface:aximm:1.0 S00_AXI BRESP" *)
output wire [1 : 0] s00_axi_bresp;
(* X_INTERFACE_INFO = "xilinx.com:interface:aximm:1.0 S00_AXI BVALID" *)
output wire s00_axi_bvalid;
(* X_INTERFACE_INFO = "xilinx.com:interface:aximm:1.0 S00_AXI BREADY" *)
input wire s00_axi_bready;
(* X_INTERFACE_INFO = "xilinx.com:interface:aximm:1.0 S00_AXI ARADDR" *)
input wire [3 : 0] s00_axi_araddr;
(* X_INTERFACE_INFO = "xilinx.com:interface:aximm:1.0 S00_AXI ARPROT" *)
input wire [2 : 0] s00_axi_arprot;
(* X_INTERFACE_INFO = "xilinx.com:interface:aximm:1.0 S00_AXI ARVALID" *)
input wire s00_axi_arvalid;
(* X_INTERFACE_INFO = "xilinx.com:interface:aximm:1.0 S00_AXI ARREADY" *)
output wire s00_axi_arready;
(* X_INTERFACE_INFO = "xilinx.com:interface:aximm:1.0 S00_AXI RDATA" *)
output wire [31 : 0] s00_axi_rdata;
(* X_INTERFACE_INFO = "xilinx.com:interface:aximm:1.0 S00_AXI RRESP" *)
output wire [1 : 0] s00_axi_rresp;
(* X_INTERFACE_INFO = "xilinx.com:interface:aximm:1.0 S00_AXI RVALID" *)
output wire s00_axi_rvalid;
(* X_INTERFACE_INFO = "xilinx.com:interface:aximm:1.0 S00_AXI RREADY" *)
input wire s00_axi_rready;
(* X_INTERFACE_INFO = "xilinx.com:signal:clock:1.0 S00_AXI_CLK CLK" *)
input wire s00_axi_aclk;
(* X_INTERFACE_INFO = "xilinx.com:signal:reset:1.0 S00_AXI_RST RST" *)
input wire s00_axi_aresetn;

  custom_logic_v1_0 #(
    .C_S00_AXI_DATA_WIDTH(32),  // Width of S_AXI data bus
    .C_S00_AXI_ADDR_WIDTH(4)  // Width of S_AXI address bus
  ) inst (
    .fpga_clk(fpga_clk),
    .reset(reset),
    .button(button),
    .sw(sw),
    .leds(leds),
    .hsync(hsync),
    .vsync(vsync),
    .rgb(rgb),
    .cam_rst(cam_rst),
    .cam_sysclk(cam_sysclk),
    .cam_reset(cam_reset),
    .cam_trigger(cam_trigger),
    .FIFO_DATA(FIFO_DATA),
    .FIFO_OE1(FIFO_OE1),
    .FIFO_RRST1(FIFO_RRST1),
    .FIFO_OE2(FIFO_OE2),
    .FIFO_RRST2(FIFO_RRST2),
    .FIFO_RCK(FIFO_RCK),
    .addra1(addra1),
    .coord1_data(coord1_data),
    .clk_100M(clk_100M),
    .addra2(addra2),
    .coord2_data(coord2_data),
    .vga_waddr(vga_waddr),
    .dina(dina),
    .ena(ena),
    .wea(wea),
    .vga_raddr(vga_raddr),
    .clk_25M(clk_25M),
    .x_vga(x_vga),
    .enb(enb),
    .s00_axi_awaddr(s00_axi_awaddr),
    .s00_axi_awprot(s00_axi_awprot),
    .s00_axi_awvalid(s00_axi_awvalid),
    .s00_axi_awready(s00_axi_awready),
    .s00_axi_wdata(s00_axi_wdata),
    .s00_axi_wstrb(s00_axi_wstrb),
    .s00_axi_wvalid(s00_axi_wvalid),
    .s00_axi_wready(s00_axi_wready),
    .s00_axi_bresp(s00_axi_bresp),
    .s00_axi_bvalid(s00_axi_bvalid),
    .s00_axi_bready(s00_axi_bready),
    .s00_axi_araddr(s00_axi_araddr),
    .s00_axi_arprot(s00_axi_arprot),
    .s00_axi_arvalid(s00_axi_arvalid),
    .s00_axi_arready(s00_axi_arready),
    .s00_axi_rdata(s00_axi_rdata),
    .s00_axi_rresp(s00_axi_rresp),
    .s00_axi_rvalid(s00_axi_rvalid),
    .s00_axi_rready(s00_axi_rready),
    .s00_axi_aclk(s00_axi_aclk),
    .s00_axi_aresetn(s00_axi_aresetn)
  );
endmodule
