glgauthier/MQP/ZedFinalCams/ZedFinalCams.ip_user_files/ip/line_bram/line_bram_stub.vhdl

-- Copyright 1986-2016 Xilinx, Inc. All Rights Reserved.
-- --------------------------------------------------------------------------------
-- Tool Version: Vivado v.2016.2 (win64) Build 1577090 Thu Jun  2 16:32:40 MDT 2016
-- Date        : Tue Dec 13 20:58:28 2016
-- Host        : Georges-T460p running 64-bit major release  (build 9200)
-- Command     : write_vhdl -force -mode synth_stub
--               C:/Users/georges/Documents/GitHub/MQP/ZedFinalCams/ZedFinalCams.srcs/sources_1/ip/line_bram/line_bram_stub.vhdl
-- Design      : line_bram
-- Purpose     : Stub declaration of top-level module interface
-- Device      : xc7z020clg484-1
-- --------------------------------------------------------------------------------
library IEEE;
use IEEE.STD_LOGIC_1164.ALL;

entity line_bram is
  Port ( 
    clka : in STD_LOGIC;
    wea : in STD_LOGIC_VECTOR ( 0 to 0 );
    addra : in STD_LOGIC_VECTOR ( 6 downto 0 );
    dina : in STD_LOGIC_VECTOR ( 7 downto 0 );
    clkb : in STD_LOGIC;
    addrb : in STD_LOGIC_VECTOR ( 6 downto 0 );
    doutb : out STD_LOGIC_VECTOR ( 7 downto 0 )
  );

end line_bram;

architecture stub of line_bram is
attribute syn_black_box : boolean;
attribute black_box_pad_pin : string;
attribute syn_black_box of stub : architecture is true;
attribute black_box_pad_pin of stub : architecture is "clka,wea[0:0],addra[6:0],dina[7:0],clkb,addrb[6:0],doutb[7:0]";
attribute x_core_info : string;
attribute x_core_info of stub : architecture is "blk_mem_gen_v8_3_3,Vivado 2016.2";
begin
end;
