glgauthier/MQP/final_implemention/final_implemention.sdk/design_1_wrapper_hw_platform_0/drivers/nu_nu_rangefinder_vga_v1_0/src/nu_nu_rangefinder_vga.h

#ifndef NU_NU_RANGEFINDER_VGA_H
#define NU_NU_RANGEFINDER_VGA_H


/****************** Include Files ********************/
#include "xil_types.h"
#include "xstatus.h"

#define NU_NU_RANGEFINDER_VGA_S00_AXI_SLV_REG0_OFFSET 0
#define NU_NU_RANGEFINDER_VGA_S00_AXI_SLV_REG1_OFFSET 4
#define NU_NU_RANGEFINDER_VGA_S00_AXI_SLV_REG2_OFFSET 8
#define NU_NU_RANGEFINDER_VGA_S00_AXI_SLV_REG3_OFFSET 12


/**************************** Type Definitions *****************************/
/**
 *
 * Write a value to a NU_NU_RANGEFINDER_VGA register. A 32 bit write is performed.
 * If the component is implemented in a smaller width, only the least
 * significant data is written.
 *
 * @param   BaseAddress is the base address of the NU_NU_RANGEFINDER_VGAdevice.
 * @param   RegOffset is the register offset from the base to write to.
 * @param   Data is the data written to the register.
 *
 * @return  None.
 *
 * @note
 * C-style signature:
 * 	void NU_NU_RANGEFINDER_VGA_mWriteReg(u32 BaseAddress, unsigned RegOffset, u32 Data)
 *
 */
#define NU_NU_RANGEFINDER_VGA_mWriteReg(BaseAddress, RegOffset, Data) \
  	Xil_Out32((BaseAddress) + (RegOffset), (u32)(Data))

/**
 *
 * Read a value from a NU_NU_RANGEFINDER_VGA register. A 32 bit read is performed.
 * If the component is implemented in a smaller width, only the least
 * significant data is read from the register. The most significant data
 * will be read as 0.
 *
 * @param   BaseAddress is the base address of the NU_NU_RANGEFINDER_VGA device.
 * @param   RegOffset is the register offset from the base to write to.
 *
 * @return  Data is the data from the register.
 *
 * @note
 * C-style signature:
 * 	u32 NU_NU_RANGEFINDER_VGA_mReadReg(u32 BaseAddress, unsigned RegOffset)
 *
 */
#define NU_NU_RANGEFINDER_VGA_mReadReg(BaseAddress, RegOffset) \
    Xil_In32((BaseAddress) + (RegOffset))

/************************** Function Prototypes ****************************/
/**
 *
 * Run a self-test on the driver/device. Note this may be a destructive test if
 * resets of the device are performed.
 *
 * If the hardware system is not built correctly, this function may never
 * return to the caller.
 *
 * @param   baseaddr_p is the base address of the NU_NU_RANGEFINDER_VGA instance to be worked on.
 *
 * @return
 *
 *    - XST_SUCCESS   if all self-test code passed
 *    - XST_FAILURE   if any self-test code failed
 *
 * @note    Caching must be turned off for this function to work.
 * @note    Self test may fail if data memory and device are not on the same bus.
 *
 */
XStatus NU_NU_RANGEFINDER_VGA_Reg_SelfTest(void * baseaddr_p);

#endif // NU_NU_RANGEFINDER_VGA_H
