glgauthier/MQP/IMU_PS/IMU_PS.ip_user_files/bd/IMU_bd/hdl/IMU_bd.v

//Copyright 1986-2016 Xilinx, Inc. All Rights Reserved.
//--------------------------------------------------------------------------------
//Tool Version: Vivado v.2016.2 (win64) Build 1577090 Thu Jun  2 16:32:40 MDT 2016
//Date        : Thu Dec 15 12:37:31 2016
//Host        : Georges-T460p running 64-bit major release  (build 9200)
//Command     : generate_target IMU_bd.bd
//Design      : IMU_bd
//Purpose     : IP block netlist
//--------------------------------------------------------------------------------
`timescale 1 ps / 1 ps

(* CORE_GENERATION_INFO = "IMU_bd,IP_Integrator,{x_ipVendor=xilinx.com,x_ipLibrary=BlockDiagram,x_ipName=IMU_bd,x_ipVersion=1.00.a,x_ipLanguage=VERILOG,numBlks=2,numReposBlks=2,numNonXlnxBlks=0,numHierBlks=0,maxHierDepth=0,numSysgenBlks=0,numHlsBlks=0,numHdlrefBlks=0,numPkgbdBlks=0,bdsource=USER,da_ps7_cnt=1,synth_mode=Global}" *) (* HW_HANDOFF = "IMU_bd.hwdef" *) 
module IMU_bd
   (DDR_addr,
    DDR_ba,
    DDR_cas_n,
    DDR_ck_n,
    DDR_ck_p,
    DDR_cke,
    DDR_cs_n,
    DDR_dm,
    DDR_dq,
    DDR_dqs_n,
    DDR_dqs_p,
    DDR_odt,
    DDR_ras_n,
    DDR_reset_n,
    DDR_we_n,
    FIXED_IO_ddr_vrn,
    FIXED_IO_ddr_vrp,
    FIXED_IO_mio,
    FIXED_IO_ps_clk,
    FIXED_IO_ps_porb,
    FIXED_IO_ps_srstb,
    cs_nAG_O,
    cs_nALT_O,
    cs_nM,
    cs_nM_O,
    miso_I,
    miso_O,
    mosi,
    mosi_O,
    sclk,
    sclk_O);
  inout [14:0]DDR_addr;
  inout [2:0]DDR_ba;
  inout DDR_cas_n;
  inout DDR_ck_n;
  inout DDR_ck_p;
  inout DDR_cke;
  inout DDR_cs_n;
  inout [3:0]DDR_dm;
  inout [31:0]DDR_dq;
  inout [3:0]DDR_dqs_n;
  inout [3:0]DDR_dqs_p;
  inout DDR_odt;
  inout DDR_ras_n;
  inout DDR_reset_n;
  inout DDR_we_n;
  inout FIXED_IO_ddr_vrn;
  inout FIXED_IO_ddr_vrp;
  inout [53:0]FIXED_IO_mio;
  inout FIXED_IO_ps_clk;
  inout FIXED_IO_ps_porb;
  inout FIXED_IO_ps_srstb;
  output cs_nAG_O;
  output cs_nALT_O;
  input cs_nM;
  output cs_nM_O;
  input miso_I;
  output miso_O;
  input mosi;
  output mosi_O;
  input sclk;
  output sclk_O;

  wire InOut_0_cs_nAG_O;
  wire InOut_0_cs_nALT_O;
  wire InOut_0_cs_nM_O;
  wire InOut_0_miso_O;
  wire InOut_0_mosi_O;
  wire InOut_0_sclk_O;
  wire cs_nM_1;
  wire miso_I_1;
  wire mosi_1;
  wire [14:0]processing_system7_0_DDR_ADDR;
  wire [2:0]processing_system7_0_DDR_BA;
  wire processing_system7_0_DDR_CAS_N;
  wire processing_system7_0_DDR_CKE;
  wire processing_system7_0_DDR_CK_N;
  wire processing_system7_0_DDR_CK_P;
  wire processing_system7_0_DDR_CS_N;
  wire [3:0]processing_system7_0_DDR_DM;
  wire [31:0]processing_system7_0_DDR_DQ;
  wire [3:0]processing_system7_0_DDR_DQS_N;
  wire [3:0]processing_system7_0_DDR_DQS_P;
  wire processing_system7_0_DDR_ODT;
  wire processing_system7_0_DDR_RAS_N;
  wire processing_system7_0_DDR_RESET_N;
  wire processing_system7_0_DDR_WE_N;
  wire processing_system7_0_FCLK_CLK0;
  wire processing_system7_0_FIXED_IO_DDR_VRN;
  wire processing_system7_0_FIXED_IO_DDR_VRP;
  wire [53:0]processing_system7_0_FIXED_IO_MIO;
  wire processing_system7_0_FIXED_IO_PS_CLK;
  wire processing_system7_0_FIXED_IO_PS_PORB;
  wire processing_system7_0_FIXED_IO_PS_SRSTB;
  wire sclk_1;

  assign cs_nAG_O = InOut_0_cs_nAG_O;
  assign cs_nALT_O = InOut_0_cs_nALT_O;
  assign cs_nM_1 = cs_nM;
  assign cs_nM_O = InOut_0_cs_nM_O;
  assign miso_I_1 = miso_I;
  assign miso_O = InOut_0_miso_O;
  assign mosi_1 = mosi;
  assign mosi_O = InOut_0_mosi_O;
  assign sclk_1 = sclk;
  assign sclk_O = InOut_0_sclk_O;
  IMU_bd_InOut_0_0 InOut_0
       (.cs_nAG_O(InOut_0_cs_nAG_O),
        .cs_nALT_O(InOut_0_cs_nALT_O),
        .cs_nM(cs_nM_1),
        .cs_nM_O(InOut_0_cs_nM_O),
        .miso_I(miso_I_1),
        .miso_O(InOut_0_miso_O),
        .mosi(mosi_1),
        .mosi_O(InOut_0_mosi_O),
        .sclk(sclk_1),
        .sclk_O(InOut_0_sclk_O));
  IMU_bd_processing_system7_0_0 processing_system7_0
       (.DDR_Addr(DDR_addr[14:0]),
        .DDR_BankAddr(DDR_ba[2:0]),
        .DDR_CAS_n(DDR_cas_n),
        .DDR_CKE(DDR_cke),
        .DDR_CS_n(DDR_cs_n),
        .DDR_Clk(DDR_ck_p),
        .DDR_Clk_n(DDR_ck_n),
        .DDR_DM(DDR_dm[3:0]),
        .DDR_DQ(DDR_dq[31:0]),
        .DDR_DQS(DDR_dqs_p[3:0]),
        .DDR_DQS_n(DDR_dqs_n[3:0]),
        .DDR_DRSTB(DDR_reset_n),
        .DDR_ODT(DDR_odt),
        .DDR_RAS_n(DDR_ras_n),
        .DDR_VRN(FIXED_IO_ddr_vrn),
        .DDR_VRP(FIXED_IO_ddr_vrp),
        .DDR_WEB(DDR_we_n),
        .FCLK_CLK0(processing_system7_0_FCLK_CLK0),
        .MIO(FIXED_IO_mio[53:0]),
        .M_AXI_GP0_ACLK(processing_system7_0_FCLK_CLK0),
        .M_AXI_GP0_ARREADY(1'b0),
        .M_AXI_GP0_AWREADY(1'b0),
        .M_AXI_GP0_BID({1'b0,1'b0,1'b0,1'b0,1'b0,1'b0,1'b0,1'b0,1'b0,1'b0,1'b0,1'b0}),
        .M_AXI_GP0_BRESP({1'b0,1'b0}),
        .M_AXI_GP0_BVALID(1'b0),
        .M_AXI_GP0_RDATA({1'b0,1'b0,1'b0,1'b0,1'b0,1'b0,1'b0,1'b0,1'b0,1'b0,1'b0,1'b0,1'b0,1'b0,1'b0,1'b0,1'b0,1'b0,1'b0,1'b0,1'b0,1'b0,1'b0,1'b0,1'b0,1'b0,1'b0,1'b0,1'b0,1'b0,1'b0,1'b0}),
        .M_AXI_GP0_RID({1'b0,1'b0,1'b0,1'b0,1'b0,1'b0,1'b0,1'b0,1'b0,1'b0,1'b0,1'b0}),
        .M_AXI_GP0_RLAST(1'b0),
        .M_AXI_GP0_RRESP({1'b0,1'b0}),
        .M_AXI_GP0_RVALID(1'b0),
        .M_AXI_GP0_WREADY(1'b0),
        .PS_CLK(FIXED_IO_ps_clk),
        .PS_PORB(FIXED_IO_ps_porb),
        .PS_SRSTB(FIXED_IO_ps_srstb),
        .USB0_VBUS_PWRFAULT(1'b0));
endmodule
