glgauthier/MQP/IMU/IMU.ip_user_files/ip/div_gen_0/div_gen_0_stub.vhdl

-- Copyright 1986-2016 Xilinx, Inc. All Rights Reserved.
-- --------------------------------------------------------------------------------
-- Tool Version: Vivado v.2016.2 (win64) Build 1577090 Thu Jun  2 16:32:40 MDT 2016
-- Date        : Wed Dec 14 17:21:02 2016
-- Host        : Georges-T460p running 64-bit major release  (build 9200)
-- Command     : write_vhdl -force -mode synth_stub
--               C:/Users/georges/Documents/GitHub/MQP/IMU/IMU.srcs/sources_1/ip/div_gen_0/div_gen_0_stub.vhdl
-- Design      : div_gen_0
-- Purpose     : Stub declaration of top-level module interface
-- Device      : xc7z020clg484-1
-- --------------------------------------------------------------------------------
library IEEE;
use IEEE.STD_LOGIC_1164.ALL;

entity div_gen_0 is
  Port ( 
    aclk : in STD_LOGIC;
    s_axis_divisor_tvalid : in STD_LOGIC;
    s_axis_divisor_tdata : in STD_LOGIC_VECTOR ( 23 downto 0 );
    s_axis_dividend_tvalid : in STD_LOGIC;
    s_axis_dividend_tdata : in STD_LOGIC_VECTOR ( 15 downto 0 );
    m_axis_dout_tvalid : out STD_LOGIC;
    m_axis_dout_tdata : out STD_LOGIC_VECTOR ( 31 downto 0 )
  );

end div_gen_0;

architecture stub of div_gen_0 is
attribute syn_black_box : boolean;
attribute black_box_pad_pin : string;
attribute syn_black_box of stub : architecture is true;
attribute black_box_pad_pin of stub : architecture is "aclk,s_axis_divisor_tvalid,s_axis_divisor_tdata[23:0],s_axis_dividend_tvalid,s_axis_dividend_tdata[15:0],m_axis_dout_tvalid,m_axis_dout_tdata[31:0]";
attribute x_core_info : string;
attribute x_core_info of stub : architecture is "div_gen_v5_1_10,Vivado 2016.2";
begin
end;
