glgauthier/MQP/ZedFinalCams/ZedFinalCams.srcs/sources_1/ip/line_bram/line_bram_sim_netlist.v

// Copyright 1986-2016 Xilinx, Inc. All Rights Reserved.
// --------------------------------------------------------------------------------
// Tool Version: Vivado v.2016.2 (win64) Build 1577090 Thu Jun  2 16:32:40 MDT 2016
// Date        : Tue Dec 13 20:58:28 2016
// Host        : Georges-T460p running 64-bit major release  (build 9200)
// Command     : write_verilog -force -mode funcsim
//               C:/Users/georges/Documents/GitHub/MQP/ZedFinalCams/ZedFinalCams.srcs/sources_1/ip/line_bram/line_bram_sim_netlist.v
// Design      : line_bram
// Purpose     : This verilog netlist is a functional simulation representation of the design and should not be modified
//               or synthesized. This netlist cannot be used for SDF annotated simulation.
// Device      : xc7z020clg484-1
// --------------------------------------------------------------------------------
`timescale 1 ps / 1 ps

(* CHECK_LICENSE_TYPE = "line_bram,blk_mem_gen_v8_3_3,{}" *) (* downgradeipidentifiedwarnings = "yes" *) (* x_core_info = "blk_mem_gen_v8_3_3,Vivado 2016.2" *) 
(* NotValidForBitStream *)
module line_bram
   (clka,
    wea,
    addra,
    dina,
    clkb,
    addrb,
    doutb);
  (* x_interface_info = "xilinx.com:interface:bram:1.0 BRAM_PORTA CLK" *) input clka;
  (* x_interface_info = "xilinx.com:interface:bram:1.0 BRAM_PORTA WE" *) input [0:0]wea;
  (* x_interface_info = "xilinx.com:interface:bram:1.0 BRAM_PORTA ADDR" *) input [6:0]addra;
  (* x_interface_info = "xilinx.com:interface:bram:1.0 BRAM_PORTA DIN" *) input [7:0]dina;
  (* x_interface_info = "xilinx.com:interface:bram:1.0 BRAM_PORTB CLK" *) input clkb;
  (* x_interface_info = "xilinx.com:interface:bram:1.0 BRAM_PORTB ADDR" *) input [6:0]addrb;
  (* x_interface_info = "xilinx.com:interface:bram:1.0 BRAM_PORTB DOUT" *) output [7:0]doutb;

  wire [6:0]addra;
  wire [6:0]addrb;
  wire clka;
  wire clkb;
  wire [7:0]dina;
  wire [7:0]doutb;
  wire [0:0]wea;
  wire NLW_U0_dbiterr_UNCONNECTED;
  wire NLW_U0_rsta_busy_UNCONNECTED;
  wire NLW_U0_rstb_busy_UNCONNECTED;
  wire NLW_U0_s_axi_arready_UNCONNECTED;
  wire NLW_U0_s_axi_awready_UNCONNECTED;
  wire NLW_U0_s_axi_bvalid_UNCONNECTED;
  wire NLW_U0_s_axi_dbiterr_UNCONNECTED;
  wire NLW_U0_s_axi_rlast_UNCONNECTED;
  wire NLW_U0_s_axi_rvalid_UNCONNECTED;
  wire NLW_U0_s_axi_sbiterr_UNCONNECTED;
  wire NLW_U0_s_axi_wready_UNCONNECTED;
  wire NLW_U0_sbiterr_UNCONNECTED;
  wire [7:0]NLW_U0_douta_UNCONNECTED;
  wire [6:0]NLW_U0_rdaddrecc_UNCONNECTED;
  wire [3:0]NLW_U0_s_axi_bid_UNCONNECTED;
  wire [1:0]NLW_U0_s_axi_bresp_UNCONNECTED;
  wire [6:0]NLW_U0_s_axi_rdaddrecc_UNCONNECTED;
  wire [7:0]NLW_U0_s_axi_rdata_UNCONNECTED;
  wire [3:0]NLW_U0_s_axi_rid_UNCONNECTED;
  wire [1:0]NLW_U0_s_axi_rresp_UNCONNECTED;
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
