glgauthier/MQP/(commit log)

2016-05-05 LaTeX report
    Started working on our report in LaTeX. So far I’ve set the following
    up:
    - Formatted title page
    - Support for a Table of Contents w/ clickable links to each section
    - Acknowledgements, Abstract, and Introduction.
    Things I still need to add
    - Background
    - Appendix
    - Support for Verilog code snippets (I’m going to use the listings
    package)
2016-05-26 Started Camera Adapter Schematic
    - Starting with a single camera module for now, then I'll rinse and
    repeat.
    Currently done with PWR/GND and camera shutter trigger. Mapping to the
    PMOD connectors will get interesting...
    [schematic.sch]
2016-05-26 Completed Schematic, Started Board
    [schematic.sch]
2016-05-26 Added board file
    [schematic.brd]
2016-05-27 Updated Schematic and Board
    I'm debating on removing the ccd_data pin breakout all together - more
    to come on this
    [schematic.brd, schematic.sch]
2016-05-31 removed local schematic location
2016-05-31 Deleted schematic local location
2016-05-31 Final Schematic
    - Removed CCD_DATA lines, we can bodge these 4 pins if we end up needing
    them but they don't appear connected in the LI-VM34LP schematic.
    - Finished overall board design, added some extra text and moved around
    labels so that everything comes out looking good
    [schematic.brd, schematic.sch]
2016-05-31 Final Schematic Part II
    Need to double check and then I'll order boards
    [schematic.brd, schematic.sch]
2016-05-31 FMC-LPC connector added for future breakout board project
    [fmc.brd, fmc.sch]
2016-05-31 Added missing pin, finalized(?) board design
    - Missed the trigger pin, that could have been bad!
    - Double checked the layout and it looks correct
    - Passed OSHpark DRC, ERC
    [schematic.brd, schematic.sch]
2016-07-09 Verilog test module for MT9V034 - initial commit
    [mt9v034_top_pad.csv]
2016-07-10 camera reset, eagle cleanup
    [mt9v034_top_pad.csv]
2016-07-11 UART test
    not working
    [mt9v034_top_pad.csv]
2016-07-13 working i2c test
    [mt9v034_top_pad.csv]
2016-07-13 added BUFG for debounce CLK
    no more warnings!
    [mt9v034_top_pad.csv]
2016-07-13 writing correct val; ready for tri-state & SM
    [mt9v034_top_pad.csv]
2016-07-14 camera data
2016-07-15 removed "i2c" code
    not worth the time, found another route. Next up is proper power up
    sequence
    [mt9v034_top_pad.csv]
2016-07-15 proper initialization sequence, scope data
    it works!
    - full i2c control from 3.3v external micro
    - able to configure control register for external trigger mode
    -> control register isn't saved between OE_N state change, so set OE_N
    high before changing camera control to trigger mode
    [mt9v034_top_pad.csv]
2016-07-15 started FMC breakout
    [fmc.brd, fmc.sch]
2016-07-15 FMC bus map
    [fmc.sch]
2016-07-15 FMC bus pins mapped to FPGA bank locations
    [fmc.sch]
2016-07-15 fixed EAGLE problems, added FIFOs to FMC breakout
    [fmc1.brd, fmc1.sch]
2016-07-16 added camera data headers
    [fmc1.brd, fmc1.sch]
2016-07-18 microblaze for camera data over UART
    [mt9v034_top_pad.csv]
2016-07-19 updated fifo code, screenshots, matlab code
    - Camera -> AL422B FIFO -> Line buffer on FPGA -> Microblaze -> UART. it
    almost works!
    [mt9v034_top_pad.csv]
2016-07-20 working camera
    got some test images! next steps = FMC breakout board, trying to get
    cleaner data, I2C interface on FPGA, showing pixel bins over VGA in real
    time
    [mt9v034_top_pad.csv]
2016-07-20 added camera section to methodology
2016-07-21 100% working images
    finally!
    I was leaving FIFO_RDEN on for an extra 2 clock cycles, so my read
    pointer was 2 pixels further ahead of where it should have been for
    every read by the FPGA
    [mt9v034_top_pad.csv]
2016-07-21 bug fix
    [mt9v034_top_pad.csv]
2016-07-21 more bug fixes
    [mt9v034_top_pad.csv]
2016-07-22 camera operation
2016-07-22 camera documentation cont.
2016-07-25 semi-finished documentation of current progress
2016-07-27 4 layer FMC breakout
    [fmc.brd, fmc.sch, fmc1.brd, fmc1.sch]
2016-07-27 Finished routing traces
    [fmc.brd, fmc.sch]
2016-07-27 FMC board tweaks
    [fmc.brd]
2016-07-28 updated PCB file locations
    [camera_final.sch, fmc.brd, fmc.sch, schematic.brd, schematic.sch]
2016-07-28 final stereo cam schematic, started layout
    [camera_final.brd, camera_final.sch]
2016-07-29 routing stereo camera board
    [camera_final.brd]
2016-07-29 semi-finalized layout
    [camera_final.brd, camera_final.sch]
2016-07-29 ordered the board!
    [camera_final.brd]
2016-07-29 added board images
2016-08-01 stereo cam breakout in report
    [camera_final.sch]
2016-08-02 cam streaming test
    [mt9v034_top_pad.csv]
2016-08-03 SPEEEED
    Fifo -> VGA display now runs in real-ish time. Framerate TBD
    [mt9v034_top_pad.csv]
2016-08-03 minor tweaks
    [mt9v034_top_pad.csv]
2016-08-13 working stereo camera board vga test
    gathering data from just cam1 for now. next step will be to add a switch
    for changing between the two
    [mt9v034_top_pad.csv]
2016-08-13 Both cameras working!
    phew
    [mt9v034_top_pad.csv]
2016-08-26 switched to vivado to start coding on zedboard
2016-08-29 Support for stereo camera module
    I2C addr 0x48 and 0x58 for both modules
    [mt9v034_top_pad.csv]
2016-08-31 Added better camera picture, fixed ref
2016-09-04 added stereo support to UART camera interface
    [mt9v034_top_pad.csv]
2016-09-06 created a uartlite ip module
2016-09-07 re-added project_2
    This is the zedboard uart module that was temporarily moved when I broke
    GitHub
    [design_1.v, design_1_processing_system7_0_0.v, design_1_processing_system7_0_0.xdc, design_1_wrapper.v, design_1_wrapper_propImpl.xdc, helloworld.c, processing_system7_v5_5_processing_system7.v]
2016-09-07 buffer for rangefinder data
    uart ragefinder data is read into a buffer. fifo is coming next
2016-09-13 added i2c functionality to the uart module in sdk
2016-09-26 changed uart1 to uart0, created a new bsp to reflect uart0
2016-10-05 updating UART module, started disparity implementation
    [mt9v034_top_pad.csv]
2016-10-19 Disparity updates
    - Finished state for reading in image data from FIFOs
    - Dynamic search bounds for current block and disparity range
    [top_module_pad.csv]
2016-10-29 Added changes from last week
    [mt9v034_top_pad.csv]
2016-10-29 Added disparity overview to report
    Still need to finish image rectification portion, waiting to get better
    calibration example images first
2016-10-30 ZedBoard VGA Camera Module
    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
2016-11-03 Added Camera-AXI IP to block design, generated bitstream
2016-11-10 Disparity test bench
    [disparity_tb_isim_beh.exe_main.nt64.obj, m_00000000002399256696_0893193378.nt64.obj, m_00000000003623181551_3900012700.nt64.obj, m_00000000004134447467_2073120511.nt64.obj, top_module_pad.csv]
2016-11-15 backup before switching from for->if
    [disparity_tb_isim_beh.exe_main.nt64.obj, m_00000000001368512830_3900012700.nt64.obj, m_00000000003623181551_3900012700.nt64.obj, top_module_pad.csv]
2016-11-17 working separation and SAD
    [disparity_tb_isim_beh.exe_main.nt64.obj, m_00000000001368512830_3900012700.nt64.obj, m_00000000002399256696_0893193378.nt64.obj, m_00000000003933670140_0893193378.nt64.obj, m_00000000003995870423_3900012700.nt64.obj]
2016-11-17 Working SAD vector search
    FINALIZE state is complete with the exception of checking output image
    data
    [m_00000000003995870423_3900012700.nt64.obj]
2016-11-17 Working disparity
    Changed resultant vector data placement, now it works!
    [m_00000000003933670140_0893193378.nt64.obj, m_00000000003995870423_3900012700.nt64.obj]
2016-11-18 re-internalized disparity registers
    [disparity_tb_isim_beh.exe_main.nt64.obj, m_00000000001838647606_0893193378.nt64.obj, m_00000000001872066865_3900012700.nt64.obj, m_00000000003933670140_0893193378.nt64.obj, m_00000000003995870423_3900012700.nt64.obj]
2016-11-22 Updating camera code
    [disparity_isim_beh.exe_main.nt64.obj, m_00000000001838647606_0893193378.nt64.obj, m_00000000001872066865_3900012700.nt64.obj, m_00000000001872066865_4106398011.nt64.obj, m_00000000004134447467_2073120511.nt64.obj]
2016-11-27 Semi-working disparity
    I need to calibrate my cams
2016-11-28 Bitstream for height-corrected version
    [camctl.v, clk_wiz_0.v, clk_wiz_0_clk_wiz.v, clkdivs.v, noip_top.v]
2016-12-06 Fixed issue with output images wrapping to the left
    [blk_mem_640_480_stub.v, blk_mem_640_480_stub.vhdl, blk_mem_resultant_stub.v, blk_mem_resultant_stub.vhdl, clk_wiz_0_sim_netlist.v, clk_wiz_0_sim_netlist.vhdl, clk_wiz_0_stub.v, clk_wiz_0_stub.vhdl]
2016-12-08 more bug fixes.. hopefully it works
    [design_1.v, design_1_blk_mem_gen_2_0.v, design_1_blk_mem_gen_2_0.vhd, design_1_nu_nu_rangefinder_vga_0_0.v, design_1_stub.v, design_1_stub.vhdl, design_1_wrapper.v, mqp_top.v]
2016-12-12 Finished I2C!
2016-12-14 IMU, Rangefinder Updates
2016-12-14 IMU updates
2016-12-14 updated IMU code
2016-12-16 attempting EMIO to IMU
2016-12-17 Working IMU PS implementation
2016-12-19 added calibration for the magnetometer data
2016-12-21 IMU-rangefinder working
2016-12-27 added IMU oscillogram
2016-12-28 Updated Camera Stuff
2017-01-02 report - minor rangefinder updates, set IMU section layout, added .coe files to appendix
2017-01-02 updated camera operation
2017-01-02 (hopefully) finished camera ops section
2017-01-02 wrote some of the IMU sections
2017-01-03 continued working on imu sections
2017-01-03 finalized camera hw section
2017-01-07 finished first draft of Imu testing
2017-01-07 updated component selection and imu testing
2017-01-08 tweaked imu implementation section
2017-01-08 added camera outputs to final imp
2017-01-08 added camera output to report
2017-01-09 edited imu operation, re-changed all PMOD to Pmod
2017-01-09 edits to imu implementation
2017-01-09 edits to imu data processing
2017-01-09 minor edits to camera operation
2017-01-09 edits to imu testing
2017-01-09 edits to camera implementation
2017-01-09 camera testing picture, misc changes
2017-01-11 changed tense of imu testing
2017-01-18 revised camera operation
2017-01-18 proofread camera implementation
2017-01-18 finished edits to rangefidner and imu implelemtaation
