glgauthier/MQP/(notices)

Notices in the files:
final_implemention/final_implemention.srcs/sources_1/bd/design_1/ip/design_1_processing_system7_0_0/hdl/verilog/processing_system7_v5_5_processing_system7.v:
This file contains proprietary and confidential information of
Xilinx, Inc. ("Xilinx"), that is distributed under a license
Copyright 2010 Xilinx, Inc.
All rights reserved.
parts and their libraries:
SparkFun-Aesthetics: Licensing: Creative Commons ShareAlike 4.0 International - https://creativecommons.org/licenses/by-sa/4.0
